2AMLogic/sg13g2-opamp/README.md

# sg13g2-opamp

A two-stage Miller-compensated operational amplifier on IHP SG13G2 on
[IHP SG13G2](https://github.com/IHP-GmbH/IHP-Open-PDK), IHP's open-source 130 nm SiGe BiCMOS PDK — designed by AI agents driving
[klayout-tools](https://github.com/2AMLogic/klayout-tools) and the
open-source xschem + ngspice flow.

**Status: implementation and structural verification in progress.** The
gm/ID sizing basis, schematic, simulation benches, routed layout, DRC, LVS,
and structural power-delivery evidence are committed. The machine-graded
signoff record currently marks 7 of 11 T1 items met; remaining gaps stay
tracked in the signoff manifest and issue backlog.

**Built agent-native.** Every specification, decision record, testbench, and
line of documentation here is produced by AI agents working from a ratified
spec and an append-only evidence trail — not human-authored work that agents
merely assisted with. Verification is the product: every claim traces to a
recorded result under PVT corners. Where the agents hit friction with the
open-source tooling — most often
[klayout-tools](https://github.com/2AMLogic/klayout-tools) — that friction is
filed as a public issue against the tool itself, so the fix benefits everyone
using this PDK, not just this repo.

## Why this block, on this PDK

An operational amplifier is the most conspicuous absence in an analog IP
catalog that already ships bandgaps, LDOs, PLLs, and ADCs — every one of
which embeds amplifiers it never characterizes standalone. This repo, with
its gf180 and sky130 twins opened the same day, closes that gap with the
same block on three foundries: a two-stage Miller OTA specified and
verified the same way everywhere, so the cross-PDK comparison is itself a
result.

On SG13G2 the CMOS devices (not the HBTs) are the design vehicle — this is
deliberately the plain-CMOS twin of the gf180/sky130 repos, so the
three-way comparison stays honest. An HBT-input variant is a stretch row
that only a decision record can open.

## Target specification (RATIFIED — partial, via the two-key mechanism)

See [`spec/target-spec.md`](spec/target-spec.md) for the full ratified
table: DC gain, GBW and phase margin into a stated capacitive load, slew
rate, input-referred noise, offset sigma (basis stated), CMRR, PSRR,
swing, supply/power at 1.2 V. Rows filled only from committed benches,
PVT corners recorded; the measured rows are ratified by
[`spec/decision-records/0002-target-spec-ratification.md`](spec/decision-records/0002-target-spec-ratification.md)
(one bound per row, `[DR-2]` tags), with the residual rows —
`[TBD-12]` area, the offset row's Monte Carlo basis (#17) and the CMRR
row's mismatch term (#26) — explicitly still open. See also [`spec/porting-plan.md`](spec/porting-plan.md) for what
transfers from this PDK's own `sg13g2-bandgap` and `sg13g2-ldo` siblings, and
the [gap-to-T1 tracker](https://github.com/2AMLogic/sg13g2-opamp/issues/3)
for this block's current distance from a sim-validated design.

**Where this block sits on the evidence ladder is graded, not asserted**:
[`signoff/`](signoff/README.md) holds the `klt signoff --manifest` block
manifest and the committed per-item T1 verdict it produces — 7 of 11 items
`met` in the current record, with the remaining 4 `unmet` (item 8's
characterization report is cited but grades four ratified rows FAIL against
their literal bounds — a spec question routed to the keys in
[#101](https://github.com/2AMLogic/sg13g2-opamp/issues/101)). That
record — not this paragraph, and not a hand-maintained checkbox list — is
the verdict of record for the tracker above, and CI re-grades it so a claim
resting on an artifact that has since changed fails instead of rotting.

## Reproducing the results

Every number in the spec table comes from a committed bench under `sim/`;
each bench's README has a "Cold-start invocation" section and each run
appends a record under its `records/` directory. You need an SG13G2 PDK
install (release pinned in [`sim/pdk.json`](sim/pdk.json), fetchable with
klayout-tools' `scripts/fetch-ihp-sg13g2.sh`) and `ngspice` on `PATH`:

```bash
export PDK_ROOT=/path/to/ihp-open-pdk   # parent dir containing ihp-sg13g2/
export PDK=ihp-sg13g2
sim/tools/build-osdi.sh                 # one-time; idempotent
sim/open-loop-ac/run_pvt_sweep.sh       # gain, GBW, phase margin, Iq
```

The other benches are `sim/slew-rate/run_slew_sweep.sh`,
`sim/input-noise/run_noise_sweep.sh`, `sim/input-offset/run_offset_sweep.sh`
and `run_offset_mc.sh`, `sim/cmrr-psrr/run_cmrr_psrr_sweep.sh`,
`sim/cmrr-mismatch/run_cmrr_mismatch_mc.sh`,
`sim/input-cmr/run_cmr_sweep.sh`, `sim/output-swing/run_swing_sweep.sh` and
the sizing study `sim/gm-id-characterization/run_gmid_sweep.sh`; the
bench-to-spec-row map is
[`signoff/evidence/testbenches.txt`](signoff/evidence/testbenches.txt). The
committed netlist is regenerated from the schematic with the command in
[`design/README.md`](design/README.md). The layout, DRC, LVS and ERC steps
are described in [`layout/README.md`](layout/README.md), and the graded
verdict is re-derived with `bash signoff/regenerate.sh`
([`signoff/README.md`](signoff/README.md)).

The per-spec-row characterization report (every row's bound, worst case,
binding point, grid coverage and source record) is regenerated from the
committed records alone — no PDK, no ngspice — with
`python3 signoff/characterization/generate.py` (`--check` verifies the
committed record reproduces); see
[`signoff/characterization/README.md`](signoff/characterization/README.md).
That aggregates existing evidence; it does not re-run the benches above.

## License

Apache-2.0.
