2AMLogic/sg13g2-opamp/signoff/README.md

# T1 signoff — the graded verdict of record

This block's position on the klayout-tools **design-evidence ladder** is not
prose in this file. It is
[`block-manifest.json`](block-manifest.json) — what this block claims, and the
evidence envelope backing each claim — graded mechanically by `klt signoff
--manifest`, with the graded output committed under
[`reports/`](reports/) as append-only evidence.

Read the newest record in `reports/` for the current per-item verdict. Nothing
in this file restates it, on purpose: a hand-maintained checkbox list goes
stale the moment either the evidence or the checklist moves, and both move.
(The checklist itself grew an eleventh item — power delivery (structural) — on
2026-09-17, 2AMLogic/klayout-tools#2025, which invalidated every hand-read T1
claim in the fleet at a stroke. That is exactly the failure mode this
register replaces.)

```bash
bash signoff/regenerate.sh --dry-run      # render the report, write nothing
bash signoff/regenerate.sh                # mint a new record under reports/
python3 signoff/check_signoff.py          # offline: pins + record consistency
python3 signoff/check_inventories.py      # offline: item 1/9/10 inventory entries
python3 signoff/check_signoff.py --run-klt  # + re-grade and diff vs the record
```

`klt signoff --manifest` exits **3** when the block is not yet T1 and **0**
only at full T1 — both mean the report rendered. Exit 1/2 mean no report was
produced. The scripts above encode that distinction; a caller of `klt` that
treats 3 as failure cannot run on a block that is not already finished.

`regenerate.sh` publishes atomically: the JSON pass is written to a hidden
`reports/.staging.*` file (never matching `*.signoff.json`), validated, and
hard-linked into place only if klt exited 0/3 and the document parses. A failed
or malformed run, or a concurrent run with the same record id, never leaves a
partial verdict that `check_signoff.py` would pick as the latest report.
Offline tests: run by CI's signoff test discovery (see "Offline test discovery"); alone: `python3 -m unittest discover -s signoff -p 'test_regenerate.py'`.

- **Checklist** (the item skeleton, parsed at run time):
  `klayout-tools/docs/design-evidence-tiers.md`
- **Grader contract** (manifest shape, reasons, what is and is not graded):
  `klayout-tools/docs/cli/signoff.md`
- **klt revision this repo grades against**: pinned in
  [`klt-pin.txt`](klt-pin.txt) — floating `main` would make the committed
  record disagree with a re-run for reasons unrelated to this block's evidence.

**How `check_signoff.py --run-klt` picks its `klt`.** By default it always runs
the pinned revision via `uvx --from git+https://github.com/2AMLogic/klayout-tools@<pin> klt`,
**even if a global `klt` is on `PATH`** (a different revision would grade a
different checklist). If `uvx` (or the pin) is unavailable it refuses with a
setup message; it never falls back to an unverified global `klt`. The first run
may need network access to populate the uv cache. `KLT_SIGNOFF_CMD` (space
separated command) overrides this for controlled environments; whoever sets it
owns revision correctness. CI sets `KLT_SIGNOFF_CMD=klt` because the preceding
step installs the pinned revision with pip. Selection is covered offline by
`KltCommandTest` in `test_check_signoff.py`.

## Block kind: `analog`

Confirmed against the block, not assumed: this repository is the plain-CMOS
twin of its gf180/sky130 counterparts (per `CLAUDE.md`, CMOS only unless a
decision record opens the HBT stretch — none has), `design/opamp_core.sch`
holds a hand-captured two-stage Miller op-amp schematic, the netlist under
`design/netlist/` is regenerated from that schematic rather than synthesized,
and there is no RTL, no gate-level netlist and no partition boundary to
declare — so this is a single-kind `analog` manifest, graded against the
Analog column of the per-kind items (1, 2, 5, 7 and 11), not a
`mixed-signal` one.

Consequence worth stating: for an analog partition, **item 7 accepts a `klt
pex` report and nothing else**, and item 5 accepts `klt sim` and nothing else.
A clean DRC, or any pre-layout corner sweep — however thorough — renders
`wrong_kind`, not `met`.

## What the manifest cites, and what it deliberately does not

**The manifest cites nine items: 1, 9 and 10 (the inventories below),
5 (the `klt sim` envelopes, with declared gaps; see "Item 5 envelope
coverage" below),
8 (the characterization report, below) and 2 (Layout), 3 (DRC clean),
4 (LVS clean) and 11 (Power delivery, structural).** The layout items are about the same
committed stream, `layout/opamp_core/opamp_core.gds`, and every one of them
pins that stream's own sha256 — because a `drc`, `lvs` or `erc` envelope all
record the sha256 of the layout they ran on in `provenance.input`:

| Item | Envelope cited | Produced by |
|---|---|---|
| 2, 3 | `layout/opamp_core/drc_report.json` | `klt drc --deck sg13g2` |
| 4 | `layout/opamp_core/lvs_report.json` | `layout/opamp_core/run_lvs.sh` |
| 11 | **both** `layout/opamp_core/erc_report.json` *and* the same LVS report | `layout/opamp_core/run_erc.sh` (+ the LVS run above) |

Items 5, 6 and 7 still render `unmet` with reason `no_evidence`, which
remains the honest graded result rather than a placeholder. For item 7 a
45-corner `pex_report.json` now exists but is deliberately **not cited**: its
two legs are not electrically comparable (see "Item 7" below). Item 8 is cited
but renders `unmet` with reason `check_failed`. Its envelope truthfully
carries `status: "fail"`, because the characterization report it wraps grades
three ratified rows FAIL (see below and
[#101](https://github.com/2AMLogic/sg13g2-opamp/issues/101)).

**Why a `drc` envelope is a legitimate citation for item 2, and not
borrowed-green.** Item 2 has no `klt` verb of its own, so the grader scores it
on "some passing envelope was cited at all", never on topical relevance — a
passing envelope for anything would render `met` and the tool would have no
basis to object. That is exactly why the citation has to earn its place by
argument, here:

- The envelope's `provenance.input.content_hash` **is** the committed GDS's
  own sha256. The envelope does not merely pass; it names the artifact item 2
  is about, by content.
- `pinned-inputs.json` maps that pin to `layout/opamp_core/opamp_core.gds`
  and `check_signoff.py` re-hashes the file offline, so the chain "the record
  says `met`" → "because this envelope passed" → "on exactly the stream
  committed in this repo" is closed on both ends and fails CI if either end
  moves.
- The half item 2 asks for that no envelope can carry — "reproducibly
  generated or with documented provenance" — **this block claims the
  documented-provenance alternative, and since #201 the "reproducibly
  generated" half is additionally CI-enforced.** The register's citation
  still rests on the documented-provenance chain — `layout/README.md`'s
  revision table (exact `klt` revision, curated-deck hash and PDK release
  the committed bytes were produced with) and its "Determinism" section —
  but the regeneration itself is no longer only a human-verified property:
  `.github/workflows/signoff.yml`'s `layout-regen` job provisions the
  pinned PDK (shared `setup-sg13g2-pdk` composite action with the
  netlist-regen job) and runs `python3 layout/opamp_core/generate.py
  --check` on every push and PR, installing `klt` at
  `layout/klt-pin.txt`'s tag commit in its own environment — deliberately
  not this register's grading pin, `signoff/klt-pin.txt`, which governs how
  the checklist is parsed, not how the evidence is produced — plus
  `klayout==0.30.10` under the job interpreter, the same two-environment
  split the committed bytes were made with. A byte drift, a DRC-report
  drift, a missing `klt` or a failed PDK fetch all fail the job; nothing is
  downgraded to a pass. The offline re-hash above and the regeneration gate
  are complementary: the first closes "someone hand-edited the stream", the
  second closes "the generator stopped reproducing it".
- The one assumption identified as most likely to break silently — that
  `klt gen mos_array`'s common-centroid unit ordering is what makes the
  block's `B A A B` interdigitation actually common-centroid, via
  `assert_common_centroid()` inside `generate.py` itself — is asserted at
  every regeneration and every `--check` run, so a `klt` behaviour change
  that broke it now fails the CI regeneration gate directly rather than
  only surfacing as an unexplained byte diff.
- The earlier deferral — "standing up a second CI job that installs `klt`
  **and** the pinned PDK was considered and deferred as materially higher
  cost", recorded in
  [#50](https://github.com/2AMLogic/sg13g2-opamp/issues/50) — was reversed
  by [#201](https://github.com/2AMLogic/sg13g2-opamp/issues/201): #190 had
  already added the pinned-PDK provisioning for the netlist-regen job, and
  factoring that fetch into the shared composite action removed the
  duplication cost.

**Item 3's coverage disclosure is in `layout/README.md`**, quoted verbatim
from the cited report's own `coverage` block: `deck_scope` (16 rule
families), `layers_in_stream_without_rules` (`31/0`, `36/0`, `63/0`, `129/0`,
`189/0` — the n-well and the MIM plate among them) and `rules_skipped` (6 of
43, all `no_applicable_geometry`). `klt signoff` reports those three fields
but does not grade them, so a `met` verdict on item 3 is **not** evidence the
gaps were disclosed; read the disclosure, not the verdict. And the deck
itself is klayout-tools' own curated 43-rule starter deck, **not IHP's
foundry signoff deck** — see `layout/README.md` → "Curated deck vs. IHP's
foundry deck".

**Items 1, 9 and 10 are cited through artifact-anchored `generic` envelopes**
(klayout-tools#2718, available from the pinned revision on). These items have
no `klt` verb, so the old advice was to leave them visibly `unmet` rather than
borrow a passing DRC report. The grader now accepts a `generic` envelope that
declares `"t1_item": <id>`, names the audited file in `provenance.input.path`,
records its `content_hash`, and is pinned by the manifest at the same hash;
`klt signoff` re-hashes that file, so an edit after the attestation renders the
row `unmet` / `stale_evidence`. The three audited files are plain-text
inventories under [`evidence/`](evidence/):

| Item | Envelope | Inventory it is bound to | What the inventory attests |
|---|---|---|---|
| 1 Design sources | [`design-sources.json`](evidence/design-sources.json) | [`design-sources.txt`](evidence/design-sources.txt) | the schematic, symbol, committed netlist and the `xschem` command that regenerates the netlist; the netlist was regenerated from the schematic against PDK v0.3.0 and matched the committed one byte for byte except the `** sch_path:` header comment |
| 9 Testbenches shipped | [`testbenches.json`](evidence/testbenches.json) | [`testbenches.txt`](evidence/testbenches.txt) | one line per ratified measurement row of `spec/target-spec.md` section 2: its `sim/` bench, cold-start command, committed record and the pinned PDK revision (`sim/pdk.json`) |
| 10 Repo hygiene | [`hygiene.json`](evidence/hygiene.json) | [`hygiene.txt`](evidence/hygiene.txt) | the README sections (what the block is, the spec table, how to reproduce), `LICENSE` and the CI workflow `.github/workflows/signoff.yml` |

**What that does and does not mean.** `status: "pass"` in each envelope is the
author's assertion, bound to bytes. It is not a re-audit by the tool: `klt
signoff` verifies that the inventory still has the hash the envelope named, not
that its contents are true. The audit behind the assertion is stated in each
inventory's header. In particular the item 9 audit was *static* (scripts,
templates, READMEs, committed records and the PDK/OSDI preflight were checked;
the PVT and Monte Carlo grids were not re-executed for the attestation), and
`Area` (`[TBD-12]`) is not a ratified row, claims no measurement and has no
bench. Refresh an envelope (and its manifest pin) whenever the inventory it
names changes; `check_signoff.py` fails offline if the pin and the file
disagree, and `--run-klt` fails with `stale_evidence` if only the inventory
moved.

**What CI re-checks in those inventories, and what stays a dated audit.**
A hash binds the inventory *text*; it does not notice a cited record being
deleted or a runner losing its executable bit while the text stands still.
[`check_inventories.py`](check_inventories.py) (offline, stdlib-only, run in
the offline half of the `signoff` job) reads the three inventories through a
documented parseable subset of their existing format — `key: value` lines in
`design-sources.txt` / `hygiene.txt`, `row | bench | command | record` lines
in `testbenches.txt`; the grammar is in the script's docstring — and on every
push and PR verifies:

| Continuously checked (CI) | Inventory |
|---|---|
| schematic, symbol, committed netlist, `xschemrc` and sizing basis exist; `netlist-origin` names the listed schematic; the `regenerate` command's `cd`/`--rcfile`/`-o`/schematic arguments resolve to the listed `xschemrc`, netlist directory and schematic, and the netlist file name is the schematic stem + `.spice`; `design/README.md` has the "Running xschem / regenerating the netlist" heading; `sim/pdk.json` exists | `design-sources.txt` |
| per row: bench dir exists; the cold-start runner lives in it, exists, has the executable mode, and parses with `bash -n`; every `${EXPERIMENT_DIR}/testbench/…` template it references exists; the bench README has a "Cold-start invocation" section that names the runner; the cited record exists under `<bench>/records/`, is non-empty and has its `.md` companion. Shared harness files exist (`.sh` ones parse); `sim/tools/build-osdi.sh` is executable; the stated PDK pin agrees with `sim/pdk.json`'s `source`/`release_tag` | `testbenches.txt` |
| `README.md` has the "Why this block, on this PDK", "Target specification", "Reproducing the results" and "License" headings; `spec/target-spec.md` has a section 2 heading; every bench README has "Cold-start invocation"; `design/README.md`, `signoff/README.md`, `LICENSE` (with its Apache License 2.0 header) and the workflow exist; the workflow triggers on push and pull_request and runs `check_signoff.py`, `check_signoff.py --run-klt` and this validator | `hygiene.txt` |
| in a git checkout: every path above is tracked, and every runner's *committed* mode is `100755` | all three |

Negative controls ([`test_check_inventories.py`](test_check_inventories.py),
also in the offline half) build a throwaway fixture tree from what the
inventories name — never touching the real checkout — and assert the exact
diagnostic for a deleted cited record, a runner without its executable bit
(working tree and committed mode), invalid shell syntax, a missing design
source, a missing hygiene artifact, a missing heading, template, shared
harness file or workflow step, and a PDK pin that disagrees.

**Still dated manual audits (2026-10-08), not machine-checked:** that the
committed netlist is what `xschem` generates from the schematic (the
regeneration diff needs xschem and the PDK; a path existing says nothing about
equivalence); byte freshness of any source, record or README (only
existence, headings and the cited command are checked — record *contents*
for item 8 are pinned separately by `characterization/selection.json`); that
any PVT/MC grid ran as recorded or would reproduce today; that the PDK v0.3.0
install and OSDI build resolve (`build-osdi.sh --check` needs the PDK); and
that README prose is accurate beyond carrying the named headings. Limits of
the parse itself: a template whose path is built some other way than
`${EXPERIMENT_DIR}/testbench/<name>` is not seen, and a `${var}` inside a
template name is matched as a glob (at least one file must match). Changing an
inventory's wording outside the documented subset fails this check rather
than being skipped; changing it at all still needs the envelope, the
`pinned-inputs.json`/manifest pin and a new signoff record refreshed together.

Item 2 is still cited through the native `drc` envelope, which the grader
accepts without being able to judge its relevance (`topic: not bound` in the
report); binding it with a `generic` envelope over the GDS is a possible
follow-up and is not done here.

**Item 7 (post-layout verification) is NOT cited. A 45-corner pex report
exists, but its two legs simulate different device geometry, so its deltas
are not a parasitic measurement.** Issue
[#86](https://github.com/2AMLogic/sg13g2-opamp/issues/86); reconciliation is
tracked in [#237](https://github.com/2AMLogic/sg13g2-opamp/issues/237).

*What was run.* `bash layout/opamp_core/run_pex.sh` ran `klt pex --deck sg13g2`
over the committed GDS, with `--measure-command
sim/post-layout/measure_openloop_ac.sh` on both legs (`measurement.mode:
"command"`) and reference `design/netlist/opamp_core.spice`. It wrote
`layout/opamp_core/pex_report.json` and `layout/opamp_core/opamp_core_pex.spice`.
Both are kept as committed evidence, but they are not in `block-manifest.json`
or `pinned-inputs.json`. The 45-point PVT grid (5 MOS corners x -40/27/125 C x
1.08/1.20/1.32 V, CL = 2 pF) was expressed as `klt sim` AC + OP requests that
declare `backend: "batch"`. No local ngspice loop was run. The report itself
does not record where the simulations ran: there is no `environment.remote` and
no batch job id in `pex_report.json`, and the per-corner `klt sim` envelopes
were written to a scratch directory that was not kept. So the only evidence
for the batch fleet is the request declaration. The report has 180 `delta[]`
rows (45 corners x 4 rows), `status: "pass"` on every row, `corner_count: 45`
and `errored: 0`.

*Why the passes are not cited.* The four AC/OP rows pass the ratified bounds
on the extracted leg
(`python3 sim/post-layout/check_bounds.py layout/opamp_core/pex_report.json`,
exit 0). The worst extracted values are gain 42.19 dB (bound 37.8), GBW
5.956 MHz (bound 4.74), PM 75.19 deg (bound 60) and Iq 84.84 uA (bound 119.7).
The deltas against the schematic leg are large and favourable: `delta_pct`
spans -3.6..+18.7 % (gain), +8.6..+27.8 % (GBW), -1.9..-0.8 % (PM) and
-31.7..-19.8 % (Iq). The two legs differ in how the devices are represented,
so these deltas cannot be attributed to parasitics:

- **The active device widths match the schematic exactly.** The extracted
  netlist has 19 NMOS / 18 PMOS against the schematic's 5 / 3
  (`model_mismatch.counts`). This is the intended drawn layout: each matched
  pair is an interdigitated array of half-width units plus two dummy columns,
  and each wide device is folded (`generate.PAIRS` / `generate.FOLDED`). LVS
  matches 38/38 against the per-finger reference that `lvs_reference.py`
  derives. Summing every extracted W gives an apparent 1.5x input pair, a 1.5x
  mirror load and an extra 2.2 um NMOS. All of that excess is **dummy**
  devices (gate, drain, source and body tied to the same rail), which carry no
  current. Per active device: M1/M2 = 2 x 1.6 um (schematic 3.2 um), M3/M4 =
  2 x 0.52 um (1.04 um), M5/Mbias = 2 x 1.1 um (2.2 um), M7 = 7 x 1.7 um
  (11.9 um), M6 = 12 x 2.75 um (33 um).
- **The per-device geometry does not match.** The schematic leg simulates one
  lumped `ng=1` device of full width per transistor (e.g. a single 11.9 um M7).
  The extracted leg simulates the drawn narrow instances, each with its own
  AS/AD/PS/PD. In the PSP model these are different devices: narrow-width
  effects and diffusion geometry differ, and the bias-mirror ratios are now set
  by fingers of *different* unit widths (Mbias 2 x 1.1 um vs M7 7 x 1.7 um).
  This was the leading explanation for the DC deltas, and the #237 probe has
  now quantified it (`sim/fingering-probe/`, five MOS corners at
  27 C / 1.20 V on the batch fleet). Lumped -> drawn fingering carries the
  whole Iq delta (-24.9..-26.7 %) and +7.6..+9.0 % gain. The dummies and the
  extracted diffusion geometry move nothing (under 0.4 %).
- **The remaining AC deltas are a bench artifact, not parasitics.** The
  open-loop AC bench leaves `inn` AC-floating (`Lbreak` with no C to ground),
  so any capacitance on `inn` changes Av0/GBW. With `inn` AC-grounded, the
  parasitics move GBW -0.4 %, PM -0.8 % and Av0 0.00 %. The same diagnostic
  shows the bench roughly halves GBW and overstates PM by 12-14 deg. That
  defect is tracked in [#241](https://github.com/2AMLogic/sg13g2-opamp/issues/241).
  [Decision record 0008](../spec/decision-records/0008-drawn-fingering-device-representation.md)
  chooses to put the drawn fingering into the schematic, and orders the
  remaining work: fix the bench, change the netlist together with the
  pre-layout re-runs, then re-run pex.

So the absolute pass describes a circuit whose devices are represented
differently from the circuit sized and characterized pre-layout (items 5 and
8). Its margin cannot be read as parasitic robustness, and part of it may be
the representation change. For the same reason, the schematic leg's worst
corner (37.78 dB, 0.02 dB under the gain bound) and the extracted leg clearing
the bound are not a before/after comparison. Item 7 stays `unmet /
no_evidence` until #237 makes the legs comparable (DR 0008), #241 fixes the
bench loop break, and the run is repeated.

*Report fields, stated as the envelope carries them (informational; uncited).*
`body_bias.status: "biased"` (0 unbiased devices, no unbiased nets, no unbiased
PMOS bodies). `extraction.model` is a **quasi-static lumped RC** model: one
frequency-independent R and C per net, resistance a single lumped series
resistance per net distributed as a star across the net's device terminals
(not a per-segment RC ladder; `--distributed-rc` / `--critical-net` were not
used), capacitance net-to-ground from each net's own area/perimeter plus
net-to-net for vertical-overlap (crossover) coupling. Lateral same-layer
coupling is modelled only for declared `--critical-net` nets, and none were
declared, so **no lateral coupling is in this result**; fringe shielding,
skin effect and distributed transmission-line behaviour are not modelled.
The extraction deck is `sg13g2` with `deck.released: false` (the curated
starter deck, not the foundry deck). The source/drain implant layers are not
drawn by `klt gen mos_array` (klayout-tools#2580, see `layout/README.md`);
whether that changes the extracted device list or junction capacitance was
not investigated here (LVS matches 38 of 38 devices). Neither the starter-deck
nor the implant caveat has been quantified.

*Rows covered vs not covered post-layout.* Measured by the uncited run: DC gain, GBW, phase margin
and quiescent current (the four AC/OP rows above) at the 45-point grid. **Not
covered post-layout:** slew rate, input-referred noise, offset (including its
statistical basis), CMRR, PSRR and output swing. A future item 7 `met` says nothing
about those rows either. Tracker:
[#3](https://github.com/2AMLogic/sg13g2-opamp/issues/3).

**Item 11 is the one compound citation, and what it does and does not
prove.** T1 item 11 (power delivery, structural — klayout-tools#2025) is the
first item no single artifact proves, so its manifest entry is a *list*: the
`klt erc` supply run plus the LVS report item 4 already cites. The supply
spec that run grades against is
[`layout/opamp_core/erc_supply_spec.json`](../layout/opamp_core/erc_supply_spec.json),
which carries an inline justification for every `stackup` entry, every
`label_layer` and both `ties[]` entries; the run is
[`layout/opamp_core/run_erc.sh`](../layout/opamp_core/run_erc.sh). What the
graded verdict rests on, stated here rather than left in the envelope:

- **Two supplies, `vdd` and `vss`** — this block's entire supply set — each
  declared `"kind": "supply"` with `islands: 1`, each resolving to exactly
  one labelled island, with zero `erc.unconnected_net`, zero
  `erc.supply_short` and zero `erc.missing_tie` (`erc_status: "clean"`,
  `erc_finding_count: 0`).
- **Both supplies are paired to a reference-side net** in the cited LVS
  report's `net_correspondence` (`vdd` → `VDD`, `vss` → `VSS`, both
  `pin: true`), which is the analog branch of the item — the block cites no
  `place-and-route` response, so `power_connectivity: "unchecked"` is the
  right and sufficient state here, exactly as it is for item 4.
- **Ties are declared, not disclosed away.** klayout-tools#2169 — where a
  declared `ties[]` entry collapsed a routed design into one island and
  reported a *false* `erc.supply_short` — is fixed in the `klt` that produced
  the committed report (`provenance.klt_version`), so the honest move is to
  declare the ties and let them be computed, not to file a
  `ties_disclosure` that item 11 would (correctly) render `unmet`. Both ties
  are graded as `checked` work, neither is `skipped`.
- **The n-well tie is derived from drawn geometry; the substrate tie is a
  caller assertion.** SG13G2 draws no p-substrate layer, so `psub_tie_vss`
  uses `well_layer: null` + `well_boxes` (klayout-tools#2255) naming the
  three NMOS guard-ring extents one at a time. The report says so itself in
  `erc_coverage.checked_by_well_assertion`. That is weaker provenance than
  the drawn `NWell` the `vdd` tie uses, and it is stated rather than buried.
- **What a clean `erc.unconnected_net` here is *not* evidence of.** The rule
  counts islands *carrying the declared label* (klayout-tools#2497), and this
  stream draws exactly one label per port — so it cannot, even in principle,
  report a severed-but-unlabelled rail fragment. `nets[].matched_islands: 1`
  in the report is that bound made visible. The independent evidence that no
  fragment is orphaned is the cited LVS compare (9/9 nets, 38/38 devices,
  `status: "match"`) and the generator's own connectivity self-check — not
  this rule.
- **The antenna half of the same envelope checked nothing.** `klt` ships an
  antenna-ratio limit table for sky130 only, so every one of the 49
  gate×level antenna work items is in `coverage.skipped` with reason
  `missing_antenna_pdk` and the envelope's own `status` is `not_checked`.
  Item 11 deliberately does not grade that field (it grades the supply rules
  directly), and antenna is tracked separately as klayout-tools#1994 — but a
  reader should not mistake the `met` row for an antenna verdict.

The layout generator also runs a connectivity **self-check** — it re-extracts
the drawn metal and asserts the nine nets are wired as
`design/netlist/opamp_core.spice` says, with no open, no short and nothing
floating — but that is not LVS (no device recognition, extraction stops at
Metal1) and is deliberately **not** cited as item 4 or item 11.

**Item 5 is cited as a multi-row list of committed `klt sim` envelopes with
declared gaps (issue #266, klayout-tools#2959); item 6 is still uncited.**
Item 5 renders `unmet` / `check_failed`, not `no_evidence`: see "Item 5
envelope coverage, per ratified row" below. Item 6 accepts only a `klt
yield` envelope and this repo's Monte Carlo records are harness-native
artifacts, so until an envelope-producing bench lands or a wrapper is
introduced upstream, it correctly renders `no_evidence`.

Item 6: the Monte Carlo campaigns now exist (offset random half, issue #17,
`sim/input-offset/records/mc-20260921-174056-0a509fb*`; mismatch-inclusive
CMRR, issue #26, `sim/cmrr-mismatch/records/20260921-172304-65f5fb4.csv`),
but no `klt yield` report is cited, for three recorded reasons: the spec
ratifies no per-draw limit or `target_yield` for either row (#108), the CMRR
record holds per-point summaries only, not per-draw samples (#107), and the
offset draws need a reshape into a sample-set document
([`yield-inputs/`](yield-inputs/README.md)). Item 6 stays `unmet`
until those close.

**Item 8 is cited through a `generic` envelope over a generated
characterization report** — [`characterization/`](characterization/README.md).
`characterization/generate.py` reads an explicit, hash-pinned record selection
(`characterization/selection.json`: the same records
[`evidence/testbenches.txt`](evidence/testbenches.txt) maps, checked against
it) and renders, for every claimed spec row, units, load and conditions, the
ratified bound and its decision record, the measured worst case and binding
point, the source record and its sha256, expected-versus-observed grid
coverage and a verdict. Minted records under `characterization/reports/` are
append-only; [`evidence/characterization.json`](evidence/characterization.json)
(`"kind": "generic"`, `"t1_item": 8`) binds the newest JSON record by repo path
and hash, and the manifest and `pinned-inputs.json` pin that same hash.
Regenerating it needs no ngspice, no PDK and no network:

```bash
python3 signoff/characterization/generate.py          # render; writes nothing
python3 signoff/characterization/generate.py --check  # cited record reproduces
```

That re-reads committed evidence; it is **not** a re-run of the simulations
(each bench README's "Cold-start invocation" is). What the item 8 row does and
does not mean:

- The generator writes the envelope's `status`. It writes `"pass"` only when
  the report's overall verdict is `PASS`: every ratified bound met, full valid
  grid coverage on every selected record, no input in error. Otherwise it
  writes `"fail"`, and klt then grades item 8 `unmet` (`check_failed`).
  `check_signoff.py` re-derives the cited record from its selected evidence
  (`generate.py --check`). A record that moved, or an envelope that no longer
  matches the newest report and its verdict, fails offline.
- **Bounds are compared literally, and the current report is FAIL.** Every raw
  grid value must meet the ratified bound as written. No rounding or
  precision convention is applied, because no ratification record defines
  one. Four rows miss the literal bound: DC gain, integrated noise,
  systematic offset and swing span, by 0.0188 dB, 0.049 µVrms, 0.027 mV and
  0.042 mV respectively. Their raw worst cases come from the very records
  DR-0002 cites, and only round onto the bounds it wrote. Whether to restate
  those bounds or ratify a comparison convention is a spec decision for the
  keys ([#101](https://github.com/2AMLogic/sg13g2-opamp/issues/101)), not
  something this tooling settles. Until then item 8 stays `unmet`.
- The first minted record, `characterization/reports/20261009-005750-622fb9c`,
  and the verdict of record graded from it, `reports/20261009-005834-69b7b63`
  (8/11, item 8 `met`), used a rounding rule that has since been withdrawn.
  Both are kept unedited as append-only history, but they are superseded and
  must not be read as the current verdict.
- Unratified measured quantities (offset mismatch 3σ `[P]`, ICMR) are
  reported in their own section with no pass/fail, the superseded systematic
  CMRR floor is context only, and Area stays `PENDING`. The offset Monte
  Carlo campaign's fixed 1.20 V supply is carried with its numbers.
- **It is item 8 evidence only.** It is an offline aggregation of
  harness-native records, not a `klt sim` / `klt yield` envelope, and is not
  cited for item 5 or 6 — `check_signoff.py` fails if the manifest cites it
  under any other item. Every number in it is pre-layout.

### Item 5 envelope coverage, per ratified row

Item 5 asks for "every spec row at its bound corners". The manifest cites
the committed envelopes as a list, each naming the rows it covers, against
`spec_rows."5"`, the ratified rows of `signoff/characterization/selection.json`
(`class: ratified`). Rows no envelope measures are declared `gap`, which keeps
the item `unmet` / `partial_coverage` and is never read as covered. Today the
item renders `unmet` / `check_failed`: two cited envelopes are recorded bound
misses (`failed_rows` = `input_noise`, `offset_systematic`; not relaxed), and
`detail.declared_gaps` lists exactly five rows: `psrr` (#99), `swing_headroom_vdd`,
`swing_headroom_vss`, `swing_span` (#100) and `cmrr_mismatch` (statistical
reduction, item-6 form #105). The `cmrr-psrr` supply-gain envelope measures
`avs0_db` only, covers no row and is not cited. When #99 or #100 land they
only replace a `gap` with a citation. Not declared: `cmrr_systematic`
(superseded by DR-4), `offset_mc_3sigma`, `offset_mc_total`, `icmr_*`
(measured, unratified) and `area` (pending). Per row, today:

| Ratified row | Bench | `klt sim` request | Envelope committed | Tracker |
|---|---|---|---|---|
| Open-loop DC gain ≥ 37.8 dB | `sim/open-loop-ac/` | yes, `sim/open-loop-ac/klt/` (AC request; `inn` AC-grounded, issue #241) | **yes**: real 45-corner envelope committed (`sim/open-loop-ac/klt/records/20261016-161057-8caa272.ac.sim.json`, fleet job `klt-sim-61cc8b42b2da`: 45 unique points, status pass; binding corner `mos_fs`/125 °C/1.08 V, 38.229 dB vs ≥ 37.8) | [#85](https://github.com/2AMLogic/sg13g2-opamp/issues/85) |
| GBW ≥ 4.74 MHz | `sim/open-loop-ac/` | yes (same AC request) | **yes**: same envelope; binding corner `mos_ss`/−40 °C/1.08 V, 8.062 MHz | #85 |
| Phase margin ≥ 60° | `sim/open-loop-ac/` | yes (same AC request; graded as the phase at the 0 dB crossing) | **yes**: same envelope; binding corner `mos_ff`/125 °C/1.32 V, PM 61.99° | #85 |
| Quiescent current ≤ 119.7 µA | `sim/open-loop-ac/` | yes (companion OP request) | **yes**: `sim/open-loop-ac/klt/records/20261016-161057-8caa272.op.sim.json` (fleet job `klt-sim-eb4fefe4b5a5`: 45 unique points, status pass); binding corner `mos_ss`/−40 °C/1.32 V, 119.655 µA | #85 |
| Slew rate ≥ 7.51 V/µs (worse of the two edges) | `sim/slew-rate/` | yes, `sim/slew-rate/klt/` (one measurement per edge, each carrying the bound) | **yes**: real 45-corner envelope committed (`sim/slew-rate/klt/records/20261015-063443-80878d7.sim.json`: 45 unique points, status pass; binding corner `mos_ss`/−40 °C/1.08 V, rising 7.5378, falling 7.5144 V/µs vs ≥ 7.51); agrees with the harness record at all 45 points | [#95](https://github.com/2AMLogic/sg13g2-opamp/issues/95) |
| Input-referred noise ≤ 108.9 µVrms | `sim/input-noise/` | yes, `sim/input-noise/klt/` | **yes**: `sim/input-noise/klt/records/20261015-061719-80878d7.sim.json` (45 corners, fleet job `klt-sim-97d94b85943b`; verdict **fail**: `mos_fs`/125 °C/1.08 V = 108.949 µVrms, same as the harness; compared to the harness record, 0 of 270 comparisons out of tolerance) | [#96](https://github.com/2AMLogic/sg13g2-opamp/issues/96) |
| Offset (systematic) ≤ +21.9 mV | `sim/input-offset/` | yes, `sim/input-offset/klt/` (the harness's primary open-loop null-sweep method; `vos_null_v` carries the bound as a two-sided limit ±0.0219 V) | **yes**: `sim/input-offset/klt/records/20261015-081722-8e276bc.sim.json` (45 unique points, fleet job `klt-sim-38b6e4833c62`; verdict **fail**: one point misses, `mos_fs`/125 °C/1.08 V = +21.927 mV vs ≤ 21.9 mV, margin −0.027 mV, the same point and value as the harness; the other 44 pass); agrees with the harness record at all 45 points (largest offset delta 0.58 nV) | [#97](https://github.com/2AMLogic/sg13g2-opamp/issues/97) |
| CMRR ≥ 26.68 dB (mismatch-inclusive [DR-4]) | `sim/cmrr-mismatch/` | no | no | [#98](https://github.com/2AMLogic/sg13g2-opamp/issues/98) |
| PSRR ≥ 1.87 dB (DC shelf) | `sim/cmrr-psrr/` | yes, `sim/cmrr-psrr/klt/` (supply-gain request, shard bridge, runner and comparator; `inn` AC-grounded, issue #241). PSRR+ = Av0 − Avs0 is a two-envelope join on (process, temperature, VDD): Avs0 from the supply-gain envelope, Av0 from the open-loop `klt sim` AC envelope; the ratified bound is applied offline because one AC solve cannot carry both excitations, so the PSRR verdict is the comparator's, not a `klt sim` verdict | **yes**: grounded-`inn` supply-gain envelope `sim/cmrr-psrr/klt/records/20261015-103521-0f41068.sim.json` (45 unique points, fleet job `klt-sim-ebfce5fa6940`) joined to `sim/open-loop-ac/klt/records/20261016-161057-8caa272.ac.sim.json` (`av0_db`); join record `klt/records/20261016-171154-ff5ee9a.compare.json`. PSRR+ worst 26.90 dB at `mos_fs`/125 °C/1.08 V, 0 of 45 failing the bound. The envelope-joined PSRR differs from the open-loop-CSV-joined PSRR by at most 4.95e-5 dB (tolerance 0.02 dB, 45 of 45 within). It supersedes the floating-`inn` record `20261010-094256-469573d` (worst 1.8709 dB) | [#99](https://github.com/2AMLogic/sg13g2-opamp/issues/99) |
| Output swing (headroom ≥ 251/141 mV, span ≥ 0.571 V) | `sim/output-swing/` | partial, `sim/output-swing/klt/` (one-point `mos_tt`/27 °C/1.20 V prototype request, runner and comparator delivered; all three ratified numbers are native `klt sim` measurements with the literal bounds; the 45-point grid request is not yet written) | **no**: one-point prototype only (`klt/records/*.nominal.sim.json`), not evidence; 45-point run deferred | [#100](https://github.com/2AMLogic/sg13g2-opamp/issues/100) |

Eight of ten rows have a complete `klt sim` request (the seven cited rows plus PSRR, whose join is not yet cited), and one more (output swing) has a partial one (a one-point prototype request, no grid request yet): request coverage is not delivered evidence. **The open-loop AC bench (four rows: DC gain, GBW, phase margin, Iq), slew-rate (job `klt-sim-9649fa050398`), input-noise and input-offset (systematic) rows have complete committed envelopes; PSRR is covered by a two-envelope join (below); CMRR and output swing are not covered. Seven rows are cited in item 5 (two of them with recorded bound misses); PSRR, swing and CMRR are declared gaps.** The open-loop request was first submitted to the batch fleet on 2026-10-09 and rejected before simulating, because the fleet runner's klt (0.5.0) was older than the client (`batch_runner_version_mismatch`, exit 87; 2AMLogic/2am#2193, since closed with the runner pinned to 0.7.0). It was re-run on 2026-10-16 (client 0.7.1.dev, runner 0.7.0, ngspice-46 on the fleet) through `sim/open-loop-ac/klt/run.sh`: all four rows pass at all 45 corners, on the grounded-`inn` bench, and the envelopes are compared with the grounded-`inn` record `sim/open-loop-ac/records/20261015-103057-895d555.csv` (the floating-`inn` record `20260910-221601-22feaba` is superseded: its Av0 worst case of 37.7812 dB, a miss, was a property of that bench's floating `inn`, not of the amplifier; the shift to 38.2293 dB is attributed in `sim/open-loop-ac/README.md`). The slew-rate request was rejected the same way on 2026-10-09 (job `klt-sim-994a710c60f3`), then ran on 2026-10-15 once the runner matched; `sim/slew-rate/README.md` → "The `klt sim` path" has the history, including the fleet thread-oversubscription timeout and its `set num_threads=1` workaround (2AMLogic/klayout-tools#2970). The PSRR request (`sim/cmrr-psrr/klt/`, #99) measures the supply gain only, so the row is a two-envelope join, not a single `klt sim` ratio: the same-point Av0 comes from the committed open-loop `klt sim` AC envelope (`av0_db`), and the ratified bound is applied offline by `compare.py`. The grounded-`inn` supply-gain envelope `20261015-103521-0f41068` (worst 26.90 dB, 0 of 45 failing) supersedes the floating-`inn` `20261010-094256-469573d`; the join check against the open-loop CSV passes (`20261016-171154-ff5ee9a.compare.json`). Unlike the two above, the original (floating-`inn`) run did run on the fleet: the one-request form cannot run on the klt 0.5.0 runner, so the 45-point grid ran as five per-process shard jobs (`sim/cmrr-psrr/klt/shard.py`, client klt 0.6.0) and the merged envelope (45 unique points, 44 pass, one plateau-guard limit miss kept) is committed with its comparison against the harness record (`sim/cmrr-psrr/README.md` → "Measured comparison"). The input-noise request ran on the fleet in one 45-point job (client and runner klt 0.7.0) and its envelope is committed with its harness comparison (`sim/input-noise/README.md` → "Comparison tolerance (measured)"); the verdict is a recorded bound miss at one corner, not a pass, and the earlier one-corner local prototype never counted toward coverage. The input-offset (systematic) request also ran on the fleet in one 45-point job (client and runner klt 0.7.0) and its envelope is committed with its harness comparison (`sim/input-offset/README.md` → "The `klt sim` path"); its verdict is likewise a recorded bound miss at one corner (+21.927 mV against the ratified +21.9 mV), not relaxed. That run was submitted with `klt sim` directly, not through `run.sh`, because this dispatch host's preflight cannot pass (ngspice-42, no OSDI build), so that record has no `.env.json` sidecar. These envelopes are cited by the manifest as item 5 (pin `3a75c3a` → `44cc423`, which carries klayout-tools#2959).

## Disclosures that travel with the current claim

- **Item 3's DRC coverage gaps are disclosed in `layout/README.md`** →
  "What the DRC verdict is worth", quoted verbatim from the cited report's
  own `coverage` block. This was the honesty note this register was opened
  with ("when item 3 first goes `met`, its coverage gaps must be stated in
  the claim — a `met` verdict alone is not evidence that coverage was
  disclosed"), and it is now discharged.
- **Item 2's provenance is disclosed in the same file** → "Determinism":
  which `klt` revision produced the bytes, what would legitimately change
  them, and the fact that changing them fails this register's own offline
  check until the pins are refreshed.
- **The source/drain implants are not drawn.** `klt gen mos_array` emits no
  `nSD`/`pSD` on this family, the curated deck has no implant rule, and
  neither the DRC verdict nor the signoff record can see it. Stated in
  `layout/README.md` and filed upstream as
  [`2AMLogic/klayout-tools#2580`](https://github.com/2AMLogic/klayout-tools/issues/2580).
  Nothing in this register should be read as a claim that the committed
  stream is a manufacturable mask set.
- **Item 11's three caveats are in "What the manifest cites" above** — the
  asserted (rather than drawn) substrate region behind the `vss` tie, the
  single-label bound on `erc.unconnected_net`, and the fact that the same
  envelope's antenna half checked nothing on this PDK. This discharges the
  honesty note the item was opened with: a `met` power-delivery row is a
  statement about the declared supplies' continuity in *metal*, not a
  statement that every rail fragment was found or that antenna was graded.

One honesty note still pending, from the issue that introduced this register:

- When item 7 first goes `met`, its `body_bias` statement must be read and
  restated: an unexamined `body_bias` field is no statement that "every
  device body was biased"; here, today, the question has not been asked with
  the tool that answers it.
  When the report lands, also restate its `extraction.model` (a lumped
  quasi-static R/C per net: no skin effect or distributed lines, lateral
  coupling only for `--critical-net` nets), say whether the undrawn
  source/drain implants (klayout-tools#2580) affect extraction, and list the
  ratified rows covered post-layout (the four AC rows: DC gain, GBW, phase
  margin, quiescent current) against those not (slew rate, noise, offset,
  CMRR, PSRR, output swing). The DRC deck is the curated starter deck, not
  the foundry deck.

## How this is kept from rotting

`klt signoff` compares a manifest pin against the *cited envelope's own*
recorded input hash. It never opens the repo artifact that hash is supposed
to be the hash **of** — so a pin can go stale in a way the grader structurally
cannot see. [`pinned-inputs.json`](pinned-inputs.json) names the artifact
behind every pin and [`check_signoff.py`](check_signoff.py) re-hashes it,
which closes that gap. Every layout pin — including both parts of item 11's
compound citation, whose `pinned-inputs.json` entry is a list with one
artifact per part — resolves to `layout/opamp_core/opamp_core.gds`, so
regenerating the layout without also refreshing the DRC, LVS and ERC reports,
every pin and the graded record fails the offline half of CI — by design.
Item 8's pin resolves to the minted characterization record, and the same
offline half re-derives that record from the `sim/` evidence it selects. The
checker also enforces the converse: it gathers a row for every new pin, and
rejects a `pinned-inputs.json` entry for an item the manifest does not cite.

The ERC *supply spec* is a second document the `klt erc` envelope merely
names (`spec`) and hashes into `provenance.spec.content_hash`. The checker
resolves the item-11 part of kind `erc`, requires a repo-contained readable
spec and a well-formed recorded hash, and re-hashes the spec; a missing or
malformed hash, an escaping path or a changed `erc_supply_spec.json` fails the
offline build with a pointer to re-run `layout/opamp_core/run_erc.sh` and
`signoff/regenerate.sh`.

CI runs both halves
([`.github/workflows/signoff.yml`](../.github/workflows/signoff.yml)), on
every push and every PR:

| Check | Where | Needs |
|---|---|---|
| Manifest shape, pins vs. committed artifacts, record consistency, item 8 report reproduces | offline half of the `signoff` job, via `check_signoff.py` | python3 only |
| Item 1/9/10 inventory entries still hold (paths, runner modes, `bash -n`, records, doc headings) | offline half of the `signoff` job, via `check_inventories.py` | python3 + bash (+ git for the tracked/mode checks) |
| All offline `signoff/` tests (inventory, checker, integrator-contract and regenerate fixtures; characterization; yield-input converter) | offline half of the `signoff` job, automatic per-directory discovery (see below) | python3 + bash + git |
| Re-grade with the pinned `klt` and diff against the committed record | online half of the `signoff` job, via `check_signoff.py --run-klt` | network (installs `klt` at `klt-pin.txt`'s revision) |

So a manifest citing an artifact that has since changed, a record that no
longer matches what `klt` would say today, and a mis-keyed evidence entry
that `klt` would silently ignore all fail a build instead of rotting
quietly.

### Offline test discovery

CI does not hand-list `signoff/` tests. One step, before `klt` is installed,
finds every directory under `signoff/` holding a `test_*.py` and runs
`python3 -m unittest discover -s <dir> -p 'test_*.py' -v` once per directory
(today: `signoff/`, `signoff/characterization/`, `signoff/yield-inputs/`).
Directories are discovered separately because `yield-inputs/` is not an
importable package. A new module in an existing directory, or in a new nested
directory, is picked up with no workflow edit. The step fails on any failing
test, on a failed enumeration, and when no directory is found. The standalone
validators (`check_signoff.py`, `check_inventories.py`,
`sync_integrator.py --check`, `check_integrator_contract.py`,
`offset_draws_to_sampleset.py --check`) remain separate steps.

Local equivalent (stdlib + bash, no klt/PDK/simulator), from the repo root:

```bash
bash sim/tools/run-offline-tests.sh signoff
```

The same runner serves the `sim/` step (`bash sim/tools/run-offline-tests.sh sim`)
and `pnpm test`.

## LVS reference freshness

Items 4 and 11 (LVS part) cite `layout/opamp_core/lvs_report.json`, and the
manifest pin binds that citation to the GDS only. The chain that keeps the
recorded match from outliving its reference is:

1. `design/netlist/opamp_core.spice` (schematic) is cross-checked against the
   layout device tables, and the expanded reference
   `layout/opamp_core/opamp_core.lvs_reference.spice` is derived from them:
   `python3 layout/opamp_core/lvs_reference.py --check` (CI, after the klt
   install supplies `klayout`) fails on any schematic/table inconsistency or
   on a committed reference that differs from the regenerated text.
2. `signoff/check_signoff.py` hashes the reference named by
   `layout/opamp_core/lvs_request.json` and compares it to
   `environment.reference_sha256` in every cited `kind: lvs` envelope (item 4
   and the LVS part of compound item 11, in any list order). A missing or
   malformed hash, a missing reference, a differing reference name or a hash
   disagreement fails.

Refresh after a schematic/table change: run `lvs_reference.py` (regenerates),
re-run `klt lvs` (`layout/opamp_core/run_lvs.sh`), then
`signoff/regenerate.sh`. Historical records under `signoff/reports/` and
`sim/` are never edited to clear a failure; a new record is added.

## Fleet roll-up

`block` is required in this manifest (klt itself calls it optional) because it
is how this block's row is identified in the fleet roll-up,
[2AMLogic/2am#956](https://github.com/2AMLogic/2am/issues/956), which
consumes this exact file via `klt signoff --fleet`.
