2AMLogic/sg13g2-opamp/sim/output-swing/README.md

# output-swing — DC output-swing PVT bench

`sim/output-swing/` measures the DC output swing of
`design/opamp_core.sch` (`design/netlist/opamp_core.spice`) — the
maximum/minimum DC output voltage the amplifier can reach into
`CL = 2 pF` [DR-1] **while still tracking its input** — across the full
cornerMOSlv.lib process x temperature x supply grid
(`mos_tt/ss/ff/sf/fs` x `{-40, 27, 125} °C` x `{1.08, 1.20, 1.32} V` =
45 points), the same grid every other `sim/` bench in this repo runs.
This is the bench behind `spec/target-spec.md`'s output-swing row
(`[TBD-10]` until this experiment existed), and the last of the
"classic rows" that name a single testbench measurement.

## What this bench measures

**Output swing, operationally**: from the open-loop differential DC
transfer curve `Vout(Vid)` — `Vid = V(inp) − V(inn)`, input common mode
pinned at `Vcm = VDD/2` — the linear region's rail-ward **bounds**:
beyond them the amplifier's incremental gain has collapsed and the
output no longer tracks the input. Both bounds are reported **as headroom
from the rail** (VDD − Vout_max, Vout_min − VSS), not as absolute volts,
per the row's own requirement, so the same record compares directly
across the `{1.08, 1.20, 1.32} V` supply grid.

Physically, the two bounds are set by this topology's output stage
(`design/opamp_sizing.md` "Stage 2"): `M6` (PMOS output gain device,
`source = vdd`, `drain = out`) bounds the **high** rail — as `Vout`
rises toward VDD, `M6`'s `Vsd` collapses toward its saturation/triode
edge and its incremental gain falls; `M7` (NMOS output current sink,
`drain = out`, `source = vss`) bounds the **low** rail the same way as
`Vout` approaches VSS. The bench deliberately drives the **input**
into its safe common-mode range throughout (below), so both measured
bounds reflect the output stage, not the input pair.

## Method

### Open-loop transfer curve, not a closed-loop buffer sweep

`testbench/tb_swing.spice.tmpl` uses
`sim/input-offset/tb_offset_null.spice.tmpl`'s differential-drive
convention: one common-mode source plus two B-sources,

```
V(inp) = Vcm + Vid/2      V(inn) = Vcm - Vid/2
```

so the input common mode stays **exactly** at `Vcm = VDD/2` for every
swept `Vid`. The resulting `Vout(Vid)` is a monotonic saturating S-curve:
hard-railed low for `Vid` far below the linear region, hard-railed high
for `Vid` far above, a steep high-gain linear region in between (whose
center — the single `Vout = Vcm` crossing — is exactly
`sim/input-offset/`'s offset number for the same grid point).

The alternative a closed-loop unity-gain buffer sweep (wire `out` to
`inn`, ramp the input rail-to-rail, watch where the output stops
following) was rejected for a structural reason: in a buffer the output
**is** the input common mode, and this design's input pair has its own
common-mode range problems (its tail node needs `Vgs(M1) + Vov(M5)` of
headroom below the lowest usable input level) that bind at *least* as
early as the output stage does on the low rail. A buffer therefore
measures where the **input stage** leaves its range, understating the
output stage's true swing. Pinning the input common mode at `Vcm` —
where the input pair provably amplifies at every grid point
(`sim/input-offset/` and `sim/open-loop-ac/` both recorded sane
operation there) — makes the measured bounds output-stage properties,
which is what the spec row means by "output swing".

No feedback is used (unlike `sim/open-loop-ac/`'s `Lbreak` DC servo):
the DC operating point of the standalone open-loop amplifier is
ill-posed only in the sense that its output rails away from the linear
region — precisely what a transfer-curve swing bench wants to see. Each
`.dc` point solves directly; `CL` is attached for DUT-environment parity
with the rest of the tree but has no effect on a DC analysis.

### The swing criterion (the number's definition)

"Still tracking the input" needs a threshold, and the threshold is part
of the number. This bench reads both bounds at the **−6 dB
incremental-gain boundary**: the outermost sweep points around the
peak-gain point whose two-point incremental gain
`dVout/dVid` is still ≥ **½ of the curve's own peak** incremental gain.
The `Vout` values at those boundary samples are `vout_max_track_v` /
`vout_min_track_v`; everything beyond them has the amplifier perceiving
less than half its nominal gain.

Why −6 dB, concretely: it is the classic half-gain compression point of
a DC transfer curve — far enough inside the rails that the number means
"an amplifier, not an emitter follower" (the −3 dB-in-power analogue of
small-signal specs), while not a knife-edge criterion like
"gain has dropped by 1%" that would sit at the exact saturation edge
where model noise and step size dominate. The criterion fraction is a
knob (`CRITERION_FRAC` in `run_swing_sweep.sh`, documented as 0.5 here)
so a reviewer can re-run at a stricter/looser criterion and mint a new
record under the append-only convention — but **the committed record's
numbers are the 0.5 (−6 dB) criterion's numbers**, and
`spec/target-spec.md`'s row states the criterion where it cites them.
A swing figure quoted without its criterion is as incomplete as the
noise row would be without its band.

### Two passes (coarse locate, then fine read)

Per grid point, `run_swing_sweep.sh` renders the one template twice:

1. **Coarse** — `Vid` swept `± 100 mV` at `500 µV` steps (401 points,
   the same window `sim/input-offset/` uses to prove the crossing
   unique), recording `v(out)` only. Locates the linear region's center
   and reads both **hard-clipped plateau levels** (`vout_clip_high_v` /
   `vout_clip_low_v`) — the raw reach, deliberately kept distinct in the
   record from the tracking bounds.
2. **Fine** — `Vid` swept `± 25 mV` around the coarse crossing at
   `10 µV` steps (5001 points), recording `v(out)` and `i(vdd)`. The
   linear region spans well under 12 mV of `Vid` everywhere on this grid
   (measured `Av0` is 77.6–181 V/V per `sim/open-loop-ac/`), so ±25 mV
   brackets both −6 dB boundaries with >4x margin; the 10 µV step keeps
   each boundary read to ~1–2 mV of output volts at the worst gain.

### One shared estimator (`swing_post.py`)

Both passes' post-processing lives in [`swing_post.py`](swing_post.py) —
pure, stdlib-only, and the single definition of every curve-derived
number. `run_swing_sweep.sh` calls its CLI per point (`swing_post.py
coarse <csv> <vcm>`, then `swing_post.py fine ...`); nothing in the
runner embeds its own copy of the math any more, so the bench and the
offline characterization audit (issue #230, which pins each point's
coarse/fine curves and rendered netlists into
`signoff/characterization/selection.json`) cannot diverge. The module
also *strictly* parses the wrdata files — exact column count, finite
values, strictly increasing sweep scale, and agreement of the duplicate
scale columns a multi-vector `wrdata` writes — and parses each rendered
netlist's actual measurement inputs (supply, `Vcm = VDD/2`, corner
section, sweep window, recorded vectors, wrdata target). The pinned
configuration (coarse window, fine half-span/step, the 0.5 criterion) is
`CONFIG` in that module; the audit refuses any other.

### Bias and load conventions

Identical to `sim/open-loop-ac/`'s and `sim/input-offset/`'s, so all
benches bias the same DUT the same way: external ideal
`ibias = 10 µA` sunk into the DUT's `Mbias` node, per
`design/opamp_sizing.md` "Bias scope". `CL = 2 pF` [DR-1] attached at
`out` (DC analysis: no effect on the result, DUT-environment parity
only). **No resistive load** — see "What this bench does not claim".

## Per-point sanity checks

A grid point's row enters the record with `op_pass = 1` only if every
rule below holds (failures are still recorded, flagged `op_pass = 0`,
and named in the record's `sanity_checks.txt`; the grid must stay
complete either way — a missing point is a hole in the evidence, not a
"bad point"):

1. **Unique crossing** — exactly one `Vout = Vcm` crossing in the coarse
   sweep (the same uniqueness rule as `sim/input-offset/`'s coarse pass).
2. **Real clipping, judged by slope ratio** — the coarse curve's own
   peak segment gain is computed, and both window ends must sit on parts
   of the curve whose incremental slope is ≤ 1% of that peak. An
   *absolute* millivolt-flatness rule was tried first and is **wrong at
   hot corners**: at 125 °C the "railed" output still creeps
   ~0.3 mV per mV of `Vid` (leakage-fed), which is ~10⁻⁶ of the peak
   gain — clearly clipped — but breaches any absolute mV threshold.
3. **Crossing strictly inside the fine window** — an edge crossing would
   mean the coarse locate was wrong by more than the fine half-span and
   the fine read is not trustworthy.
4. **Monotonic fine curve** — `Vout` never decreases (beyond 1e-9 V of
   fp wiggle); a non-monotonic transfer curve would make "the linear
   region" ambiguous.
5. **Plausible peak gain** — the fine curve's peak incremental gain is
   ≥ 10 V/V (same floor as `sim/input-offset/`'s local-gain rule).
6. **−6 dB region strictly inside the fine window** — an edge-touching
   region would mean the window truncated the boundary and the reported
   bound is an artifact of the window, not the amplifier.
7. **Physical bounds** — both headrooms strictly positive and strictly
   inside the supply span; the tracking bounds strictly inside the
   hard-clip plateau levels (the −6 dB point lies before the plateau by
   construction); the plateaus straddle mid-rail.

## Cross-checks (logged, not gated)

Every grid point joins the already-merged sibling records on `point_id`,
and the record carries the comparison columns:

- `vos_crossing_v` vs `sim/input-offset/`'s `vos_null_v` — the same
  DUT, grid, drive configuration and crossing definition, measured by an
  independent bench: they agree to **≤ 0.65 nV** across all 45 points
  (both are interpolations of the same deterministic DC solution, so
  this is a strong convergence check, not an independent-physics one).
- `peak_inc_gain_v_v` vs `sim/open-loop-ac/`'s `av0_db` (`av0_ratio`):
  **1.017–1.255** across the grid — the incremental DC gain sits within
  ~2–26% of the AC bench's 1 Hz gain at the same point, the expected
  small bias-point/analysis difference.
- `ivdd_center_a` vs `sim/open-loop-ac/`'s `ivdd_total_a` (`ivdd_ratio`):
  **1.0041–1.0098** — the mid-swing supply current matches the AC
  bench's operating-point current to under 1%.

A large disagreement in these columns would not be filtered out
automatically (they are diagnostics, not gates) — it would show up when
the record is read, with the per-point data to trace it.

## Cold-start invocation

```bash
export PDK_ROOT=/path/to/ihp-open-pdk   # parent dir containing ihp-sg13g2/
export PDK=ihp-sg13g2
sim/tools/build-osdi.sh                 # one-time: build the OSDI models
sim/output-swing/run_swing_sweep.sh
```

`PDK_ROOT`/`PDK` may also be left unset if the PDK is installed under one
of the usual prefixes `sim/env.sh` checks. Requires ngspice on PATH plus
the OSDI models `sim/tools/build-osdi.sh` builds; does not require xschem
or `klt` at run time (`design/netlist/opamp_core.spice` is committed,
pre-netlisted — see `design/README.md`). The pinned PDK revision every
record targets is `sim/pdk.json`.

Writes append-only evidence under `corners/<record-id>/` (per-point
ngspice logs + coarse/fine transfer-curve CSVs + `sanity_checks.txt`),
`netlist-snapshots/<record-id>/` (the exact DUT netlist copy and both
rendered testbenches) and `records/<record-id>.{csv,md}`. A re-run mints
a new timestamped record; nothing under `records/`, `corners/` or
`netlist-snapshots/` is ever edited or deleted after it lands.

## What was actually measured (this repo's committed record)

Committed record: `records/20260921-151759-707b34c.{csv,md}` — 45 of 45
points simulated, 45/45 passing the per-point sanity checks, ngspice-46
against PDK tag `v0.3.0` (`sim/pdk.json`). All numbers below are from
that record, at the −6 dB incremental-gain criterion.

**By supply rail** (worst/best over the 15 process x temperature points
at each supply):

| Supply | headroom from VDD | headroom from VSS | tracking span |
|---|---|---|---|
| 1.08 V | 251.5 – 307.8 mV | 141.2 – 206.8 mV | 571.0 – 687.3 mV |
| 1.20 V | 260.0 – 310.6 mV | 145.8 – 215.0 mV | 674.4 – 793.9 mV |
| 1.32 V | 268.6 – 319.1 mV | 151.1 – 223.1 mV | 777.9 – 900.1 mV |

**Extremes across the grid**:

- Worst span: **571.0 mV** (`Vout` 0.206–0.777 V) at `mos_ss / 125 °C /
  1.08 V`. The four next-worst spans are all also `125 °C / 1.08 V`
  points (`fs`, `tt`, `sf`, `ff` in order — 572.1–578.3 mV), so at the
  binding supply the hot end dominates the process axis for span.
- Worst high-rail headroom: **251.5 mV** at `mos_fs / −40 °C / 1.08 V`.
- Worst low-rail headroom: **141.2 mV** at `mos_ff / −40 °C / 1.08 V`.
- Best span: **900.1 mV** at `mos_ff / −40 °C / 1.32 V`.

The hard-clipped reach is much wider than the tracking bounds (e.g. at
the nominal `mos_tt / 27 °C / 1.20 V`: reach 4.3 µV – 1.116 V vs.
tracking 0.173 – 0.919 V) — the amplifier's output can be *pushed*
rail-ward, but it stops *amplifying* hundreds of millivolts before the
plateaus; both are recorded, and the spec row quotes the tracking
bounds, not the reach.

### Measured vs. predicted binding corner (honest comparison)

`spec/target-spec.md`'s prediction for this row was "low VDD / worst
output-stage headroom corner". Measured: **confirmed on the supply axis
and corrected on the process/temperature axis**. Every worst figure —
worst span, worst per-rail headroom — lands at 1.08 V, the low end of
the supply grid, exactly as predicted. But no single process x
temperature point binds both rails **and** the span: the worst span
sits at `mos_ss / 125 °C` (hot), while the worst *high-rail* headroom
(`fs / −40 °C`) and worst *low-rail* headroom (`ff / −40 °C`) sit at
cold split corners — the per-rail worsts and the span worst are three
different points. The pre-schematic prediction named only the supply
axis, so it was right as far as it went; a finer prediction would also
have had to commit to an axis (span vs. per-rail headroom) that this
measurement now shows to be mixed.

## What this bench does not claim

- **Unloaded swing.** No resistive load is attached at `out` (only
  `CL = 2 pF` [DR-1], which a DC analysis ignores). A loaded swing
  bench (voltage swing into a stated `RL`) would need the output stage
  to *source/sink* current at the rails, and its numbers would be
  strictly smaller. Loaded swing is a separate bench with its own row
  decision, not covered by this record.
- **DC only.** This is the DC transfer curve's tracking bounds. Whether
  the amplifier can *settle at* those bounds through large-signal
  motion that first slews (the `sim/slew-rate/` bench's regime) is a
  different question this record does not address.
- **Ideal bias.** The 10 µA `ibias` reference is an external ideal
  source per `design/opamp_sizing.md` "Bias scope", like every other
  bench in this tree — a real bias generator adds its own variation
  outside this record's evidence.
- **Deterministic corners only.** Every device is nominal (no mismatch
  deck, no Monte Carlo; same caveat as `sim/input-offset/`). Random
  device mismatch shifts the output stage's current balance and can
  move these bounds; no statistical basis is claimed here.
- **No per-device operating-point claims.** This OSDI/PSP103 build
  exposes no queryable per-device op-point parameters
  (`sim/gm-id-characterization/README.md` "Why finite-difference DC/AC,
  not model op-point queries") — the M6/M7 saturation narrative above is
  design context from `design/opamp_sizing.md`, corroborated by the
  measured per-rail asymmetry, not a per-device measurement.
- **The criterion is a choice.** The −6 dB boundary is stated, defended
  and re-runnable, but it *is* the number's definition — see "The
  swing criterion"; quoting these figures without it is not a testable
  claim.

## The `klt sim` path (issue #100): prototype and 45-point envelope

T1 item 5 ("full corner verification vs a ratified spec") accepts only a `klt
sim` envelope (`signoff/README.md`, "Item 5 envelope coverage, per ratified
row"). [`klt/`](klt/) is the **startable first slice** of expressing this bench
that way: a one-point capability probe plus the offline comparator and its
negative controls. It is **not** the 45-point envelope, it is not accepted
evidence, and `signoff/block-manifest.json` is unchanged.

| File | Role |
|---|---|
| [`klt/tb_swing.body.spice`](klt/tb_swing.body.spice) | The test circuit of `testbench/tb_swing.spice.tmpl` as a `klt sim` circuit body (flat DUT include, `Vid` about `Vcm`, 10 µA `ibias`, `CL = 2 pF`, no resistive load, no feedback; exactly one `.include`). |
| [`klt/swing.nominal.request.json`](klt/swing.nominal.request.json) | The request: `mos_tt` + `cornerCAP.lib cap_typ` / 27 °C / 1.20 V only (`vcm` swept with `vdd`), `dc Vid -0.01 0.04 10u`, local backend, OSDI preload, default solver tolerance (DR-0005). |
| [`klt/run.sh`](klt/run.sh) | Runs the request (always `--backend local`), gates the envelope, writes it unmodified to `klt/records/<UTC>-<sha>.nominal.sim.json`, then the comparison `...nominal.compare.json`. |
| [`klt/compare.py`](klt/compare.py), [`klt/test_compare.py`](klt/test_compare.py) | The validation gate and harness comparison (stdlib, offline) and its 44 focused tests. |

### Prototype result: the criterion is expressible natively

The three ratified numbers are three independent measurements in the tool's
own `expr` path (`headroom_hi_v`, `headroom_lo_v`, `swing_span_v`), each
carrying the literal bound as `limits` (0.251 V, 0.141 V, 0.571 V) and graded by
`klt sim`. The sampled definition of "The swing criterion" is reproduced
exactly: segment gain between adjacent samples, peak = first maximum, the
contiguous run of segments around the peak with gain ≥ 0.5 × peak, bounds =
extreme `Vout` over that run's endpoint samples. ngspice vector algebra does it
with no loop (`request._comment` spells out the index arithmetic): slices for
the segment gains, `lt`/`gt` masks for the qualifying and non-qualifying
segments, `vecmax`/`vecmin` over index vectors for the run's ends, and each
stage reduced to a scalar that the next `expr` names. Four more tool-graded
checks reproduce the harness's sanity rules (run clear of both window edges,
monotonic curve, peak gain ≥ 10 V/V). No external calculation touches the
verdicts.

Recorded run, `klt/records/20261010-115354-aa54447.nominal.{sim,compare}.json`:

- Tools: `klt 0.7.0+gf03eb675fa81` (`~/.local/bin/klt`), `ngspice-46` (OSDI preflight `sim/tools/build-osdi.sh --check`: all four models loadable).
- Command: `sim/output-swing/klt/run.sh`, i.e. `klt sim swing.nominal.request.json --backend local --format json` (exit 0, status `pass`, `coverage.nothing_checked` false, nothing skipped).
- Inputs: request sha256 and PDK version are in the compare record's `provenance`; the envelope's `environment` carries the netlist closure and model hashes.

| Quantity | Harness record | `klt sim` | Delta | Allowed |
|---|---|---|---|---|
| headroom from VDD | 0.281186 V | 0.281471 V | +0.285 mV | 1.69 mV |
| headroom from VSS | 0.173082 V | 0.172792 V | −0.290 mV | 1.58 mV |
| tracking span | 0.745732 V | 0.745737 V | +0.005 mV | 3.56 mV |

All three rows PASS their literal bounds in both paths at this point (it is
not the binding corner; the harness's literal span miss is at `mos_ss / 125 °C
/ 1.08 V`, and nothing here changes it).

### Comparison tolerance (not a limit)

`compare.py` keeps the literal ratified bounds (`RATIFIED_LIMITS`) apart from the
comparison tolerance. The tolerance only says whether the two measurement paths
agree; it never moves a pass/fail. Its basis, per point and per boundary:

- **Estimator offset.** Both paths use the same sampled definition at the same 10 µV step, but the harness centres its ±25 mV fine window on the coarse crossing and the request sweeps a fixed window, so the sample grids are offset by a fraction of a step. A boundary sample can land one step away, and `Vout` moves by at most (peak incremental gain × step) over one step: `10 µV × peak_inc_gain_v_v` (harness column) per boundary, twice that for the span.
- **Cross-host numerics.** DR-0005 measured 9.9e-4 relative drain-current difference between the host that produced the harness record and Linux/x86_64 default-tolerance runs; 1e-3 relative plus 1 µV is allowed on every value.

The allowance is analytic, not fitted; the prototype's single observation is
about a sixth of it. The 45-point run must confirm it per point and explain any
exceedance rather than widen it.

### What the comparator rejects

`validate` (the gate before anything enters `records/`) and `compare` refuse:
missing, duplicate and unexpected points (the requested set is `--points grid`,
the 45 ratified points, or `--points nominal`); missing, null or non-finite
measurements; a wrong or absent unit; per-measurement or per-corner status
`error`/`inconclusive`/`not_checked`; a non-zero errored/inconclusive count;
`coverage.nothing_checked` not false; anything in `coverage.skipped`; `limits`
that differ from the literal bounds (a relaxed or absent bound is not evidence);
a verdict that contradicts its value against the literal bound; a failed
integrity check (the tracking bounds would be a window artifact); `Vcm ≠ VDD/2`;
and a malformed, duplicated or non-finite harness CSV. A complete envelope
whose ratified row **fails** its literal bound (e.g. span 0.570999 V) is valid
evidence and stays a FAIL even when the comparison tolerance passes; both are
tested.

Run the tests (offline, no simulator):
`python3 -m unittest discover -s sim/output-swing/klt -p 'test_*.py'`.

### The 45-point envelope (grid result)

`klt/run.sh grid` submits `klt/swing.request.json` (the nominal request with the
ratified grid: `mos_tt/ss/ff/sf/fs` + `cornerCAP.lib cap_typ` x -40/27/125 C x
VDD 1.08/1.20/1.32 V, `vcm` swept with `vdd`; same body, fixed `Vid` window,
measurements and limits) on the batch backend only. Committed, unmodified:

- `klt/records/20261101-010941-b7a1a86.sim.json`: fleet job `klt-sim-567c2d463d1a` (us-east-1, spot c7i.4xlarge, ngspice-46), client and runner klt 0.8.0 (`runner_compatibility: match`), repo sha `b7a1a86`. 45 unique points, 44 pass, **1 fail**, 0 errored/inconclusive, `coverage.nothing_checked` false, nothing skipped. The run took 1429 s; the slowest corner took 263 s of the 300 s per-corner `timeout_s`, which is thin headroom (see below).
- `klt/records/20261101-010941-b7a1a86.compare.json`: the per-point join against `records/20260921-151759-707b34c.csv`; status **agree**, 45 of 45 points, every metric within tolerance.
- `klt/records/20261101-010941-b7a1a86.env.json`: the run-time PDK/model identity sidecar. It describes the **client** PDK install (a private copy in which the OSDI models were built, because the dispatch host's shared PDK has no OSDI build manifest and its preflight refuses); the fleet's own PDK/ngspice identity is in the envelope's `environment`.

Result against the ratified bounds (literal, nothing relaxed):

| Row | Bound | Worst case (binding corner) | Failing points |
|---|---|---|---|
| headroom from VDD | >= 251 mV | 251.187 mV at `mos_fs` / -40 C / 1.08 V | 0 |
| headroom from VSS | >= 141 mV | 141.395 mV at `mos_ff` / -40 C / 1.08 V | 0 |
| tracking span | >= 0.571 V | 0.570960 V at `mos_ss` / 125 C / 1.08 V | **1** |

The span miss is a recorded FAIL, the same point and value as the harness
(0.570957773 V); it is not rounded or tolerance-waived (precision decision: #101).

Comparison tolerances, confirmed on the 45 points: the largest |delta| /
tolerance is 0.41 (`vmin_track_v` and `headroom_lo_v`, `mos_fs` / -40 C / 1.32 V,
delta -0.82 mV against 2.00 mV), 0.29 for `headroom_hi_v`, 0.22 for
`vmax_track_v`, 0.20 for `swing_span_v` (`mos_ff` / -40 C / 1.32 V, +0.98 mV
against 4.76 mV). No point is out of tolerance and no verdict disagrees with
the harness, so there is nothing to explain individually; the analytic
allowance stands unwidened. The estimator edge guards hold at every point:
`lo_idx` is 1859..2714 (guard >= 1) and `hi_idx` is 2342..3544 (guard <= 4998),
so the fixed window never truncated a tracking region; `gpk_vv` is 79.7..223.3
V/V and `mono_min_dv_v` is positive everywhere.

Run history: the first client was killed by the dispatch host's tool timeout while waiting
(`batch_client_interrupted`); the fleet has no cancel and the job completed, so the envelope was
collected with `SWING_KLT_ATTACH=klt-sim-567c2d463d1a ... run.sh grid` (`--attach`) rather than by
submitting a second grid.

Client warning worth keeping: klt's conservative serial bound (13620 s) exceeds the
fleet's 3600 s whole-job ceiling and suggests `request.remote.hosts >= 5`; the job
finished in 1429 s on one host. A slower host could push the 263 s corner past
`timeout_s` 300 s; if so, shard with `remote.hosts` or raise the timeout, do not drop points.

### Not done here

- The manifest does not cite item 5 for these rows (`signoff/block-manifest.json` is unchanged): that waits until all ten ratified rows have envelopes (CMRR, statistical, remains a gap).
- **Fixed sweep window.** The request cannot centre its fine window on a measured crossing (`analysis.args` is literal); the committed envelope shows the -10..+40 mV window never touched an edge guard. Tracked upstream: 2AMLogic/klayout-tools#3055 (since closed; the expression style was not changed). `<`/`>` are I/O redirection in `expr`, hence `lt`/`gt` (2AMLogic/klayout-tools#2940).
- **Estimator checks on synthetic curves** (absent crossing, weak peak, disconnected qualifying regions, window-edge truncation) through ngspice remain optional hardening; the comparator tests cover the validity side.
