2AMLogic/sg13g2-opamp/sim/input-noise/README.md

# input-noise

Input-referred voltage-noise characterization of `design/opamp_core.sch`'s
two-stage Miller-compensated op-amp (issue #13), across the full PVT grid,
into `CL = 2 pF` [DR-1]. This bench exists to close
`spec/target-spec.md`'s input-referred-noise row, which was `[TBD-6]`
("band not yet chosen") — so **choosing the band/metric convention is part
of this experiment**, not a prerequisite it inherited. See "Choosing the
band" below for that choice and its basis.

## What this bench measures

For every point on the `cornerMOSlv.lib` `mos_tt/ss/ff/sf/fs` [DR-1] x
temperature `{-40, 27, 125} °C` x supply `{1.08, 1.20, 1.32} V` grid
(45 points):

- **`vni_int_vrms`** — input-referred noise **integrated over
  100 Hz – 1 MHz**, in RMS volts. This is the headline figure the spec row
  cites.
- **Spot densities** (`vni_100hz_v_rthz` … `vni_1mhz_v_rthz`) — input-referred
  noise density in V/√Hz at **100 Hz, 1 kHz, 10 kHz, 100 kHz and 1 MHz**
  (the band edges plus the three decades between them).
- **Flicker/thermal split** — a weighted least-squares fit of the in-band
  power spectrum to `S(f) = A/f + B`, reported as the flicker coefficient
  (`flicker_coeff_v2`, V²), the thermal floor (`thermal_floor_v_rthz`,
  `√B` in V/√Hz), the **flicker corner** (`flicker_corner_hz`, `A/B`) and
  the flicker term's share of the in-band mean-square noise
  (`flicker_frac_of_msq`).
- **Closed-loop gain guard** (`clgain_100hz`, `clgain_1mhz`) — the
  configuration's own measured gain at both band edges, so a point whose
  bandwidth had collapsed could not silently report an inflated
  input-referred density (see "Per-point sanity checks").
- **DC operating point** (`vout_dc_v`, `vd1_dc_v`, `vd2_dc_v`,
  `vtail_dc_v`, `vibias_dc_v`) and `ivdd_total_a`, on the same convention
  `sim/open-loop-ac/` records them.
- **`vni_int_crosscheck_ratio`** — an independent trapezoidal integral of
  the written spectrum divided by ngspice's own `inoise_total`, so the
  headline number is never taken on trust from a single simulator vector.

## Choosing the band

`spec/target-spec.md` carried no noise band at all before this experiment,
so the band is chosen here, explicitly:

> **Input-referred noise is specified as an integrated figure over
> 100 Hz – 1 MHz (µVrms), plus spot densities in nV/√Hz at 100 Hz, 1 kHz,
> 10 kHz, 100 kHz and 1 MHz.**

Basis, in order of precedence:

1. **The three-foundry twin's own proposed band.**
   [`sky130-opamp/spec/target-spec.md`](https://github.com/2AMLogic/sky130-opamp/blob/main/spec/target-spec.md)'s
   input-referred-noise row proposes exactly `100 Hz – 1 MHz` (with a
   `≈ 30 nV/√Hz` thermal-floor estimate) for the *same* two-stage
   Miller-compensated topology under the same `CLAUDE.md` classic-row
   framing. Per this repo's "three-foundry twin" rule (keep the benches
   structurally identical, derive the numbers from THIS PDK), matching
   that band is what makes the sg13g2 and sky130 rows comparable. That
   row is `[P]` (proposed), not ratified — it is a sibling *precedent*,
   not an inherited ratification, and is cited as such.
2. **The fleet's ratified metric *shape*.** `gf180-bandgap`'s ratified
   amendment A6 specifies its noise row as *"band: 0.1–10 Hz integrated
   µVrms … add a spot-noise point if a later wave feeds an ADC"* —
   i.e. **an integrated figure over an explicitly stated band, plus spot
   densities**. That two-part shape (not that bandgap-specific
   drift-band, which is wrong for a general-purpose amplifier) is what is
   carried here; `gf180-bandgap/sim/output-noise/` is also the fleet's
   nearest ngspice `.noise` implementation precedent.
3. **This PDK's own measured numbers make the bounds defensible:**
   - **Upper bound 1 MHz** is set by the measured worst-case unity-gain
     bandwidth of this very design — `4.74 MHz` at `mos_fs_125C_1.08V`
     (`sim/open-loop-ac/records/20260910-221601-22feaba.csv`). Input
     referral divides by the configuration's gain, so it stops being
     meaningful once the gain rolls off; `1 MHz` sits ~4.7x below the
     worst-case GBW, and the per-point guard below confirms the closed-loop
     gain is still `0.96–0.99` at 1 MHz at **every** one of the 45 points.
     The reference-only wide sweep shows exactly what a careless upper
     bound would have bought: input-referred density bottoms out near
     `30–40 nV/√Hz` at `10 MHz` and then **rises** to
     `118–143 nV/√Hz` at `100 MHz` — the gain-rolloff artifact, not
     amplifier noise.
   - **Lower bound 100 Hz** is stated because the measured spectrum is
     `1/f`-dominated (see below), and a `1/f` integral diverges
     logarithmically: the lower bound *is* part of the number, so leaving
     it implicit would make the row unfalsifiable. `100 Hz` keeps three
     full decades of the flicker region inside the band (the integral is
     `93–94%` flicker-dominated at every corner) without letting an
     arbitrarily low bound dominate the figure.

**Anyone re-deriving this row must state the band with the number.** A
`µVrms` figure without both bounds is not a claim about this amplifier.

## Method

### Why closed loop (and not `sim/open-loop-ac/`'s `Lbreak` trick)

`testbench/tb_noise.spice.tmpl` wires the DUT as a **unity-gain voltage
follower**: `Vfb` (a 0 V, noiseless, ideal source used as a wire and
current probe) ties `inn` to `out`, and the AC test source drives `inp`.
Real feedback then sets the DC operating point — no ideal-inductor trick
is needed — and the noise gain from the amplifier's own input to the
output is `1` across the whole band, so ngspice's `inoise_spectrum`
(output noise divided by the measured `Vinp → out` transfer function) *is*
the input-referred noise density directly.

The issue's scope allowed either this or `sim/open-loop-ac/`'s
`Lbreak = 1e18 H` open-loop DC-bias configuration. **The open-loop
configuration was prototyped first and rejected on evidence**: with
`Lbreak` in place, the same `.noise` analysis on the same DUT at
`mos_tt / 27 °C / 1.20 V` returns an input-referred spectrum falling
`~10x per decade in amplitude` between 10 Hz and 100 kHz
(`0.58 mV/√Hz @ 10 Hz`, `98 µV/√Hz @ 100 Hz`, `10 µV/√Hz @ 1 kHz`),
i.e. `S_v ∝ 1/f²` with a low-frequency plateau below ~10 Hz — a shape
neither `1/f` flicker nor thermal noise produces. Two independent checks
say that shape is an artifact of the huge inductor in the noise solve, not
device physics:

- A **single-device probe** of this same PDK's `sg13_lv_nmos`
  (`W = 3.2 µm`, `L = 0.13 µm`, resistively loaded, no inductor) returns a
  textbook `1/f` power slope — `3.16x per decade in amplitude`
  (`4.79e-5 → 1.52e-5 → 4.79e-6 …` V/√Hz per decade from 0.1 Hz) — over
  a thermal floor that matches `√(4kTγg_m)` with the same probe's measured
  `g_m = 406 µS` to within ~3%.
- The **closed-loop configuration below** reproduces that same textbook
  shape on the full amplifier (`27.9 µV/√Hz @ 1 Hz → 2.79 µV/√Hz @ 100 Hz
  → 881 nV/√Hz @ 1 kHz`, exactly `3.16x` per decade) and its thermal
  asymptote agrees with an independent hand estimate of the same order
  (`≈ 30 nV/√Hz`, cf. the twin's estimate for the same topology).

Both prototyping observations are about *testbench construction*, not
about the DUT, so — following the precedent
`sim/open-loop-ac/README.md` set with its "Choosing `Lbreak`" section —
they are documented here rather than minted as their own committed
record.

### Units check (`testbench/tb_noise_units_check.spice`)

Every number in this experiment's records depends on two ngspice
conventions that are easy to get backwards, and that a sibling repo's
testbench comment documents *differently* than what ngspice-46 actually
does here:

1. `inoise_spectrum`/`onoise_spectrum` are densities in **V/√Hz**, not
   V²/Hz.
2. `inoise_total`/`onoise_total` are already-square-rooted **RMS volts**
   over the swept band, not mean-square V².

Rather than assume either, `run_noise_sweep.sh` runs a PDK-free reference
deck — a `1 kΩ` resistor's Johnson noise through an ideal, noiseless `x100`
VCVS — **before** simulating any DUT point, and asserts (0.5% tolerance)
that it reads `e_n = √(4kTR) = 4.0704 nV/√Hz`, that the output density is
exactly `100x` that, and that the 1 kHz–10 kHz integral is
`e_n·√(9000 Hz) = 386.1 nVrms`. All three passed for this record
(`corners/<record-id>/units_check.txt`). A future ngspice whose `noise`
output used the other convention fails the run loudly instead of silently
rescaling every recorded figure by a square root.

### Per-point sanity checks

`run_noise_sweep.sh` checks, for every point:

- The same DC rule `sim/open-loop-ac/` applies —
  `|Vout(dc) − Vcm| ≤ 0.15·VDD`, and `Vd1`, `Vd2`, `Vtail`, `Vout` each
  strictly between `0.02·VDD` and `0.98·VDD` — so a non-regulating point
  cannot read as a plausible noise figure.
- **A noise-gain guard specific to this bench**: the measured closed-loop
  gain must be within `0.9 … 1.1` at **both** band edges (100 Hz and
  1 MHz). This is what makes the band choice checkable per point rather
  than assumed from one nominal corner.

All 45 points passed both (measured closed-loop gain `0.961 – 0.992`
across the grid). The same honest-scope caveat as `sim/open-loop-ac/`
applies: this OSDI/PSP103 build exposes no queryable per-device
operating-point parameters, so these are *necessary, not sufficient*,
proxies for "every device is really in saturation".

**Not available in this build**: ngspice's per-device noise-contribution
summary (the optional `pts_per_summary` argument to `noise`) prints
nothing for these OSDI/Verilog-A devices, so this bench cannot attribute
the measured noise to individual transistors the way
`gf180-bandgap/sim/output-noise/nominal_noise_breakdown.py` does for a
built-in-model PDK. The flicker/thermal fit above is the decomposition
that *is* available here, and it is a spectral decomposition, not a
per-device one.

### Run-time PDK/model identity (`records/<record-id>.env.json`)

A record minted by `run_noise_sweep.sh` carries a run-time PDK/model
identity sidecar, `records/<record-id>.env.json` (issue #191's schema,
contract in [`../env-identity.sh`](../env-identity.sh); see
[`../README.md`](../README.md) "Run-time PDK/model identity" for the full
guarantee). Since issue #214 this bench runs the same begin/finalize
lifecycle `sim/open-loop-ac/run_pvt_sweep.sh` and the `klt sim` wrappers
run (issue #209):

- The identity — the hashed model/`.include` closure the install actually
  loads, the OSDI `.build-manifest`, the observed release marker, the
  ngspice build and the configured `sim/pdk.json` pin — is captured into
  private scratch **before the first solver launch** (here the units-check
  deck), so a begin-capture failure exits 3 before anything is simulated.
- After the last DUT solve and **before any record file is finalized**, a
  fresh capture is compared against the begin capture. On any persistent
  change the run exits 4 and publishes nothing that looks finalized — no
  `records/<id>.csv`, `.md` or `.env.json`. What stays for inspection:
  `corners/<record-id>/` (units-check and per-point logs and spectra),
  the provisional `records/<id>.csv.raw`, and the begin capture in the
  scratch directory named on stderr. Only on a match is the **begin**
  capture published (no-clobber) as the sidecar, and only then are
  `records/<id>.csv` / `.md` written; the record's Markdown names it.
  Exit statuses: 0 record finalized; 1 units check failed / no point
  passed; 3 preflight or begin-capture failure (nothing simulated);
  4 identity drift or sidecar publication failure (record not finalized).
  A refused run's artifacts are never rewritten — re-run under a fresh
  record id once the environment is stable, and that run finalizes under
  the identity it actually started with.

**Limitation.** This is a before/after comparison, not an immutable
snapshot of the PDK: a file changed and restored before the final recheck
is not detected, and the sidecar cannot prove which bytes each individual
solver invocation read (PDK snapshotting is deliberate future work —
`sim/README.md`).

**New records vs. the committed historical record.** This bench's
committed record
[`20260918-203850-90844d2`](records/20260918-203850-90844d2.md) predates
this lifecycle and has **no sidecar**: in the characterization report's
grading (`signoff/characterization/README.md`) it is `legacy-unverified` —
its numbers and electrical verdicts stand unchanged, but PDK provenance is
*not claimed* for it. That is never fixed retroactively: no sidecar is
manufactured for a historical record, because provenance requires a capture
taken before the run's first solver. A **rerun** of this bench mints a new
record id that does carry the sidecar and grades `verified` (if selected).

**Selecting a new record for characterization.** Nothing is discovered by
globbing: `signoff/characterization/selection.json` names every record the
report reads by path, pinned by SHA-256. A new noise record is selected by
adding its `csv`/`md` pins *plus* `env_sidecar` + `env_sidecar_sha256`
(both or neither) to a `records` entry — the sidecar pin is what upgrades
the rows from `legacy-unverified` to `verified`. The historical record's
existing selection stays as-is until a new run's evidence is deliberately
substituted for it.

## Cold-start invocation

```bash
export PDK_ROOT=/path/to/ihp-open-pdk   # parent dir containing ihp-sg13g2/
export PDK=ihp-sg13g2
sim/tools/build-osdi.sh                 # one-time; idempotent (--check to verify only)
sim/input-noise/run_noise_sweep.sh
```

Requires `ngspice` on `PATH` (developed and run against `ngspice-46`) plus
the OSDI models `sim/tools/build-osdi.sh` builds; does **not** require
`xschem` or `klt` at run time — `design/netlist/opamp_core.spice` is a
committed, pre-netlisted artifact. Runs the full 45-point grid in about
2 minutes on a modern laptop (110 s wall on the machine that produced the
committed record). Writes a new, timestamped, append-only record
under `netlist-snapshots/<record-id>/`, `corners/<record-id>/` and
`records/<record-id>.{csv,md,env.json}` — never overwriting a prior run
(the `.env.json` sidecar is the run-time PDK/model identity described
above; a refused run publishes none of the three).

## What was actually measured (this repo's committed record)

Record [`20260918-203850-90844d2`](records/20260918-203850-90844d2.md) —
all 45 points converged, all 45 passed the per-point sanity checks:

| Metric (band: 100 Hz – 1 MHz) | Range across all 45 points | Worst point |
|---|---|---|
| **Integrated input-referred noise** | **73.4 – 108.9 µVrms** | **108.9 µVrms at `mos_fs_125C_1.08V`** |
| Spot density @ 100 Hz | 2.34 – 3.48 µV/√Hz | 3.48 µV/√Hz at `mos_fs_125C_1.08V` |
| Spot density @ 1 kHz | 741 – 1100 nV/√Hz | 1100 nV/√Hz at `mos_fs_125C_1.08V` |
| Spot density @ 1 MHz | 29.5 – 44.3 nV/√Hz | 44.3 nV/√Hz at `mos_fs_125C_1.08V` |
| Fitted thermal floor (`√B`) | 17.9 – 28.1 nV/√Hz | 28.1 nV/√Hz at `mos_ss_125C_1.08V` |
| Fitted flicker corner (`A/B`) | 1.15 – 1.82 MHz | — (see below) |
| Flicker share of in-band mean-square | 91.4 – 94.0 % | — |

Nominal point (`mos_tt_27C_1.20V`): **87.3 µVrms** integrated,
`2.79 µV/√Hz @ 100 Hz`, `881 nV/√Hz @ 1 kHz`, `35.4 nV/√Hz @ 1 MHz`,
flicker corner `1.65 MHz`.

Full per-point data: [`records/20260918-203850-90844d2.csv`](records/20260918-203850-90844d2.csv).
Raw per-point ngspice logs, in-band spectra and reference-only wide
(1 Hz – 100 MHz) spectra:
[`corners/20260918-203850-90844d2/`](corners/20260918-203850-90844d2/).
Frozen DUT netlist this record ran against:
[`netlist-snapshots/20260918-203850-90844d2/opamp_core.spice`](netlist-snapshots/20260918-203850-90844d2/opamp_core.spice).

**Reproducibility**: the sweep was re-run end-to-end from the same commit
before this experiment was committed, and the second run's per-point CSV was
**byte-identical** to the committed one (only the record id, which embeds the
run timestamp, differs). `.noise` here is a deterministic small-signal
analysis — no Monte Carlo, no random seed — so a re-run on the same PDK pin
and the same ngspice build is expected to reproduce exactly; the duplicate
run was discarded rather than committed, since a second identical record is
not additional evidence.

### Which corner binds, and why it is not the same question at both band edges

**`FS / 125 °C / 1.08 V` binds the integrated figure** (108.9 µVrms) —
the same corner that already binds DC gain and GBW in
`sim/open-loop-ac/`. It also binds all three spot densities. The
runner-up ordering is informative: `mos_ss_125C_1.08V` (106.9 µVrms) and
`mos_tt_125C_1.08V` (106.6 µVrms) are within 2% of it, i.e. **temperature
and supply dominate the process axis** for this row — every one of the
three worst points is `125 °C / 1.08 V` (`FS`, `SS`, `TT` in that order),
and every one of the three best points is at `−40 °C` (`FF`/`SF` at
1.32 V, then `FF` at 1.20 V), regardless of process corner.

**The flicker-vs-thermal regime does not shift the binding corner here,
but it does split which sub-metric a corner is worst for.** The
integrated figure is `91–94%` flicker at every corner, so its binding
corner is the flicker-worst one (`FS / 125 °C / 1.08 V`). The *fitted
thermal floor* binds elsewhere — `28.1 nV/√Hz` at `mos_ss_125C_1.08V`,
the lowest-`g_m` hot corner, exactly where `√(4kTγ/g_m)` should be worst.
Because the band's upper decade is still flicker-dominated
(`flicker_corner_hz` is `1.15–1.82 MHz`, i.e. *above* the band top), the
thermal-worst corner never gets to set the integrated number. A
narrower, higher band (e.g. `100 kHz – 10 MHz`) would bind at
`SS / 125 °C / 1.08 V` instead — which is precisely why the band is
stated as part of the spec row rather than left implicit.

### What the flicker dominance says about the design (not a claim, an observation)

`design/opamp_sizing.md` sized the input pair at `L = 0.13 µm`
(minimum length, `W/L = 3.2 µm / 0.13 µm`) for `f_T`, and that sizing pass
explicitly did not consider noise. The measured flicker corner
(`1.15 – 1.82 MHz`) is the direct consequence: flicker noise scales as
`1/(W·L)`, so the `0.416 µm²` input devices put the `1/f` corner above the
whole measurement band. This is recorded here as measured behavior of the
committed sizing; **whether to re-size for noise is a design decision, not
this bench's to make** — it is filed separately
([issue #19](https://github.com/2AMLogic/sg13g2-opamp/issues/19)) rather
than acted on here.

**Update (2026-09-21): that decision is now made.** Issue #19 is closed by
[`spec/decision-records/0003-input-pair-flicker-noise.md`](../../spec/decision-records/0003-input-pair-flicker-noise.md):
re-size **declined** — the committed minimum-length input pair stands, and
the flicker dominance recorded here is an examined, accepted property of
the design (the record cites exactly this section and the record CSV below
for its numbers). The measured rows in this record therefore keep
describing the committed DUT; nothing in `records/` needs re-running.

## What this bench does not claim

- **Not ratified by this bench.** The `spec/target-spec.md` noise row
  updated from this record was tagged `[P]` (proposal) until the
  DR-0002 two-key ratification (issue #16, PR #27, `65f5fb4`); it now
  carries the ratified `[DR-2]` bound ≤ 108.9 µVrms worst-case
  (100 Hz – 1 MHz) under the spec header `Status: RATIFIED (partial)`.
  The ratification instrument is DR-0002, not this record; the
  flicker property the bound rests on is examined in
  `spec/decision-records/0003-input-pair-flicker-noise.md`.
- **Not a per-device noise attribution** — see "Per-point sanity checks"
  above for why the per-device breakdown is unavailable in this
  OSDI/PSP103 build.
- **Not output-referred noise, and not noise in any other closed-loop
  gain configuration.** The number is input-referred in a unity-gain
  follower; a `1 + R2/R1` configuration multiplies it by its own noise
  gain.
- **Not a statistical (mismatch/Monte-Carlo) figure.** This is a
  deterministic PVT-corner sweep; no MC deck is run, and the noise row's
  "Statistical basis" column is left as not-applicable rather than
  claimed.
- **Not bias-generator noise.** `ibias` is an ideal (noiseless) 10 µA
  source, per `design/opamp_sizing.md`'s "Bias scope" — a real bias
  generator's own noise is not in this number.
- **Not post-layout.** No extracted parasitics; the DUT is the committed
  schematic netlist.

## The `klt sim` path (issue #96, first increment)

[`klt/`](klt/) expresses this same bench as a `klt sim` request, because T1
item 5 ("full corner verification vs a ratified spec") accepts only a `klt
sim` envelope (see `signoff/README.md`, "Item 5 envelope coverage, per
ratified row"). It is a second measurement path for the same circuit, not a
new bench, and follows the pattern of `../slew-rate/klt/` (issue #95).

**Delivered: request, circuit body, runner, comparator, tests. Pending: the
real 45-corner envelope and the measured comparison.** Issue #96 stays open;
this increment is `Part of #96`. Nothing under `klt/` is signoff evidence yet.

| File | What it is |
|---|---|
| [`klt/tb_noise.body.spice`](klt/tb_noise.body.spice) | The test circuit as a `klt sim` circuit body: flat DUT include, `Vfb` (0 V, `inn` to `out`) unity-gain follower, `Vinp` with `ac 1`, `CL = 2 pF`, 10 µA `ibias`; exactly one `.include` of `design/netlist/opamp_core.spice`, no `.control` block. No re-expression was needed (`Vinp` is a plain DC source `klt` can `alter`). |
| [`klt/noise.request.json`](klt/noise.request.json) | The request: `noise v(out) Vinp dec 20 100 1meg` over the 45-point grid; the ratified bound on the integrated figure, plus tool-graded band integrity checks and unlimited spot densities for the join. |
| [`klt/run.sh`](klt/run.sh) | Sources `sim/preflight.sh`, runs the request, gates the envelope, writes it unmodified to `klt/records/<UTC>-<sha>.sim.json`, then the comparison `.compare.json`. |
| [`klt/compare.py`](klt/compare.py) | The validation gate and the comparison against this bench's harness record; tests in [`klt/test_compare.py`](klt/test_compare.py). |

### How the two paths relate, and which one is the record of evidence

The harness record
[`records/20260918-203850-90844d2.csv`](records/20260918-203850-90844d2.csv)
stays the **record of evidence** for the noise row; nothing in `klt/` edits or
replaces it. A `klt sim` envelope under `klt/records/` (none yet) will be the
**gradable form** of the same measurement: the tool assigns the verdict and
binding corner against the ratified bound, and `compare.json` ties the two
together point by point. The harness `run_noise_sweep.sh` path is unchanged.

### The band is part of the number

The request keeps the ratified band: `100 Hz – 1 MHz`, `dec 20`, 81 points,
bound `≤ 108.9 µVrms` (`inoise_int_vrms`, `limits.max = 108.9e-6`), into
`CL = 2 pF`. The integrated figure is `noise2.inoise_total`, ngspice's
already-square-rooted RMS volts over the swept band, which is the vector the
harness reads. Five spot densities come from `noise1.inoise_spectrum[0, 20,
40, 60, 80]`. As the harness asserts its spot frequencies instead of trusting
index arithmetic, the request carries `band_points` (= 81), `band_f_first_hz`
(100), `band_f_last_hz` (10⁶) and `spot_f_{1k,10k,100k}hz` with tight limits,
and `compare.py validate` refuses an envelope whose band differs.

**A bound miss stays a miss.** The harness's own worst point,
`mos_fs_125C_1.08V` at 108.949 µVrms, is already 0.049 µVrms above the literal
108.9 µVrms bound (see `signoff/README.md`, "Bounds are compared literally").
The tool will grade that corner `fail` against the unrounded bound, and
`compare.py` expects the harness-side verdict to agree. Neither the bound nor
the band is relaxed here.

### Is the integrated value reachable through `klt`? (partial evidence)

Yes, for the plot and vector selection; checked on a **toy resistor
divider, not the DUT**, with `klt 0.7.0+gb82427b30c96` and ngspice-42, one
local corner, request kept outside the repo. After `noise v(out) Vin dec 20
100 1meg` the `expr` entries `noise2.inoise_total`,
`noise1.inoise_spectrum[k]`, `noise1.frequency[k]` and
`length(noise1.inoise_spectrum)` each reduce to a scalar (`inoise_total`
5.7575e-6 V for 1 k / 1 k at 27 °C, i.e. 2·√(4kT·500 Ω·(10⁶−100)) as the
divider's gain 1/2 implies; 81 points; 100/1000 Hz). Unqualified
`inoise_spectrum[20]` / `frequency[20]` do not resolve, so the request uses
plot-qualified names (`noise1.`, `noise2.`). No klayout-tools friction issue
was needed for this. The toy run alone did not validate the DUT corner; the
one-corner DUT prototype below does.

### One-corner DUT prototype (2026-10-10)

One local corner of the real request, on a host that passes
`sim/preflight.sh` (ngspice-46, the four OSDI libraries load, PDK at
`$PDK_ROOT/ihp-sg13g2`, `.fetched-version` 0.3.0). This is a probe of the
encoding, **not signoff evidence and not a grid**: one point of 45.

- Request: `klt/noise.prototype-tt27-1v20.request.json`, `noise.request.json`
  reduced to `mos_tt` (with its `cap_typ` bundle), 27 °C, VDD 1.20 V / Vinp
  0.60 V, `"backend": "local"`; analysis, band, measurements, limits, OSDI
  preload and options unchanged. Committed byte-identical to what ran
  (sha256 `f63435b9…10581`).
- Command (from the repo root, after `source sim/env.sh`):
  `klt sim sim/input-noise/klt/noise.prototype-tt27-1v20.request.json --backend local --format json`.
  Client `klt 0.7.0+g5e5b55992a7f`, ngspice-46. Exit 0, empty stderr,
  0.17 s for the corner.
- Envelope, unmodified: `klt/prototype/20261010-053635-c0c112a.tt27-1v20.sim.json`
  (`status: pass`, 1 corner, no diagnostics, 12 measurements, 7 limits
  checked). It is outside `klt/records/` on purpose: `records/` holds only
  envelopes that pass `compare.py validate` (45 unique points), and
  `compare.py compare` refuses this one (44 points missing, exit 2), as it
  should.
- Plot and vector: after `noise`, `noise2.inoise_total` is the integrated
  input-referred RMS in volts over 100 Hz – 1 MHz, and
  `noise1.inoise_spectrum[k]` the density in V/√Hz. The band checks read back
  81 points, 100 Hz, 1 kHz, 10 kHz, 100 kHz and 1 MHz.

Against the harness row `mos_tt_27C_1.20V` of
`records/20260918-203850-90844d2.csv` (macOS/aarch64 ngspice-46):

| Measurement | `klt sim` (this host) | Harness CSV | \|rel. diff\| |
|---|---|---|---|
| `inoise_int_vrms` (V) | 8.729302e-05 | 8.7293E-05 | 1.9e-07 |
| `inoise_100hz_v_rthz` (V/√Hz) | 2.786727e-06 | 2.78673e-06 | 1.2e-06 |
| `inoise_1khz_v_rthz` | 8.814771e-07 | 8.81477e-07 | 6.8e-08 |
| `inoise_10khz_v_rthz` | 2.794952e-07 | 2.79495e-07 | 6.7e-07 |
| `inoise_100khz_v_rthz` | 9.071780e-08 | 9.07178e-08 | 1.6e-08 |
| `inoise_1mhz_v_rthz` | 3.535270e-08 | 3.53527e-08 | 1.2e-07 |

Every difference is below the harness CSV's printing resolution (5 to 6
significant digits), so the units and the integrated band agree with the
harness at this corner. The integrated value is reachable through `klt`;
no klayout-tools friction issue was filed. **One typical corner does not
justify the comparison tolerance.** The provisional 2×10⁻³ below stays until
the full-grid comparison measures it, especially at the slow/hot corners and
at `mos_fs_125C_1.08V`, which sits 4.5×10⁻⁴ above the bound.

### Not reproduced from the harness

`klt sim` runs one analysis per corner. The harness's DC operating-point
sanity check (`op_pass`) and its closed-loop-gain guard at both band edges
(`clgain_100hz`, `clgain_1mhz`) need an `op` / `ac` analysis in the same
corner; the wide reference-only sweep and the flicker/thermal fit are also not
in the request. `compare.py` does not compare them and lists them under
`not_compared`. The harness record keeps carrying them. The noise units check
(`tb_noise_units_check.spice`) is likewise a harness-side step; the first
real envelope must be checked against the harness' units (V/√Hz, RMS V)
through the join itself.

### Comparison tolerance (provisional)

| Metric | Tolerance | Why |
|---|---|---|
| `inoise_int_vrms`, `inoise_*_v_rthz` | 2×10⁻³ relative | Same circuit, same analysis, ngspice default tolerance (DR-0005), no waveform post-processing on either side. The harness ran on macOS/aarch64 ngspice-46; DR-0005 measured 9.9×10⁻⁴ relative drain-current difference to a Linux/x86_64 record of this PDK, and noise tracks bias current and gm. 2×10⁻³ is that figure doubled, as in `../slew-rate/klt/`. |

**These tolerances are provisional.** No measured envelope exists, so none is
justified from measurement. They must be replaced by a measured
justification, and every out-of-tolerance point explained, in the evidence
increment. A comparison tolerance never loosens the bound: the bound is graded
by `klt sim`, and a verdict that flips within tolerance of it is listed in
`bound_verdict_disagreements` as *explained*, never hidden. Proximity, stated
in advance: the harness-worst integrated figure is 4.5×10⁻⁴ relative above
the bound, so a tool value within the tolerance can flip the verdict there.

### Tests

`python3 -m pytest sim/input-noise/klt/test_compare.py` (36 tests, offline).
The synthetic envelopes are **built from the harness CSV** and are comparator
tests with negative controls (perturbed value, missing/duplicate/extra
point, null/NaN, mis-biased Vcm, wrong band/point count/spot frequency,
errored/inconclusive/skipped coverage, bound flips). They are not evidence
about the circuit.

### Status (2026-10-10): what is and is not done

- Delivered (2026-10-09): request, body, runner, comparator, tests, this
  section.
- Delivered (2026-10-10): the one-corner DUT prototype above (`mos_tt`,
  27 °C, 1.20 V). On 2026-10-09 the dispatch host then in use had ngspice-42
  and failed `sim/preflight.sh`'s OSDI check (`Unknown model type
  pspnqs103va`, exit 3). The 2026-10-10 host passes it. The prototype is an
  encoding check at one point, not envelope evidence.
- **Not done: the real 45-corner envelope and the measured comparison.** The
  fleet submission depends on 2AMLogic/2am#2193 (runner image klt version) or
  a verified compatible sharded bridge; deployed runner/client compatibility
  must be re-checked first. The grid is never run locally on a shared dispatch
  host. No fleet submission was attempted in this increment.
- The signoff manifest is unchanged; item 5 stays uncited until all ten
  ratified rows have envelopes.
