2AMLogic/sg13g2-opamp/signoff/characterization/reports/20261012-003507-e721143.md

# Characterization report — sg13g2-opamp

T1 item 8 ("Characterization report"): every claimed spec row, its
evidence record and its verdict, aggregated from committed `sim/`
records. Generated by `signoff/characterization/generate.py` from the
explicit record selection `signoff/characterization/selection.json`; nothing
here was re-simulated.

## Record metadata (excluded from reproduction)

| Field | Value |
|---|---|
| `record_id` | `20261012-003507-e721143` |
| `generated_utc` | `2026-10-12T00:35:07Z` |
| `git_head` | `e721143` |
| `generator_sha256` | `sha256:0c19853a6bc914107676b60b51c0514f5589dc8f118339388bb39068bc629688` |

Everything below this section is a pure function of the selected
records, the selection file, the spec text and the inventory:
`content_sha256` = `sha256:f41072dcbbc9d8f166d51b1928934a94b8245b2887eb9193b9c4965edc321e30`.

## Reproduce (no ngspice, no PDK)

```bash
python3 signoff/characterization/generate.py           # re-render, write nothing
python3 signoff/characterization/generate.py --check   # newest record reproduces
```

That re-reads committed evidence only. Re-running the *simulations*
behind it is a different operation (PDK + ngspice, hours of grids):
see `signoff/evidence/testbenches.txt` and each bench's README.

## Overall: **FAIL**

8 of 12 ratified (binding) bounds PASS. Verdict counts: FAIL 4, MEASURED 5, PASS 9, PENDING 1.

**Bound precision:** `dc_gain`, `input_noise`, `offset_systematic`, `swing_span` FAIL their ratified bound as written, although the raw worst case rounds onto the bound at the decimals the bound is written to (see each row's raw margin). No ratification record defines a rounding convention, so this report compares literally and does not pass them; whether those bounds or the comparison convention should be restated is a spec decision for the keys (see the caveats below).

Rule: ERROR if any input is in error; else FAIL if any ratified (binding) row fails its bound; else INCOMPLETE if any non-pending row lacks full valid grid coverage; else PASS. Superseded rows are context and never FAIL the report; measured rows carry no bound; Area is PENDING.

Comparison rule: Each ratified bound is compared literally: every valid grid point's raw measured value, scaled to the bound's unit, must satisfy the bound exactly as written in spec/target-spec.md (e.g. >= 37.8 means 37.7999 fails). No rounding, tolerance or precision convention is applied: no ratification record defines one, and choosing one is a spec decision, not the report's. The worst value rounded to the bound's written decimals is shown for information only and never gates a verdict. A point that fails its record's validity flags never contributes an extremum: it is counted as missing coverage, so a failed simulation point can only make a row INCOMPLETE, never PASS.

## Ratified rows (binding)

| Row | Bound | Decision record | Load / conditions | Worst measured (binding point) | Raw margin to bound (worst rounded to bound decimals, informational) | Best measured | Grid coverage | Source record (sha256) | Verdict |
|---|---|---|---|---|---|---|---|---|---|
| Open-loop DC gain | ≥ 37.8 dB | `spec/decision-records/0002-target-spec-ratification.md` [DR-2] | CL = 2 pF [DR-1] (verified: ratified spec section 1 and the selected record both state it; record says 2e-12 F); no resistive load; conditions (descriptive, unverified): open-loop AC, Vcm = VDD/2; Av0 read at the low-frequency shelf | 37.7812 dB at `mos_fs_125C_1.08V` | -0.0188 dB (rounded: 37.8 dB) | 45.1965 dB at `mos_ss_-40C_1.32V` | 45/45 valid | `sim/open-loop-ac/records/20260910-221601-22feaba.csv` col `av0_db` (`dd71064b760d`) | **FAIL** |
| GBW (into stated CL = 2 pF) | ≥ 4.74 MHz | `spec/decision-records/0002-target-spec-ratification.md` [DR-2] | CL = 2 pF [DR-1] (verified: ratified spec section 1 and the selected record both state it; record says 2e-12 F); no resistive load; conditions (descriptive, unverified): open-loop AC, Vcm = VDD/2; unity-gain crossing of the open-loop response | 4.74216 MHz at `mos_fs_125C_1.08V` | 0.00216 MHz (rounded: 4.74 MHz) | 6.62333 MHz at `mos_sf_-40C_1.08V` | 45/45 valid | `sim/open-loop-ac/records/20260910-221601-22feaba.csv` col `gbw_hz` (`dd71064b760d`) | **PASS** |
| Phase margin (at GBW, same CL) | ≥ 60 deg | `spec/decision-records/0002-target-spec-ratification.md` [DR-2] | CL = 2 pF [DR-1] (verified: ratified spec section 1 and the selected record both state it; record says 2e-12 F); no resistive load; conditions (descriptive, unverified): open-loop AC, Vcm = VDD/2; phase margin at the GBW crossing | 76.3643 deg at `mos_ff_125C_1.32V` | 16.3643 deg (rounded: 76 deg) | 78.6369 deg at `mos_ss_-40C_1.32V` | 45/45 valid | `sim/open-loop-ac/records/20260910-221601-22feaba.csv` col `pm_deg` (`dd71064b760d`) | **PASS** |
| Slew rate (into stated CL = 2 pF) | ≥ 7.51 V/µs | `spec/decision-records/0002-target-spec-ratification.md` [DR-2] | CL = 2 pF [DR-1] (verified: ratified spec section 1 and the selected record both state it; record says 2e-12 F); no resistive load; conditions (descriptive, unverified): large-signal step, input common mode Vcm = VDD/2, ±0.3 V-per-input antiphase drive, measured in the VDD/2 ± 0.15 V window; worse of the rising and falling edge per point | 7.51441 V/µs at `mos_ss_-40C_1.08V` | 0.00441 V/µs (rounded: 7.51 V/µs) | 9.90983 V/µs at `mos_ff_125C_1.32V` | 45/45 valid | `sim/slew-rate/records/20260918-210216-90844d2.csv` col `sr_worst_v_per_us` (`025cbee18bf3`) | **PASS** |
| Input-referred noise (100 Hz – 1 MHz integrated) | ≤ 108.9 µVrms | `spec/decision-records/0002-target-spec-ratification.md` [DR-2] | CL = 2 pF [DR-1] (verified: ratified spec section 1 and the selected record both state it; record says 2e-12 F); no resistive load; conditions (descriptive, unverified): unity-gain closed-loop .noise analysis, integrated over 100 Hz – 1 MHz (the band is part of the number); nominal devices, ideal ibias contributes no noise | 108.949 µVrms at `mos_fs_125C_1.08V` | -0.049 µVrms (rounded: 108.9 µVrms) | 73.3562 µVrms at `mos_ff_-40C_1.32V` | 45/45 valid | `sim/input-noise/records/20260918-203850-90844d2.csv` col `vni_int_vrms` (`1841f63b5197`) | **FAIL** |
| Input-referred offset — systematic (deterministic, corner-only) | ≤ 21.9 mV | `spec/decision-records/0002-target-spec-ratification.md` [DR-2] | CL = 2 pF [DR-1] attached; a DC analysis is independent of it (applicability: DC, not a load claim); no resistive load; conditions (descriptive, unverified): DC, Vcm = VDD/2, perfectly matched (nominal) devices; magnitude of the null-method offset, cross-checked per point by a closed-loop method (xcheck_pass) | 21.9273527 mV at `mos_fs_125C_1.08V` | -0.0273527 mV (rounded: 21.9 mV) | 11.4304056 mV at `mos_sf_-40C_1.32V` | 45/45 valid | `sim/input-offset/records/20260918-203858-90844d2.csv` col `vos_null_v` (`f0263167c6b5`) | **FAIL** |
| CMRR — mismatch-inclusive (+3σ of Acm, linear domain) | ≥ 26.68 dB | `spec/decision-records/0004-cmrr-mismatch-inclusive-ratification.md` [DR-4] | CL = 2 pF [DR-1] (verified: ratified spec section 1 and the selected record both state it; record says 2e-12 F); no resistive load; conditions (descriptive, unverified): per point: joined open-loop Av0 minus the +3σ point of the 300-draw common-mode-gain distribution, mean + 3σ taken in the LINEAR domain (DR-0004); SG13G2 per-corner mismatch decks + process corners; DC shelf | 26.6826 dB at `mos_ss_-40C_1.08V` | 0.0026 dB (rounded: 26.68 dB) | 37.57 dB at `mos_ss_125C_1.08V` | 45/45 valid | `sim/cmrr-mismatch/records/20260921-172304-65f5fb4.csv` col `cmrr_3sigma_db` (`d64d9b3a39b9`) | **PASS** |
| PSRR+ (DC shelf) | ≥ 1.87 dB | `spec/decision-records/0002-target-spec-ratification.md` [DR-2] | CL = 2 pF [DR-1] (verified: ratified spec section 1 and the selected record both state it; record says 2e-12 F); no resistive load; conditions (descriptive, unverified): joined open-loop Av0 divided by the VDD-to-output gain (PSRR+; vss is ground), DC shelf (10 mHz read); ideal external 10 µA ibias contributes no supply ripple. Strongly frequency-dependent: the in-band figure below is part of the ratified number's context | 1.8709 dB at `mos_ff_125C_1.32V` | 0.0009 dB (rounded: 1.87 dB) | 29.5448 dB at `mos_ss_-40C_1.08V` | 45/45 valid | `sim/cmrr-psrr/records/20260921-151815-707b34c.csv` col `psrr_db` (`ede23361c795`) | **PASS** |
| Output swing — headroom from VDD | ≥ 251 mV | `spec/decision-records/0002-target-spec-ratification.md` [DR-2] | CL = 2 pF [DR-1] (verified: ratified spec section 1 and the selected record both state it; record says 2 pF); NO resistive load (an upper bound; a loaded-row decision is separate); conditions (descriptive, unverified): open-loop differential DC transfer curve, −6 dB incremental-gain criterion | 251.491128 mV at `mos_fs_-40C_1.08V` | 0.491128 mV (rounded: 251 mV) | 319.0598 mV at `mos_ss_125C_1.32V` | 45/45 valid | `sim/output-swing/records/20260921-151759-707b34c.csv` col `headroom_hi_v` (`d84349f59b65`) | **PASS** |
| Output swing — headroom from VSS | ≥ 141 mV | `spec/decision-records/0002-target-spec-ratification.md` [DR-2] | CL = 2 pF [DR-1] (verified: ratified spec section 1 and the selected record both state it; record says 2 pF); NO resistive load (an upper bound; a loaded-row decision is separate); conditions (descriptive, unverified): open-loop differential DC transfer curve, −6 dB incremental-gain criterion | 141.167273 mV at `mos_ff_-40C_1.08V` | 0.167273 mV (rounded: 141 mV) | 223.073866 mV at `mos_ss_125C_1.32V` | 45/45 valid | `sim/output-swing/records/20260921-151759-707b34c.csv` col `headroom_lo_v` (`d84349f59b65`) | **PASS** |
| Output swing — tracking span | ≥ 0.571 V | `spec/decision-records/0002-target-spec-ratification.md` [DR-2] | CL = 2 pF [DR-1] (verified: ratified spec section 1 and the selected record both state it; record says 2 pF); NO resistive load (an upper bound; a loaded-row decision is separate); conditions (descriptive, unverified): open-loop differential DC transfer curve, −6 dB incremental-gain criterion | 0.570957773 V at `mos_ss_125C_1.08V` | -0.000042227 V (rounded: 0.571 V) | 0.900091812 V at `mos_ff_-40C_1.32V` | 45/45 valid | `sim/output-swing/records/20260921-151759-707b34c.csv` col `swing_span_v` (`d84349f59b65`) | **FAIL** |
| Quiescent power (total VDD current Iq) | ≤ 119.7 µA | `spec/decision-records/0002-target-spec-ratification.md` [DR-2] | CL = 2 pF [DR-1] attached; a DC analysis is independent of it (applicability: DC, not a load claim); no resistive load; conditions (descriptive, unverified): total VDD current at the open-loop bench's DC operating point, INCLUDING the external 10 µA ibias reference | 119.655 µA at `mos_ss_-40C_1.32V` | 0.045 µA (rounded: 119.7 µA) | 99.8521 µA at `mos_ss_125C_1.08V` | 45/45 valid | `sim/open-loop-ac/records/20260910-221601-22feaba.csv` col `ivdd_total_a` (`dd71064b760d`) | **PASS** |

- **Open-loop DC gain**
  - points violating the bound: `mos_fs_125C_1.08V`
- **Slew rate (into stated CL = 2 pF)**
  - rising edge alone, worst: 7.53778 V/µs at `mos_ss_-40C_1.08V`
  - falling edge alone, worst: 7.51441 V/µs at `mos_ss_-40C_1.08V`
- **Input-referred noise (100 Hz – 1 MHz integrated)**
  - spot density @ 100 Hz, worst: 3.47626 µV/√Hz at `mos_fs_125C_1.08V`
  - spot density @ 1 kHz, worst: 1099.59 nV/√Hz at `mos_fs_125C_1.08V`
  - spot density @ 1 MHz, worst: 44.2529 nV/√Hz at `mos_fs_125C_1.08V`
  - points violating the bound: `mos_fs_125C_1.08V`
- **Input-referred offset — systematic (deterministic, corner-only)**
  - largest disagreement between the two methods: 0.3037413 mV at `mos_fs_125C_1.08V`
  - points violating the bound: `mos_fs_125C_1.08V`
- **CMRR — mismatch-inclusive (+3σ of Acm, linear domain)**
  - worst single drawn sample (dB-domain minimum, not the ratified statistic): 25.942 dB at `mos_ss_-40C_1.08V`
  - worst +3σ figure at 1 kHz: 26.6844 dB at `mos_ss_-40C_1.08V`
- **PSRR+ (DC shelf)**
  - in-band PSRR+ at 1 kHz, worst: 1.2998 dB at `mos_sf_-40C_1.32V`
- **Output swing — tracking span**
  - points violating the bound: `mos_ss_125C_1.08V`
- **Quiescent power (total VDD current Iq)**
  - signal-path-only current (excl. ibias), worst: 109.655 µA at `mos_ss_-40C_1.32V`

## Superseded ratified bound (context, not binding)

| Row | Bound | Decision record | Load / conditions | Worst measured (binding point) | Raw margin to bound (worst rounded to bound decimals, informational) | Best measured | Grid coverage | Source record (sha256) | Verdict |
|---|---|---|---|---|---|---|---|---|---|
| CMRR — systematic nominal-device floor (superseded by DR-4, context) | ≥ 30.75 dB | `spec/decision-records/0002-target-spec-ratification.md` [DR-2, superseded by DR-4] | CL = 2 pF [DR-1] (verified: ratified spec section 1 and the selected record both state it; record says 2e-12 F); no resistive load; conditions (descriptive, unverified): perfectly matched devices; joined open-loop Av0 divided by the in-phase common-mode gain; DC shelf (10 mHz read) | 30.7505 dB at `mos_fs_125C_1.08V` | 0.0005 dB (rounded: 30.75 dB) | 62.8322 dB at `mos_fs_-40C_1.08V` | 45/45 valid | `sim/cmrr-psrr/records/20260921-151815-707b34c.csv` col `cmrr_db` (`ede23361c795`) | **PASS** |

## Measured, NOT ratified (no pass/fail verdict)

| Row | Status / tag | Load / conditions | Worst measured (point) | Best measured | Grid coverage | Source record (sha256) | Verdict |
|---|---|---|---|---|---|---|---|
| Input-referred offset — mismatch-driven random 3σ (measured [P], not ratified) | [P (DR-0002 residual (b), re-ratification pending)] | CL = 2 pF [DR-1] attached; a DC analysis is independent of it (applicability: DC, not a load claim); no resistive load; conditions (descriptive, unverified): device-mismatch Monte Carlo, N = 300 draws per point, campaign seed 20260921; SG13G2 <corner>_mismatch sections layered on the process corners; FIXED 1.20 V supply | 27.3996487 mV at `mos_ss_mismatch_125C_1.20V` | 26.4320349 mV at `mos_ff_mismatch_-40C_1.20V` | 16/16 valid | `sim/input-offset/records/mc-20260921-174056-0a509fb.csv` col `three_sigma_v` (`aaf45e4d1e6f`) | **MEASURED** |
| Input-referred offset — worst single-PVT \|systematic\| + 3σ (measured [P], not ratified) | [P (DR-0002 residual (b), re-ratification pending)] | CL = 2 pF [DR-1] attached; a DC analysis is independent of it (applicability: DC, not a load claim); no resistive load; conditions (descriptive, unverified): per point: \|systematic offset at the same corner/temperature, 1.20 V\| + 3σ of the drawn distribution; FIXED 1.20 V supply | 46.6868332 mV at `mos_fs_mismatch_125C_1.20V` | 38.892429 mV at `mos_sf_mismatch_-40C_1.20V` | 16/16 valid | `sim/input-offset/records/mc-20260921-174056-0a509fb.csv` col `vos_total_wc_det_plus_3sigma_v` (`aaf45e4d1e6f`) | **MEASURED** |
| Input common-mode range — span (measured, not ratified) | [P (pre-dates ratification, not part of DR-2)] | CL = 2 pF [DR-1] (verified: ratified spec section 1 and the selected record both state it; record says 2 pF); no resistive load; conditions (descriptive, unverified): open-loop common-mode sweep, differential input pinned at zero; lower bound at the measured Vdsat(M5) knee (m5_headroom), upper bound at pair saturation (pair_saturation); nominal matched devices | 0.253205764 V at `mos_ss_125C_1.08V` | 0.676870423 V at `mos_ff_-40C_1.32V` | 45/45 valid | `sim/input-cmr/records/20260921-174405-65f5fb4.csv` col `icmr_span_v` (`d625dc59a5c5`) | **MEASURED** |
| Input common-mode range — lower bound (measured, not ratified) | [P (pre-dates ratification, not part of DR-2)] | CL = 2 pF [DR-1] (verified: ratified spec section 1 and the selected record both state it; record says 2 pF); no resistive load; conditions (descriptive, unverified): worst (highest) lower common-mode bound, m5_headroom criterion | 0.640129553 V at `mos_ss_-40C_1.08V` | 0.470431235 V at `mos_ff_125C_1.32V` | 45/45 valid | `sim/input-cmr/records/20260921-174405-65f5fb4.csv` col `icmr_lo_v` (`d625dc59a5c5`) | **MEASURED** |
| Input common-mode range — upper bound (measured, not ratified) | [P (pre-dates ratification, not part of DR-2)] | CL = 2 pF [DR-1] (verified: ratified spec section 1 and the selected record both state it; record says 2 pF); no resistive load; conditions (descriptive, unverified): worst (lowest) upper common-mode bound, pair_saturation criterion | 0.795393113 V at `mos_fs_125C_1.08V` | 1.25120811 V at `mos_sf_-40C_1.32V` | 45/45 valid | `sim/input-cmr/records/20260921-174405-65f5fb4.csv` col `icmr_hi_v` (`d625dc59a5c5`) | **MEASURED** |

- **Input-referred offset — mismatch-driven random 3σ (measured [P], not ratified)**
  - σ(Vos), smallest: 8.81067829 mV at `mos_ff_mismatch_-40C_1.20V`
  - σ(Vos), largest: 9.13321623 mV at `mos_ss_mismatch_125C_1.20V`
  - negative control (plain section, zero mismatch) σ(Vos): 1.73762193E-14 mV at `mos_tt_negctrl_27C_1.20V`
- **Input common-mode range — span (measured, not ratified)**
  - points where the measured range excludes the nominal Vcm = VDD/2: 15 of 45

## Pending (no evidence by construction)

- **Area** [TBD-12 (DR-0002 residual (a))] — PENDING: a post-layout property with no ratified bound and no bench; stays pending until its own decision record (DR-0002 residual (a))

## Caveats that travel with these numbers

- Offset Monte Carlo (input-offset-mc) was run at a FIXED 1.20 V supply only: five <corner>_mismatch sections x {-40, 27, 125} degC. The supply axis (1.08 V / 1.32 V) is covered only by the deterministic systematic-offset record; no statistical figure here is a statement about 1.08 V or 1.32 V.
- Systematic and statistical offset are distinct evidence: the ratified bound is the systematic (nominal-device) half [DR-2]; the mismatch-driven 3σ half is measured [P] and is not ratified (DR-0002 residual (b), pending its own two-key pass). This report does not combine them into a ratified total.
- The CMRR row is ratified on its mismatch-inclusive figure [DR-4], whose definition (Av0 minus the +3σ point of the drawn-Acm distribution, mean + 3σ in the LINEAR domain, N = 300 + process corners) is part of the number. This report reads that per-point figure from the record and re-derives it from the record's own linear mean and σ (definition check cmrr_linear_3sigma); it never aggregates in the dB domain. The superseded systematic floor is shown as context only.
- Output swing is unloaded (CL = 2 pF, no resistive load): an upper bound. PSRR+ is ratified at the DC shelf and is strongly frequency-dependent.
- Every measured row comes from nominal-device deterministic benches except the two Monte Carlo records (offset, CMRR); no other row carries a statistical basis.
- Bound precision is an open spec question, not settled by this report: four DR-0002 bounds (DC gain >= 37.8 dB, integrated noise <= 108.9 µVrms, systematic offset <= 21.9 mV, swing span >= 0.571 V) are stricter than the raw worst case of the very records DR-0002 cites, which only round onto them (37.7812 dB, 108.949 µVrms, 21.927 mV, 0.570958 V). This report compares literally, so those rows FAIL. Whether to restate the bounds or ratify a comparison convention is for the keys in a decision record: 2AMLogic/sg13g2-opamp#101.

## What this report is not

- Not item 5 or item 6 evidence: it is a generic, offline aggregation of harness-native records, not a `klt sim` or `klt yield` envelope, and the signoff manifest cites it for item 8 only.
- Not a re-run: regenerating this report re-reads committed records; it does not re-simulate anything. Re-running the benches is the separate cold-start procedure in each sim/ bench README.
- Not a claim that every T1 item is satisfied; post-layout (PEX) re-simulation does not exist yet, so every number here is pre-layout.

## Sources and environment

Simulator pin: `ngspice-46`; configured PDK release (not run-time evidence): IHP-GmbH/IHP-Open-PDK v0.3.0 (`sim/pdk.json`); design netlist `design/netlist/opamp_core.spice` (normalized `c71347288feb`). every selected record must name this ngspice and must have simulated this netlist (comment/blank lines ignored); a mismatch is an error, never a silent mix.

PDK provenance (separate from the electrical verdicts): verified 0 (none); **legacy/unverified 9** (cmrr-mismatch, cmrr-psrr, input-cmr, input-noise, input-offset, input-offset-mc, open-loop-ac, output-swing, slew-rate); error 0. PDK reproducibility is **NOT claimed** (not every selected record has checked run-time PDK identity). The configured release shown above (sim/pdk.json) is the CONFIGURED release, not run-time evidence. A record is `verified` only when its selection pins an environment sidecar (sim/tools/env_identity.py) whose model-closure and OSDI identity checks pass and whose configured release matches the current pin; `legacy-unverified` records keep their numerical results and electrical verdicts but carry NO run-time PDK provenance (it is not invented retroactively -- new runs and new records are needed).

| Record | CSV (sha256) | MD (sha256) | ngspice | PDK provenance | Grid | Expected | Observed | Valid | Draws population (sha256, audit) |
|---|---|---|---|---|---|---|---|---|---|
| cmrr-mismatch | `sim/cmrr-mismatch/records/20260921-172304-65f5fb4.csv` (`d64d9b3a39b9`) | `sim/cmrr-mismatch/records/20260921-172304-65f5fb4.md` (`aa0a4104a5eb`) | ngspice-46 | legacy-unverified | pvt45 | 45 | 45 | 45 | 45 pinned sample files (`590ea76d7a81`, verified: 13500 draws; Av0 joined from `open-loop-ac`) |
| cmrr-psrr | `sim/cmrr-psrr/records/20260921-151815-707b34c.csv` (`ede23361c795`) | `sim/cmrr-psrr/records/20260921-151815-707b34c.md` (`c3a2755afbb6`) | ngspice-46 | legacy-unverified | pvt45 | 45 | 45 | 45 | — |
| input-cmr | `sim/input-cmr/records/20260921-174405-65f5fb4.csv` (`d625dc59a5c5`) | `sim/input-cmr/records/20260921-174405-65f5fb4.md` (`f1643ab3ff4c`) | ngspice-46 | legacy-unverified | pvt45 | 45 | 45 | 45 | — |
| input-noise | `sim/input-noise/records/20260918-203850-90844d2.csv` (`1841f63b5197`) | `sim/input-noise/records/20260918-203850-90844d2.md` (`6c64198791c1`) | ngspice-46 | legacy-unverified | pvt45 | 45 | 45 | 45 | 45 pinned log+spectrum pairs (`740ee818c2af`, verified: band 100 Hz - 1e+06 Hz, 81 points) |
| input-offset | `sim/input-offset/records/20260918-203858-90844d2.csv` (`f0263167c6b5`) | `sim/input-offset/records/20260918-203858-90844d2.md` (`9c4a9e4e325b`) | ngspice-46 | legacy-unverified | pvt45 | 45 | 45 | 45 | — |
| input-offset-mc | `sim/input-offset/records/mc-20260921-174056-0a509fb.csv` (`aaf45e4d1e6f`) | `sim/input-offset/records/mc-20260921-174056-0a509fb.md` (`b007656df04e`) | ngspice-46 | legacy-unverified | offset_mc15 | 16 | 16 | 16 | `sim/input-offset/records/mc-20260921-174056-0a509fb-draws.csv` (`70b7e0aa3101`, verified: 16 points, 4800 draws, 4800 passing) |
| open-loop-ac | `sim/open-loop-ac/records/20260910-221601-22feaba.csv` (`dd71064b760d`) | `sim/open-loop-ac/records/20260910-221601-22feaba.md` (`01988711eec6`) | ngspice-46 | legacy-unverified | pvt45 | 45 | 45 | 45 | — |
| output-swing | `sim/output-swing/records/20260921-151759-707b34c.csv` (`d84349f59b65`) | `sim/output-swing/records/20260921-151759-707b34c.md` (`5fe5cfc2c58b`) | ngspice-46 | legacy-unverified | pvt45 | 45 | 45 | 45 | 45 pinned coarse/fine curve+netlist sets (`bf84d7d579d3`, verified: criterion 0.5 x peak, coarse 500e-6 V step, fine +/-25e-3 V) |
| slew-rate | `sim/slew-rate/records/20260918-210216-90844d2.csv` (`025cbee18bf3`) | `sim/slew-rate/records/20260918-210216-90844d2.md` (`d3e278ad4438`) | ngspice-46 | legacy-unverified | pvt45 | 45 | 45 | 45 | 45 pinned waveform+netlist pairs (`38e6064f05b5`, verified: edges 300/550/800 ns, windows +/-0.15 V and +/-0.075 V) |

Offset Monte Carlo statistics audit (issue #199): a record that selects a raw draws population (`draws_csv`, pinned by sha256 beside its summary) has every published per-point statistic recomputed from that population exactly as sim/input-offset/run_offset_mc.sh computes it -- accumulation in draw order, mean = sum/n_pass, sample sigma with the N-1 denominator, three-sigma = 3 sigma, min/max over the passing draws, and worst-case total = |vos_systematic_det_v| + three-sigma. A committed summary cell passes only when it is that recomputed value as the bench serializes it (printf %.9g, nine significant digits), i.e. within half a unit in the 9th significant digit (5e-9 relative); a cell that differs beyond its own serialization is an error naming the point and the offending field. The draws population itself must be complete and singular: missing, duplicated, mismatched or non-finite PASS draws fail the record rather than quietly shrinking it. The negative-control (negctrl) draws are a separate population: audited on their own draws like every other point's, never pooled into the mismatch statistics.

CMRR mismatch statistics audit (issue #208): a record that selects raw sample files (`mc_samples`, one sha256-pinned `<point>_mc_samples.txt` per grid point) has every published per-point statistic recomputed offline from those samples by the SAME function the bench uses (sim/cmrr-mismatch/mc_samples.py point_stats): the strict parser (exactly one finite OP and one AC record per draw), the op_fail / plateau_fail acceptance rules with the pinned thresholds, the accepted/excluded counts, the LINEAR-domain Acm mean and N-1 sample sigma, and the DR-0004 bound Av0 - 20log10(mean + 3 sigma). Each committed cell must equal the recomputed value as the bench serializes it (printf %.6g, six significant digits). Av0 is joined from the explicitly selected, hash-pinned deterministic record (`av0_join`), never taken from the summary. A summary edited coherently (mean, sigma and CMRR together) while the pinned samples stay unchanged is an error naming the point and field, as is any unparseable, truncated, duplicated or stale-pinned population.

Input-noise raw-evidence audit (issue #213): a record that selects raw noise artifacts (`noise_raw`, one sha256-pinned ngspice log and one sha256-pinned in-band spectrum per grid point) is audited offline against them, with the post-processing in sim/input-noise/noise_post.py -- the module run_noise_sweep.sh itself runs. Two independent checks per point: (1) integrated-log: `vni_int_vrms` must be the single NOISE_INOISE_TOTAL token of the pinned log, which the bench copies verbatim (so equality is exact, not toleranced); (2) spectrum-derived: the five spot densities, the flicker (A/f) and thermal (B) weighted-least-squares split, the flicker corner and flicker fraction, and the trapezoidal cross-check ratio against the logged total are recomputed from the pinned spectrum and each cell must equal the recomputed value as the bench serializes it (printf %.6g, six significant digits; `nan` where undefined). The trapezoidal spectrum integral is the bench's cross-check of the logged figure, never a substitute for it: neither check can mask the other. The spectrum must be the documented band (100 Hz - 1 MHz, 81 points, dec 20, strictly increasing) with finite positive samples; a missing, duplicated, malformed, non-finite or stale-pinned artifact is an error naming the point and file. A summary edited with its own hash refreshed still fails while the pinned raw artifacts disagree.

Slew-rate raw-evidence audit (issue #227): a record that selects raw transient evidence (`slew_raw`, one sha256-pinned `wrdata` v(out) waveform and one sha256-pinned rendered bench netlist per grid point, plus the measurement configuration) is audited offline against it, with the measurement in sim/slew-rate/slew_post.py -- the module run_slew_sweep.sh itself runs. The configuration (edge intervals, outer and inner windows) must be exactly the bench's, and the supply, common-mode voltage, step schedule and stop time of each pinned rendered netlist must agree with it. Per point the four edge rates (first interpolated crossing of the window edges inside the edge interval), the worse edge, the waveform extrema, the window limits and the waveform-derived linearity and traverse flags are recomputed, and each committed cell must equal the recomputed value as the bench serializes it (printf %.6g, six significant digits; flags 0/1), with no tolerance beyond that serialization. A waveform that is missing, changed, assigned to another point, non-finite, out of time order or without the needed crossings cannot yield a passing measurement. A summary edited coherently (rise, fall and worst together, hash refreshed) still fails while the pinned waveforms disagree.

Output-swing raw-evidence audit (issue #230): a record that selects raw DC evidence (`swing_raw`, one sha256-pinned coarse and one fine transfer-curve wrdata file and one sha256-pinned rendered bench netlist per pass and grid point, plus the measurement configuration) is audited offline against it, with the measurement in sim/output-swing/swing_post.py -- the module run_swing_sweep.sh itself runs. The configuration (coarse window, fine half-span and step, the 0.5 x peak criterion) must be exactly the bench's, and each pinned rendered netlist must agree with it: supply, common mode (VDD/2), corner section, temperature, sweep window, recorded vectors, wrdata target and pass label -- the fine window centred on the coarse crossing recomputed from the pinned coarse curve, and each curve exactly as many samples as its netlist's sweep declares. Per point the unique-crossing and plateau checks, the tracking bounds at the sampled 0.5-times-peak region, both headrooms, the span, the fine interpolated crossing, the peak incremental gain and the mid-swing supply current are recomputed, and each committed cell must equal the recomputed value as the bench serializes it (printf %.9g, nine significant digits; op_pass 0/1), with no tolerance beyond that serialization. Curves are strictly parsed: missing, truncated, malformed or non-finite samples, repeated or reversed sweep scales and mismatched wrdata scale columns are errors naming the point and file, as are multiple or missing coarse crossings and a fine window that truncates the accepted region. A summary edited coherently (bounds, headrooms and span together, hash refreshed) still fails while the pinned curves disagree. The record's cross-bench diagnostic columns (vos_offset_record_v, vos_delta_v, av0_ac_record_db, av0_ratio, ivdd_ac_record_a, ivdd_ratio) are logged, not gated (the bench README's "Cross-checks") and stay outside this audit.

Spec section 2 rows covered: Open-loop DC gain, GBW (into stated CL = 2 pF [DR-1], above), Phase margin (at GBW, same CL), Slew rate (into stated CL = 2 pF [DR-1], above), Input-referred noise (band: **100 Hz – 1 MHz integrated**, plus spot densities; same stated CL = 2 pF [DR-1]), Input-referred offset, CMRR, PSRR, Input common-mode range (ICMR), Output swing, Quiescent power, Area.
Item 9 inventory rows covered: CMRR (mismatch-inclusive), CMRR (systematic floor), GBW (CL = 2 pF), Input common-mode range, Input offset (3 sigma, MC), Input offset (systematic), Input-referred noise, Open-loop DC gain, Output swing, PSRR (DC shelf), Phase margin, Quiescent power, Slew rate (CL = 2 pF).
