2AMLogic/sg13g2-opamp/signoff/characterization/reports/20261009-005750-622fb9c.md

# Characterization report — sg13g2-opamp

T1 item 8 ("Characterization report"): every claimed spec row, its
evidence record and its verdict, aggregated from committed `sim/`
records. Generated by `signoff/characterization/generate.py` from the
explicit record selection `signoff/characterization/selection.json`; nothing
here was re-simulated.

## Record metadata (excluded from reproduction)

| Field | Value |
|---|---|
| `record_id` | `20261009-005750-622fb9c` |
| `generated_utc` | `2026-10-09T00:57:50Z` |
| `git_head` | `622fb9c` |
| `generator_sha256` | `sha256:3cf31fbaee234674ae87cacfe57973742fce896d3357f521f083edd0b5be0a27` |

Everything below this section is a pure function of the selected
records, the selection file, the spec text and the inventory:
`content_sha256` = `sha256:05290398ea6771d894f0e069c49a8337887af2f6ed353de5caf0d983971302f3`.

## Reproduce (no ngspice, no PDK)

```bash
python3 signoff/characterization/generate.py           # re-render, write nothing
python3 signoff/characterization/generate.py --check   # newest record reproduces
```

That re-reads committed evidence only. Re-running the *simulations*
behind it is a different operation (PDK + ngspice, hours of grids):
see `signoff/evidence/testbenches.txt` and each bench's README.

## Overall: **PASS**

12 of 12 ratified (binding) bounds PASS. Verdict counts: MEASURED 5, PASS 13, PENDING 1.

**Read with the comparison rule below:** `dc_gain`, `input_noise`, `offset_systematic`, `swing_span` clear their bound only at the precision the bound was ratified at; the raw worst-case value sits beyond the literal decimal (see each row's raw margin). That is how DR-0002 wrote those bounds (AT the cited worst case, rounded), not a relaxation by this report.

Rule: ERROR if any input is in error; else FAIL if any ratified (binding) row fails its bound; else INCOMPLETE if any non-pending row lacks full valid grid coverage; else PASS. Superseded rows are context and never FAIL the report; measured rows carry no bound; Area is PENDING.

Comparison rule: Each ratified bound is compared at the precision it was ratified at: the measured value, scaled to the bound's unit, is rounded half-to-even to the number of decimals written in the ratified bound (e.g. '37.8' -> 1 decimal) and then compared. DR-0002 set every bound AT the measured worst case it cites, written to that precision, so this is the reading under which the ratifying record agrees with itself; it relaxes no bound. The raw (unrounded) value is reported beside every verdict, and `strict_literal_pass` states whether the raw value also clears the literal decimal. A point that fails its record's validity flags never contributes an extremum: it is counted as missing coverage, so a failed simulation point can only make a row INCOMPLETE, never PASS.

## Ratified rows (binding)

| Row | Bound | Decision record | Load / conditions | Worst measured (binding point) | Compared at bound precision | Best measured | Grid coverage | Source record (sha256) | Verdict |
|---|---|---|---|---|---|---|---|---|---|
| Open-loop DC gain | ≥ 37.8 dB | `spec/decision-records/0002-target-spec-ratification.md` [DR-2] | CL = 2 pF [DR-1], no resistive load; open-loop AC, Vcm = VDD/2; Av0 read at the low-frequency shelf | 37.7812 dB at `mos_fs_125C_1.08V` | 37.8 dB (raw margin -0.0188; strict literal FAIL) | 45.1965 dB at `mos_ss_-40C_1.32V` | 45/45 valid | `sim/open-loop-ac/records/20260910-221601-22feaba.csv` col `av0_db` (`dd71064b760d`) | **PASS** |
| GBW (into stated CL = 2 pF) | ≥ 4.74 MHz | `spec/decision-records/0002-target-spec-ratification.md` [DR-2] | CL = 2 pF [DR-1], no resistive load; open-loop AC, Vcm = VDD/2; unity-gain crossing of the open-loop response | 4.74216 MHz at `mos_fs_125C_1.08V` | 4.74 MHz (raw margin 0.00216; strict literal pass) | 6.62333 MHz at `mos_sf_-40C_1.08V` | 45/45 valid | `sim/open-loop-ac/records/20260910-221601-22feaba.csv` col `gbw_hz` (`dd71064b760d`) | **PASS** |
| Phase margin (at GBW, same CL) | ≥ 60 deg | `spec/decision-records/0002-target-spec-ratification.md` [DR-2] | CL = 2 pF [DR-1], no resistive load; open-loop AC, Vcm = VDD/2; phase margin at the GBW crossing | 76.3643 deg at `mos_ff_125C_1.32V` | 76 deg (raw margin 16.3643; strict literal pass) | 78.6369 deg at `mos_ss_-40C_1.32V` | 45/45 valid | `sim/open-loop-ac/records/20260910-221601-22feaba.csv` col `pm_deg` (`dd71064b760d`) | **PASS** |
| Slew rate (into stated CL = 2 pF) | ≥ 7.51 V/µs | `spec/decision-records/0002-target-spec-ratification.md` [DR-2] | CL = 2 pF [DR-1], no resistive load; large-signal step, input common mode Vcm = VDD/2, ±0.3 V-per-input antiphase drive, measured in the VDD/2 ± 0.15 V window; worse of the rising and falling edge per point | 7.51441 V/µs at `mos_ss_-40C_1.08V` | 7.51 V/µs (raw margin 0.00441; strict literal pass) | 9.90983 V/µs at `mos_ff_125C_1.32V` | 45/45 valid | `sim/slew-rate/records/20260918-210216-90844d2.csv` col `sr_worst_v_per_us` (`025cbee18bf3`) | **PASS** |
| Input-referred noise (100 Hz – 1 MHz integrated) | ≤ 108.9 µVrms | `spec/decision-records/0002-target-spec-ratification.md` [DR-2] | CL = 2 pF [DR-1], no resistive load; unity-gain closed-loop .noise analysis, integrated over 100 Hz – 1 MHz (the band is part of the number); nominal devices, ideal ibias contributes no noise | 108.949 µVrms at `mos_fs_125C_1.08V` | 108.9 µVrms (raw margin -0.049; strict literal FAIL) | 73.3562 µVrms at `mos_ff_-40C_1.32V` | 45/45 valid | `sim/input-noise/records/20260918-203850-90844d2.csv` col `vni_int_vrms` (`1841f63b5197`) | **PASS** |
| Input-referred offset — systematic (deterministic, corner-only) | ≤ 21.9 mV | `spec/decision-records/0002-target-spec-ratification.md` [DR-2] | CL = 2 pF [DR-1] attached (a DC analysis ignores it), no resistive load; DC, Vcm = VDD/2, perfectly matched (nominal) devices; magnitude of the null-method offset, cross-checked per point by a closed-loop method (xcheck_pass) | 21.9273527 mV at `mos_fs_125C_1.08V` | 21.9 mV (raw margin -0.0273527; strict literal FAIL) | 11.4304056 mV at `mos_sf_-40C_1.32V` | 45/45 valid | `sim/input-offset/records/20260918-203858-90844d2.csv` col `vos_null_v` (`f0263167c6b5`) | **PASS** |
| CMRR — mismatch-inclusive (+3σ of Acm, linear domain) | ≥ 26.68 dB | `spec/decision-records/0004-cmrr-mismatch-inclusive-ratification.md` [DR-4] | CL = 2 pF [DR-1], no resistive load; per point: joined open-loop Av0 minus the +3σ point of the 300-draw common-mode-gain distribution, mean + 3σ taken in the LINEAR domain (DR-0004); SG13G2 per-corner mismatch decks + process corners; DC shelf | 26.6826 dB at `mos_ss_-40C_1.08V` | 26.68 dB (raw margin 0.0026; strict literal pass) | 37.57 dB at `mos_ss_125C_1.08V` | 45/45 valid | `sim/cmrr-mismatch/records/20260921-172304-65f5fb4.csv` col `cmrr_3sigma_db` (`d64d9b3a39b9`) | **PASS** |
| PSRR+ (DC shelf) | ≥ 1.87 dB | `spec/decision-records/0002-target-spec-ratification.md` [DR-2] | CL = 2 pF [DR-1], no resistive load; joined open-loop Av0 divided by the VDD-to-output gain (PSRR+; vss is ground), DC shelf (10 mHz read); ideal external 10 µA ibias contributes no supply ripple. Strongly frequency-dependent: the in-band figure below is part of the ratified number's context | 1.8709 dB at `mos_ff_125C_1.32V` | 1.87 dB (raw margin 0.0009; strict literal pass) | 29.5448 dB at `mos_ss_-40C_1.08V` | 45/45 valid | `sim/cmrr-psrr/records/20260921-151815-707b34c.csv` col `psrr_db` (`ede23361c795`) | **PASS** |
| Output swing — headroom from VDD | ≥ 251 mV | `spec/decision-records/0002-target-spec-ratification.md` [DR-2] | CL = 2 pF [DR-1], NO resistive load (an upper bound; a loaded-row decision is separate); open-loop differential DC transfer curve, −6 dB incremental-gain criterion | 251.491128 mV at `mos_fs_-40C_1.08V` | 251 mV (raw margin 0.491128; strict literal pass) | 319.0598 mV at `mos_ss_125C_1.32V` | 45/45 valid | `sim/output-swing/records/20260921-151759-707b34c.csv` col `headroom_hi_v` (`d84349f59b65`) | **PASS** |
| Output swing — headroom from VSS | ≥ 141 mV | `spec/decision-records/0002-target-spec-ratification.md` [DR-2] | CL = 2 pF [DR-1], NO resistive load (an upper bound; a loaded-row decision is separate); open-loop differential DC transfer curve, −6 dB incremental-gain criterion | 141.167273 mV at `mos_ff_-40C_1.08V` | 141 mV (raw margin 0.167273; strict literal pass) | 223.073866 mV at `mos_ss_125C_1.32V` | 45/45 valid | `sim/output-swing/records/20260921-151759-707b34c.csv` col `headroom_lo_v` (`d84349f59b65`) | **PASS** |
| Output swing — tracking span | ≥ 0.571 V | `spec/decision-records/0002-target-spec-ratification.md` [DR-2] | CL = 2 pF [DR-1], NO resistive load (an upper bound; a loaded-row decision is separate); open-loop differential DC transfer curve, −6 dB incremental-gain criterion | 0.570957773 V at `mos_ss_125C_1.08V` | 0.571 V (raw margin -0.000042227; strict literal FAIL) | 0.900091812 V at `mos_ff_-40C_1.32V` | 45/45 valid | `sim/output-swing/records/20260921-151759-707b34c.csv` col `swing_span_v` (`d84349f59b65`) | **PASS** |
| Quiescent power (total VDD current Iq) | ≤ 119.7 µA | `spec/decision-records/0002-target-spec-ratification.md` [DR-2] | CL = 2 pF [DR-1] attached (DC operating point), no resistive load; total VDD current at the open-loop bench's DC operating point, INCLUDING the external 10 µA ibias reference | 119.655 µA at `mos_ss_-40C_1.32V` | 119.7 µA (raw margin 0.045; strict literal pass) | 99.8521 µA at `mos_ss_125C_1.08V` | 45/45 valid | `sim/open-loop-ac/records/20260910-221601-22feaba.csv` col `ivdd_total_a` (`dd71064b760d`) | **PASS** |

- **Slew rate (into stated CL = 2 pF)**
  - rising edge alone, worst: 7.53778 V/µs at `mos_ss_-40C_1.08V`
  - falling edge alone, worst: 7.51441 V/µs at `mos_ss_-40C_1.08V`
- **Input-referred noise (100 Hz – 1 MHz integrated)**
  - spot density @ 100 Hz, worst: 3.47626 µV/√Hz at `mos_fs_125C_1.08V`
  - spot density @ 1 kHz, worst: 1099.59 nV/√Hz at `mos_fs_125C_1.08V`
  - spot density @ 1 MHz, worst: 44.2529 nV/√Hz at `mos_fs_125C_1.08V`
- **Input-referred offset — systematic (deterministic, corner-only)**
  - largest disagreement between the two methods: 0.3037413 mV at `mos_fs_125C_1.08V`
- **CMRR — mismatch-inclusive (+3σ of Acm, linear domain)**
  - worst single drawn sample (dB-domain minimum, not the ratified statistic): 25.942 dB at `mos_ss_-40C_1.08V`
  - worst +3σ figure at 1 kHz: 26.6844 dB at `mos_ss_-40C_1.08V`
- **PSRR+ (DC shelf)**
  - in-band PSRR+ at 1 kHz, worst: 1.2998 dB at `mos_sf_-40C_1.32V`
- **Quiescent power (total VDD current Iq)**
  - signal-path-only current (excl. ibias), worst: 109.655 µA at `mos_ss_-40C_1.32V`

## Superseded ratified bound (context, not binding)

| Row | Bound | Decision record | Load / conditions | Worst measured (binding point) | Compared at bound precision | Best measured | Grid coverage | Source record (sha256) | Verdict |
|---|---|---|---|---|---|---|---|---|---|
| CMRR — systematic nominal-device floor (superseded by DR-4, context) | ≥ 30.75 dB | `spec/decision-records/0002-target-spec-ratification.md` [DR-2, superseded by DR-4] | CL = 2 pF [DR-1], no resistive load; perfectly matched devices; joined open-loop Av0 divided by the in-phase common-mode gain; DC shelf (10 mHz read) | 30.7505 dB at `mos_fs_125C_1.08V` | 30.75 dB (raw margin 0.0005; strict literal pass) | 62.8322 dB at `mos_fs_-40C_1.08V` | 45/45 valid | `sim/cmrr-psrr/records/20260921-151815-707b34c.csv` col `cmrr_db` (`ede23361c795`) | **PASS** |

## Measured, NOT ratified (no pass/fail verdict)

| Row | Status / tag | Load / conditions | Worst measured (point) | Best measured | Grid coverage | Source record (sha256) | Verdict |
|---|---|---|---|---|---|---|---|
| Input-referred offset — mismatch-driven random 3σ (measured [P], not ratified) | [P (DR-0002 residual (b), re-ratification pending)] | CL = 2 pF [DR-1] attached (a DC analysis ignores it), no resistive load; device-mismatch Monte Carlo, N = 300 draws per point, campaign seed 20260921; SG13G2 <corner>_mismatch sections layered on the process corners; FIXED 1.20 V supply | 27.3996487 mV at `mos_ss_mismatch_125C_1.20V` | 26.4320349 mV at `mos_ff_mismatch_-40C_1.20V` | 16/16 valid | `sim/input-offset/records/mc-20260921-174056-0a509fb.csv` col `three_sigma_v` (`aaf45e4d1e6f`) | **MEASURED** |
| Input-referred offset — worst single-PVT \|systematic\| + 3σ (measured [P], not ratified) | [P (DR-0002 residual (b), re-ratification pending)] | CL = 2 pF [DR-1] attached (a DC analysis ignores it), no resistive load; per point: \|systematic offset at the same corner/temperature, 1.20 V\| + 3σ of the drawn distribution; FIXED 1.20 V supply | 46.6868332 mV at `mos_fs_mismatch_125C_1.20V` | 38.892429 mV at `mos_sf_mismatch_-40C_1.20V` | 16/16 valid | `sim/input-offset/records/mc-20260921-174056-0a509fb.csv` col `vos_total_wc_det_plus_3sigma_v` (`aaf45e4d1e6f`) | **MEASURED** |
| Input common-mode range — span (measured, not ratified) | [P (pre-dates ratification, not part of DR-2)] | CL = 2 pF [DR-1], no resistive load; open-loop common-mode sweep, differential input pinned at zero; lower bound at the measured Vdsat(M5) knee (m5_headroom), upper bound at pair saturation (pair_saturation); nominal matched devices | 0.253205764 V at `mos_ss_125C_1.08V` | 0.676870423 V at `mos_ff_-40C_1.32V` | 45/45 valid | `sim/input-cmr/records/20260921-174405-65f5fb4.csv` col `icmr_span_v` (`d625dc59a5c5`) | **MEASURED** |
| Input common-mode range — lower bound (measured, not ratified) | [P (pre-dates ratification, not part of DR-2)] | CL = 2 pF [DR-1], no resistive load; worst (highest) lower common-mode bound, m5_headroom criterion | 0.640129553 V at `mos_ss_-40C_1.08V` | 0.470431235 V at `mos_ff_125C_1.32V` | 45/45 valid | `sim/input-cmr/records/20260921-174405-65f5fb4.csv` col `icmr_lo_v` (`d625dc59a5c5`) | **MEASURED** |
| Input common-mode range — upper bound (measured, not ratified) | [P (pre-dates ratification, not part of DR-2)] | CL = 2 pF [DR-1], no resistive load; worst (lowest) upper common-mode bound, pair_saturation criterion | 0.795393113 V at `mos_fs_125C_1.08V` | 1.25120811 V at `mos_sf_-40C_1.32V` | 45/45 valid | `sim/input-cmr/records/20260921-174405-65f5fb4.csv` col `icmr_hi_v` (`d625dc59a5c5`) | **MEASURED** |

- **Input-referred offset — mismatch-driven random 3σ (measured [P], not ratified)**
  - σ(Vos), smallest: 8.81067829 mV at `mos_ff_mismatch_-40C_1.20V`
  - σ(Vos), largest: 9.13321623 mV at `mos_ss_mismatch_125C_1.20V`
  - negative control (plain section, zero mismatch) σ(Vos): 1.73762193E-14 mV at `mos_tt_negctrl_27C_1.20V`
- **Input common-mode range — span (measured, not ratified)**
  - points where the measured range excludes the nominal Vcm = VDD/2: 15 of 45

## Pending (no evidence by construction)

- **Area** [TBD-12 (DR-0002 residual (a))] — PENDING: a post-layout property with no ratified bound and no bench; stays pending until its own decision record (DR-0002 residual (a))

## Caveats that travel with these numbers

- Offset Monte Carlo (input-offset-mc) was run at a FIXED 1.20 V supply only: five <corner>_mismatch sections x {-40, 27, 125} degC. The supply axis (1.08 V / 1.32 V) is covered only by the deterministic systematic-offset record; no statistical figure here is a statement about 1.08 V or 1.32 V.
- Systematic and statistical offset are distinct evidence: the ratified bound is the systematic (nominal-device) half [DR-2]; the mismatch-driven 3σ half is measured [P] and is not ratified (DR-0002 residual (b), pending its own two-key pass). This report does not combine them into a ratified total.
- The CMRR row is ratified on its mismatch-inclusive figure [DR-4], whose definition (Av0 minus the +3σ point of the drawn-Acm distribution, mean + 3σ in the LINEAR domain, N = 300 + process corners) is part of the number. This report reads that per-point figure from the record and re-derives it from the record's own linear mean and σ (definition check cmrr_linear_3sigma); it never aggregates in the dB domain. The superseded systematic floor is shown as context only.
- Output swing is unloaded (CL = 2 pF, no resistive load): an upper bound. PSRR+ is ratified at the DC shelf and is strongly frequency-dependent.
- Every measured row comes from nominal-device deterministic benches except the two Monte Carlo records (offset, CMRR); no other row carries a statistical basis.

## What this report is not

- Not item 5 or item 6 evidence: it is a generic, offline aggregation of harness-native records, not a `klt sim` or `klt yield` envelope, and the signoff manifest cites it for item 8 only.
- Not a re-run: regenerating this report re-reads committed records; it does not re-simulate anything. Re-running the benches is the separate cold-start procedure in each sim/ bench README.
- Not a claim that every T1 item is satisfied; post-layout (PEX) re-simulation does not exist yet, so every number here is pre-layout.

## Sources and environment

Simulator pin: `ngspice-46`; PDK pin: IHP-GmbH/IHP-Open-PDK v0.3.0 (`sim/pdk.json`); design netlist `design/netlist/opamp_core.spice` (normalized `c71347288feb`). every selected record must name this ngspice and must have simulated this netlist (comment/blank lines ignored); a mismatch is an error, never a silent mix.

| Record | CSV (sha256) | MD (sha256) | ngspice | Grid | Expected | Observed | Valid |
|---|---|---|---|---|---|---|---|
| cmrr-mismatch | `sim/cmrr-mismatch/records/20260921-172304-65f5fb4.csv` (`d64d9b3a39b9`) | `sim/cmrr-mismatch/records/20260921-172304-65f5fb4.md` (`aa0a4104a5eb`) | ngspice-46 | pvt45 | 45 | 45 | 45 |
| cmrr-psrr | `sim/cmrr-psrr/records/20260921-151815-707b34c.csv` (`ede23361c795`) | `sim/cmrr-psrr/records/20260921-151815-707b34c.md` (`c3a2755afbb6`) | ngspice-46 | pvt45 | 45 | 45 | 45 |
| input-cmr | `sim/input-cmr/records/20260921-174405-65f5fb4.csv` (`d625dc59a5c5`) | `sim/input-cmr/records/20260921-174405-65f5fb4.md` (`f1643ab3ff4c`) | ngspice-46 | pvt45 | 45 | 45 | 45 |
| input-noise | `sim/input-noise/records/20260918-203850-90844d2.csv` (`1841f63b5197`) | `sim/input-noise/records/20260918-203850-90844d2.md` (`6c64198791c1`) | ngspice-46 | pvt45 | 45 | 45 | 45 |
| input-offset | `sim/input-offset/records/20260918-203858-90844d2.csv` (`f0263167c6b5`) | `sim/input-offset/records/20260918-203858-90844d2.md` (`9c4a9e4e325b`) | ngspice-46 | pvt45 | 45 | 45 | 45 |
| input-offset-mc | `sim/input-offset/records/mc-20260921-174056-0a509fb.csv` (`aaf45e4d1e6f`) | `sim/input-offset/records/mc-20260921-174056-0a509fb.md` (`b007656df04e`) | ngspice-46 | offset_mc15 | 16 | 16 | 16 |
| open-loop-ac | `sim/open-loop-ac/records/20260910-221601-22feaba.csv` (`dd71064b760d`) | `sim/open-loop-ac/records/20260910-221601-22feaba.md` (`01988711eec6`) | ngspice-46 | pvt45 | 45 | 45 | 45 |
| output-swing | `sim/output-swing/records/20260921-151759-707b34c.csv` (`d84349f59b65`) | `sim/output-swing/records/20260921-151759-707b34c.md` (`5fe5cfc2c58b`) | ngspice-46 | pvt45 | 45 | 45 | 45 |
| slew-rate | `sim/slew-rate/records/20260918-210216-90844d2.csv` (`025cbee18bf3`) | `sim/slew-rate/records/20260918-210216-90844d2.md` (`d3e278ad4438`) | ngspice-46 | pvt45 | 45 | 45 | 45 |

Spec section 2 rows covered: Open-loop DC gain, GBW (into stated CL = 2 pF [DR-1], above), Phase margin (at GBW, same CL), Slew rate (into stated CL = 2 pF [DR-1], above), Input-referred noise (band: **100 Hz – 1 MHz integrated**, plus spot densities; same stated CL = 2 pF [DR-1]), Input-referred offset, CMRR, PSRR, Input common-mode range (ICMR), Output swing, Quiescent power, Area.
Item 9 inventory rows covered: CMRR (mismatch-inclusive), CMRR (systematic floor), GBW (CL = 2 pF), Input common-mode range, Input offset (3 sigma, MC), Input offset (systematic), Input-referred noise, Open-loop DC gain, Output swing, PSRR (DC shelf), Phase margin, Quiescent power, Slew rate (CL = 2 pF).
