2AMLogic/sg13g2-opamp/sim/open-loop-ac/records/20261015-103057-895d555.md

# open-loop-ac record 20261015-103057-895d555 (inn AC-grounded)

Generated by `sim/open-loop-ac/run_klt_record.sh` (issue #241) against `design/netlist/opamp_core.spice` (snapshot: `netlist-snapshots/20261015-103057-895d555/opamp_core.spice`) through `klt sim` on the batch fleet, with the bench's `Cinn_acgnd inn vss 1` (1 F AC ground on `inn`) next to `Lbreak = 1e18 H`. Grid: cornerMOSlv.lib `mos_tt/ss/ff/sf/fs` [DR-1] x `{-40, 27, 125} C` x `{1.08, 1.20, 1.32} V` = 45 points, into `CL = 2e-12 F` [DR-1].

Batch jobs: ac `klt-sim-2e841aaa76e0` (done), op `klt-sim-15dd509f5239` (done).

**Supersedes** (does not edit) `records/20260910-221601-22feaba.*`, which measured with `inn` AC-floating (`Lbreak` only). Do not cite that record's GBW or PM.

## Rows against the ratified bounds (45 corners)

| row | bound | worst | at corner | corners failing | verdict |
|---|---|---|---|---|---|
| av0_db | >= 37.8 dB | 38.2293 | mos_fs_125C_1.08V | 0 of 45 | PASS |
| gbw_hz | >= 4.74e+06 Hz | 8.06239e+06 | mos_ss_-40C_1.08V | 0 of 45 | PASS |
| pm_deg | >= 60 deg | 61.9872 | mos_ff_125C_1.32V | 0 of 45 | PASS |
| iq_a | <= 0.0001197 A | 0.000119655 | mos_ss_-40C_1.32V | 0 of 45 | PASS |

## Shift against the superseded floating-inn record

| row | min change | max change | unit |
|---|---|---|---|
| av0_db | +0.2199 | +1.785 | dB |
| gbw_hz | +2.043 | +7.149 | MHz |
| pm_deg | -14.38 | -4.154 | deg |
| iq_a | -0.0004926 | +0.0004956 | uA |

Per-point data: `records/20261015-103057-895d555.csv`. Raw envelopes and requests: `corners/20261015-103057-895d555/`.
