2AMLogic/sg13g2-opamp/sim/fingering-probe/records/20261015-081352-9a66a66.md

# Device-representation probe 20261015-081352-9a66a66 (issue #237)

Bench: the committed post-layout open-loop AC bench (`sim/post-layout/measure_openloop_ac.sh`), CL = 2 pF [DR-1], 10 uA external ibias, Iq = total Vdd current including ibias.
Grid: `mos_tt:27:1.20 mos_ss:27:1.20 mos_ff:27:1.20 mos_sf:27:1.20 mos_fs:27:1.20` (5 corners), run through `klt sim` on the batch fleet (job ids below).
Variants: see `../README.md`. Netlists: `../netlist-snapshots/20261015-081352-9a66a66/`; envelopes: `../corners/20261015-081352-9a66a66/`.

## Values

| corner | variant | Av0 (dB) | GBW (MHz) | PM (deg) | Iq (uA) |
|---|---|---:|---:|---:|---:|
| mos_ff/1.20V/27C | lumped | 41.998 | 5.6409 | 77.418 | 109.456 |
| mos_ff/1.20V/27C | drawn | 45.259 | 5.8928 | 76.099 | 82.247 |
| mos_ff/1.20V/27C | expanded | 45.259 | 5.8774 | 76.002 | 82.247 |
| mos_ff/1.20V/27C | extracted_nopar | 45.259 | 5.8777 | 76.035 | 82.247 |
| mos_ff/1.20V/27C | extracted | 46.709 | 7.1576 | 76.164 | 82.237 |
| mos_fs/1.20V/27C | lumped | 41.454 | 5.4924 | 77.868 | 109.512 |
| mos_fs/1.20V/27C | drawn | 44.713 | 5.7240 | 76.403 | 81.860 |
| mos_fs/1.20V/27C | expanded | 44.713 | 5.7084 | 76.306 | 81.860 |
| mos_fs/1.20V/27C | extracted_nopar | 44.713 | 5.7087 | 76.342 | 81.860 |
| mos_fs/1.20V/27C | extracted | 47.620 | 6.9317 | 76.566 | 81.850 |
| mos_sf/1.20V/27C | lumped | 42.908 | 5.6081 | 77.549 | 109.837 |
| mos_sf/1.20V/27C | drawn | 46.172 | 5.8330 | 76.146 | 81.022 |
| mos_sf/1.20V/27C | expanded | 46.172 | 5.8169 | 76.051 | 81.022 |
| mos_sf/1.20V/27C | extracted_nopar | 46.172 | 5.8172 | 76.086 | 81.022 |
| mos_sf/1.20V/27C | extracted | 48.845 | 7.0136 | 76.319 | 81.011 |
| mos_ss/1.20V/27C | lumped | 43.047 | 5.7863 | 77.285 | 109.687 |
| mos_ss/1.20V/27C | drawn | 46.421 | 5.9877 | 75.686 | 80.385 |
| mos_ss/1.20V/27C | expanded | 46.421 | 5.9707 | 75.588 | 80.385 |
| mos_ss/1.20V/27C | extracted_nopar | 46.421 | 5.9711 | 75.624 | 80.385 |
| mos_ss/1.20V/27C | extracted | 45.089 | 7.0311 | 75.938 | 80.375 |
| mos_tt/1.20V/27C | lumped | 41.950 | 5.4891 | 77.835 | 109.700 |
| mos_tt/1.20V/27C | drawn | 45.249 | 5.7143 | 76.421 | 81.492 |
| mos_tt/1.20V/27C | expanded | 45.249 | 5.6985 | 76.326 | 81.492 |
| mos_tt/1.20V/27C | extracted_nopar | 45.249 | 5.6988 | 76.361 | 81.492 |
| mos_tt/1.20V/27C | extracted | 49.681 | 6.9104 | 76.611 | 81.482 |

## Step deltas (percent, min..max over the corners)

| step | from -> to | Av0 | GBW | PM | Iq |
|---|---|---:|---:|---:|---:|
| representation | lumped -> drawn | +7.61..+7.87 | +3.48..+4.47 | -2.07..-1.70 | -26.71..-24.86 |
| expansion | drawn -> expanded | -0.00..-0.00 | -0.28..-0.26 | -0.13..-0.12 | +0.00..+0.00 |
| diffusion | expanded -> extracted_nopar | +0.00..+0.00 | +0.01..+0.01 | +0.04..+0.05 | -0.00..-0.00 |
| parasitics | extracted_nopar -> extracted | -2.87..+9.79 | +17.75..+21.77 | +0.17..+0.42 | -0.01..-0.01 |
| pex_236 | lumped -> extracted | +4.75..+18.43 | +21.51..+26.89 | -1.74..-1.57 | -26.72..-24.87 |
| pex_drawn | drawn -> extracted | -2.87..+9.79 | +17.43..+21.46 | +0.09..+0.33 | -0.01..-0.01 |

## Batch jobs

| variant | AC job | OP job |
|---|---|---|
| lumped | klt-sim-35b63643125b | klt-sim-5511e8898865 |
| drawn | klt-sim-5f32b3d77bda | klt-sim-ad13f1344cb1 |
| expanded | klt-sim-81103558e009 | klt-sim-9b6a17597950 |
| extracted_nopar | klt-sim-3dc5cf13e1d9 | klt-sim-83ad7e3289f5 |
| extracted | klt-sim-4742c77a79c4 | klt-sim-10379a87fefc |
