2AMLogic/sg13g2-opamp/sim/fingering-probe/records/20261015-083637-cefcca1.md

# Device-representation probe 20261015-083637-cefcca1 (issue #237)

Probe set: `innac` -- every DUT has inn AC-grounded by 1 F (bench loop-break diagnostic).

Bench: the committed post-layout open-loop AC bench (`sim/post-layout/measure_openloop_ac.sh`), CL = 2 pF [DR-1], 10 uA external ibias, Iq = total Vdd current including ibias.
Grid: `mos_tt:27:1.20 mos_ss:27:1.20 mos_ff:27:1.20 mos_sf:27:1.20 mos_fs:27:1.20` (5 corners), run through `klt sim` on the batch fleet (job ids below).
Variants: see `../README.md`. Netlists: `../netlist-snapshots/20261015-083637-cefcca1/`; envelopes: `../corners/20261015-083637-cefcca1/`.

## Values

| corner | variant | Av0 (dB) | GBW (MHz) | PM (deg) | Iq (uA) |
|---|---|---:|---:|---:|---:|
| mos_ff/1.20V/27C | lumped_innac | 42.892 | 11.7285 | 63.798 | 109.456 |
| mos_ff/1.20V/27C | drawn_innac | 46.702 | 12.0296 | 61.783 | 82.247 |
| mos_ff/1.20V/27C | extracted_nopar_innac | 46.702 | 11.9841 | 61.678 | 82.247 |
| mos_ff/1.20V/27C | extracted_innac | 46.703 | 11.9354 | 61.160 | 82.237 |
| mos_fs/1.20V/27C | lumped_innac | 42.332 | 11.3009 | 64.905 | 109.512 |
| mos_fs/1.20V/27C | drawn_innac | 46.090 | 11.5822 | 62.591 | 81.860 |
| mos_fs/1.20V/27C | extracted_nopar_innac | 46.090 | 11.5371 | 62.488 | 81.860 |
| mos_fs/1.20V/27C | extracted_innac | 46.091 | 11.4893 | 61.978 | 81.850 |
| mos_sf/1.20V/27C | lumped_innac | 43.874 | 11.2702 | 64.809 | 109.837 |
| mos_sf/1.20V/27C | drawn_innac | 47.716 | 11.5402 | 62.621 | 81.022 |
| mos_sf/1.20V/27C | extracted_nopar_innac | 47.716 | 11.4950 | 62.517 | 81.022 |
| mos_sf/1.20V/27C | extracted_innac | 47.718 | 11.4475 | 61.990 | 81.011 |
| mos_ss/1.20V/27C | lumped_innac | 43.752 | 10.9236 | 65.785 | 109.687 |
| mos_ss/1.20V/27C | drawn_innac | 47.516 | 11.1365 | 63.359 | 80.385 |
| mos_ss/1.20V/27C | extracted_nopar_innac | 47.516 | 11.0959 | 63.248 | 80.385 |
| mos_ss/1.20V/27C | extracted_innac | 47.517 | 11.0535 | 62.725 | 80.375 |
| mos_tt/1.20V/27C | lumped_innac | 42.873 | 11.1788 | 65.061 | 109.700 |
| mos_tt/1.20V/27C | drawn_innac | 46.720 | 11.4663 | 62.807 | 81.492 |
| mos_tt/1.20V/27C | extracted_nopar_innac | 46.720 | 11.4214 | 62.705 | 81.492 |
| mos_tt/1.20V/27C | extracted_innac | 46.722 | 11.3740 | 62.190 | 81.482 |

## Step deltas (percent, min..max over the corners)

| step | from -> to | Av0 | GBW | PM | Iq |
|---|---|---:|---:|---:|---:|
| representation | lumped_innac -> drawn_innac | +8.60..+8.97 | +1.95..+2.57 | -3.69..-3.16 | -26.71..-24.86 |
| expansion+diffusion | drawn_innac -> extracted_nopar_innac | -0.00..-0.00 | -0.39..-0.36 | -0.17..-0.16 | +0.00..+0.00 |
| parasitics | extracted_nopar_innac -> extracted_innac | +0.00..+0.00 | -0.41..-0.38 | -0.84..-0.81 | -0.01..-0.01 |
| pex_236 | lumped_innac -> extracted_innac | +8.61..+8.98 | +1.19..+1.76 | -4.65..-4.13 | -26.72..-24.87 |
| pex_drawn | drawn_innac -> extracted_innac | +0.00..+0.00 | -0.81..-0.74 | -1.01..-0.98 | -0.01..-0.01 |

## Batch jobs

| variant | AC job | OP job |
|---|---|---|
| lumped_innac | klt-sim-b59469097c59 | klt-sim-b764d02b0b11 |
| drawn_innac | klt-sim-06bc9346185d | klt-sim-ab40cf965f1f |
| extracted_nopar_innac | klt-sim-e464451b968b | klt-sim-1362f8f427fc |
| extracted_innac | klt-sim-df48dac48712 | klt-sim-fc3e409cbd9b |
