2AMLogic/sg13g2-opamp/sim/input-offset/records/mc-20260921-174056-0a509fb.md

# input-offset Monte Carlo record mc-20260921-174056-0a509fb

Generated by `sim/input-offset/run_offset_mc.sh` (issue #17, the statistical
basis `spec/target-spec.md`'s offset row and gap-to-T1 tracker #3 item 6
track) against `design/netlist/opamp_core.spice` (snapshot:
`netlist-snapshots/mc-20260921-174056-0a509fb/opamp_core.spice`), `ngspice-46`, PDK
`ihp-sg13g2` rooted at `/Users/rwalters/share/pdk` (pin: `sim/pdk.json`), OSDI models from
`/Users/rwalters/share/pdk/ihp-sg13g2/libs.tech/ngspice/osdi` (built by `sim/tools/build-osdi.sh`).

Device-mismatch Monte Carlo **combined with (not instead of) process
corners**: every draw runs cornerMOSlv.lib's `<corner>_mismatch` section --
the same deterministic process-corner parameters as the plain section, plus
per-instance zero-mean `agauss()` mismatch draws (delvto / factuo / w / l,
area-scaled by 1/sqrt(m*l*w*1e12)). **Campaign seed `20260921`, N = 300 draws
per point**, per-draw seed = base + draw index, every draw's own seed
recorded in `records/mc-20260921-174056-0a509fb-draws.csv`, seeded via `setseed` +
`reset` in .control -- see `testbench/tb_offset_mc.spice.tmpl`'s header for
why that mechanism (and not a netlist-level option line) is the one that
reaches this deck's instance-parameter draws (directly verified below).

Grid: **the five corner families `mos_tt/ss/ff/sf/fs` [DR-1] x {-40, 27,
125} °C at the fixed nominal 1.20 V supply** = 15 mismatch points, **plus a
deterministic negative control** at the nominal point (`mos_tt` plain
section, identical seed sequence). Supply is the PVT axis held fixed: issue
#11's deterministic record already covers every (corner, temperature) at
all three supplies, and random-vs-supply interaction is not an evidence
class issue #17 names -- the same scope argument `sg13g2-bandgap`'s
`sim/closed-loop-vref-mc` landed on this PDK. Each corner family is drawn
N = 300 >= 300 times at EACH of its three temperatures, so the row's
"N>=300 per corner" basis holds everywhere it is claimed.

## Campaign self-verification (hard gates -- all passed)

- **Seed determinism**: a duplicated draw (same seed, separate ngspice
  invocation) came out **bit-identical**; re-running the campaign with
  `--seed 20260921 --n 300` on this commit reproduces it.
- **Negative-control zero spread**: all 300 plain-section draws produced
  exactly `0.015714074799999998 V` -- no draw expressions exist in the plain deck,
  so any spread would be a harness bug.
- **Negative-control anchor**: that figure reproduces issue #11's committed
  fine-pass Vos at `mos_tt_27C_1.20V` (`0.0157152476 V`) to within
  1.1728e-06 V (gate 5e-5 V) -- the MC harness reproduces the
  deterministic record's figure with mismatch disabled.

Machine-readable gate output: `corners/mc-20260921-174056-0a509fb/sanity_checks.txt`.

## Summary (mismatch points; Vos in V, sign per issue #11's convention)

| Point @ 1.20 V | n_pass/total | mean Vos | sigma | 3-sigma | w.c. total (|sys|+3σ) |
|---|---|---|---|---|---|
| `mos_tt_mismatch_-40C_1.20V` | 300/300 | 0.013558155 | 0.00883139207 | 0.0264941762 | 0.0400048024 |
| `mos_tt_mismatch_27C_1.20V` | 300/300 | 0.0157415738 | 0.00892011897 | 0.0267603569 | 0.0424756045 |
| `mos_tt_mismatch_125C_1.20V` | 300/300 | 0.0185309698 | 0.00905177811 | 0.0271553343 | 0.0456846715 |
| `mos_ss_mismatch_-40C_1.20V` | 300/300 | 0.013051434 | 0.00883402068 | 0.026502062 | 0.0395055651 |
| `mos_ss_mismatch_27C_1.20V` | 300/300 | 0.0153739835 | 0.00895674632 | 0.026870239 | 0.0422233126 |
| `mos_ss_mismatch_125C_1.20V` | 300/300 | 0.0184185997 | 0.00913321623 | 0.0273996487 | 0.0458280274 |
| `mos_ff_mismatch_-40C_1.20V` | 300/300 | 0.0130586327 | 0.00881067829 | 0.0264320349 | 0.039439601 |
| `mos_ff_mismatch_27C_1.20V` | 300/300 | 0.0150215921 | 0.00888736287 | 0.0266620886 | 0.0416513375 |
| `mos_ff_mismatch_125C_1.20V` | 300/300 | 0.0175269086 | 0.00900254927 | 0.0270076478 | 0.0445246607 |
| `mos_sf_mismatch_-40C_1.20V` | 300/300 | 0.012453722 | 0.00882860821 | 0.0264858246 | 0.038892429 |
| `mos_sf_mismatch_27C_1.20V` | 300/300 | 0.0144565798 | 0.00893316361 | 0.0267994908 | 0.0412320648 |
| `mos_sf_mismatch_125C_1.20V` | 300/300 | 0.0170152792 | 0.00908698247 | 0.0272609474 | 0.044278481 |
| `mos_fs_mismatch_-40C_1.20V` | 300/300 | 0.0141157068 | 0.00883175191 | 0.0264952557 | 0.0405618517 |
| `mos_fs_mismatch_27C_1.20V` | 300/300 | 0.0164729471 | 0.0089146486 | 0.0267439458 | 0.0431885835 |
| `mos_fs_mismatch_125C_1.20V` | 300/300 | 0.0195777412 | 0.00903743117 | 0.0271122935 | 0.0466868332 |

- **Worst-case mismatch 3σ: `0.0273996487 V` at `mos_ss_mismatch_125C_1.20V`.**
- **Worst-case total offset (deterministic systematic + 3σ, the figure a
  real part's offset budget carries at a single PVT point):
  `0.0466868332 V` at `mos_fs_mismatch_125C_1.20V`.**
- Largest deviation of any point's MC sample mean from the deterministic
  systematic at the same (corner, temp): `5.10666e-05 V` (`mos_ff_mismatch_-40C_1.20V`) --
  consistent with the sampling error of a 300-draw zero-mean population
  (sigma/sqrt(N)), not a harness bias.

Per-point systematic values (`vos_systematic_det_v`) join
`records/20260918-203858-90844d2.csv` (issue #11) at the same corner/temp/1.20 V
point ids.

## Method (per draw), and what this record does not claim

One draw = one single-pass **coarse** null sweep of the same open-loop
method as issue #11's primary measurement (Vid over ±100 mV at 500 µV,
exactly one Vout = Vcm crossing required, comfortably inside the window).
The deterministic record's committed `vos_coarse_fine_delta_v` column
bounds the coarse-vs-fine null delta at ≤ 2.4 µV across all 45 of its
points -- three orders of magnitude below the mismatch term measured here
-- so the per-draw fine re-sweep is deliberately omitted (stated,
justified deviation, anchored by that committed evidence column).

**Pre-layout, schematic-level**: the DUT is the committed
`design/netlist/opamp_core.spice`; no layout parasitics are drawn. This is
**[P]-tagged measured evidence** for the offset row's statistical-basis
column: DR-0002 ratified the row's systematic term, and this record plus
the row's mismatch cells stay `[P]` until the 0002 residual-(c)
re-ratification pass binds them (the same disposition
`sim/cmrr-mismatch/`'s issue-#26 campaign carries for the CMRR row). The
3σ figure is a property of THIS topology's
device sizes against THIS PDK's mismatch deck
(`sg13g2_moslv_mod_mismatch.lib`, one-sigma delvto 3.9 mV nmos / 2.2 mV
pmos before area scaling) at the sampled PVT points only -- it transfers
to neither another topology nor another PDK.

Full per-draw table (point, mode, draw index, per-draw seed, status,
per-draw Vos): `records/mc-20260921-174056-0a509fb-draws.csv`. Per-point digest:
`records/mc-20260921-174056-0a509fb.csv`. Representative draw-0 netlist + log per point plus
the frozen DUT snapshot: `netlist-snapshots/mc-20260921-174056-0a509fb/` and
`corners/mc-20260921-174056-0a509fb/` (the per-draw population is deliberately not
committed -- see README.md "Evidence volume").
