2AMLogic/sg13g2-opamp/sim/input-cmr/records/20260921-174405-65f5fb4.md

# input-cmr record 20260921-174405-65f5fb4

Generated by `sim/input-cmr/run_cmr_sweep.sh` against
`design/netlist/opamp_core.spice` (snapshot:
`netlist-snapshots/20260921-174405-65f5fb4/opamp_core.spice`), ngspice-46,
PDK `ihp-sg13g2` rooted at `/Users/rwalters/share/pdk` (pin: see `sim/pdk.json`), OSDI
models from `/Users/rwalters/share/pdk/ihp-sg13g2/libs.tech/ngspice/osdi` (built by `sim/tools/build-osdi.sh`).

Grid: cornerMOSlv.lib `mos_tt/ss/ff/sf/fs` [DR-1] x temperature
`{-40, 27, 125} C` x supply `{1.08, 1.20, 1.32} V` = 45 points,
into `CL = 2 pF` [DR-1]. Method: open-loop input common-mode sweep with
the differential input pinned at zero; the lower bound is the
`v(tail) = Vdsat(M5)` crossing with Vdsat5 measured by the same-device
replica probe at its 10%-of-max-slope saturation knee, the upper bound is
the pair saturation condition `Vds >= Vgs - Vth` with Vth measured by the
replica probe at the bound's own body bias per the gm/ID constant-current
convention (a three-round seeded fixed point: centre-bias seed, bound-bias
setting, bound verification), both located coarse (5 mV) then resolved
fine (250 uV) -- README.md "What this bench measures" and "The
saturation-edge probes". 45 of 45 points simulated
successfully; 0 simulation failure(s)
(none); 0 point(s) failed the
per-point sanity check (none) -- see README.md
"Per-point sanity checks" for what each check does and does not verify.

## Worst-corner summary

```
worst_icmr_span_v: 0.2532 at mos_ss_125C_1.08V
best_icmr_span_v: 0.6769 at mos_ff_-40C_1.32V
worst_icmr_lo_v: 0.6401 at mos_ss_-40C_1.08V
worst_icmr_hi_v: 0.7954 at mos_fs_125C_1.08V
worst_buffer_use_span_v: 0.1612 at mos_ss_125C_1.08V
binding_point_overlap, lo=mos_ss_-40C_1.08V hi=mos_fs_125C_1.08V span=mos_ss_125C_1.08V
centre_below_lo_points,15 (mos_tt_-40C_1.08V mos_tt_27C_1.08V mos_tt_125C_1.08V mos_ss_-40C_1.08V mos_ss_-40C_1.20V mos_ss_27C_1.08V mos_ss_27C_1.20V mos_ss_125C_1.08V mos_ss_125C_1.20V mos_sf_-40C_1.08V mos_sf_-40C_1.20V mos_sf_27C_1.08V mos_sf_125C_1.08V mos_fs_-40C_1.08V mos_fs_27C_1.08V)
mech_combo m5_headroom/pair_saturation: 45
```

Full per-point data (ICMR bounds and span, closed-loop-buffer usable
interval, whether the nominal VDD/2 operating point lies inside the
measured interval (contains_vcm / centre_gap_lo_v -- at the 1.08 V rail
several corners sit below the measured lower bound: the low-rail
tail-starvation finding, README.md "The low-rail finding"), mechanism
attribution with margin evidence, the measured
saturation requirements both bounds are judged against (Vdsat5 knee,
Vth(CC) and Vgs-Vth of the pair), per-bound internal operating point and
Vdd current, the centre operating point, and the per-point cross-checks
against `sim/open-loop-ac` and `sim/output-swing` at the same point_id)
is in `records/20260921-174405-65f5fb4.csv`. Raw per-point ngspice logs, the coarse
and fine scan curves each bound was read from, and the replica-probe
saturation curves each requirement was read from are in
`corners/20260921-174405-65f5fb4/`.
