2AMLogic/sg13g2-opamp/sim/cmrr-mismatch/records/20260921-172304-65f5fb4.md

# cmrr-mismatch record 20260921-172304-65f5fb4

Generated by `sim/cmrr-mismatch/run_cmrr_mismatch_mc.sh` against
`design/netlist/opamp_core.spice` (snapshot:
`netlist-snapshots/20260921-172304-65f5fb4/opamp_core.spice`), ngspice-46,
PDK `ihp-sg13g2` rooted at `/Users/rwalters/share/pdk` (pin: see `sim/pdk.json`), OSDI
models from `/Users/rwalters/share/pdk/ihp-sg13g2/libs.tech/ngspice/osdi`. Every sample's CMRR divides the SAME grid
point's `av0_db` of the open-loop record
`sim/open-loop-ac/records/20260910-221601-22feaba.csv` (joined, not
re-measured), per issue #26's harness-reuse wording. The negative control
asserts the zero-mismatch deck (plain `mos_tt mos_ss mos_ff mos_sf mos_fs` sections, the exact
configuration `sim/cmrr-psrr/` ran) reproduces #25's committed
`sim/cmrr-psrr/records/20260921-151815-707b34c.csv` per point (acm0/vout/vibias
and the derived cmrr, tolerances 5e-3 dB / 5e-4 V).

Grid: cornerMOSlv.lib `mos_tt mos_ss mos_ff mos_sf mos_fs` mismatch sections
(`<corner>_mismatch` -> sg13g2_moslv_mod_mismatch.lib) x temperature
`{-40, 27, 125} C` x supply `{1.08, 1.20, 1.32} V` = 45 points,
**MC_N = 300** samples per point (each sample one fresh
independent per-instance agauss draw of all eight MOSFETs), into
`CL = 2e-12 F` [DR-1]. N derived from the pilots at
mos_tt_27C_1.20V and mos_fs_125C_1.08V: worst pilot
linear-Acm sigma 0.280544 V/V, N chosen so the sigma's sampling
error stays below MC_TARGET_SIGMA_RE = 0.05
(SE(sigma_hat)/sigma ~ 1/sqrt(2N)), floor N 300 per the spec
row's "mismatch MC N>=300" wording. Seeds: setseed = 260000 +
grid index (corner-major, 0-based); reproducibility machine-checked
(`corners/20260921-172304-65f5fb4/repro_check.txt`: same seed byte-identical, alt
seed 990000 a different draw).

The quoted per-point bound (cmrr_3sigma_db) is computed in the LINEAR
Acm domain -- the +3 sigma point of the drawn Acm distribution
(20*log10(mean+3*sigma)) mapped below the joined Av0 -- because the dB
image of the draw distribution is heavy-tailed on the rejection-good
side at the low-rail near-cancellation corners; empirical dB-domain
context columns (mean, 1st percentile, worst sample) are recorded
alongside. Per-sample AC points: 10 mHz shelf (Acm0 read, same
convention as #14), 0.1 Hz (plateau guard partner; tolerance
0.05 dB, samples failing it are excluded and counted), and
1 kHz (in-band figure, the same frequency #14 reports alongside). Per-
sample DC sanity per #14's rule (output within 0.15*VDD of
mid-rail, no internal node within 0.02*VDD of a rail); failing
samples are excluded from the statistics and counted in the record's
excluded/op_fail columns.

## Worst/best-corner summary (mismatch-inclusive)

```
points: 45, mc_n per point: 300
cmrr_3sigma_db: worst(min) 26.68 at mos_ss_-40C_1.08V, best(max) 37.57 at mos_ss_125C_1.08V
cmrr_1khz_3sigma_db: worst(min) 26.68 at mos_ss_-40C_1.08V, best(max) 37.57 at mos_ss_125C_1.08V
cmrr_db_p01: worst(min) 27.37 at mos_ss_-40C_1.08V, best(max) 38.04 at mos_tt_27C_1.08V
cmrr_db_min: worst(min) 25.94 at mos_ss_-40C_1.08V, best(max) 36.85 at mos_tt_27C_1.08V
cmrr_db_mean: worst(min) 30.89 at mos_fs_125C_1.08V, best(max) 52.36 at mos_ss_125C_1.08V
excluded samples total: 0 (op_fail 0, plateau_fail 0) of 13500
nominal mos_tt_27C_1.20V: sys_cmrr 35.32, mc mean 35.4425, 3sigma bound 32.596 (acm mu 2.133, sigma 0.267568)
```

Full per-point data (joined Av0 and #25 systematic values, linear-domain
Acm mean/sigma, the +3 sigma Acm point and its CMRR, empirical dB
mean/p1/min, the 1 kHz variant, per-point excluded/op/plateau counts,
plateau max deviation) is in `records/20260921-172304-65f5fb4.csv`. Per-sample
artifacts (the OP/AC echo lines, one file per point) are in
`corners/20260921-172304-65f5fb4/`, alongside each point's negative-control sample
file and the repro pair. Rendered per-point netlists (with their seeds in
the header) are in `netlist-snapshots/20260921-172304-65f5fb4/`.

Method, definition caveats (the fixed systematic numerator; the 3 sigma
domain choice; the shelf-only frequency claim) and what this bench does
not claim: `sim/cmrr-mismatch/README.md`.
