2AMLogic/sg13g2-opamp/sim/cmrr-psrr/records/20260921-151815-707b34c.md

# cmrr-psrr record 20260921-151815-707b34c

Generated by `sim/cmrr-psrr/run_cmrr_psrr_sweep.sh` against
`design/netlist/opamp_core.spice` (snapshot:
`netlist-snapshots/20260921-151815-707b34c/opamp_core.spice`), ngspice-46,
PDK `ihp-sg13g2` rooted at `/Users/rwalters/share/pdk` (pin: see `sim/pdk.json`), OSDI
models from `/Users/rwalters/share/pdk/ihp-sg13g2/libs.tech/ngspice/osdi` (built by `sim/tools/build-osdi.sh`). Both
ratios divide the per-point `av0_db` of the open-loop record
`sim/open-loop-ac/records/20260910-221601-22feaba.csv` (joined by grid point, not
re-measured; the transfer's shared-operating-point assumption is
cross-checked per point -- see `op_xcheck_psrr_delta_v` and
`ol_vout_delta_v` columns).
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
