2AMLogic/sg13g2-opamp/sim/output-swing/records/20260921-151759-707b34c.md

# output-swing record 20260921-151759-707b34c

Generated by `sim/output-swing/run_swing_sweep.sh` against
`design/netlist/opamp_core.spice` (snapshot:
`netlist-snapshots/20260921-151759-707b34c/opamp_core.spice`), ngspice-46,
PDK `ihp-sg13g2` rooted at `/Users/rwalters/share/pdk` (pin: see `sim/pdk.json`), OSDI
models from `/Users/rwalters/share/pdk/ihp-sg13g2/libs.tech/ngspice/osdi` (built by `sim/tools/build-osdi.sh`).
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
