2AMLogic/sg13g2-opamp/sim/gm-id-characterization/records/20260909-063633-b402592.md

# Record 20260909-063633-b402592

- **Experiment**: gm-id-characterization
- **Claim**: gm/ID, gm/gds, Cgg and fT vs Vgs (and vs Vth-referenced
  overdrive) for SG13G2's LV core MOS devices (sg13_lv_nmos,
  sg13_lv_pmos), at Vds=0.6V (VDD/2, VDD=1.2V), swept over four
  channel lengths (0.13/0.26/0.52/1.04 um) and all five
  cornerMOSlv.lib process corners, at 27C nominal temperature.
  This is a device-characterization study, not a circuit claim --
  no schematic exists yet in this repo (see README.md 'What this
  study is not').
- **Devices**: sg13_lv_nmos / sg13_lv_pmos (PSP103.6 via
  psp103.osdi), W=10um, ng=1, m=1 fixed (gm/ID methodology
  normalizes out W).
- **PDK**: `ihp-sg13g2` at `/Users/rwalters/share/pdk` -- pinned release: see
  `sim/pdk.json` (IHP-Open-PDK v0.3.0).
- **OSDI models**: `/Users/rwalters/share/pdk/ihp-sg13g2/libs.tech/ngspice/osdi` -- built by
  `sim/tools/build-osdi.sh`.
- **ngspice**: `** ngspice-46 : Circuit level simulation program`
- **Sweep grid**: device {nmos, pmos} x length {0.13u, 0.26u, 0.52u,
  1.04u} x corner {mos_tt, mos_ss, mos_ff, mos_sf, mos_fs} =
  40 (device,length,corner) points, 56 Vgs points each.
- **Result**: 40/40 points PASS (ngspice exit 0, DC
  wrdata present, all 56 Vgs rows merged with a matching AC point).
- **Completeness matrix**: OK -- every (device,length,corner) cell has >=50/56 rows
- **Sanity checks** (see `corners/20260909-063633-b402592/sanity_checks.txt`):
  - PASS gm/ID monotonically decreasing vs overdrive from its observed peak (index 8/55, peak=29.536): device=nmos length=0.13u corner=mos_tt (violations=0/47)
  - PASS gm/ID monotonically decreasing vs overdrive from its observed peak (index 3/55, peak=32.163): device=nmos length=0.26u corner=mos_tt (violations=0/52)
  - PASS gm/ID monotonically decreasing vs overdrive from its observed peak (index 1/55, peak=33.306): device=nmos length=0.52u corner=mos_tt (violations=0/54)
  - PASS gm/ID monotonically decreasing vs overdrive from its observed peak (index 1/55, peak=33.743): device=nmos length=1.04u corner=mos_tt (violations=0/54)
  - PASS gm/ID monotonically decreasing vs overdrive from its observed peak (index 10/55, peak=28.209): device=pmos length=0.13u corner=mos_tt (violations=0/45)
  - PASS gm/ID monotonically decreasing vs overdrive from its observed peak (index 8/55, peak=31.419): device=pmos length=0.26u corner=mos_tt (violations=0/47)
  - PASS gm/ID monotonically decreasing vs overdrive from its observed peak (index 7/55, peak=33.017): device=pmos length=0.52u corner=mos_tt (violations=0/48)
  - PASS gm/ID monotonically decreasing vs overdrive from its observed peak (index 7/55, peak=33.729): device=pmos length=1.04u corner=mos_tt (violations=0/48)
  - PASS fT falls off with increasing length near overdrive~0.3V: device=nmos lengths=['0.13u', '0.26u', '0.52u', '1.04u'] fT=['4.138e+10', '1.759e+10', '5.723e+09', '1.682e+09']
  - PASS fT falls off with increasing length near overdrive~0.3V: device=pmos lengths=['0.13u', '0.26u', '0.52u', '1.04u'] fT=['2.269e+10', '5.645e+09', '1.601e+09', '4.233e+08']
- **Links**:
  - Templates: `testbench/tb_gmid_nmos.spice.tmpl`,
    `testbench/tb_gmid_pmos.spice.tmpl`
  - Per-point generated netlists: `netlist-snapshots/20260909-063633-b402592/`
  - Per-point raw ngspice logs + per-point DC CSVs:
    `corners/20260909-063633-b402592/`
  - Parsed, merged CSV (all points, all derived quantities):
    `records/20260909-063633-b402592.csv`
  - Plots: `records/20260909-063633-b402592_gm_id_vs_overdrive.png`,
    `records/20260909-063633-b402592_ft_vs_length.png`
- **Timestamp / author**: 2026-09-09T06:37:02Z, Loom Builder
  (agent), issue #5.
