2AMLogic/sg13g2-opamp/sim/gm-id-characterization/records/20260909-063633-b402592.csv

device | length_um | corner | vgs_v | vds_v | ids_a | gm_s | gds_s | cgg_f | gm_id_per_v | gm_gds | ft_hz | vth_v | overdrive_v
nmos | 0.13u | mos_ff | 0.0500 | 0.6000 | 8.579939e-09 | 1.968853e-07 | 9.868615e-09 | 1.286660e-14 | 22.947168 | 19.950652 | 2.435396e+06 | 0.3039 | -0.2539
nmos | 0.13u | mos_ff | 0.0700 | 0.6000 | 1.474757e-08 | 4.198776e-07 | 1.711707e-08 | 1.288440e-14 | 28.470968 | 24.529759 | 5.186551e+06 | 0.3039 | -0.2339
nmos | 0.13u | mos_ff | 0.0900 | 0.6000 | 2.537504e-08 | 7.238099e-07 | 2.971738e-08 | 1.290260e-14 | 28.524483 | 24.356451 | 8.928272e+06 | 0.3039 | -0.2139
nmos | 0.13u | mos_ff | 0.1100 | 0.6000 | 4.369996e-08 | 1.248449e-06 | 5.162737e-08 | 1.292140e-14 | 28.568653 | 24.181921 | 1.537735e+07 | 0.3039 | -0.1939
nmos | 0.13u | mos_ff | 0.1300 | 0.6000 | 7.531302e-08 | 2.153974e-06 | 8.972679e-08 | 1.294110e-14 | 28.600287 | 24.005918 | 2.649045e+07 | 0.3039 | -0.1739
nmos | 0.13u | mos_ff | 0.1500 | 0.6000 | 1.298589e-07 | 3.715650e-06 | 1.559515e-07 | 1.296200e-14 | 28.612979 | 23.825677 | 4.562290e+07 | 0.3039 | -0.1539
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
