2AMLogic/sg13g2-opamp/sim/gm-id-characterization/corners/20260909-063633-b402592/nmos_0.13u_mos_ff_dc.csv

 5.00000000e-02  5.00000000e-02  5.00000000e-02  8.57993926e-09  5.00000000e-02  1.96885284e-07  5.00000000e-02  9.86861490e-09
 7.00000000e-02  7.00000000e-02  7.00000000e-02  1.47475679e-08  7.00000000e-02  4.19877583e-07  7.00000000e-02  1.71170729e-08
 9.00000000e-02  9.00000000e-02  9.00000000e-02  2.53750426e-08  9.00000000e-02  7.23809868e-07  9.00000000e-02  2.97173810e-08
 1.10000000e-01  1.10000000e-01  1.10000000e-01  4.36999627e-08  1.10000000e-01  1.24844938e-06  1.10000000e-01  5.16273677e-08
 1.30000000e-01  1.30000000e-01  1.30000000e-01  7.53130179e-08  1.30000000e-01  2.15397421e-06  1.30000000e-01  8.97267889e-08
 1.50000000e-01  1.50000000e-01  1.50000000e-01  1.29858931e-07  1.50000000e-01  3.71564987e-06  1.50000000e-01  1.55951542e-07
 1.70000000e-01  1.70000000e-01  1.70000000e-01  2.23939012e-07  1.70000000e-01  6.40361117e-06  1.70000000e-01  2.70932562e-07
 1.90000000e-01  1.90000000e-01  1.90000000e-01  3.86003378e-07  1.90000000e-01  1.10119375e-05  1.90000000e-01  4.70087779e-07
 2.10000000e-01  2.10000000e-01  2.10000000e-01  6.64416513e-07  2.10000000e-01  1.88558970e-05  2.10000000e-01  8.13489759e-07
 2.30000000e-01  2.30000000e-01  2.30000000e-01  1.14023926e-06  2.30000000e-01  3.20416178e-05  2.30000000e-01  1.40090321e-06
 2.50000000e-01  2.50000000e-01  2.50000000e-01  1.94608122e-06  2.50000000e-01  5.37527626e-05  2.50000000e-01  2.39211077e-06
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
 9.90000000e-01  1.18972024e-03  9.90000000e-01  3.16025021e-03  9.90000000e-01  0.00000000e+00  9.90000000e-01  0.00000000e+00
 1.01000000e+00  1.28930336e-03  1.01000000e+00  3.33523370e-03  1.01000000e+00  0.00000000e+00  1.01000000e+00  0.00000000e+00
 1.03000000e+00  1.39465588e-03  1.03000000e+00  3.51125132e-03  1.03000000e+00  0.00000000e+00  1.03000000e+00  0.00000000e+00
 1.05000000e+00  1.50574429e-03  1.05000000e+00  3.68799496e-03  1.05000000e+00  0.00000000e+00  1.05000000e+00  0.00000000e+00
 1.07000000e+00  1.62250771e-03  1.07000000e+00  3.86517586e-03  1.07000000e+00  0.00000000e+00  1.07000000e+00  0.00000000e+00
 1.09000000e+00  1.74486030e-03  1.09000000e+00  4.04252444e-03  1.09000000e+00  0.00000000e+00  1.09000000e+00  0.00000000e+00
 1.11000000e+00  1.87269367e-03  1.11000000e+00  4.21979001e-03  1.11000000e+00  0.00000000e+00  1.11000000e+00  0.00000000e+00
 1.13000000e+00  2.00587917e-03  1.13000000e+00  4.39674023e-03  1.13000000e+00  0.00000000e+00  1.13000000e+00  0.00000000e+00
 1.15000000e+00  2.14427027e-03  1.15000000e+00  4.57316056e-03  1.15000000e+00  0.00000000e+00  1.15000000e+00  0.00000000e+00
