2AMLogic/sg13g2-opamp/sim/gm-id-characterization/corners/20260909-063633-b402592/nmos_0.13u_mos_fs_dc.csv

 5.00000000e-02  5.00000000e-02  5.00000000e-02  3.62205299e-09  5.00000000e-02  8.36652699e-08  5.00000000e-02  4.19160304e-09
 7.00000000e-02  7.00000000e-02  7.00000000e-02  6.26739907e-09  7.00000000e-02  1.80869338e-07  7.00000000e-02  7.31825962e-09
 9.00000000e-02  9.00000000e-02  9.00000000e-02  1.08568265e-08  9.00000000e-02  3.13957214e-07  9.00000000e-02  1.27910701e-08
 1.10000000e-01  1.10000000e-01  1.10000000e-01  1.88256876e-08  1.10000000e-01  5.45390185e-07  1.10000000e-01  2.23751612e-08
 1.30000000e-01  1.30000000e-01  1.30000000e-01  3.26724339e-08  1.30000000e-01  9.48006604e-07  1.30000000e-01  3.91651516e-08
 1.50000000e-01  1.50000000e-01  1.50000000e-01  5.67459518e-08  1.50000000e-01  1.64847212e-06  1.50000000e-01  6.85834711e-08
 1.70000000e-01  1.70000000e-01  1.70000000e-01  9.86113186e-08  1.70000000e-01  2.86651066e-06  1.70000000e-01  1.20117920e-07
 1.90000000e-01  1.90000000e-01  1.90000000e-01  1.71406378e-07  1.90000000e-01  4.98142453e-06  1.90000000e-01  2.10321807e-07
 2.10000000e-01  2.10000000e-01  2.10000000e-01  2.97868300e-07  2.10000000e-01  8.64215837e-06  2.10000000e-01  3.67919743e-07
 2.30000000e-01  2.30000000e-01  2.30000000e-01  5.17092713e-07  2.30000000e-01  1.49413875e-05  2.30000000e-01  6.42272454e-07
 2.50000000e-01  2.50000000e-01  2.50000000e-01  8.95523799e-07  2.50000000e-01  2.56681418e-05  2.50000000e-01  1.11675096e-06
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
 9.90000000e-01  9.59631249e-04  9.90000000e-01  2.85626091e-03  9.90000000e-01  0.00000000e+00  9.90000000e-01  0.00000000e+00
 1.01000000e+00  1.03704724e-03  1.01000000e+00  3.02354772e-03  1.01000000e+00  0.00000000e+00  1.01000000e+00  0.00000000e+00
 1.03000000e+00  1.11908390e-03  1.03000000e+00  3.19226600e-03  1.03000000e+00  0.00000000e+00  1.03000000e+00  0.00000000e+00
 1.05000000e+00  1.20576315e-03  1.05000000e+00  3.36211881e-03  1.05000000e+00  0.00000000e+00  1.05000000e+00  0.00000000e+00
 1.07000000e+00  1.29708665e-03  1.07000000e+00  3.53282741e-03  1.07000000e+00  0.00000000e+00  1.07000000e+00  0.00000000e+00
 1.09000000e+00  1.39303719e-03  1.09000000e+00  3.70413114e-03  1.09000000e+00  0.00000000e+00  1.09000000e+00  0.00000000e+00
 1.11000000e+00  1.49358028e-03  1.11000000e+00  3.87578694e-03  1.11000000e+00  0.00000000e+00  1.11000000e+00  0.00000000e+00
 1.13000000e+00  1.59866553e-03  1.13000000e+00  4.04756889e-03  1.13000000e+00  0.00000000e+00  1.13000000e+00  0.00000000e+00
 1.15000000e+00  1.70822812e-03  1.15000000e+00  4.21926751e-03  1.15000000e+00  0.00000000e+00  1.15000000e+00  0.00000000e+00
