2AMLogic/sg13g2-opamp/sim/gm-id-characterization/corners/20260909-063633-b402592/nmos_0.13u_mos_sf_dc.csv

 5.00000000e-02  5.00000000e-02  5.00000000e-02  4.10742301e-10  5.00000000e-02  9.75686574e-09  5.00000000e-02  4.78506779e-10
 7.00000000e-02  7.00000000e-02  7.00000000e-02  7.33702609e-10  7.00000000e-02  2.25391651e-08  7.00000000e-02  8.61734639e-10
 9.00000000e-02  9.00000000e-02  9.00000000e-02  1.31230890e-09  9.00000000e-02  4.04053317e-08  9.00000000e-02  1.55451198e-09
 1.10000000e-01  1.10000000e-01  1.10000000e-01  2.34991588e-09  1.10000000e-01  7.25010500e-08  1.10000000e-01  2.80764000e-09
 1.30000000e-01  1.30000000e-01  1.30000000e-01  4.21235090e-09  1.30000000e-01  1.30206769e-07  1.30000000e-01  5.07574615e-09
 1.50000000e-01  1.50000000e-01  1.50000000e-01  7.55818663e-09  1.50000000e-01  2.34033324e-07  1.50000000e-01  9.18329499e-09
 1.70000000e-01  1.70000000e-01  1.70000000e-01  1.35736839e-08  1.70000000e-01  4.20954948e-07  1.70000000e-01  1.66258594e-08
 1.90000000e-01  1.90000000e-01  1.90000000e-01  2.43963846e-08  1.90000000e-01  7.57607821e-07  1.90000000e-01  3.01163892e-08
 2.10000000e-01  2.10000000e-01  2.10000000e-01  4.38779967e-08  2.10000000e-01  1.36396158e-06  2.10000000e-01  5.45737465e-08
 2.30000000e-01  2.30000000e-01  2.30000000e-01  7.89548476e-08  2.30000000e-01  2.45547858e-06  2.30000000e-01  9.89044002e-08
 2.50000000e-01  2.50000000e-01  2.50000000e-01  1.42097140e-07  2.50000000e-01  4.41721185e-06  2.50000000e-01  1.79189067e-07
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
 9.90000000e-01  6.28566349e-04  9.90000000e-01  2.27987112e-03  9.90000000e-01  0.00000000e+00  9.90000000e-01  0.00000000e+00
 1.01000000e+00  6.73175188e-04  1.01000000e+00  2.42617175e-03  1.01000000e+00  0.00000000e+00  1.01000000e+00  0.00000000e+00
 1.03000000e+00  7.20324852e-04  1.03000000e+00  2.57421631e-03  1.03000000e+00  0.00000000e+00  1.03000000e+00  0.00000000e+00
 1.05000000e+00  7.70070063e-04  1.05000000e+00  2.72374245e-03  1.05000000e+00  0.00000000e+00  1.05000000e+00  0.00000000e+00
 1.07000000e+00  8.22456436e-04  1.07000000e+00  2.87450523e-03  1.07000000e+00  0.00000000e+00  1.07000000e+00  0.00000000e+00
 1.09000000e+00  8.77521133e-04  1.09000000e+00  3.02627662e-03  1.09000000e+00  0.00000000e+00  1.09000000e+00  0.00000000e+00
 1.11000000e+00  9.35293419e-04  1.11000000e+00  3.17884481e-03  1.11000000e+00  0.00000000e+00  1.11000000e+00  0.00000000e+00
 1.13000000e+00  9.95795166e-04  1.13000000e+00  3.33201349e-03  1.13000000e+00  0.00000000e+00  1.13000000e+00  0.00000000e+00
 1.15000000e+00  1.05904129e-03  1.15000000e+00  3.48560097e-03  1.15000000e+00  0.00000000e+00  1.15000000e+00  0.00000000e+00
