2AMLogic/sg13g2-opamp/sim/gm-id-characterization/corners/20260909-063633-b402592/nmos_0.13u_mos_ss_dc.csv

 5.00000000e-02  5.00000000e-02  5.00000000e-02  1.00877688e-10  5.00000000e-02  2.44037808e-09  5.00000000e-02  1.17754740e-10
 7.00000000e-02  7.00000000e-02  7.00000000e-02  1.85154128e-10  7.00000000e-02  5.98726596e-09  7.00000000e-02  2.17557170e-10
 9.00000000e-02  9.00000000e-02  9.00000000e-02  3.40368326e-10  9.00000000e-02  1.10338941e-08  9.00000000e-02  4.03053264e-10
 1.10000000e-01  1.10000000e-01  1.10000000e-01  6.26509891e-10  1.10000000e-01  2.03539182e-08  1.10000000e-01  7.48015479e-10
 1.30000000e-01  1.30000000e-01  1.30000000e-01  1.15452506e-09  1.30000000e-01  3.75814888e-08  1.30000000e-01  1.38993430e-09
 1.50000000e-01  1.50000000e-01  1.50000000e-01  2.12976944e-09  1.50000000e-01  6.94527224e-08  1.50000000e-01  2.58520421e-09
 1.70000000e-01  1.70000000e-01  1.70000000e-01  3.93263395e-09  1.70000000e-01  1.28460912e-07  1.70000000e-01  4.81220416e-09
 1.90000000e-01  1.90000000e-01  1.90000000e-01  7.26820594e-09  1.90000000e-01  2.37786788e-07  1.90000000e-01  8.96385864e-09
 2.10000000e-01  2.10000000e-01  2.10000000e-01  1.34441055e-08  2.10000000e-01  4.40445945e-07  2.10000000e-01  1.67072416e-08
 2.30000000e-01  2.30000000e-01  2.30000000e-01  2.48860437e-08  2.30000000e-01  8.16225853e-07  2.30000000e-01  3.11544186e-08
 2.50000000e-01  2.50000000e-01  2.50000000e-01  4.60931396e-08  2.50000000e-01  1.51290798e-06  2.50000000e-01  5.81108547e-08
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
 9.90000000e-01  5.14717151e-04  9.90000000e-01  2.02252267e-03  9.90000000e-01  0.00000000e+00  9.90000000e-01  0.00000000e+00
 1.01000000e+00  5.48461123e-04  1.01000000e+00  2.15745422e-03  1.01000000e+00  0.00000000e+00  1.01000000e+00  0.00000000e+00
 1.03000000e+00  5.83994894e-04  1.03000000e+00  2.29411636e-03  1.03000000e+00  0.00000000e+00  1.03000000e+00  0.00000000e+00
 1.05000000e+00  6.21372421e-04  1.05000000e+00  2.43226427e-03  1.05000000e+00  0.00000000e+00  1.05000000e+00  0.00000000e+00
 1.07000000e+00  6.60641789e-04  1.07000000e+00  2.57167059e-03  1.07000000e+00  0.00000000e+00  1.07000000e+00  0.00000000e+00
 1.09000000e+00  7.01845642e-04  1.09000000e+00  2.71212469e-03  1.09000000e+00  0.00000000e+00  1.09000000e+00  0.00000000e+00
 1.11000000e+00  7.45021527e-04  1.11000000e+00  2.85343187e-03  1.11000000e+00  0.00000000e+00  1.11000000e+00  0.00000000e+00
 1.13000000e+00  7.90202170e-04  1.13000000e+00  2.99541247e-03  1.13000000e+00  0.00000000e+00  1.13000000e+00  0.00000000e+00
 1.15000000e+00  8.37415706e-04  1.15000000e+00  3.13790087e-03  1.15000000e+00  0.00000000e+00  1.15000000e+00  0.00000000e+00
