2AMLogic/sg13g2-opamp/sim/gm-id-characterization/corners/20260909-063633-b402592/nmos_0.13u_mos_tt_dc.csv

 5.00000000e-02  5.00000000e-02  5.00000000e-02  1.49818833e-09  5.00000000e-02  3.48320477e-08  5.00000000e-02  1.74418177e-09
 7.00000000e-02  7.00000000e-02  7.00000000e-02  2.61009255e-09  7.00000000e-02  7.63583737e-08  7.00000000e-02  3.06558190e-09
 9.00000000e-02  9.00000000e-02  9.00000000e-02  4.55252328e-09  9.00000000e-02  1.33470414e-07  9.00000000e-02  5.39463267e-09
 1.10000000e-01  1.10000000e-01  1.10000000e-01  7.94890911e-09  1.10000000e-01  2.33500741e-07  1.10000000e-01  9.50210053e-09
 1.30000000e-01  1.30000000e-01  1.30000000e-01  1.38925529e-08  1.30000000e-01  4.08817728e-07  1.30000000e-01  1.67497571e-08
 1.50000000e-01  1.50000000e-01  1.50000000e-01  2.43016182e-08  1.50000000e-01  7.16234764e-07  1.50000000e-01  2.95437365e-08
 1.70000000e-01  1.70000000e-01  1.70000000e-01  4.25419435e-08  1.70000000e-01  1.25539817e-06  1.70000000e-01  5.21341025e-08
 1.90000000e-01  1.90000000e-01  1.90000000e-01  7.45175449e-08  1.90000000e-01  2.20075690e-06  1.90000000e-01  9.20203692e-08
 2.10000000e-01  2.10000000e-01  2.10000000e-01  1.30572219e-07  2.10000000e-01  3.85656272e-06  2.10000000e-01  1.62406910e-07
 2.30000000e-01  2.30000000e-01  2.30000000e-01  2.28780054e-07  2.30000000e-01  6.74967850e-06  2.30000000e-01  2.86443959e-07
 2.50000000e-01  2.50000000e-01  2.50000000e-01  4.00559359e-07  2.50000000e-01  1.17807029e-05  2.50000000e-01  5.04402494e-07
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
 9.90000000e-01  7.78556927e-04  9.90000000e-01  2.56473344e-03  9.90000000e-01  0.00000000e+00  9.90000000e-01  0.00000000e+00
 1.01000000e+00  8.38115270e-04  1.01000000e+00  2.72335028e-03  1.01000000e+00  0.00000000e+00  1.01000000e+00  0.00000000e+00
 1.03000000e+00  9.01227051e-04  1.03000000e+00  2.88371333e-03  1.03000000e+00  0.00000000e+00  1.03000000e+00  0.00000000e+00
 1.05000000e+00  9.67940492e-04  1.05000000e+00  3.04553712e-03  1.05000000e+00  0.00000000e+00  1.05000000e+00  0.00000000e+00
 1.07000000e+00  1.03828949e-03  1.07000000e+00  3.20855364e-03  1.07000000e+00  0.00000000e+00  1.07000000e+00  0.00000000e+00
 1.09000000e+00  1.11229464e-03  1.09000000e+00  3.37251211e-03  1.09000000e+00  0.00000000e+00  1.09000000e+00  0.00000000e+00
 1.11000000e+00  1.18996421e-03  1.11000000e+00  3.53717853e-03  1.11000000e+00  0.00000000e+00  1.11000000e+00  0.00000000e+00
 1.13000000e+00  1.27129503e-03  1.13000000e+00  3.70233512e-03  1.13000000e+00  0.00000000e+00  1.13000000e+00  0.00000000e+00
 1.15000000e+00  1.35627338e-03  1.15000000e+00  3.86777961e-03  1.15000000e+00  0.00000000e+00  1.15000000e+00  0.00000000e+00
