2AMLogic/sg13g2-opamp/sim/gm-id-characterization/corners/20260909-063633-b402592/nmos_0.26u_mos_ff_dc.csv

 5.00000000e-02  5.00000000e-02  5.00000000e-02  4.90457544e-08  5.00000000e-02  1.18558546e-06  5.00000000e-02  4.76519114e-08
 7.00000000e-02  7.00000000e-02  7.00000000e-02  8.91644457e-08  7.00000000e-02  2.82628367e-06  7.00000000e-02  8.74082457e-08
 9.00000000e-02  9.00000000e-02  9.00000000e-02  1.62097101e-07  9.00000000e-02  5.13159621e-06  9.00000000e-02  1.60229931e-07
 1.10000000e-01  1.10000000e-01  1.10000000e-01  2.94428294e-07  1.10000000e-01  9.28587649e-06  1.10000000e-01  2.93173825e-07
 1.30000000e-01  1.30000000e-01  1.30000000e-01  5.33532161e-07  1.30000000e-01  1.66916296e-05  1.30000000e-01  5.34305632e-07
 1.50000000e-01  1.50000000e-01  1.50000000e-01  9.62093478e-07  1.50000000e-01  2.96427053e-05  1.50000000e-01  9.66468023e-07
 1.70000000e-01  1.70000000e-01  1.70000000e-01  1.71924037e-06  1.70000000e-01  5.15758153e-05  1.70000000e-01  1.72491461e-06
 1.90000000e-01  1.90000000e-01  1.90000000e-01  3.02512609e-06  1.90000000e-01  8.69240831e-05  1.90000000e-01  3.01044124e-06
 2.10000000e-01  2.10000000e-01  2.10000000e-01  5.19620370e-06  2.10000000e-01  1.40122682e-04  2.10000000e-01  5.07599202e-06
 2.30000000e-01  2.30000000e-01  2.30000000e-01  8.63003339e-06  2.30000000e-01  2.13919544e-04  2.30000000e-01  8.15994107e-06
 2.50000000e-01  2.50000000e-01  2.50000000e-01  1.37529854e-05  2.50000000e-01  3.08370278e-04  2.50000000e-01  1.23795766e-05
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
 9.90000000e-01  1.19717993e-03  9.90000000e-01  2.66269796e-03  9.90000000e-01  0.00000000e+00  9.90000000e-01  0.00000000e+00
 1.01000000e+00  1.29235181e-03  1.01000000e+00  2.77805427e-03  1.01000000e+00  0.00000000e+00  1.01000000e+00  0.00000000e+00
 1.03000000e+00  1.39192812e-03  1.03000000e+00  2.89329895e-03  1.03000000e+00  0.00000000e+00  1.03000000e+00  0.00000000e+00
 1.05000000e+00  1.49578325e-03  1.05000000e+00  3.00828232e-03  1.05000000e+00  0.00000000e+00  1.05000000e+00  0.00000000e+00
 1.07000000e+00  1.60377375e-03  1.07000000e+00  3.12286432e-03  1.07000000e+00  0.00000000e+00  1.07000000e+00  0.00000000e+00
 1.09000000e+00  1.71574063e-03  1.09000000e+00  3.23691435e-03  1.09000000e+00  0.00000000e+00  1.09000000e+00  0.00000000e+00
 1.11000000e+00  1.83151149e-03  1.11000000e+00  3.35031113e-03  1.11000000e+00  0.00000000e+00  1.11000000e+00  0.00000000e+00
 1.13000000e+00  1.95090272e-03  1.13000000e+00  3.46294240e-03  1.13000000e+00  0.00000000e+00  1.13000000e+00  0.00000000e+00
 1.15000000e+00  2.07372150e-03  1.15000000e+00  3.57470473e-03  1.15000000e+00  0.00000000e+00  1.15000000e+00  0.00000000e+00
