2AMLogic/sg13g2-opamp/sim/gm-id-characterization/records/20260909-063633-b402592_ft_vs_length.png

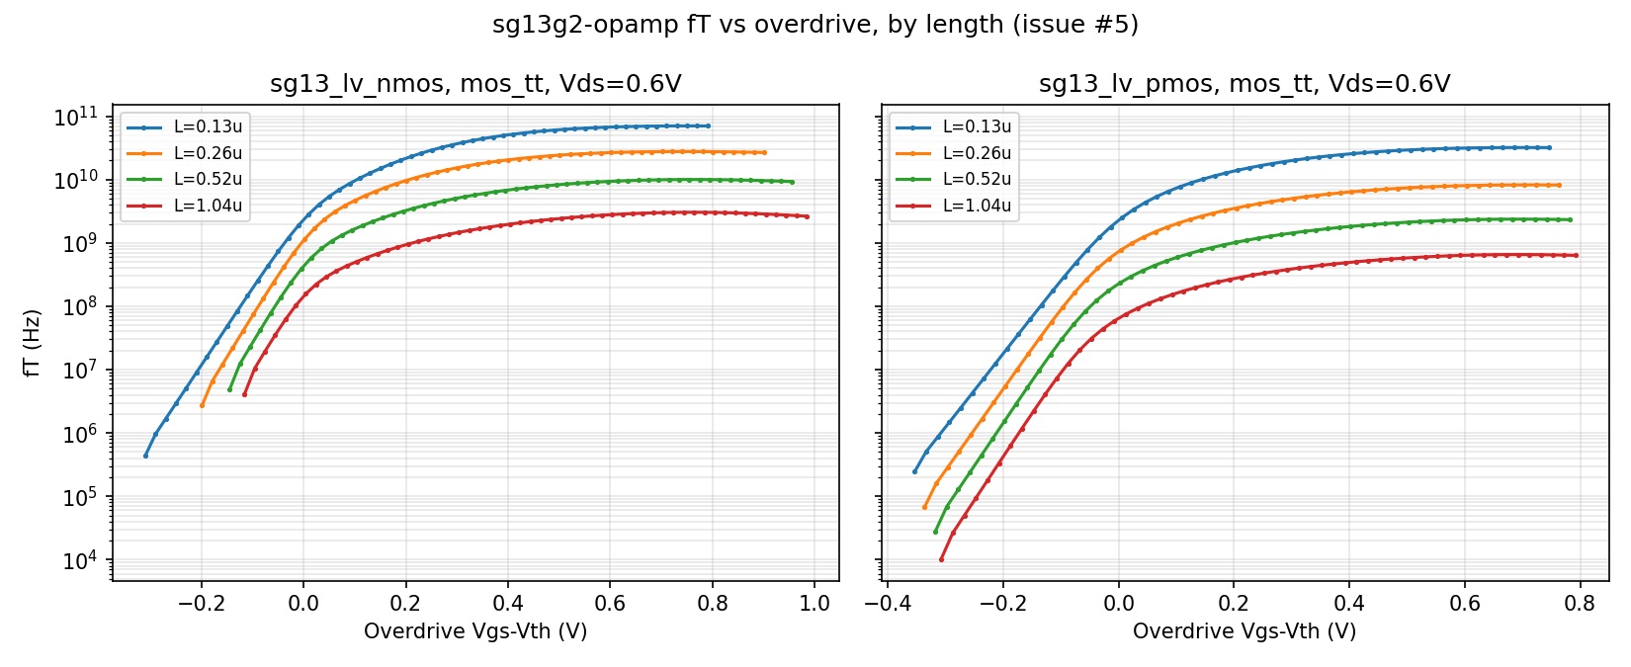
sim/gm-id-characterization/records/20260909-063633-b402592_ft_vs_length.png
