2AMLogic/sg13g2-opamp/sim/gm-id-characterization/records/20260909-063633-b402592_gm_id_vs_overdrive.png

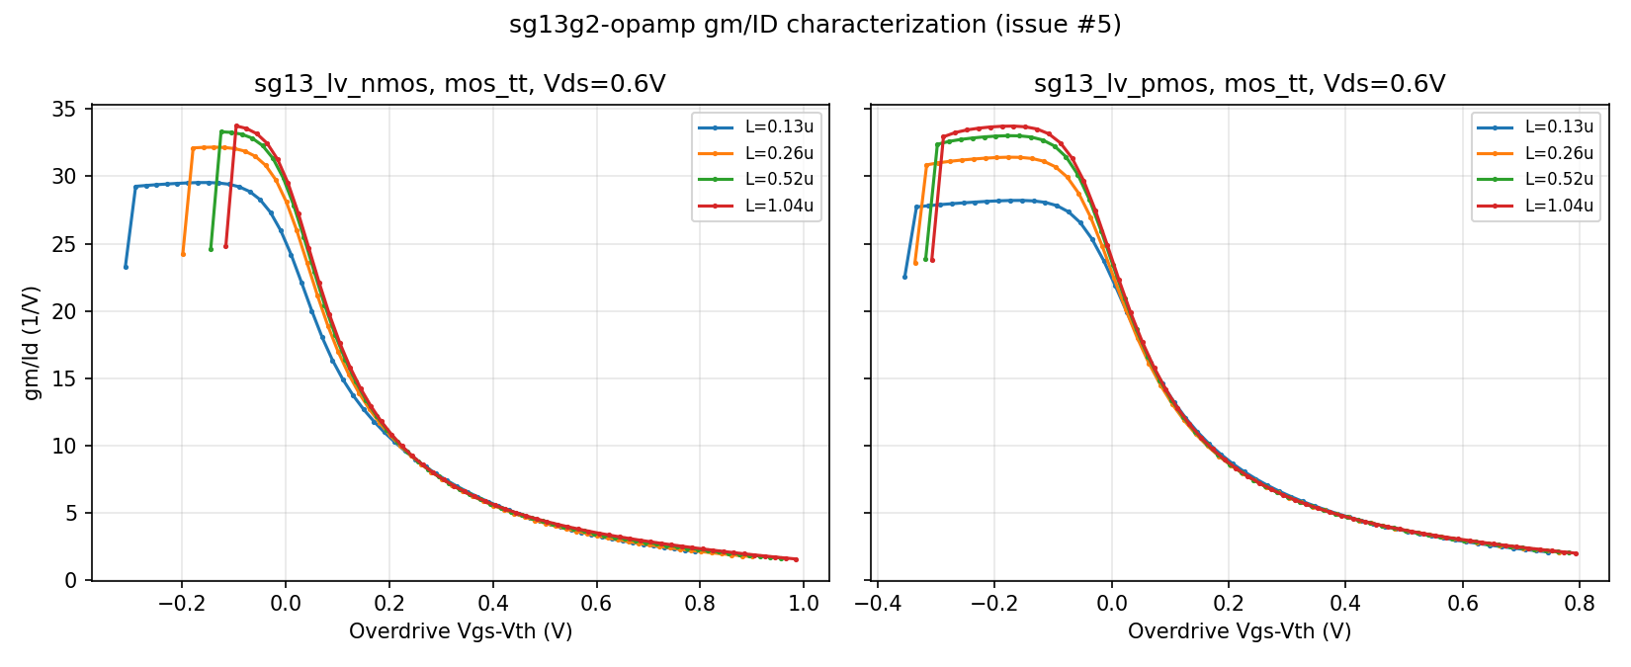
sim/gm-id-characterization/records/20260909-063633-b402592_gm_id_vs_overdrive.png
