2AMLogic/sg13g2-opamp/WORK_LOG.md

# Work Log

<!-- Maintained by the Loom Guide role. Newest entries first. -->

### 2026-11-01

- **PR #323**: sim: 45-point output-swing klt envelope on the batch fleet with harness comparison
- **Issue #100** (closed): sim: express the output-swing bench as a klt sim request (T1 item 5 coverage, follow-up to #85)

### 2026-10-28

- **PR #318**: docs: make cmrr-psrr shard-bridge klt 0.5.0 pin statement historical
- **Issue #317** (closed): docs: sim/cmrr-psrr/README.md:343 still says the fleet runner pins klt 0.5.0
- **PR #316**: docs: point cmrr-psrr shard-mode client at klayout-tools 0.8.0

### 2026-10-27

- **PR #315**: docs: point cmrr-psrr forward-looking klt client instructions at 0.8.0
- **PR #313**: chore: pin signoff grading to klt 0.8.0 and assert the version in CI
- **PR #308**: sim: PSRR as one klt sim measurement via two DUT copies, cited in item 5
- **Issue #307** (closed): T1 item 5 (corner verification): make the ratified PSRR row a citable klt sim envelope instead of a declared gap

### 2026-10-25

- **PR #301**: docs: request EE and market key review of DR-0011

### 2026-10-23

- **PR #299**: chore: untrack pnpm workspace state and ignore node_modules
- **Issue #298** (closed): chore: untrack node_modules/.pnpm-workspace-state-v1.json and ignore node_modules/
- **PR #297**: feat: store new run output as artifact-store manifests instead of bytes in git
- **Issue #296** (closed): Adopt the common artifact store for sim evidence (manifests in git, bytes via klt artifact)
- **PR #295**: ci: share one fail-closed offline test runner and wire it into pnpm test
- **Issue #294** (closed): Replace exit-0 package.json test stubs and duplicated CI test enumeration with one offline test runner

### 2026-10-20

- **PR #293**: docs: request fresh two-key ratification of the unchanged DR-0002 requirements
- **PR #292**: characterization: grade the four open-loop rows from the corrected AC record behind a raw-envelope audit

### 2026-10-19

- **PR #289**: docs: propose yield requirements for offset-random and mismatch-CMRR rows (DR-0010)
- **PR #285**: refactor: pass PVT axes to cmrr-mismatch Python blocks via argv
- **Issue #284** (closed): Dedupe PVT axes: cmrr-mismatch embedded Python re-hardcodes grid after #281
- **PR #287**: refactor: load open-loop-ac harness CSV via shared loader
- **Issue #286** (closed): Move open-loop-ac compare.py harness CSV loader onto shared load_harness_csv_rows (last hand-rolled copy; crashes on short rows)

### 2026-10-18

- **PR #282**: refactor: define PVT temperature/supply axes and CL once in sim/preflight.sh
- **Issue #281** (closed): Hold the temperature/supply grid axes and CL once in sim/preflight.sh (9 runners copy them; corners already centralized by #54)
- **PR #280**: refactor: share the open-loop klt bench between pre- and post-layout legs
- **Issue #279** (closed): Remove duplicated open-loop AC klt bench copies under sim/post-layout/klt/
- **PR #276**: refactor: move open-loop klt run.sh onto the shared klt_run_common helper
- **Issue #274** (closed): Move sim/open-loop-ac/klt/run.sh onto klt_run_common.sh: last hand-copied klt wrapper, missing reservation/no-clobber/identity
- **PR #272**: refactor: consolidate serialized-cell checkers into one _cell_problem helper
- **Issue #271** (closed): Consolidate the four serialized-cell checkers in characterization generate.py into one helper
- **PR #270**: docs(signoff): count PSRR's complete klt sim request in item-5 summary
- **Issue #99** (closed): sim: express the PSRR bench as a klt sim request (T1 item 5 coverage, follow-up to #85)

### 2026-10-17

- **PR #267**: feat(signoff): cite klt sim envelopes for T1 item 5 with declared gaps
- **Issue #266** (closed): T1 item 5: cite the committed klt sim envelopes as a multi-row citation with declared gaps (klayout-tools#2959)
- **PR #263**: docs: record completed PR #27 authority search in DR-0009
- **PR #258**: refactor: share raw-artifact pin validation and read loop across characterization families
- **Issue #256** (closed): Collapse triplicated raw-artifact pin validation and pin-check/read loops in characterization generate.py
- **PR #261**: docs: add offset analysis to the design-margin plan
- **Issue #239** (closed): Prepare the offset-margin contribution to #101 while retaining the literal 21.9 mV limit
- **PR #259**: docs: plan four-row design margin and record literal-limit direction
- **PR #257**: refactor: delegate open-loop-ac index_envelope to shared klt_envelope gate
- **Issue #255** (closed): Remove duplicated index_envelope body in open-loop-ac compare.py (delegate to klt_envelope)
- **PR #253**: refactor: move open-loop-ac compare.py onto shared klt_envelope helpers
- **Issue #252** (closed): Consolidate open-loop-ac compare.py onto shared klt_envelope (drop ~65 LOC of duplicated helpers)

### 2026-10-16

- **PR #250**: sim: join PSRR Av0 from the open-loop klt sim envelope
- **PR #248**: sim: commit 45-corner klt sim envelopes for the open-loop AC bench
- **Issue #85** (closed): sim: express the open-loop AC bench as a `klt sim` request, the first gradable envelope toward T1 item 5

### 2026-10-15

- **PR #102**: sim: open-loop AC bench as klt sim AC + OP requests with a harness comparison (no envelope yet: fleet runner klt 0.5.0)
- **PR #243**: sim: AC-ground inn in the open-loop AC and PSRR benches; re-run 45 corners on the batch fleet
- **Issue #241** (closed): sim: open-loop AC bench leaves inn AC-floating (Lbreak with no C to ground) -- GBW about halved, PM overstated, parasitic-sensitive
- **PR #242**: sim: #237 fingering probe (inn-grounded diagnostic) + DR 0008 option 1; bench defect filed as #241
- **PR #240**: sim: input-offset (systematic) klt sim request and real 45-corner envelope (T1 item 5, #97)
- **Issue #97** (closed): sim: express the input-offset bench (systematic half) as a klt sim request (T1 item 5 coverage, follow-up to #85)
- **PR #238**: sim: real 45-corner slew-rate klt sim envelope + harness comparison (T1 item 5, #95)
- **Issue #95** (closed): sim: express the slew-rate bench as a klt sim request (T1 item 5 coverage, follow-up to #85)
- **PR #236**: feat(signoff): 45-corner post-layout pex run as uncited evidence; item 7 not met (#86)
- **PR #235**: sim: real 45-corner input-noise klt envelope + measured comparison (#96)
- **Issue #96** (closed): sim: express the input-noise bench as a klt sim request (T1 item 5 coverage, follow-up to #85)

### 2026-10-14

- **Issue #43** (closed): README: embed the fleet burndown chart (one line)

### 2026-10-13

- **PR #164**: ci: protect nested klt record trees with the append-only evidence gate
- **Issue #161** (closed): ci: protect nested klt record trees with the append-only evidence gate

### 2026-10-12

- **PR #231**: Audit output-swing summary against pinned DC curves (#230)
- **Issue #230** (closed): characterization: audit output-swing summaries against pinned DC curves

### 2026-10-11

- **PR #229**: Audit slew-rate summary against pinned transient waveforms (#227)
- **Issue #223** (closed): Auditor guard review: keep gh-api-rawfield-body-literal-at flagged
- **Issue #227** (closed): characterization: rederive slew measurements from pinned transient waveforms
- **PR #228**: sim: freeze admitted AC source bytes for all consumer lookups
- **Issue #226** (closed): sim: freeze admitted AC source bytes for all consumer lookups
- **PR #225**: sim: admission check for cross-record AC joins (#224)
- **Issue #224** (closed): sim: validate circuit and model compatibility before joining AC evidence
- **PR #220**: sim: refresh observed ngspice version before finalizing records
- **Issue #212** (closed): sim: refresh observed ngspice version before finalizing records
- **PR #219**: sim: detect live OSDI binary replacement at record finalization
- **Issue #218** (closed): sim: detect live OSDI binary replacement at record finalization
- **PR #217**: sim: bind native input-noise records to observed model identity
- **Issue #214** (closed): sim: bind native input-noise records to observed model identity
- **PR #216**: characterization: audit input-noise summaries against pinned logs and spectra
- **Issue #213** (closed): characterization: audit input-noise summaries against pinned logs and spectra
- **PR #211**: sim: refuse record finalization when model identity drifts during a run
- **Issue #209** (closed): sim: refuse record finalization when model identity drifts during a sweep
- **PR #210**: characterization: audit CMRR statistics against pinned raw sample populations
- **Issue #208** (closed): characterization: audit CMRR statistics against pinned raw sample populations
- **PR #207**: characterization: serialize mint publication behind a no-clobber store lock
- **Issue #205** (closed): characterization: reserve report publication to prevent concurrent mint overwrite
- **PR #206**: record-paths: exclude concurrent writers of one record (flock)
- **Issue #204** (closed): cmrr-mismatch: exclude concurrent writers when resuming a campaign
- **PR #202**: ci: gate byte-for-byte layout regeneration on the pinned PDK and klt
- **Issue #201** (closed): ci: run layout/opamp_core generate.py --check now that the PDK is provisioned in CI
- **PR #203**: characterization: audit offset MC statistics against the pinned draws
- **Issue #199** (closed): characterization: verify offset MC statistics against the recorded draws
- **PR #197**: ci: fail simulation test discovery on partial enumeration errors
- **Issue #195** (closed): ci: fail simulation test discovery on partial enumeration errors
- **PR #200**: characterization: validate reported load against selected source evidence
- **Issue #194** (closed): characterization: validate reported load against selected source evidence
- **Issue #193** (closed): Auditor guard telemetry: gh-api-rawfield-body-literal-at
- **PR #192**: characterization: bind PDK identity to finalized simulation records
- **Issue #191** (closed): characterization: bind PDK identity to finalized simulation records
- **PR #196**: ci: verify schematic-to-netlist regeneration (#190)
- **Issue #190** (closed): ci: verify schematic-to-netlist regeneration before trusting downstream evidence
- **PR #189**: ci(signoff): discover signoff tests per directory (incl. test_regenerate.py)
- **Issue #180** (closed): CI: signoff/test_regenerate.py is never run; discover all tests instead of hand-listing
- **Issue #170** (closed): Auditor guard telemetry: gh-api-rawfield-body-literal-at
- **PR #198**: sim: pin output-swing integrity bounds in the envelope gate
- **Issue #154** (closed): sim: pin output-swing integrity bounds in the envelope gate

### 2026-10-10

- **PR #186**: input-cmr: consolidate raw-curve reader and fine hi-bound crossing into cmr_analysis.py
- **Issue #183** (closed): input-cmr: consolidate repeated raw-curve readers and fine upper-bound crossing
- **PR #185**: sim: bind OSDI build reuse to source and compiler provenance
- **Issue #182** (closed): sim: bind OSDI build reuse to source and compiler provenance
- **PR #184**: Consolidate harness CSV loader across four klt compare.py benches
- **Issue #181** (closed): Consolidate harness CSV loader duplicated across four klt compare.py scripts
- **PR #178**: output-swing: move compare.py onto shared klt_envelope gate and run_cli
- **Issue #176** (closed): Finish #142: move output-swing compare.py onto shared klt_envelope gate and run_cli
- **PR #179**: cmrr-mismatch: validate raw sample finiteness and unique OP/AC pairs
- **Issue #174** (closed): cmrr-mismatch: validate raw sample finiteness and unique OP/AC pairs
- **PR #177**: sim: reserve klt wrapper record destinations before submitting runs
- **Issue #171** (closed): sim: reserve klt wrapper record destinations before submitting runs

### 2026-10-10

- **Issue #141** (closed): yield-inputs: validate offset draw identities and gate sample-set reproducibility in CI
- **Issue #107** (closed): cmrr-mismatch: persist per-draw samples so T1 item 6 can be evidenced with klt yield
- **Issue #146** (closed): Dedup the compare.py CLI scaffold left after #142 (main/_tol/load_envelope x3)
- **Issue #151** (closed): Consolidate duplicated klt run.sh and compare.py across sim benches
- **Issue #157** (closed): signoff: honor the committed klt pin in local re-grading
- **Issue #158** (closed): signoff: publish verdict records atomically only after successful grading
- **Issue #162** (closed): integration: validate published port order and ratified bounds against their sources
- **Issue #135** (closed): Auditor guard telemetry: retain literal body path protection
- **Issue #155** (closed): characterization: validate the complete ratified bound instead of numeric substrings
- **Issue #166** (closed): input-offset: reject non-finite and malformed Monte Carlo sweep data
- **Issue #163** (closed): cmrr-mismatch: bind resumed campaigns to their original inputs
- **Issue #167** (closed): Auditor guard telemetry: scoped staging cleanup flagged inside source edit
- **PR #148**: yield-inputs: validate offset draw identities and gate sample-set reproduction in CI
- **PR #149**: sim: per-draw CMRR draws CSV from committed samples (Closes #107)
- **PR #150**: sim: share the compare.py CLI scaffold in klt_envelope (Closes #146)
- **PR #152**: sim: PSRR supply-gain 45-corner fleet envelope, shard bridge, measured comparison (Part of #99)
- **PR #153**: sim: output-swing one-point klt sim prototype, offline comparator and negative controls
- **PR #156**: sim: share the klt run.sh wrapper steps (Closes #151)
- **PR #159**: signoff: honor the committed klt pin in local re-grading
- **PR #160**: signoff: publish verdict records atomically only after successful grading
- **PR #165**: signoff: validate integrator ports and ratified bounds against their sources
- **PR #168**: characterization: validate complete ratified bound against cited clause
- **PR #172**: input-offset: reject non-finite and malformed MC sweep data
- **PR #173**: cmrr-mismatch: bind resumed campaigns to their original inputs

### 2026-10-10

- **Issue #142** (closed): Dedup the copy-pasted envelope validation core across sim/*/klt/compare.py
- **PR #145**: sim: share the klt envelope gate across sim/*/klt/compare.py
- **Issue #140** (closed): sim: reserve record IDs atomically and refuse overwriting finalized evidence
- **PR #144**: sim: reserve record IDs atomically and refuse overwriting finalized evidence
- **Issue #106** (closed): Install ratification/ee-key and ratification/market-key reviewer trees (product#151)
- **PR #143**: ratification: install ee-key and market-key reviewer trees (#106)
- **Issue #136** (closed): signoff: enforce LVS reference freshness from schematic netlist to recorded match
- **PR #138**: signoff: enforce LVS reference freshness from schematic netlist to recorded match
- **PR #139**: sim: PSRR supply-gain klt sim request, runner and comparator (first increment)
- **Issue #134** (closed): signoff: bind ERC supply-spec bytes to the structural power-delivery evidence
- **PR #137**: signoff: bind ERC supply-spec bytes to item-11 evidence
- **PR #133**: sim: one-corner DUT prototype of the input-noise klt sim request (Part of #96)
- **Issue #98** (closed): sim: express the ratified mismatch-inclusive CMRR row as klt sim evidence (T1 item 5 coverage, follow-up to #85)
- **Issue #123** (closed): Auditor guard review: temporary scratch variables blocked by worktree confinement

### 2026-10-09

- **Issue #122** (closed): Auditor Capability Request: Python unavailable for offline signoff validation
- **PR #130**: sim: input-noise bench as a klt sim request (Part of #96, first increment)
- **PR #128**: spec: draft reproducible GDS bounding-box area definition for TBD-12
- **PR #127**: post-layout: klt-sim-based measure command for item 7 (partial; run blocked by batch runner mismatch) (#86)
- **PR #126**: signoff: post-layout pex harness for T1 item 7 (partial, #86)
- **PR #125**: ci: enforce append-only evidence against the previous Git tree
- **PR #120**: ci: run sim/ offline tests and evidence checkers in signoff.yml
- **PR #118**: sim: express the slew-rate bench as a klt sim request (T1 item 5, #95)
- **PR #117**: spec: draft DR-0006 resolving the ICMR row (not ratified)
- **PR #116**: post-layout: klt pex harness for T1 item 7 (#86) - grid NOT run
- **PR #113**: test(signoff): negative controls for check_signoff.py and sync_integrator.py
- **PR #112**: sim: guard MC runners against local grid execution under batch backend
- **PR #109**: signoff: record why T1 item 6 stays unmet; stage offset-MC sample-set (#105)
- **PR #104**: feat(signoff): continuously validate the item 1/9/10 inventory entries
- **PR #103**: integration: synchronize published GDS availability and graded maturity
- **PR #94**: signoff: per-spec-row characterization report from committed evidence (T1 item 8)
- **Issue #115** (closed): spec: select an area definition (resolve TBD-12) now that a DRC-clean routed GDS exists
- **Issue #121** (closed): ci: enforce append-only evidence against the previous Git tree
- **Issue #119** (closed): ci: run the sim/ offline tests and evidence checkers in signoff.yml
- **Issue #114** (closed): spec: resolve the unratified ICMR row -- measured lower bound excludes mid-rail Vcm at 15 of 45 PVT points
- **Issue #111** (closed): signoff: negative-control tests for check_signoff.py and sync_integrator.py
- **Issue #110** (closed): sim: guard MC runners against local grid execution when KLT_SIM_BACKEND=batch
- **Issue #92** (closed): signoff: continuously validate the static audit inventory entries
- **Issue #91** (closed): integration: synchronize published GDS availability and graded maturity
- **Issue #90** (closed): characterization: generate a reproducible per-row report from committed evidence
- **Issue #89** (closed): Auditor guard review: keep literal body=@path rejection

### 2026-10-08

- **PR #88**: signoff: bind T1 items 1, 9 and 10 to audited artifacts (klt 3a75c3ae)
- **Issue #84** (closed): signoff: bind T1 items 1, 9 and 10 to audited artifacts (klayout-tools#2718 landed)

### 2026-10-03

- **Issue #71** (closed): Retire the scaffold_smoke fixture: its DRC coverage is a strict subset of opamp_core's, and nothing cites it
- **PR #81**: Retire scaffold_smoke fixture; relocate DRC-deck negative control

### 2026-09-29

- **Issue #78** (closed): Wire the remaining sim/*/run_*.sh sed-render callers onto sg13g2_render_netlist (PR #77's helper missed 6 sites)
- **Issue #29** (closed): T1 item 11 (power delivery, structural): no klt erc supply spec or report in this repo
- **PR #80**: feat(signoff): klt erc supply spec + report for T1 item 11 (power delivery)
- **PR #79**: sim: wire remaining sed-render callers onto sg13g2_render_netlist

### 2026-09-28

- **Issue #74** (closed): Bench convergence fragility at tightened ngspice reltol — standing gate from DR-0005
- **Issue #73** (closed): Extract duplicated render() sed-template helper from run_*.sh into sim/preflight.sh
- **Issue #68** (closed): Decide whether sim/ benches should pin a tighter ngspice reltol (gm/ID's ~20% cross-host gds spread is tolerance-limited, and removable for free)
- **Issue #65** (closed): The committed gm/ID record does not reproduce numerically on a second host (up to ~20% on gm_gds)
- **Issue #64** (closed): sim/input-cmr/run_cmr_sweep.sh is committed non-executable, so its own documented invocation fails
- **Issue #62** (closed): Remove four unused layout/ accessors and the vestigial MIM-patch alias in scaffold_smoke
- **Issue #61** (closed): Extract duplicated sim_broken/latest_csv_in/csv_lookup helpers from run_*.sh into sim/preflight.sh
- **Issue #60** (closed): Dedup the ngspice broken-sim regex across 11 sites in sim/*/run_*.sh — gm-id's copy has drifted narrower
- **Issue #59** (closed): Remove duplicated run_drc(): consolidate into devices.py
- **Issue #57** (closed): layout: LVS the routed opamp_core GDS against the schematic netlist (T1 item 4)
- **Issue #56** (closed): Extract duplicated RECORD_ID/output-path boilerplate from sim/*/run_*.sh into sim/preflight.sh
- **Issue #54** (closed): Dedup MOS corner list: 10 identical CORNERS arrays across sim/*/run_*.sh
- **Issue #52** (closed): Remove duplicated run_drc(): identical klt-drc + report-write logic in layout/opamp_core and layout/scaffold_smoke
- **Issue #50** (closed): signoff: the layout's byte-for-byte regeneration claim is not enforced by CI, only the committed hash is
- **Issue #47** (closed): sim: extract the duplicated run_*.sh preflight preamble (env.sh source, OSDI/ngspice/netlist checks) into one shared sourced helper
- **Issue #45** (closed): layout: first-cut drawn-and-routed opamp_core GDS with a committed generator and klt drc report (T1 items 2-3)
- **Issue #44** (closed): layout: sg13g2 drawing/routing scaffold in layout/ (LV core MOS + MIM cap primitives, DRC-clean smoke fixture)
- **PR #77**: sim: extract duplicated render() sed-template helper into sim/preflight.sh
- **PR #76**: feat: warn when the live ngspice diverges from sim/pdk.json's pin
- **PR #75**: docs: keep default ngspice reltol, record tolerance study as DR-0005
- **PR #72**: sim: consolidate the record-join helpers into sim/preflight.sh
- **PR #70**: refactor: drop unused layout accessors and the scaffold_smoke MIM-patch alias
- **PR #69**: docs(gm-id): document the cross-host reproducibility envelope and identify its cause
- **PR #67**: fix: mark sim/input-cmr/run_cmr_sweep.sh executable (100644 -> 100755)
- **PR #66**: feat: add committed klt lvs compare for opamp_core (T1 item 4)
- **PR #63**: refactor: move the ngspice broken-sim gate into sim/preflight.sh
- **PR #58**: sim: hold the record-id and output-path preamble once in sim/preflight.sh
- **PR #55**: refactor: hold the MOS corner set once in sim/preflight.sh
- **PR #53**: refactor: consolidate the duplicated run_drc into layout/devices.py
- **PR #51**: signoff: state the layout regeneration claim as documented-provenance, not CI-enforced
- **PR #49**: layout: drawn-and-routed opamp_core GDS with a committed generator and klt drc report (T1 items 2-3)
- **PR #48**: sim: extract duplicated run_*.sh preflight preamble into sim/preflight.sh
- **PR #46**: feat: SG13G2 drawing/routing scaffold in layout/ (LV core MOS + MIM cap primitives, DRC-clean smoke fixture)

### 2026-09-22

- **Issue #41** (closed): Remove empty measurements/ scaffold: its role was absorbed by sim per-bench records
- **Issue #37** (closed): 2am: reuse rule 9 — name this block's consumers in the spec, carry their requirement rows, publish the integrator view as data
- **Issue #30** (closed): docs: input-noise README non-claim bullet predates the DR-0002 ratification (noise row is [DR-2], not [P])
- **PR #42**: chore: remove empty measurements/ scaffold (#41)
- **PR #40**: docs(spec): record consumers with per-row verdicts, publish integrator view as data
- **PR #39**: docs: past-tense the input-noise non-claim bullet after DR-0002

### 2026-09-21

- **Issue #32** (closed): spec: re-ratify the CMRR row on the mismatch-inclusive 3σ record (DR-0002 residual (c), two-key)
- **Issue #26** (closed): sim: mismatch Monte Carlo CMRR evidence for the DR-1 op-amp (companion to #17)
- **Issue #23** (closed): Commit a klt signoff block manifest so this block's T1 state is graded, not hand-read
- **Issue #21** (closed): sim: input common-mode range (ICMR) characterization bench
- **Issue #19** (closed): design: decide whether to re-size the input pair for flicker noise (1/f corner measured above the whole noise band)
- **Issue #17** (closed): sim: Monte Carlo statistical evidence for input-referred offset (seed/N/negative control)
- **Issue #16** (closed): spec: ratify target-spec.md via the two-key (EE + market) mechanism
- **Issue #15** (closed): sim: output-swing bench for the DR-1 op-amp
- **Issue #14** (closed): sim: CMRR/PSRR bench for the DR-1 op-amp
- **PR #36**: docs: re-ratify the CMRR row on the mismatch-inclusive 3σ record (DR-4)
- **PR #35**: sim: add mismatch Monte Carlo offset evidence for the DR-1 op-amp
- **PR #34**: sim: add input common-mode range (ICMR) PVT bench for the DR-1 op-amp
- **PR #33**: sim: add mismatch Monte Carlo CMRR evidence for the DR-1 op-amp
- **PR #31**: feat(signoff): add a klt-graded T1 signoff verdict of record
- **PR #28**: docs: decide input-pair flicker-noise re-size (declined) in DR-0003
- **PR #27**: spec: ratify measured target-spec rows via two-key DR-0002
- **PR #25**: sim: add CMRR/PSRR+ PVT bench for the DR-1 op-amp
- **PR #24**: sim: add output-swing PVT bench for the DR-1 op-amp

### 2026-09-18

- **Issue #13** (closed): sim: input-referred noise bench for the DR-1 op-amp (choose band, then measure)
- **Issue #12** (closed): sim: slew-rate (large-signal step) bench for the DR-1 op-amp
- **Issue #11** (closed): sim: input-referred offset bench (deterministic, corner-only) for the DR-1 op-amp
- **PR #22**: sim: add slew-rate (large-signal step) PVT bench for the DR-1 op-amp
- **PR #20**: sim: add input-referred noise PVT bench, choose the noise band
- **PR #18**: feat(sim): add deterministic PVT input-referred offset bench

### 2026-09-10

- **Issue #9** (closed): design: first-cut gm/ID sizing + xschem schematic of the DR-0001 two-stage Miller op-amp, with an open-loop gain/GBW/PM bench into CL = 2 pF across the five-corner grid
- **PR #10**: feat: first-cut gm/ID sizing, xschem schematic, and open-loop AC bench for DR-0001 op-amp

### 2026-09-09

- **Issue #6** (closed): spec: topology + CL decision record, informed by gm/ID study (issue #5)
- **Issue #5** (closed): sim: gm/ID characterization sweep of SG13G2 LV core MOS — the first engineering task (porting-plan §4, gm/ID-first)
- **PR #8**: spec: ratify two-stage topology and CL target (DR-1)
- **PR #7**: sim: gm/ID characterization sweep of SG13G2 LV core MOS (issue #5)
