2AMLogic/sg13g2-opamp/(commit log)

2026-09-05 Initial commit: a two-stage miller-compensated operational amplifier on ihp sg13g2
    Scaffolds the block: spec, schematics, ngspice sim, and klayout-tools-driven
    layout signoff. Wave-5 canary (2am#689, operator-approved 2026-09-05).
    IHP SG13G2 two-stage OTA. Fundamental-analog gap fill on the thinnest foundry.
    Apache-2.0. Nothing designed yet.
    Claude-Session: https://claude.ai/code/session_01JhTeitSU4grgVCvMJ13XAg
2026-09-05 feat(champion): standing authorization for design-evidence auto-merge (#6850)
    Operator ruling 2026-09-05: Judge-approved, green-CI PRs whose entire
    changed-file set lives in design/, sim/, layout/, measurements/,
    verification/, or docs/ auto-merge without the four-axis human hold.
    Rationale: canary design evidence is fully revertible with no fleet-infra
    blast radius, and the held-PR pattern (sky130-sar-adc#123 sat mergeable for
    days as the sole blocker of a layout chain) costs more than it protects
    here. spec/ and every tool surface fall outside the patterns, so the
    exact-subset rule keeps them on the four-axis judgment automatically.
    C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
2026-09-09 sim: gm/ID characterization sweep of SG13G2 LV core MOS (issue #5) (#7)
    Adds sim/gm-id-characterization/, the first gm/ID device-characterization
    study in the fleet: gm/Id, gm/gds, Cgg and fT vs Vgs/overdrive for
    sg13_lv_nmos/sg13_lv_pmos, across four channel lengths (Lmin=0.13um and
    2x/4x/8x multiples) and all five cornerMOSlv.lib process corners. Follows
    CLAUDE.md's "gm/ID first" ordering and spec/porting-plan.md §4's next-step
    naming; feeds the gm/ID-dependent rows in spec/target-spec.md once a
    topology exists to size (tracked as a follow-up, issue #6).
    Also adds sim/env.sh, sim/pdk.json and sim/tools/build-osdi.sh (structurally
    reused from sg13g2-bandgap's own PDK-environment/OSDI-buil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
    [20260909-063633-b402592.csv, nmos_0.13u_mos_ff_dc.csv, nmos_0.13u_mos_fs_dc.csv, nmos_0.13u_mos_sf_dc.csv, nmos_0.13u_mos_ss_dc.csv, nmos_0.13u_mos_tt_dc.csv, nmos_0.26u_mos_ff_dc.csv, nmos_0.26u_mos_fs_dc.csv]
2026-09-09 spec: ratify two-stage topology and CL target (DR-1) (#8)
    Adds this repo's first decision record (spec/decision-records/0001-topology-and-cl.md,
    following sg13g2-bandgap's NNNN-<slug>.md convention) choosing an NMOS input
    pair, a non-cascoded PMOS-gain-device Class-A common-source output stage,
    and a 2 pF CL target -- each grounded in specific gm/Id, gm/gds and fT rows
    from sim/gm-id-characterization/records/*.csv (issue #5). Ratifies
    target-spec.md's [TBD-1] (corner grid) and [TBD-2] (CL) rows to [DR-1], and
    updates porting-plan.md Sec 4 to mark both open items resolved.
    Closes #6
2026-09-10 feat: first-cut gm/ID sizing, xschem schematic, and open-loop AC PVT bench for the DR-0001 op-amp (#10)
    Sizes every device of the DR-0001 two-stage Miller op-amp topology from
    sim/gm-id-characterization's gm/ID data (design/opamp_sizing.md), builds
    the xschem schematic/netlist (design/opamp_core.sch, .sym, xschemrc,
    netlist/opamp_core.spice), and measures Av0/GBW/phase margin/gain margin/Iq
    across the full 45-point PVT grid with a real ngspice+OSDI simulation
    (sim/open-loop-ac/), landing spec/target-spec.md's first [P]-tagged
    measured values for DC gain, GBW, phase margin and quiescent power.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
    [20260910-221601-22feaba.csv, mos_ff_-40C_1.08V_ac.csv, mos_ff_-40C_1.20V_ac.csv, mos_ff_-40C_1.32V_ac.csv, mos_ff_125C_1.08V_ac.csv, mos_ff_125C_1.20V_ac.csv, mos_ff_125C_1.32V_ac.csv, mos_ff_27C_1.08V_ac.csv]
2026-09-18 feat(sim): add deterministic PVT input-referred offset bench (#18)
    Add sim/input-offset/, a corner-only (no Monte Carlo, no mismatch deck) DC
    input-referred offset characterization of design/opamp_core.sch on the same
    45-point cornerMOSlv.lib mos_tt/ss/ff/sf/fs x {-40,27,125} C x
    {1.08,1.20,1.32} V grid sim/open-loop-ac/ uses, following the established
    per-experiment shape (README.md / testbench/ / corners/ /
    netlist-snapshots/ / records/).
    Offset is measured two independent ways at every grid point:
    1. Primary -- open-loop differential-input null sweep: Vid = V(inp)-V(inn)
    swept with the input common mode pinned at VDD/2, reporting the Vid at
    which Vout crosses mid-rail. Coarse loca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
    [20260918-203858-90844d2.csv, mos_ff_-40C_1.08V_null_coarse.csv, mos_ff_-40C_1.08V_null_fine.csv, mos_ff_-40C_1.20V_null_coarse.csv, mos_ff_-40C_1.20V_null_fine.csv, mos_ff_-40C_1.32V_null_coarse.csv, mos_ff_-40C_1.32V_null_fine.csv, mos_ff_125C_1.08V_null_coarse.csv]
2026-09-18 sim: add input-referred noise PVT bench, choose the noise band (issue #13) (#20)
    Adds sim/input-noise/ (README, testbench/tb_noise.spice.tmpl,
    run_noise_sweep.sh, and a committed 45-point PVT record) that runs an
    ngspice `.noise` analysis on design/opamp_core.sch in a unity-gain
    closed-loop configuration across the full mos_tt/ss/ff/sf/fs x
    {-40,27,125} C x {1.08,1.20,1.32} V grid. Chooses the previously-unset
    noise band/metric (100 Hz - 1 MHz integrated, plus five spot densities),
    citing the sky130-opamp twin's proposed band and gf180-bandgap's ratified
    metric shape as precedent, with bounds defended against this design's own
    measured GBW and 1/f-dominated spectrum. Updates spec/target-spec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
    [20260918-203850-90844d2.csv, mos_ff_-40C_1.08V_noise.csv, mos_ff_-40C_1.08V_noise_wide.csv, mos_ff_-40C_1.20V_noise.csv, mos_ff_-40C_1.20V_noise_wide.csv, mos_ff_-40C_1.32V_noise.csv, mos_ff_-40C_1.32V_noise_wide.csv, mos_ff_125C_1.08V_noise.csv]
2026-09-18 sim: add slew-rate (large-signal step) PVT bench for the DR-1 op-amp (#22)
    Adds sim/slew-rate/ (README, testbench/tb_slew.spice.tmpl,
    run_slew_sweep.sh, and a committed 45-point PVT record) measuring
    rising/falling large-signal slew rate into CL = 2 pF [DR-1] across the
    full mos_tt/ss/ff/sf/fs x {-40,27,125} C x {1.08,1.20,1.32} V grid.
    Drives design/opamp_core.sch's DUT open-loop via the same ideal-inductor
    DC-bias trick sim/open-loop-ac/ uses, plus an antiphase large-signal step
    at both inputs so the input common mode stays fixed at VDD/2 while the
    output slews rail-to-rail. Confirms the spec's predicted binding corner
    (SS / -40C / low VDD) against measurement. Updates spec/target-spec.md'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
    [20260918-210216-90844d2.csv, mos_ff_-40C_1.08V_tran.csv, mos_ff_-40C_1.20V_tran.csv, mos_ff_-40C_1.32V_tran.csv, mos_ff_125C_1.08V_tran.csv, mos_ff_125C_1.20V_tran.csv, mos_ff_125C_1.32V_tran.csv, mos_ff_27C_1.08V_tran.csv]
2026-09-21 sim: add output-swing PVT bench for the DR-1 op-amp (#24)
    * sim: add output-swing PVT bench for the DR-1 op-amp
    Measure the DC output swing of design/opamp_core.spice into CL = 2 pF
    [DR-1] across the full 45-point cornerMOSlv.lib PVT grid, from the
    open-loop differential DC transfer curve (input common mode pinned at
    VDD/2) with the linear region's rail-ward bounds read at the -6 dB
    incremental-gain criterion -- reported as headroom from VDD and VSS so
    the figures compare across the supply grid. The record carries the
    tracking bounds, span and hard-clipped reach per point, plus per-point
    cross-checks against the open-loop-ac and input-offset records
    (Vos crossing agreement <= 0.65 nV, peak-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
    [20260921-151759-707b34c.csv, mos_ff_-40C_1.08V_coarse.csv, mos_ff_-40C_1.08V_fine.csv, mos_ff_-40C_1.20V_coarse.csv, mos_ff_-40C_1.20V_fine.csv, mos_ff_-40C_1.32V_coarse.csv, mos_ff_-40C_1.32V_fine.csv, mos_ff_125C_1.08V_coarse.csv]
2026-09-21 sim: add CMRR/PSRR+ PVT bench for the DR-1 op-amp (#25)
    Adds sim/cmrr-psrr/ (README, testbench/tb_cmrr.spice.tmpl,
    testbench/tb_psrr.spice.tmpl, run_cmrr_psrr_sweep.sh, and a committed
    45-point PVT record) measuring common-mode and positive-supply
    rejection of design/opamp_core.sch into CL = 2 pF [DR-1] across the
    full mos_tt/ss/ff/sf/fs x {-40,27,125} C x {1.08,1.20,1.32} V grid,
    two ngspice AC harnesses per point. Both harnesses reuse
    sim/open-loop-ac/'s self-biased DC topology (Lbreak = 1e18 H) and
    divide the SAME grid point's Av0 out of sim/open-loop-ac/'s committed
    record (joined per point, cross-checked against both harnesses' and
    the record's own DC operating points -- agreement is ex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
    [20260921-151815-707b34c.csv, mos_ff_-40C_1.08V_cmrr_ac.csv, mos_ff_-40C_1.08V_psrr_ac.csv, mos_ff_-40C_1.20V_cmrr_ac.csv, mos_ff_-40C_1.20V_psrr_ac.csv, mos_ff_-40C_1.32V_cmrr_ac.csv, mos_ff_-40C_1.32V_psrr_ac.csv, mos_ff_125C_1.08V_cmrr_ac.csv]
2026-09-21 feat(signoff): add a klt-graded T1 signoff verdict of record (#31)
    * feat(signoff): grade this block's T1 state via klt signoff, committed
    Add signoff/ holding a klt signoff --manifest block manifest (block
    sg13g2-opamp, kind analog, no citations yet), the offline checker that
    keeps manifest pins and the graded record honest (check_signoff.py), the
    pinned klayout-tools revision the checklist is graded at (klt-pin.txt),
    the append-only record-minting command (regenerate.sh), and the
    per-item gap disclosures in signoff/README.md.
    With no klt-gradable envelope in this repo yet, every T1 row renders
    no_evidence -- the honest machine-readable statement of the gap-to-T1
    state that issue #3's han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
2026-09-21 sim: add mismatch Monte Carlo CMRR evidence for the DR-1 op-amp (#33)
    Mismatch-inclusive CMRR for design/opamp_core.sch on the 45-point PVT
    grid: the sim/cmrr-psrr/ CMRR harness re-run with SG13G2's own
    per-corner mismatch decks, 300 seed-deterministic draws per point, a
    per-point zero-mismatch negative control asserted against the committed
    systematic record, and the +3-sigma-of-Acm bound per point (record
    20260921-172304-65f5fb4: envelope 26.68-37.57 dB, binding at
    SS / -40 C / 1.08 V). Updates spec/target-spec.md's CMRR row with the
    mismatch-inclusive [P] evidence and files the two-key re-ratification
    follow-up (#32, DR-0002 residual (c)).
    Closes #26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
    [20260921-172304-65f5fb4.csv]
2026-09-21 sim: add input common-mode range (ICMR) PVT bench for the DR-1 op-amp (#34)
    * sim: add input common-mode range (ICMR) PVT bench for the DR-1 op-amp
    Add sim/input-cmr/, the input common-mode range characterization bench for
    design/opamp_core.sch, following the per-experiment shape and 45-point
    PVT-grid harness conventions the sibling benches established. The bench
    sweeps the input common mode with the differential input pinned at zero
    and reports, per corner, the saturation-limited lower bound (v(tail) =
    Vdsat(M5), tail knee measured by a same-bias replica probe) and upper
    bound (pair Vds >= Vgs - Vth, Vth measured per the gm/ID constant-current
    convention at the bound's true body bias via a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
    [20260921-174405-65f5fb4.csv, mos_ff_-40C_1.08V_coarse.csv, mos_ff_-40C_1.08V_finehi.csv, mos_ff_-40C_1.08V_finelo.csv, mos_ff_-40C_1.08V_mech_m5.csv, mos_ff_-40C_1.08V_mech_p_centre.csv, mos_ff_-40C_1.08V_mech_p_r2.csv, mos_ff_-40C_1.08V_mech_p_r3.csv]
2026-09-21 sim: add Monte Carlo mismatch campaign for input-referred offset (#35)
    Add run_offset_mc.sh + tb_offset_mc.spice.tmpl to sim/input-offset/: a
    seeded device-mismatch Monte Carlo campaign (N = 300 draws per point,
    16 points = all five cornerMOSlv.lib corner families x {-40, 27, 125} °C
    at the fixed 1.20 V supply on the <corner>_mismatch sections -- mismatch
    combined with, not instead of, the process corners -- plus a plain-section
    negative control) measuring the random 3-sigma term of the input-referred
    offset that issue #11's deterministic bench cannot see. The campaign joins
    the deterministic record's per-point systematic values and hard-gates every
    run on three self-checks: a zero-spread n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
    [mc-20260921-174056-0a509fb-draws.csv, mc-20260921-174056-0a509fb.csv]
2026-09-21 docs: re-ratify the CMRR row on the mismatch-inclusive 3-sigma record (DR-0004) (#36)
    Add spec/decision-records/0004-cmrr-mismatch-inclusive-ratification.md:
    the two-key (RATIFY-KEY: ee / market) re-ratification that discharges
    DR-0002 residual (c) by citing #26's landed record
    sim/cmrr-mismatch/records/20260921-172304-65f5fb4.{csv,md} -- the
    +3-sigma-of-Acm envelope 26.68 dB worst / 37.57 dB best, binding at
    SS / -40 C / 1.08 V -- and binding it as the CMRR row's new ratified
    bound (>= 26.68 dB worst-case), superseding the >= 30.75 dB systematic
    floor, which stays in-row as context per the value-tag convention.
    The record states the definition that is part of the ratified number
    (Av0 minus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
2026-09-22 docs: past-tense the input-noise non-claim bullet after DR-0002 (#39)
    The first "What this bench does not claim" bullet still described the
    spec noise row as `[P]` under a `Status: DRAFT` header. That went stale
    when DR-0002 (issue #16, PR #27, 65f5fb4) ratified the row: it now
    carries the [DR-2] bound <= 108.9 uVrms worst-case (100 Hz - 1 MHz)
    under `Status: RATIFIED (partial)`. The bullet stays a non-claim --
    the ratification instrument is DR-0002, not this bench record.
    Closes #30
2026-09-22 docs(spec): record consumers with per-row verdicts, publish integrator view as data (#40)
    Names both repos declaring consumes: sg13g2-opamp in 2am/repos.yml @ 79b7cc6
    (sg13g2-bandgap @ 463c1af, sg13g2-ldo @ 4fbfa18), with requirement-row
    tables and meets / does-not-meet / unknown verdicts against the ratified
    spec; records sg13g2-bandgap's in-tree HV single-stage folded OTA as not
    the same block; publishes spec/integrator.json (top cell, ports, artifact
    paths, area TBD, T1 maturity 0/11 per signoff record 20260921-171207);
    files the sg13g2-ldo porting-plan 2.2 discrepancy on the consumer
    (sg13g2-ldo#50). No ratified row changes.
    Closes #37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
2026-09-22 chore: remove empty measurements/ scaffold (#41) (#42)
    The bootstrap-era measurements/ directory held only a 3-line placeholder
    README; its stated purpose (measured/derived results with evidence
    chains) is filled by the per-experiment sim/*/records/ directories that
    the ratified documents actually cite. spec/target-spec.md:41 already
    describes it in the past tense and remains true after removal.
    Closes #41
2026-09-28 feat: place and route opamp_core into a DRC-clean, connectivity-checked GDS
    Draws all nine instances of design/netlist/opamp_core.spice into one
    committed stream, layout/opamp_core/opamp_core.gds, with its klt drc
    --deck sg13g2 report committed beside it, and cites both from the T1
    signoff register.
    Layout
    - layout/opamp_core/floorplan.py holds every coordinate: three columns
    (stage 1 + bias, stage 2, the Miller cap), the Metal3 track ordinates
    and the Metal2 lanes. Two invariants are asserted at import time --
    M2 vertical / M3 horizontal, and one unique non-crowding ordinate per
    horizontal track -- so an M3-vs-M3 short is impossible by construction.
    - layout/opamp_core/generate.py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
2026-09-28 chore: mint the graded signoff record showing T1 items 2 and 3 met
    Appends signoff/reports/20260928-035820-fa7426a.signoff.json, rendered by
    `bash signoff/regenerate.sh` at the klt revision signoff/klt-pin.txt pins
    (0.5.0+gb15edf5e3a2e). t1_met_count moves 0 -> 2; exactly two rows flip,
    item 2 (Layout) and item 3 (DRC clean), and nothing else changes.
    t1_item_count stays 11 and the pin itself is untouched.
    `python3 signoff/check_signoff.py --run-klt` re-grades to this record
    verbatim both under the pinned klt 0.5.0 (via uvx, the revision CI
    installs) and under the host's 0.6.0+gd574697ed72c.
    Part of #45
    Loom-Story: 2AMLogic/sg13g2-op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
2026-09-28 layout: correct the routing-asymmetry disclosure and assert the B A A B order
    Judge review on #49 measured the block's actual track spans and found
    layout/README.md's "Routing asymmetry was corrected where it was largest"
    paragraph wrong in two ways. Both are claim defects, not geometry defects:
    the committed GDS, its DRC report and the signoff record are untouched and
    `generate.py --check` still reproduces the stream byte-for-byte.
    1. It claimed `inn`/`inp` were balanced. The balancing loop runs before the
    pin loop, and `PIN_SITES` then staggers `inp`'s pad to x = -10.00 against
    `inn`'s -8.00, re-introducing 2.000 um (12.6 %) on exactly the two
    differential input gate nets the par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
2026-09-28 refactor: consolidate the duplicated run_drc into layout/devices.py
    layout/opamp_core/generate.py and layout/scaffold_smoke/generate.py each
    carried a line-for-line identical run_drc(): the same `klt drc --deck sg13g2
    --format json` invocation, the same JSON parse, the same rewrite of the
    report's `file` field, the same write. That report shaping is what makes the
    byte-for-byte regeneration criterion hold on both committed streams, so it
    follows the precedent devices.patch_mim_bottom_plate already set -- exactly
    one implementation, or the two copies drift and only one committed report
    stays reproducible.
    The shared helper takes the paths it used to close over as parameters. Note
    that `gds`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
2026-09-28 feat: add committed klt lvs compare for opamp_core (T1 item 4)
    Turn the block's five mos_array guard rings into extraction-recognisable
    ties (pSD substrate implants over the three NMOS rings, nSD well implants
    over the two PMOS rings, with their NWell containment asserted), add the
    Metal3.text port labels the curated deck's metal_labels actually reads, and
    commit the LVS artifacts: an expanded plain-element reference netlist
    generated from generate.py's own tables (38 drawn units vs the schematic's
    9 lumped instances; options.combine_devices cannot fold them, klt #1185),
    the request, the regenerating script, and the klt lvs --format json report.
    Verdict: status match, 0 mismatches, body_veri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
2026-09-28 fix: mark sim/input-cmr/run_cmr_sweep.sh executable (100644 -> 100755)
    The ICMR harness was the only sim/**/run_*.sh committed non-executable,
    so the bare invocation its own README documents
    (sim/input-cmr/README.md:234, 'sim/input-cmr/run_cmr_sweep.sh') failed with
    Permission denied on a fresh checkout. Mode-only change; the blob is
    byte-identical (106843a).
    Closes #64
    Loom-Story: 2AMLogic/sg13g2-opamp#64
    Loom-Trace-Id: c5817e0aa48cbe9d5e928b54fe55d0af
    Loom-Build: 0.19.465 86e487686e2affc2e87f3f52c47445eb862266de clean
2026-09-28 docs(gm-id): document the cross-host reproducibility envelope and its cause
    Re-running the gm/ID grid unchanged on a Linux/x86_64 host reproduces the
    committed macOS/aarch64 record on 1758 of 2240 rows and diverges by up to
    20.4% on gm_gds. This adds the measurement, the root cause and the tolerance
    a citing decision is entitled to assume.
    - sim/gm-id-characterization/README.md: new "Cross-host reproducibility
    envelope" section. Per-column envelope (cgg/vth/overdrive bit-identical;
    ids 9.87e-04; gm/gm_id/fT 7.14e-03; gds 1.98e-01; gm_gds 2.04e-01), the
    spread's location (nothing moves below +0.30 V overdrive -- every >1%
    gm_gds row sits at overdrive >= +0.47 V, i.e. strong inversion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
    [20260928-161200-a6fa678.csv, nmos_0.13u_mos_ff_dc.csv, nmos_0.13u_mos_fs_dc.csv, nmos_0.13u_mos_sf_dc.csv, nmos_0.13u_mos_ss_dc.csv, nmos_0.13u_mos_tt_dc.csv, nmos_0.26u_mos_ff_dc.csv, nmos_0.26u_mos_fs_dc.csv]
2026-09-28 docs(gm-id): link the tolerance-policy follow-up (#68) from the envelope section
    Loom-Story: 2AMLogic/sg13g2-opamp#65
    Loom-Trace-Id: ef75508515a9ad13215d524bc4a907ee
    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
2026-09-28 refactor: drop unused layout accessors and the scaffold_smoke MIM-patch alias
    Remove Placed.width_um/height_um/center and GeneratedDevice.klt_version
    (zero readers since 50e58ed) and call devices.patch_mim_bottom_plate
    directly at the former alias's single call site.
    Closes #62
    Loom-Story: 2AMLogic/sg13g2-opamp#62
    Loom-Trace-Id: d432fa86b39c7ed41fdd26f90cba99b0
    Loom-Build: 0.19.464 eeb7def821cc58fe6300f03e556fa9490a316bfc clean
2026-09-28 feat: warn when the live ngspice diverges from sim/pdk.json's pin
    sim/preflight.sh now compares the normalized `ngspice -v` version every
    harness already derives against sim/pdk.json's
    osdi_toolchain.ngspice_actually_used pin, and prints a stderr banner naming
    both versions plus DR-0005's re-run-the-screen obligation when they differ.
    Warn, never fail: every harness in sim/ sources this file, so an exit here
    would strand the whole tree on the next ngspice upgrade -- DR-0005's
    obligation is to re-run the screen, not to stop the fleet. The three
    existing exit-3 guards are untouched and still run first, and a matching
    version produces byte-identical output to before.
    The pin is read with sed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
2026-09-29 sim: wire remaining sed-render callers onto sg13g2_render_netlist
    PR #77 extracted sg13g2_render_netlist() into sim/preflight.sh but only
    rewired the 3 callers that wrapped the sed chain in a local render()
    function. Six more callers inlined the identical sed chain directly (or,
    in run_offset_mc.sh's case, inside a differently-named render_netlist()
    wrapper) and still duplicated the shared substitution logic. Wire them
    onto the shared helper too.
    Closes #78
    Loom-Story: 2AMLogic/sg13g2-opamp#78
    Loom-Trace-Id: 5f8abc80563f3bfddc2f454eecdc32ff
    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
2026-09-29 feat(signoff): add the klt erc supply spec + report for T1 item 11
    Power delivery (structural) -- T1 item 11, klayout-tools#2025 -- is the
    first checklist item no single artifact proves. This lands the half this
    repo did not have: a committed `klt erc` supply spec for the routed
    `opamp_core` layout, its report, and the compound manifest entry that
    pins both to the same committed stream.
    - layout/opamp_core/erc_supply_spec.json: the item-11 supply spec. Every
    stackup entry, the one label_layer, both ties[] entries and the
    ties[]-vs-ties_disclosure decision carry an inline justification, with
    every layer/datatype pair sourced from sg13g2_layers.py (IHP's own
    sg13g2.lyp, cross-checked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
2026-09-29 signoff: mint the graded record showing item 11 met, with its negative controls
    Re-runs signoff/regenerate.sh at the commit that added the ERC evidence:
    t1_met_count moves 3 -> 4, item 11 renders `met` citing both parts of the
    compound set (erc_report.json leading, lvs_report.json also), with
    `power delivery: supplies=vdd, vss, pdn=no (no P&R cited),
    power_connectivity=unchecked`.
    Also records three perturbations run against the committed GDS, none of
    them committed:
    - deleting the via2 role severs every rail -> 5x erc.missing_tie;
    - pointing the nwell tie's tap_requires at an undrawn layer -> 2x
    erc.missing_tie, "no tap contact drawn inside it";
    - dropping tap_requires from both ties ->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
2026-10-01 chore: resync installed Loom surfaces
    resynced_by: fleet-resync
    invocation: fleet-resync.sh --fleet-only --push
    <!-- loom:provenance v1 build=unknown 19f4e67fd0a0afbd3d8b6606ca91ceac911377a3 clean prompts=none sweep=none story=none trace=78a5dfbdfd8c530aecd1bb436fd096df host=loom-worker-2 base=e0ea8b95cc9f22eeeda3c4d70413ef4e27189c5f run=loom-run/v1:timer:loom-worker-2/fleet-resync:67c759f7ef3c43e38d3fa8d5f19a2dd1 installs=0.19.593 658650a4f0eff932ac66a8f690eaedf8123fc83b -->
    Loom-Story: none
    Loom-Trace-Id: 78a5dfbdfd8c530aecd1bb436fd096df
    Loom-Build: unknown 19f4e67fd0a0afbd3d8b6606ca91ceac911377a3 clean
2026-10-01 chore: resync installed Loom surfaces
    <!-- loom:provenance v1 build=unknown 56435bf476452911283e43940ecfd9a30f804af9 clean prompts=none sweep=none story=none trace=2b293b15a926fd8e83ad4f2296c20cc1 host=loom-worker-1 base=d3e3384b5f7146a772ae686d93546d670438d966 run=loom-run/v1:timer:loom-worker-1/fleet-resync:981eee90a8c04bb5980e1eedc93b2064 installs=0.19.603 8c39bf7cde8a8c03d1aaee441f397c017b6a3a9e -->
    Loom-Trace-Id: 2b293b15a926fd8e83ad4f2296c20cc1
    Loom-Build: unknown 56435bf476452911283e43940ecfd9a30f804af9 clean
    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
2026-10-01 chore: resync installed Loom surfaces
    <!-- loom:provenance v1 build=unknown f2868e6b4d60d11a8ab47d25cad9e248229d2f66 clean prompts=none sweep=none story=none trace=4e2766ed5160781df891476246a9be2e host=robb-studio base=ca7686f13545f8fda8660dbccbc52f0dc8526f6d run=loom-run/v1:timer:robb-studio/fleet-resync:2d3851d5-1673-43ae-bcc6-e5c971b37f33 installs=0.19.603 74778a6aeea5d9e06b489400942b35f33c8bb766 -->
    Loom-Trace-Id: 4e2766ed5160781df891476246a9be2e
    Loom-Build: unknown f2868e6b4d60d11a8ab47d25cad9e248229d2f66 clean
    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
2026-10-01 chore: resync installed Loom surfaces
    <!-- loom:provenance v1 build=unknown d6714830391f7596338b8de40ee2d0f45dcd12f5 clean prompts=none sweep=none story=none trace=af273f717e759e690d07f372734e9278 host=robb-pro base=f218e597e27d5d57bc0fbe210f6f73bae512b8f2 run=loom-run/v1:timer:robb-pro/fleet-resync:92e2f9ba-d083-411b-833b-ae52d169ef04 installs=0.19.605 6eb2b65a4496b7becb84ef1f944493a541fd01cd -->
    Loom-Trace-Id: af273f717e759e690d07f372734e9278
    Loom-Build: unknown d6714830391f7596338b8de40ee2d0f45dcd12f5 clean
    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
2026-10-01 chore: resync installed Loom surfaces
    <!-- loom:provenance v1 build=unknown e956e9fee69e53f08b887ca20e14d9058d6f9aee clean prompts=none sweep=none story=none trace=1077dafeb758858c149dd37f4ece3c77 host=loom-worker-2 base=592ede76a6286abebcfcd902079e543ab48309f7 run=loom-run/v1:timer:loom-worker-2/fleet-resync:e3773167b12d4b3aafa1f76848245174 installs=0.19.609 ff30576dacc8c2734b1c7434bedd29c47122caeb -->
    Loom-Trace-Id: 1077dafeb758858c149dd37f4ece3c77
    Loom-Build: unknown e956e9fee69e53f08b887ca20e14d9058d6f9aee clean
    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
2026-10-01 chore: resync installed Loom surfaces
    <!-- loom:provenance v1 build=unknown 617257919edc1b9b9ee27532c5ec1b8a64523388 clean prompts=none sweep=none story=none trace=dbafe4f8526617aa07c890721298a080 host=robb-studio base=d1e6263f99a6eac5cc3c4573e4844910afa06830 run=loom-run/v1:timer:robb-studio/fleet-resync:1817df66-02cc-4b27-927d-a38485da550a installs=0.19.610 c94891dd526cf6db5ee02045424c6913be522048 -->
    Loom-Trace-Id: dbafe4f8526617aa07c890721298a080
    Loom-Build: unknown 617257919edc1b9b9ee27532c5ec1b8a64523388 clean
    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
2026-10-01 chore: resync installed Loom surfaces
    <!-- loom:provenance v1 build=unknown a2a39ac2736eb2686e2c65412d939e67c0438a7d clean prompts=none sweep=none story=none trace=fc1a121767151aae5bd7427c683b7db6 host=robb-pro base=91689bc075f1666ac9e3befe42b6902ef28e3a3d run=loom-run/v1:timer:robb-pro/fleet-resync:708eb7c8-469d-4783-80b7-bafe142df3c4 installs=0.19.612 d25614656adcf70162da95c5e1035e99a0639a1a -->
    Loom-Trace-Id: fc1a121767151aae5bd7427c683b7db6
    Loom-Build: unknown a2a39ac2736eb2686e2c65412d939e67c0438a7d clean
    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
2026-10-01 chore: resync installed Loom surfaces
    <!-- loom:provenance v1 build=unknown 126c80914e42f913c4fc778d3ddce96daa2c7a77 clean prompts=none sweep=none story=none trace=15a20fbea7a00d0922b943088c80e19d host=loom-worker-1 base=4b5476a7c596187d1dd6f402e295b1a9d5fab147 run=loom-run/v1:script:loom-worker-1/fleet-resync:ecc423da-4625-49de-b25a-692fd669a029 installs=0.19.612 53aeb18c5541af6b068247d82f62daed412cc2c6 -->
    Loom-Trace-Id: 15a20fbea7a00d0922b943088c80e19d
    Loom-Build: unknown 126c80914e42f913c4fc778d3ddce96daa2c7a77 clean
    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
2026-10-01 chore: resync installed Loom surfaces
    <!-- loom:provenance v1 build=unknown 126c80914e42f913c4fc778d3ddce96daa2c7a77 clean prompts=none sweep=none story=none trace=a0a42bd10fcfa6d7cbcc9c021c406848 host=loom-worker-2 base=37c18cb8150ef0e06469c3aa6ee8d78babe7498f run=loom-run/v1:timer:loom-worker-2/fleet-resync:9e174e6bb0fa41d786e4a86e45632b6f installs=0.19.612 6f0871dc66e62b36d8382ced980d2805bfd97e50 -->
    Loom-Trace-Id: a0a42bd10fcfa6d7cbcc9c021c406848
    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
2026-10-01 chore: resync installed Loom surfaces
    <!-- loom:provenance v1 build=unknown 8891f74a5d568fe3d13937ef37fd64371dd2738f clean prompts=none sweep=none story=none trace=1e216ea76cbd2b72542049c4c18c2817 host=loom-worker-1 base=4ae7f16cb8a32a33385aad3f2f0b17c0a8ab9d59 run=loom-run/v1:timer:loom-worker-1/fleet-resync:679feba6c0f347d39eb5943ed77dc87b installs=0.19.612 62fa67f8756bdf59fdf744be053e5ef1709f1335 -->
    Loom-Trace-Id: 1e216ea76cbd2b72542049c4c18c2817
    Loom-Build: unknown 8891f74a5d568fe3d13937ef37fd64371dd2738f clean
    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
2026-10-01 chore: resync installed Loom surfaces
    <!-- loom:provenance v1 build=unknown 6f3411c8a63e68097dde01bce8a8422230f54218 clean prompts=none sweep=none story=none trace=9aa0a46bb352b9665fdaa5f5b3b85dd7 host=robb-pro base=0cd4cf857b2abed6eb02dea8799c6459e812f697 run=loom-run/v1:timer:robb-pro/fleet-resync:ca419e1d-6646-4678-ac7a-b263e4b5119e installs=0.19.613 d6f32c257ca7cce3da20ff97d432b09c5b74a4c8 -->
    Loom-Trace-Id: 9aa0a46bb352b9665fdaa5f5b3b85dd7
    Loom-Build: unknown 6f3411c8a63e68097dde01bce8a8422230f54218 clean
    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
2026-10-02 chore: resync installed Loom surfaces
    <!-- loom:provenance v1 build=unknown 13c0a3ef467a888520a6529ab34486ab8be826be clean prompts=none sweep=none story=none trace=41356080f367e491d5ff03f17bb98c27 host=loom-worker-2 base=adf28572039b6138b9d79f834ee13551bf2d1e45 run=loom-run/v1:timer:loom-worker-2/fleet-resync:44455fbcbab745abb92cea192fafbb1d installs=0.19.614 3c79f7b1d0cc14723e049cff4250ff7330804326 -->
    Loom-Trace-Id: 41356080f367e491d5ff03f17bb98c27
    Loom-Build: unknown 13c0a3ef467a888520a6529ab34486ab8be826be clean
    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
2026-10-02 chore: resync installed Loom surfaces
    <!-- loom:provenance v1 build=unknown ea2dd21f2ba310ec007d047ddfecc6cd27d220ac clean prompts=none sweep=none story=none trace=f04a67f3922788d2ccdd66578c8d18f9 host=loom-worker-1 base=50d9064afc074b99ec210eac8b653a9f0591b48a run=loom-run/v1:timer:loom-worker-1/fleet-resync:1c3b601dd998488595adc09040c007d4 installs=0.19.614 79f4897c5d3c78dbfc1b022f77d244838dbf4ccb -->
    Loom-Trace-Id: f04a67f3922788d2ccdd66578c8d18f9
    Loom-Build: unknown ea2dd21f2ba310ec007d047ddfecc6cd27d220ac clean
    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
2026-10-02 chore: resync installed Loom surfaces
    <!-- loom:provenance v1 build=unknown 6f3411c8a63e68097dde01bce8a8422230f54218 clean prompts=none sweep=none story=none trace=acb28d0049e0cc75536f96d503f6e814 host=robb-studio base=f6824cc410a349ab9f41c92a1e092a99c27cee83 run=loom-run/v1:timer:robb-studio/fleet-resync:85d2b1b5-e81d-40c3-ab6a-9a00efbc4ee2 installs=0.19.616 d86523eeadb32b95777f3cd3a76dd2f72f0bf792 -->
    Loom-Trace-Id: acb28d0049e0cc75536f96d503f6e814
    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
2026-10-02 chore: resync installed Loom surfaces
    <!-- loom:provenance v1 build=unknown 2b50bd69eddd038dd738465aa58a9ebca11410ac clean prompts=none sweep=none story=none trace=324e4f607054d0396cfdf8fdc01e93ae host=robb-pro base=bc1b7627713196aed0723b28020837ec9403cad6 run=loom-run/v1:timer:robb-pro/fleet-resync:a63799f1-2ad7-4946-b81d-2ec231bc2d2f installs=0.19.617 81cb2ad7e091b19d6a2b95d1add6938c2100d46b -->
    Loom-Trace-Id: 324e4f607054d0396cfdf8fdc01e93ae
    Loom-Build: unknown 2b50bd69eddd038dd738465aa58a9ebca11410ac clean
    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
2026-10-02 chore: resync installed Loom surfaces
    <!-- loom:provenance v1 build=unknown 00d92b326aed50280cd90dc116b7caec27668251 clean prompts=none sweep=none story=none trace=9a5d23cc82b6d3a1c83bfee47bd04970 host=loom-worker-2 base=031a36b6d2629d80a00db6b80a13480fdb06a11f run=loom-run/v1:timer:loom-worker-2/fleet-resync:12136a7a025d49f3a60b5edb04a3ff81 installs=0.19.619 4c0f505e4f0b76f8ccec07bda6d8b839030c077b -->
    Loom-Trace-Id: 9a5d23cc82b6d3a1c83bfee47bd04970
    Loom-Build: unknown 00d92b326aed50280cd90dc116b7caec27668251 clean
    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
2026-10-02 chore: resync installed Loom surfaces
    <!-- loom:provenance v1 build=unknown 456dad6d90259846313dc3bb80bf4e5471ef2d76 clean prompts=none sweep=none story=none trace=bb9688c03fb5211d06f48c8838a5505c host=robb-studio base=58abcd91dddcb3bad8128c8eb72ce8117bb506c0 run=loom-run/v1:timer:robb-studio/fleet-resync:e965c017-8ec7-485d-b46e-aeb399b81fb4 installs=0.19.620 0d28ba49f5a88fdb37271de9cb0144eb3442c6e3 -->
    Loom-Trace-Id: bb9688c03fb5211d06f48c8838a5505c
    Loom-Build: unknown 456dad6d90259846313dc3bb80bf4e5471ef2d76 clean
    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
2026-10-02 chore: resync installed Loom surfaces
    <!-- loom:provenance v1 build=unknown 6c6d2b6565dc13eff4c6811b9c670f452106516b clean prompts=none sweep=none story=none trace=539be979ae694d66ede516a7b5d17e41 host=robb-pro base=ffa20eecc59862eaf04515d4f75d7426860d79b0 run=loom-run/v1:timer:robb-pro/fleet-resync:9444d216-de08-442f-8352-ba59f6e81bb3 installs=0.19.621 a90dc1d794eb9ff70aaf939ebf495abe716f3bdd -->
    Loom-Trace-Id: 539be979ae694d66ede516a7b5d17e41
    Loom-Build: unknown 6c6d2b6565dc13eff4c6811b9c670f452106516b clean
    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
2026-10-02 chore: resync installed Loom surfaces
    <!-- loom:provenance v1 build=unknown f6d28134bfe476967e005d97424073085f55e8a3 clean prompts=none sweep=none story=none trace=27eb90670d441065f593e941066ee005 host=loom-worker-2 base=4dea5c765c46579784fe0db17115eb6f58e42e9b run=loom-run/v1:timer:loom-worker-2/fleet-resync:04001bba930241cf9e325bf304a9270a installs=0.19.623 ccc19c2bbe2aa65328427730fa53f70eb56128c6 -->
    Loom-Trace-Id: 27eb90670d441065f593e941066ee005
    Loom-Build: unknown f6d28134bfe476967e005d97424073085f55e8a3 clean
    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
2026-10-02 chore: resync installed Loom surfaces
    <!-- loom:provenance v1 build=unknown bc461736314499b6c2c4c0ad51fb2294f60336f5 clean prompts=none sweep=none story=none trace=c3ea68717dd3a908dbbd60a35bc8b5d6 host=robb-studio base=98fe462166870bdb3035b748f0acaa521f339ee4 run=loom-run/v1:timer:robb-studio/fleet-resync:8d4c49e2-3258-4080-b0c8-082499053654 installs=0.19.623 a50aaf70069f8897c41a64b7d90783c5ab8294e0 -->
    Loom-Trace-Id: c3ea68717dd3a908dbbd60a35bc8b5d6
    Loom-Build: unknown bc461736314499b6c2c4c0ad51fb2294f60336f5 clean
    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
2026-10-02 chore: resync installed Loom surfaces
    <!-- loom:provenance v1 build=unknown bc461736314499b6c2c4c0ad51fb2294f60336f5 clean prompts=none sweep=none story=none trace=8bee8a664bfc89e0bbfbb3c2de7342ba host=loom-worker-2 base=b566a36c37c0cd5f1869e6f9c61b4b45b13198e1 run=loom-run/v1:timer:loom-worker-2/fleet-resync:de2ceceb48ea4927a1334d08dc0082fe installs=0.19.624 5f49564fa78ae06f8c48d5224dae9ded04200bb7 -->
    Loom-Trace-Id: 8bee8a664bfc89e0bbfbb3c2de7342ba
    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
2026-10-03 chore: resync installed Loom surfaces
    <!-- loom:provenance v1 build=unknown 752d316233ed1a3da9e4f69ad760eb99bb477747 clean prompts=none sweep=none story=none trace=7851839b67c00a023e97cbdea1f580e1 host=robb-pro base=d4dd990a018ce81dc20fe02698434042fa5e5017 run=loom-run/v1:timer:robb-pro/fleet-resync:ae492b66-dca0-4da4-acab-8d26778f2d5c installs=0.19.624 121fac45f5006879bf58a18c951b9243d9099a18 -->
    Loom-Trace-Id: 7851839b67c00a023e97cbdea1f580e1
    Loom-Build: unknown 752d316233ed1a3da9e4f69ad760eb99bb477747 clean
    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
2026-10-03 chore: resync installed Loom surfaces
    <!-- loom:provenance v1 build=unknown b34a08286a42f47f917ec46647d4d167c1f5207c clean prompts=none sweep=none story=none trace=a8e453124b899b440f42c9d83837c7b6 host=loom-worker-2 base=66aa8f27d49f59555c7234c06303569bec4bd3a8 run=loom-run/v1:timer:loom-worker-2/fleet-resync:f02dd5df715347fe90fe14b9353a1b66 installs=0.19.624 0162badc662fb30c070e70611aa8ff74a8486d54 -->
    Loom-Trace-Id: a8e453124b899b440f42c9d83837c7b6
    Loom-Build: unknown b34a08286a42f47f917ec46647d4d167c1f5207c clean
    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
2026-10-03 Retire scaffold_smoke fixture; relocate DRC-deck negative control into opamp_core
    Remove the fixture GDS, DRC report and generator, and the dead Builder.tap().
    The DRC-deck negative control moves to opamp_core/generate.py as
    --drc-negative-control (re-run before deletion and after: status=violations
    violations=3 rule_counts={'activ.width.1': 1, 'metal1.space.1': 1,
    'metal1.width.1': 1}). Update layout/README.md and the devices._mos comment.
    Closes #71
    Loom-Story: 2AMLogic/sg13g2-opamp#71
    Loom-Trace-Id: abafd7b68845489f98fdf50fe50e80c6
    Loom-Build: 0.19.627 f400b3eecc2f60cd5bdc8b359335929385afc793 clean
2026-10-03 chore: resync installed Loom surfaces
    <!-- loom:provenance v1 build=unknown 3437cece5ab759f772122f8d18a6d2f05d246cde clean prompts=none sweep=none story=none trace=bba21427f750636f851279cfae92b4e5 host=loom-worker-1 base=fbd6ddf18535c7780221c2ca5fc7bf2b4d65f11f run=loom-run/v1:timer:loom-worker-1/fleet-resync:9440cda9476f404caa282e360a81ee03 installs=0.19.636 e41edfbb52c13982f7d8b0577f42957427a6514c -->
    Loom-Trace-Id: bba21427f750636f851279cfae92b4e5
    Loom-Build: unknown 3437cece5ab759f772122f8d18a6d2f05d246cde clean
    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
2026-10-03 chore: resync installed Loom surfaces
    <!-- loom:provenance v1 build=unknown 28040ed11a4369e20f3b7b0154a3fb2a2c35d38c clean prompts=none sweep=none story=none trace=0cd87d01c45d97a2ee57a99363fc0db2 host=robb-studio base=f997001ac7693e6d3f67318f3ba438486bd5aa10 run=loom-run/v1:timer:robb-studio/fleet-resync:74b93657-6b04-4ac5-bc77-e0a1682b0595 installs=0.19.636 e41edfbb52c13982f7d8b0577f42957427a6514c -->
    Loom-Trace-Id: 0cd87d01c45d97a2ee57a99363fc0db2
    Loom-Build: unknown 28040ed11a4369e20f3b7b0154a3fb2a2c35d38c clean
    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
2026-10-03 chore: resync installed Loom surfaces
    <!-- loom:provenance v1 build=unknown 388c7fe0cad997f7a887f70c9f2cfe8781a2d512 clean prompts=none sweep=none story=none trace=2046ffd42f138a06b914f34851de3440 host=loom-worker-2 base=10cfcfeba9d058d129ccd3ed56447851cc1bc148 run=loom-run/v1:timer:loom-worker-2/fleet-resync:17c9456bb1934c70a545b12081496cce installs=0.19.647 d1fe5dead4202be12a964ab891fd5980e7836170 -->
    Loom-Trace-Id: 2046ffd42f138a06b914f34851de3440
    Loom-Build: unknown 388c7fe0cad997f7a887f70c9f2cfe8781a2d512 clean
    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
2026-10-03 chore: resync installed Loom surfaces
    <!-- loom:provenance v1 build=unknown 8078c29e691123d91cd761a786f99cfd25f1809d clean prompts=none sweep=none story=none trace=45869a6374635c036a11a6f379fe31a4 host=robb-pro base=35d19d5b75fafe716ed79a12ec668ec15a7831a4 run=loom-run/v1:timer:robb-pro/fleet-resync:b0a94991-052d-4e7d-ba2b-78b971096849 installs=0.19.647 709ca4396e074e5a4d1c5e19721f6ddac7154ca2 -->
    Loom-Trace-Id: 45869a6374635c036a11a6f379fe31a4
    Loom-Build: unknown 8078c29e691123d91cd761a786f99cfd25f1809d clean
    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
2026-10-03 chore: resync installed Loom surfaces
    <!-- loom:provenance v1 build=unknown f9cba29b0602624a23daa17ae04d31d82e10fa91 clean prompts=none sweep=none story=none trace=754b3688f97b6c34894d8cfbf272b81a host=loom-worker-1 base=a14125f160ebcc39b65fc42479dd34c1f8fdeea4 run=loom-run/v1:script:loom-worker-1/fleet-resync:11eb117a-9ff3-4411-88d4-fdd7d6748639 installs=0.19.649 6f2f13b1c31ce420e2250ae040d8e1050c0e761b -->
    Loom-Trace-Id: 754b3688f97b6c34894d8cfbf272b81a
    Loom-Build: unknown f9cba29b0602624a23daa17ae04d31d82e10fa91 clean
    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
2026-10-03 chore: resync installed Loom surfaces
    <!-- loom:provenance v1 build=unknown f9cba29b0602624a23daa17ae04d31d82e10fa91 clean prompts=none sweep=none story=none trace=544a028e3829d4020b8aaa144e5fa628 host=robb-studio base=aee6d5617306ba2c055215d152ad9ec861ce8906 run=loom-run/v1:script:robb-studio/fleet-resync:5b5b8b83-7139-447d-88bd-417dcf375aa6 installs=0.19.649 6f2f13b1c31ce420e2250ae040d8e1050c0e761b -->
    Loom-Trace-Id: 544a028e3829d4020b8aaa144e5fa628
    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
2026-10-03 chore: resync installed Loom surfaces
    <!-- loom:provenance v1 build=unknown f9cba29b0602624a23daa17ae04d31d82e10fa91 clean prompts=none sweep=none story=none trace=1057aaaf811f6dd2d64a3bb6d4b3ac49 host=robb-pro base=5544816d6b4981c42c5183a1a0bda838b47f8c5f run=loom-run/v1:timer:robb-pro/fleet-resync:785c1ea0-d7f2-4810-99e9-cd9368aebe0c installs=0.19.649 2118aabb5a925f1ec4669b4d3d31176a46d8f2a6 -->
    Loom-Trace-Id: 1057aaaf811f6dd2d64a3bb6d4b3ac49
    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
2026-10-03 chore: resync installed Loom surfaces
    <!-- loom:provenance v1 build=unknown 72f61d9aa0fe08f1ef59f1a97a314e474455801e clean prompts=none sweep=none story=none trace=90666a75095c62a013be2ea121ab93f1 host=loom-worker-2 base=69e5be99ba2a10db3a8f39ecbe7368755cf729bc run=loom-run/v1:script:loom-worker-2/fleet-resync:13865fad-1cac-4838-857f-34878fcba5d1 installs=0.19.652 235a64727b907d65529151af0a962b14f16462a0 -->
    Loom-Trace-Id: 90666a75095c62a013be2ea121ab93f1
    Loom-Build: unknown 72f61d9aa0fe08f1ef59f1a97a314e474455801e clean
    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
2026-10-03 chore: resync installed Loom surfaces
    <!-- loom:provenance v1 build=unknown 72f61d9aa0fe08f1ef59f1a97a314e474455801e clean prompts=none sweep=none story=none trace=845aaa0eb340f80f12095e2e8b421ed1 host=robb-pro base=d1cc64c98fd29d4f207954542e53014154a19cb2 run=loom-run/v1:script:robb-pro/fleet-resync:344add4b-df8a-49e8-8563-2765673acc76 installs=0.19.652 235a64727b907d65529151af0a962b14f16462a0 -->
    Loom-Trace-Id: 845aaa0eb340f80f12095e2e8b421ed1
    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
2026-10-03 chore: resync installed Loom surfaces
    <!-- loom:provenance v1 build=unknown 21130104346fe9c464ce8a3fdf82c1d3e9667639 clean prompts=none sweep=none story=none trace=36308fff5a3c323c3d1bf6fffb6cd122 host=robb-studio base=ef83c3737e1213a66843ed5f7135b8274392ad7e run=loom-run/v1:timer:robb-studio/fleet-resync:89972fbd-0774-4402-bbb7-26c33a851735 installs=0.19.652 fb69233bd8f1dfc2bdee37d8b934f99274dc0193 -->
    Loom-Trace-Id: 36308fff5a3c323c3d1bf6fffb6cd122
    Loom-Build: unknown 21130104346fe9c464ce8a3fdf82c1d3e9667639 clean
    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
2026-10-04 chore: resync installed Loom surfaces
    <!-- loom:provenance v1 build=unknown 61870b40779d205c1555e801c6e1d95df083cdea clean prompts=none sweep=none story=none trace=fb9213e215442932d2af05f3b14977de host=robb-pro base=face56b2fb53da0570a78d17afe9dfb0de87e8c3 run=loom-run/v1:timer:robb-pro/fleet-resync:4c70cd1d-08cd-4add-8e2a-9a75160d163f installs=0.19.655 36c39e3c6f56e1979647ec235b4bd19c77db22f3 -->
    Loom-Trace-Id: fb9213e215442932d2af05f3b14977de
    Loom-Build: unknown 61870b40779d205c1555e801c6e1d95df083cdea clean
    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
2026-10-04 chore: resync installed Loom surfaces
    <!-- loom:provenance v1 build=unknown 61870b40779d205c1555e801c6e1d95df083cdea clean prompts=none sweep=none story=none trace=baa6c2cfcae1a320917c00ff2eb8b630 host=loom-worker-2 base=e58b9287a1d21ce5c5696ca5e5b0fb9e27c5e7f8 run=loom-run/v1:timer:loom-worker-2/fleet-resync:741a7f0f16df4fb1be4e657aeacd1244 installs=0.19.655 fc667a4faae1227f8a6837431f8a0c2d0aeaa7dd -->
    Loom-Trace-Id: baa6c2cfcae1a320917c00ff2eb8b630
    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
2026-10-04 chore: resync installed Loom surfaces
    <!-- loom:provenance v1 build=unknown b922acb2ac655cbccd71daa9e3f05a325a094ca5 clean prompts=none sweep=none story=none trace=833eeb34d4ca65c3f8c6f7824ddca3a3 host=robb-studio base=9d55aa519f83df745a90e5a33d42ad7ebaedee16 run=loom-run/v1:timer:robb-studio/fleet-resync:0d44f6dc-6a62-4d43-b49d-7cfdd7dbd823 installs=0.19.663 0a51e373e7fe1be156c5774b2c827d4b745368a3 -->
    Loom-Trace-Id: 833eeb34d4ca65c3f8c6f7824ddca3a3
    Loom-Build: unknown b922acb2ac655cbccd71daa9e3f05a325a094ca5 clean
    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
2026-10-04 chore: resync installed Loom surfaces
    <!-- loom:provenance v1 build=unknown 746ecb5f9d7e64ba1d2526f1e997530ad4f3dd43 clean prompts=none sweep=none story=none trace=f09501431241df2ec5688e334ba43dfe host=loom-worker-2 base=241043b67b734e0277877052e95604dea397d45b run=loom-run/v1:timer:loom-worker-2/fleet-resync:70797dad61fb4e21806716d54f1ce910 installs=0.19.669 59a1f84e3742827a8033bb153ebbedc1759bee72 -->
    Loom-Trace-Id: f09501431241df2ec5688e334ba43dfe
    Loom-Build: unknown 746ecb5f9d7e64ba1d2526f1e997530ad4f3dd43 clean
    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
2026-10-04 chore: resync installed Loom surfaces
    <!-- loom:provenance v1 build=unknown 8080d0485cc1312129ee642b084944c56d1be074 clean prompts=none sweep=none story=none trace=ed180bcab6828041123ad54d8ddb4037 host=robb-pro base=832ea2da7f117d23c1b8a7669016b36da68cb528 run=loom-run/v1:timer:robb-pro/fleet-resync:e97b2f08-4ad9-4b66-a166-5b19820e2d1f installs=0.19.669 59a1f84e3742827a8033bb153ebbedc1759bee72 -->
    Loom-Trace-Id: ed180bcab6828041123ad54d8ddb4037
    Loom-Build: unknown 8080d0485cc1312129ee642b084944c56d1be074 clean
    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
2026-10-04 chore: resync installed Loom surfaces
    <!-- loom:provenance v1 build=unknown 83cb6647167ffc000d2c2f479b4e816b68f863f4 clean prompts=none sweep=none story=none trace=ccabffa1e1ba495895b262086030816c host=robb-studio base=615799887d29f6306b35f8346cad2e6caa312a24 run=loom-run/v1:timer:robb-studio/fleet-resync:88a78f1f-d978-47b5-99c3-2aabde811d17 installs=0.19.676 cd4f30bd892ea2595d8218b08150633504b0dd14 -->
    Loom-Trace-Id: ccabffa1e1ba495895b262086030816c
    Loom-Build: unknown 83cb6647167ffc000d2c2f479b4e816b68f863f4 clean
    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
2026-10-04 chore: resync installed Loom surfaces
    <!-- loom:provenance v1 build=unknown 32174d0f7e80508fa66c1a11a2c0fb28c515607e clean prompts=none sweep=none story=none trace=436d7c19b10cd5807625a7ce7190a82f host=loom-worker-2 base=16623feb45ddd3d45b2dfcd47ed2bd09eced8370 run=loom-run/v1:timer:loom-worker-2/fleet-resync:19ae50771cc04d8db7b1403c1e66bbea installs=0.19.682 9eccfa110fa294fa32a62ffe8eff669cfcf1a3a6 -->
    Loom-Trace-Id: 436d7c19b10cd5807625a7ce7190a82f
    Loom-Build: unknown 32174d0f7e80508fa66c1a11a2c0fb28c515607e clean
    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
2026-10-04 chore: resync installed Loom surfaces
    <!-- loom:provenance v1 build=unknown 72290fa960e0773b2c50d74042e24914c7327637 clean prompts=none sweep=none story=none trace=f7b6952a649a174398a48b90b6ab4793 host=robb-pro base=6688e742a044342a3189b4a8a7fa97f05bf4beea run=loom-run/v1:timer:robb-pro/fleet-resync:72f32482-5cc4-4b38-ab9e-4d2ef0b64e94 installs=0.19.684 bdb8fb331eb51c7def4cdd2c38b611af06f25f6d -->
    Loom-Trace-Id: f7b6952a649a174398a48b90b6ab4793
    Loom-Build: unknown 72290fa960e0773b2c50d74042e24914c7327637 clean
    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
2026-10-04 chore: resync installed Loom surfaces
    <!-- loom:provenance v1 build=unknown 76cda58637be0e74c4cb5b4c8dbc2000e2a9c3d4 clean prompts=none sweep=none story=none trace=614cbada5ce873c2b34a511816309cfc host=robb-studio base=4bed6d2da36665edade7d44f719efb2b2db95feb run=loom-run/v1:timer:robb-studio/fleet-resync:7e559a3b-ffdd-409b-8dd2-ae906a273b0a installs=0.19.692 d4974b9f5ff7843a3cfc06378ea2a69bc120e0f4 -->
    Loom-Trace-Id: 614cbada5ce873c2b34a511816309cfc
    Loom-Build: unknown 76cda58637be0e74c4cb5b4c8dbc2000e2a9c3d4 clean
    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
2026-10-04 chore: resync installed Loom surfaces
    <!-- loom:provenance v1 build=unknown f84bac5c232c093f83c1adc2533d8c75b021cda2 clean prompts=none sweep=none story=none trace=e687830614e4bd1c551ab6cf6186f8f3 host=loom-worker-2 base=ad841d01f9347171c597d2c7d19be94bf49be0e9 run=loom-run/v1:timer:loom-worker-2/fleet-resync:2db2c4373ac24de1b7a364e69eaea1ca installs=0.19.695 b0d5b09f207fda439390ea1dd249ad10e7009dfc -->
    Loom-Trace-Id: e687830614e4bd1c551ab6cf6186f8f3
    Loom-Build: unknown f84bac5c232c093f83c1adc2533d8c75b021cda2 clean
    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
2026-10-04 chore: resync installed Loom surfaces
    <!-- loom:provenance v1 build=unknown ac5c275d1c616a9723e747f5a66de93dc80d3512 clean prompts=none sweep=none story=none trace=c777c3912bd31972e9aa3ccab712ae01 host=loom-worker-1 base=3bef214dd190347fc29206280f172fab4f0889d2 run=loom-run/v1:script:loom-worker-1/fleet-resync:b51a1b33-4958-4408-be36-166e12e8360b installs=0.19.697 ada83a5c7ff66b56b0060ef0be368c9fe56eb3c6 -->
    Loom-Trace-Id: c777c3912bd31972e9aa3ccab712ae01
    Loom-Build: unknown ac5c275d1c616a9723e747f5a66de93dc80d3512 clean
    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
2026-10-04 chore: resync installed Loom surfaces
    <!-- loom:provenance v1 build=unknown a19f642f5c09599c4c64827d81d228eb031be73e clean prompts=none sweep=none story=none trace=34a80e22764eb5055e37faec0eaf65fb host=robb-pro base=e0a79320d498727bf7f82a4cc9389ad76dec7ae2 run=loom-run/v1:script:robb-pro/fleet-resync:689be620-3ff2-4ff5-a2ce-f6825f6379e2 installs=0.19.698 aa619a1d07e36e8d90ac01fea63dc39285c93567 -->
    Loom-Trace-Id: 34a80e22764eb5055e37faec0eaf65fb
    Loom-Build: unknown a19f642f5c09599c4c64827d81d228eb031be73e clean
    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
2026-10-04 chore: resync installed Loom surfaces
    <!-- loom:provenance v1 build=unknown 693bdd794cb34afdefd7f0c4596824cd53078a61 clean prompts=none sweep=none story=none trace=7e7be58c80b40f1ac882b00139fb0ca0 host=robb-pro base=edf92492444e258f12adf14368393d606e85ebd0 run=loom-run/v1:timer:robb-pro/fleet-resync:d64fbd6b-5d9b-491d-9e17-742b375bfba7 installs=0.19.698 b814428b8333c69174c977498d1d2db6bce3145c -->
    Loom-Trace-Id: 7e7be58c80b40f1ac882b00139fb0ca0
    Loom-Build: unknown 693bdd794cb34afdefd7f0c4596824cd53078a61 clean
    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
2026-10-04 chore: resync installed Loom surfaces
    <!-- loom:provenance v1 build=unknown 693bdd794cb34afdefd7f0c4596824cd53078a61 clean prompts=none sweep=none story=none trace=aa18f1ec102a98d77ffc51c9be6ffbb3 host=robb-studio base=471d67200d88cb0cb118da4cc951ee9206829ca6 run=loom-run/v1:script:robb-studio/fleet-resync:3cb89ca8-62c2-4a69-8434-c4aaa3b64eaf installs=0.19.698 a58f00e0681c50d6bfc5089d0af4b3715198319f -->
    Loom-Trace-Id: aa18f1ec102a98d77ffc51c9be6ffbb3
    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
2026-10-04 chore: resync installed Loom surfaces
    <!-- loom:provenance v1 build=unknown 7a41c2e69ef89d60ed3bd190b94838021bf18d0f clean prompts=none sweep=none story=none trace=d0f04f38b507d85402723643fcf47197 host=loom-worker-1 base=a088eaf4ff1c14876d3c73aa8545538a9f372e1d run=loom-run/v1:script:loom-worker-1/fleet-resync:8fdc8c1c-f844-4c33-bc80-b424e5b4cf3d installs=0.19.703 89d5a428c652f957d7fad8a546589042d39911bc -->
    Loom-Trace-Id: d0f04f38b507d85402723643fcf47197
    Loom-Build: unknown 7a41c2e69ef89d60ed3bd190b94838021bf18d0f clean
    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
2026-10-05 chore: resync installed Loom surfaces
    <!-- loom:provenance v1 build=unknown ebb37db560de172930e261675a35bd52e429f650 clean prompts=none sweep=none story=none trace=a40e86a64366c7a1e36aea026901334f host=loom-worker-2 base=38778beaf28a459b3b562ccef555123c8138e441 run=loom-run/v1:script:loom-worker-2/fleet-resync:90b6cd74-6cc0-4f58-98ee-6ede0ac6f50c installs=0.19.703 f63c3c82e6bf202f2ca7b205b532f681c5ebb2c8 -->
    Loom-Trace-Id: a40e86a64366c7a1e36aea026901334f
    Loom-Build: unknown ebb37db560de172930e261675a35bd52e429f650 clean
    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
2026-10-05 chore: resync installed Loom surfaces
    <!-- loom:provenance v1 build=unknown 7a41c2e69ef89d60ed3bd190b94838021bf18d0f clean prompts=none sweep=none story=none trace=fc04851db12f586b5d58155325131b6e host=robb-studio base=3723fc806313805826b33d54eaafdce26724c32a run=loom-run/v1:timer:robb-studio/fleet-resync:a7d5da6f-a896-4d6f-8d00-aebf47f9b266 installs=0.19.703 2ad9a08fb93de4d7dfac9d2b501d12c684c9c2cc -->
    Loom-Trace-Id: fc04851db12f586b5d58155325131b6e
    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
2026-10-05 chore: resync installed Loom surfaces
    <!-- loom:provenance v1 build=unknown cb8e36660fc5806e4a2dd00da566f9f9c3983db8 clean prompts=none sweep=none story=none trace=7204a60bd5a3f591ded7600c65c70f8b host=loom-worker-1 base=98540d515b021614ba854562c8312be2bf6cafa4 run=loom-run/v1:timer:loom-worker-1/fleet-resync:56bb48518cc6419f93ee5a1c8f149528 installs=0.19.703 972fe7321be6a9efe2653579379ea3bc40b899b2 -->
    Loom-Trace-Id: 7204a60bd5a3f591ded7600c65c70f8b
    Loom-Build: unknown cb8e36660fc5806e4a2dd00da566f9f9c3983db8 clean
    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
2026-10-05 chore: resync installed Loom surfaces
    <!-- loom:provenance v1 build=unknown b44cb904ebb599db793066ccc631c846862abfbd clean prompts=none sweep=none story=none trace=9590fed7c1b1c9f549ccf3cba24292d7 host=robb-pro base=a08bc30c4cf331df1ae6370d7db2211b60978fa7 run=loom-run/v1:timer:robb-pro/fleet-resync:dbc6174e-403d-422d-98b6-73a4b6dbf44f installs=0.19.708 dc8faf1eae3143feda6301887c303b1ee45db7f4 -->
    Loom-Trace-Id: 9590fed7c1b1c9f549ccf3cba24292d7
    Loom-Build: unknown b44cb904ebb599db793066ccc631c846862abfbd clean
    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
2026-10-05 chore: resync installed Loom surfaces
    <!-- loom:provenance v1 build=unknown 4548905848fcb7cb875c1c0518f2fd88eb65818e clean prompts=none sweep=none story=none trace=aff5e139797705f6fa0811f102ecd103 host=loom-worker-1 base=86a6eda7f6b73878f98651c0c7f12e862d99e590 run=loom-run/v1:timer:loom-worker-1/fleet-resync:ba6a9e5686a64abaa842d71acaeae2ca installs=0.19.718 00d99344506bcf00e1aec7e910abe3d13df2d240 -->
    Loom-Trace-Id: aff5e139797705f6fa0811f102ecd103
    Loom-Build: unknown 4548905848fcb7cb875c1c0518f2fd88eb65818e clean
    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
2026-10-05 chore: resync installed Loom surfaces
    <!-- loom:provenance v1 build=unknown e7efbaa6e7b97a7d72da6032044c67525291f4d1 clean prompts=none sweep=none story=none trace=d74a33a6f35e329b3e795991e790ebfd host=robb-studio base=904f2ce6b6d2d002b863d05d3f4accd46c4e1114 run=loom-run/v1:timer:robb-studio/fleet-resync:304f49c8-5b3e-46a9-a557-945b9ae177f0 installs=0.19.718 00d99344506bcf00e1aec7e910abe3d13df2d240 -->
    Loom-Trace-Id: d74a33a6f35e329b3e795991e790ebfd
    Loom-Build: unknown e7efbaa6e7b97a7d72da6032044c67525291f4d1 clean
    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
2026-10-05 chore: resync installed Loom surfaces
    <!-- loom:provenance v1 build=unknown 347b71e65e709d9fd49aba75d3fb67877fc08818 clean prompts=none sweep=none story=none trace=f9653dd318724c98136e7cef63e551ed host=robb-pro base=592c6e757748dc79bfa581e6b5ec2e9e27509a14 run=loom-run/v1:timer:robb-pro/fleet-resync:cdc95970-9fb1-49fa-a0e6-037a3fab2099 installs=0.19.728 991dcebf6f6b2de6571f1d3400bec083498c6438 -->
    Loom-Trace-Id: f9653dd318724c98136e7cef63e551ed
    Loom-Build: unknown 347b71e65e709d9fd49aba75d3fb67877fc08818 clean
    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
2026-10-05 chore: resync installed Loom surfaces
    <!-- loom:provenance v1 build=unknown 5c0d18101f48fecb656f10fa37afa9b09bf41631 clean prompts=none sweep=none story=none trace=ddcf49552af364cbf6e884bd59584c1f host=loom-worker-1 base=673f0c8b8aa024068b9399a8bcdd958862b808eb run=loom-run/v1:timer:loom-worker-1/fleet-resync:5eb526a05f244f1985770579e7620ff1 installs=0.19.731 7484b71fce5179a025950e71a82855afaf6fd730 -->
    Loom-Trace-Id: ddcf49552af364cbf6e884bd59584c1f
    Loom-Build: unknown 5c0d18101f48fecb656f10fa37afa9b09bf41631 clean
    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
2026-10-05 chore: resync installed Loom surfaces
    <!-- loom:provenance v1 build=unknown 0b160514b6658e3ab26a71c6525791da25b46fcf clean prompts=none sweep=none story=none trace=311c3eb2c0ab9550d3de38df5523f3d7 host=robb-studio base=7aca881401d4f2c32cabe79eb789af08200f9cf4 run=loom-run/v1:timer:robb-studio/fleet-resync:e6dec631-b42b-4cf2-b854-cc363cfde6e0 installs=0.19.731 d6146becf339a3d4e55e26e8807ac4571213a00b -->
    Loom-Trace-Id: 311c3eb2c0ab9550d3de38df5523f3d7
    Loom-Build: unknown 0b160514b6658e3ab26a71c6525791da25b46fcf clean
    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
2026-10-05 chore: resync installed Loom surfaces
    <!-- loom:provenance v1 build=unknown 5c0d18101f48fecb656f10fa37afa9b09bf41631 clean prompts=none sweep=none story=none trace=f1e8d4c6e73b8eec3e87a8da52e10f2d host=robb-pro base=a9534df717edfacac68826a246fcd991980602f1 run=loom-run/v1:timer:robb-pro/fleet-resync:5518fd33-81cb-479f-93f0-287ea4b08876 installs=0.19.733 4e67131ce3a1317d8cb8904ec342541cc2f45665 -->
    Loom-Trace-Id: f1e8d4c6e73b8eec3e87a8da52e10f2d
    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
2026-10-05 chore: resync installed Loom surfaces
    <!-- loom:provenance v1 build=unknown ca170d11544ef499cc9500a45bbad152edacfbd1 clean prompts=none sweep=none story=none trace=6dcfc713b6a851b40932158c2eeb70af host=loom-worker-3 base=2e7d35ee4145aac64d10713ee038d5d3254bc5b7 run=loom-run/v1:timer:loom-worker-3/fleet-resync:20ce0908ea5a468a9e055470104047ed installs=0.19.734 7ba6ea50c36dfdd2b5e2922dd22c65560980a5a2 -->
    Loom-Trace-Id: 6dcfc713b6a851b40932158c2eeb70af
    Loom-Build: unknown ca170d11544ef499cc9500a45bbad152edacfbd1 clean
    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
2026-10-05 chore: resync installed Loom surfaces
    <!-- loom:provenance v1 build=unknown 03f1c42302d15f8a83425a84a4e36ca484f3f625 clean prompts=none sweep=none story=none trace=f1bc879f8aa652d550764ffcd36e27d1 host=loom-worker-1 base=45d73cf0ff21e4cc747e398c8083762fc6548f6d run=loom-run/v1:timer:loom-worker-1/fleet-resync:f302a3cc8558413492093df510b02418 installs=0.19.734 967abe71d019ce6606018b4e57dee0223b84d96f -->
    Loom-Trace-Id: f1bc879f8aa652d550764ffcd36e27d1
    Loom-Build: unknown 03f1c42302d15f8a83425a84a4e36ca484f3f625 clean
    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
2026-10-05 chore: resync installed Loom surfaces
    <!-- loom:provenance v1 build=unknown ce7557ba58624d48fedbca2bc037dfa8ce3943e7 clean prompts=none sweep=none story=none trace=e1f2558834c47835cd9a53ec8c9a2ffa host=loom-worker-3 base=56a5028b0a99e1eac4675d4f63c1a2f402054da1 run=loom-run/v1:timer:loom-worker-3/fleet-resync:50f5f0046e2c4890961b3221bd360247 installs=0.19.734 ba9edb650872e5265eaca0c47f75e3cb828ecad2 -->
    Loom-Trace-Id: e1f2558834c47835cd9a53ec8c9a2ffa
    Loom-Build: unknown ce7557ba58624d48fedbca2bc037dfa8ce3943e7 clean
    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
2026-10-05 chore: resync installed Loom surfaces
    <!-- loom:provenance v1 build=unknown f92eaec38470a7b0732e065f4864faec9a1905d6 clean prompts=none sweep=none story=none trace=07aa020a8179d52651250562e9808b98 host=robb-studio base=648f0bb40b8fbb04094624c8c50afb862be91e0e run=loom-run/v1:timer:robb-studio/fleet-resync:3b3ebdf2-b5f7-48ed-b7bb-5fb945094061 installs=0.19.734 78f3e99c44d0af6d4598adf7577bb6676baf3e8f -->
    Loom-Trace-Id: 07aa020a8179d52651250562e9808b98
    Loom-Build: unknown f92eaec38470a7b0732e065f4864faec9a1905d6 clean
    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
2026-10-06 chore: resync installed Loom surfaces
    <!-- loom:provenance v1 build=unknown ca170d11544ef499cc9500a45bbad152edacfbd1 clean prompts=none sweep=none story=none trace=fca9c14d74d6d634726f5823c51bc62a host=loom-worker-2 base=3bcbf2ad79d2f5392cfb3eacdb723b0a5ff28472 run=loom-run/v1:timer:loom-worker-2/fleet-resync:23a23f0878c1494cb720941baddfea81 installs=0.19.741 3cede3920c6b567d5400789187a904970d46b0fb -->
    Loom-Trace-Id: fca9c14d74d6d634726f5823c51bc62a
    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
2026-10-06 chore: resync installed Loom surfaces
    <!-- loom:provenance v1 build=unknown e38a22941348fd8e83d1f4b06130d2a214adfb50 clean prompts=none sweep=none story=none trace=a7fe3a9a1fedfce89846c20f2e98ac31 host=robb-pro base=b790eadf652fb69fb586943db01ce7cecf764ac9 run=loom-run/v1:timer:robb-pro/fleet-resync:2d770a42-f0e7-4695-abfa-b912e75382e6 installs=0.19.744 8bc5bcce93c4d9721817387afe8b4b6d79f26054 -->
    Loom-Trace-Id: a7fe3a9a1fedfce89846c20f2e98ac31
    Loom-Build: unknown e38a22941348fd8e83d1f4b06130d2a214adfb50 clean
    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
2026-10-06 chore: resync installed Loom surfaces
    <!-- loom:provenance v1 build=unknown f66ea90ff1bdec51aa4c8dc3f4b2e8d26e3dfd2d clean prompts=none sweep=none story=none trace=66d96c3bb00b04fae967865ee02fc4de host=loom-worker-3 base=0c9da2764effc92b9467f40ace8be6d6d51d103b run=loom-run/v1:timer:loom-worker-3/fleet-resync:eb2dceb410e848a19d58f96f678c995e installs=0.19.749 6135634b053dc30ef5aa8e6d733bfe79bb2ac734 -->
    Loom-Trace-Id: 66d96c3bb00b04fae967865ee02fc4de
    Loom-Build: unknown f66ea90ff1bdec51aa4c8dc3f4b2e8d26e3dfd2d clean
    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
2026-10-06 chore: resync installed Loom surfaces
    <!-- loom:provenance v1 build=unknown ade8a2c60cc8370d04d72f331141acb6fb32e121 clean prompts=none sweep=none story=none trace=6245fb88b5bdf9f7ccecb6b2168dc335 host=robb-studio base=400ee2f889f42c9867010e6a1db74d70b0f2a939 run=loom-run/v1:timer:robb-studio/fleet-resync:b305aed2-1a25-4576-aca7-9b017ac4377e installs=0.19.755 8d97d322e1cb3723988504337089beca73d0511c -->
    Loom-Trace-Id: 6245fb88b5bdf9f7ccecb6b2168dc335
    Loom-Build: unknown ade8a2c60cc8370d04d72f331141acb6fb32e121 clean
    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
2026-10-06 chore: resync installed Loom surfaces
    <!-- loom:provenance v1 build=unknown 2489bb7d5203844b3fbe8efbe007f44aa074685d clean prompts=none sweep=none story=none trace=0b5c9263a55c09e6fbd870b2d9ff5d9b host=loom-worker-2 base=723f87adfc74b60143c634a501e6ae08d253faee run=loom-run/v1:timer:loom-worker-2/fleet-resync:d3f5a5beb1144f72ac8be575767b3e03 installs=0.19.760 3a509582b179d91c2d5b5a65a7ba4650c3c08985 -->
    Loom-Trace-Id: 0b5c9263a55c09e6fbd870b2d9ff5d9b
    Loom-Build: unknown 2489bb7d5203844b3fbe8efbe007f44aa074685d clean
    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
2026-10-06 chore: resync installed Loom surfaces
    <!-- loom:provenance v1 build=unknown 986d16b700174622774ff68af4ef323e8d0e23ba clean prompts=none sweep=none story=none trace=cb518f1f5785c258556383940a46c461 host=loom-worker-1 base=241d38268539b74f7bce7f9c6d4a80fb036a795d run=loom-run/v1:timer:loom-worker-1/fleet-resync:97df92c5eca846de85e979810663a94b installs=0.19.765 c6cec65c4f320f11153c72e840e49a5d6a6f1afc -->
    Loom-Trace-Id: cb518f1f5785c258556383940a46c461
    Loom-Build: unknown 986d16b700174622774ff68af4ef323e8d0e23ba clean
    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
2026-10-06 chore: resync installed Loom surfaces
    <!-- loom:provenance v1 build=unknown 31b34ebfd7d4539094523eaa7b56a104bebe5fc0 clean prompts=none sweep=none story=none trace=16fac36f144dc183c71465eb36c89afc host=loom-worker-3 base=25d0ae3e5014c7c34c323ccd379ca7e2588a79c7 run=loom-run/v1:timer:loom-worker-3/fleet-resync:c763e24590314b918c8ee8df5d2de1db installs=0.19.769 af995a5725fdadf708127f006aa8f248b482d7d7 -->
    Loom-Trace-Id: 16fac36f144dc183c71465eb36c89afc
    Loom-Build: unknown 31b34ebfd7d4539094523eaa7b56a104bebe5fc0 clean
    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
2026-10-06 chore: resync installed Loom surfaces
    <!-- loom:provenance v1 build=unknown 7bed309263b3785eae46a9cbc53b3b24a52b10d2 clean prompts=none sweep=none story=none trace=843adbd5eac450c43d3a2c43da1bf729 host=robb-studio base=aded3185198b1e662f60625d620539ac8d16efaf run=loom-run/v1:timer:robb-studio/fleet-resync:f83d5ba4-81f7-479a-9768-6af33d4cc825 installs=0.19.783 a9b459e0c2b1916ceb116db33053e7eb0df57e7b -->
    Loom-Trace-Id: 843adbd5eac450c43d3a2c43da1bf729
    Loom-Build: unknown 7bed309263b3785eae46a9cbc53b3b24a52b10d2 clean
    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
2026-10-06 chore: resync installed Loom surfaces
    <!-- loom:provenance v1 build=unknown 07bc40ba9ab0f7dfe7cd0990377b7ac07a52d220 clean prompts=none sweep=none story=none trace=563f186108419cf03cef002a62c3b201 host=loom-worker-2 base=83d19c25669777adffd7658b53e729b435b59fbc run=loom-run/v1:timer:loom-worker-2/fleet-resync:944beccd157a4197b81feafdd19f443e installs=0.19.785 2f0a9dbb4f06053f747b8a5615a3519f8e30b527 -->
    Loom-Trace-Id: 563f186108419cf03cef002a62c3b201
    Loom-Build: unknown 07bc40ba9ab0f7dfe7cd0990377b7ac07a52d220 clean
    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
2026-10-06 chore: resync installed Loom surfaces
    <!-- loom:provenance v1 build=unknown 31b34ebfd7d4539094523eaa7b56a104bebe5fc0 clean prompts=none sweep=none story=none trace=ea6600df41a4b420b6d8e967f839ccfd host=loom-worker-3 base=fa9f1428973fb93250f10795d45ee294b3fce5cc run=loom-run/v1:timer:loom-worker-3/fleet-resync:c80415b48fd5404bbd599c4f6cc8a448 installs=0.19.793 7ceff96944c39d33e3c2f1141ca650c2c4c05679 -->
    Loom-Trace-Id: ea6600df41a4b420b6d8e967f839ccfd
    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
2026-10-06 chore: resync installed Loom surfaces
    <!-- loom:provenance v1 build=unknown 596a53e525683919daae1b43e6babe9bf847a02f clean prompts=none sweep=none story=none trace=b9c0cb42a5a72ecc21726229c957ef1f host=loom-worker-2 base=42de154edaee0dac2271a7831dcfff7eb7c339b3 run=loom-run/v1:timer:loom-worker-2/fleet-resync:21d578f5cc0b4b7ba5f10759f5f30ae8 installs=0.19.801 524bdb33cb26c8355454d7550413c89e72c06fae -->
    Loom-Trace-Id: b9c0cb42a5a72ecc21726229c957ef1f
    Loom-Build: unknown 596a53e525683919daae1b43e6babe9bf847a02f clean
    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
2026-10-06 chore: resync installed Loom surfaces
    <!-- loom:provenance v1 build=unknown 40b591a33adb895d4f46977105f9b264d8a2599b clean prompts=none sweep=none story=none trace=e41c725fe0c176312eb412bc69fe5b01 host=robb-studio base=72a748c593e6d56b1d78d37d5d551787bd1784ff run=loom-run/v1:timer:robb-studio/fleet-resync:37d704dd-4dfd-4341-adb4-6551637ad147 installs=0.19.803 5af82e9a4b23b68166889a3435b7f3ca8161d0e6 -->
    Loom-Trace-Id: e41c725fe0c176312eb412bc69fe5b01
    Loom-Build: unknown 40b591a33adb895d4f46977105f9b264d8a2599b clean
    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
2026-10-06 chore: resync installed Loom surfaces
    <!-- loom:provenance v1 build=unknown 31b34ebfd7d4539094523eaa7b56a104bebe5fc0 clean prompts=none sweep=none story=none trace=5ad0480c4b21b80f9c852c448319e7a1 host=loom-worker-3 base=7552eb9307b002ac679ca7d3245c4e634f246e6a run=loom-run/v1:timer:loom-worker-3/fleet-resync:48e836f11f9547ddb96de5aa0d072a05 installs=0.19.810 933f828e779602e492e4e157812988a4b8128111 -->
    Loom-Trace-Id: 5ad0480c4b21b80f9c852c448319e7a1
    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
2026-10-07 chore: resync installed Loom surfaces
    <!-- loom:provenance v1 build=unknown f71cf25de9e75bae6060da4a599df8fbabe75890 clean prompts=none sweep=none story=none trace=64943e35511da4833bbd385cf288be8a host=loom-worker-2 base=eb2b1f3cdec379f0088d26ffc70559424f48e6e2 run=loom-run/v1:timer:loom-worker-2/fleet-resync:d69eb1b87d4849ae810a145b1b667d2f installs=0.19.822 1c6969ea8726c800a353c236d9f23456a5706f1a -->
    Loom-Trace-Id: 64943e35511da4833bbd385cf288be8a
    Loom-Build: unknown f71cf25de9e75bae6060da4a599df8fbabe75890 clean
    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
2026-10-07 chore: resync installed Loom surfaces
    <!-- loom:provenance v1 build=unknown 31b34ebfd7d4539094523eaa7b56a104bebe5fc0 clean prompts=none sweep=none story=none trace=cb192cb8f72cf6f2711f73f7ee12bebc host=loom-worker-3 base=2c734da18fc73fbff08dfcf261c00c2475d4ef86 run=loom-run/v1:timer:loom-worker-3/fleet-resync:c1e385c3607e43ad8bed9c7d29811c66 installs=0.19.830 a966f7b89b714704fa1225b96e2dbee50480a4c6 -->
    Loom-Trace-Id: cb192cb8f72cf6f2711f73f7ee12bebc
    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
2026-10-07 chore: resync installed Loom surfaces
    <!-- loom:provenance v1 build=unknown 8abdd34fddc879aff407380278baa713eca6b758 clean prompts=none sweep=none story=none trace=ea945665dad5ccb3880de51c4448e8b9 host=robb-pro base=1d414bd8732755a7ae0fd31a94d1625398e282d4 run=loom-run/v1:timer:robb-pro/fleet-resync:1466e397-b80c-46ea-a42c-26a7fbd4e00e installs=0.19.831 61814c9c1912925cdff7418842ff3ea17cd56fe4 -->
    Loom-Trace-Id: ea945665dad5ccb3880de51c4448e8b9
    Loom-Build: unknown 8abdd34fddc879aff407380278baa713eca6b758 clean
    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
2026-10-07 chore: resync installed Loom surfaces
    <!-- loom:provenance v1 build=unknown 628be5bb140bcff803d159201bd61e1b868901b0 clean prompts=none sweep=none story=none trace=093df1dc315c5e78dcccfca9d699d5f5 host=loom-worker-2 base=3aaf292cff2119c6753ecea35f70de80378cc85f run=loom-run/v1:timer:loom-worker-2/fleet-resync:0b0ea5e184c0429a9c431fcca6c791ad installs=0.19.832 1a0fc15974bf0575a9155fb8276f7529fc813542 -->
    Loom-Trace-Id: 093df1dc315c5e78dcccfca9d699d5f5
    Loom-Build: unknown 628be5bb140bcff803d159201bd61e1b868901b0 clean
    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
2026-10-07 chore: resync installed Loom surfaces
    <!-- loom:provenance v1 build=unknown 069e3b45d86c08f0d60c8fc2b0096de441e99bdc clean prompts=none sweep=none story=none trace=b1ba9d6b2b581e47827d9c099f717b04 host=loom-worker-1 base=346989e98965138d7d028ed4b1feb5be05544cfe run=loom-run/v1:timer:loom-worker-1/fleet-resync:aada8278bd4843bcaecce69fdf91251e installs=0.19.838 e70aa17f8dead31bda49cf044c3fc28119df6e90 -->
    Loom-Trace-Id: b1ba9d6b2b581e47827d9c099f717b04
    Loom-Build: unknown 069e3b45d86c08f0d60c8fc2b0096de441e99bdc clean
    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
2026-10-07 chore: resync installed Loom surfaces
    <!-- loom:provenance v1 build=unknown 31b34ebfd7d4539094523eaa7b56a104bebe5fc0 clean prompts=none sweep=none story=none trace=ef030e94bce76f728497f5927960865f host=loom-worker-3 base=c67adff4122add3690dd6b4df40690a93a2599d1 run=loom-run/v1:timer:loom-worker-3/fleet-resync:28ba4284bfa446c888b501714eda0509 installs=0.19.840 59b533a2a1ed5e186fbf8446b5acbe42d7231854 -->
    Loom-Trace-Id: ef030e94bce76f728497f5927960865f
    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
2026-10-07 chore: resync installed Loom surfaces
    <!-- loom:provenance v1 build=unknown bc59c70c3412a87b31a0dbe65cd6abf968744328 clean prompts=none sweep=none story=none trace=766033e4e881801f24971d664c490ea3 host=robb-studio base=c4854ca550c354a175d573752af8c17bb768ef5b run=loom-run/v1:timer:robb-studio/fleet-resync:6b3b079a-890e-4a79-9c3a-0b4bb33ff7c4 installs=0.19.840 59b533a2a1ed5e186fbf8446b5acbe42d7231854 -->
    Loom-Trace-Id: 766033e4e881801f24971d664c490ea3
    Loom-Build: unknown bc59c70c3412a87b31a0dbe65cd6abf968744328 clean
    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
2026-10-07 chore: resync installed Loom surfaces
    <!-- loom:provenance v1 build=unknown a068938e7a6c13759bcb3943e408273a3d352257 clean prompts=none sweep=none story=none trace=76bec863c8f6aff2d49b3aa2be128619 host=robb-pro base=42efba7b07ac9140ef98c9077d7bb45b366a302b run=loom-run/v1:timer:robb-pro/fleet-resync:d9927fc6-ee80-4b6a-ba2b-f13576bd5f9b installs=0.19.847 fcb4e400253cae9c722e568bfd5ec8f0625c5518 -->
    Loom-Trace-Id: 76bec863c8f6aff2d49b3aa2be128619
    Loom-Build: unknown a068938e7a6c13759bcb3943e408273a3d352257 clean
    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
2026-10-07 chore: resync installed Loom surfaces
    <!-- loom:provenance v1 build=unknown 628be5bb140bcff803d159201bd61e1b868901b0 clean prompts=none sweep=none story=none trace=5a6f676b4652a1a750bbce1386c68d06 host=loom-worker-2 base=00c7765f24722a00892cc7281cfdc4855346b11d run=loom-run/v1:timer:loom-worker-2/fleet-resync:bd416e653be04ef4b13353430625e379 installs=0.19.850 3bb4bfc90603b6ad65cabca9b3eb42a59f1a9d3a -->
    Loom-Trace-Id: 5a6f676b4652a1a750bbce1386c68d06
    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
2026-10-07 chore: resync installed Loom surfaces
    <!-- loom:provenance v1 build=unknown 40215645df8a13508180b248b44244dc488bb078 clean prompts=none sweep=none story=none trace=29fde30615e6e47f39b41aa314c2c883 host=loom-worker-1 base=a3e56c8e89019c766adb532a4dbd7ff01149330a run=loom-run/v1:timer:loom-worker-1/fleet-resync:d1fbedfcc7824ae59233c0ea94dc4650 installs=0.19.853 2889d5ed585b4da0935543cb916381cc03b19746 -->
    Loom-Trace-Id: 29fde30615e6e47f39b41aa314c2c883
    Loom-Build: unknown 40215645df8a13508180b248b44244dc488bb078 clean
    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
2026-10-07 chore: resync installed Loom surfaces
    <!-- loom:provenance v1 build=unknown 31b34ebfd7d4539094523eaa7b56a104bebe5fc0 clean prompts=none sweep=none story=none trace=cdf49c615da3f5ce46e9fcda1a24f787 host=loom-worker-3 base=6b3040eef3d1becd73c69bd7055ad44f6d09b06a run=loom-run/v1:timer:loom-worker-3/fleet-resync:cab31e05b8a24df09bc88f53ee3fb501 installs=0.19.857 7a0b529e6f57a79713f6924bf58d8392ff404259 -->
    Loom-Trace-Id: cdf49c615da3f5ce46e9fcda1a24f787
    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
2026-10-07 chore: resync installed Loom surfaces
    <!-- loom:provenance v1 build=unknown 4b44e7c5db0de1d2b5927de7de229120d546aad3 clean prompts=none sweep=none story=none trace=dfa656ee3483a044378501f49d36f812 host=robb-studio base=7f5b7aa2f0b2148dd664c2479fa7759be5e15fed run=loom-run/v1:timer:robb-studio/fleet-resync:d80d6bc0-eb68-4a07-8226-2d947d328b3a installs=0.19.859 0aefebd79aba8ab33470f1af4b96847fc794bd0d -->
    Loom-Trace-Id: dfa656ee3483a044378501f49d36f812
    Loom-Build: unknown 4b44e7c5db0de1d2b5927de7de229120d546aad3 clean
    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
2026-10-07 chore: resync installed Loom surfaces
    <!-- loom:provenance v1 build=unknown b591c8cf436f0d4aa5870a9bc7cd5f7194e0e778 dirty prompts=none sweep=none story=none trace=6eca4b0c47205457aae7a3d721c17f17 host=robb-pro base=8f3fc4535b414c5fd0f051a72518540b368d6e4c run=loom-run/v1:timer:robb-pro/fleet-resync:64af20b3-58cb-47f2-b770-117197cb41e9 installs=0.19.864 128a7eba2bb5f7bcf8891ba284b14cb7ebf8dd3d -->
    Loom-Trace-Id: 6eca4b0c47205457aae7a3d721c17f17
    Loom-Build: unknown b591c8cf436f0d4aa5870a9bc7cd5f7194e0e778 dirty
    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
2026-10-07 chore: resync installed Loom surfaces
    <!-- loom:provenance v1 build=unknown b551219fd5b8347113c0cbc79ea416e81c39fa9d clean prompts=none sweep=none story=none trace=5ac7c8c62dad54841e21dd94f0920de3 host=loom-worker-2 base=bc87048271ad129b953fa289f98d55f9b7ea7c52 run=loom-run/v1:timer:loom-worker-2/fleet-resync:d10fb10789e94930ab1af368c15a8f8b installs=0.19.864 128a7eba2bb5f7bcf8891ba284b14cb7ebf8dd3d -->
    Loom-Trace-Id: 5ac7c8c62dad54841e21dd94f0920de3
    Loom-Build: unknown b551219fd5b8347113c0cbc79ea416e81c39fa9d clean
    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
2026-10-07 chore: resync installed Loom surfaces
    <!-- loom:provenance v1 build=unknown 90fbd167e4e376894396e651676cf58fc9aa223a clean prompts=none sweep=none story=none trace=196876656e912171b28029ceca9f772d host=loom-worker-1 base=e9367e506f46a72a9b8fac357859a7094a8678fd run=loom-run/v1:timer:loom-worker-1/fleet-resync:7b46720ff3a84a8184f2f2b3bc039260 installs=0.19.868 ee904e1c151bc9cf15b0eb55dfe9d57ad6136cff -->
    Loom-Trace-Id: 196876656e912171b28029ceca9f772d
    Loom-Build: unknown 90fbd167e4e376894396e651676cf58fc9aa223a clean
    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
2026-10-08 chore: resync installed Loom surfaces
    <!-- loom:provenance v1 build=unknown 5a3df331a0612dee585ef905015af01d08e3467f clean prompts=none sweep=none story=none trace=5690fa95febe608e500a46dde8a6ee92 host=loom-worker-2 base=b001b5ee7082190c6f122b8ea79c3bc726e8a1ae run=loom-run/v1:timer:loom-worker-2/fleet-resync:5c9c35d59b704bff9d8bf096ee7ba7be installs=0.19.876 b16d54e63fbbec4d7f15f13c1f43a5e5b38145ce -->
    Loom-Trace-Id: 5690fa95febe608e500a46dde8a6ee92
    Loom-Build: unknown 5a3df331a0612dee585ef905015af01d08e3467f clean
    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
2026-10-08 chore: resync installed Loom surfaces
    <!-- loom:provenance v1 build=unknown 134eb3ff06c1a86f49a911c6c17464f55e719736 clean prompts=none sweep=none story=none trace=c7df110d490314040dcd1347b2481843 host=loom-worker-1 base=98efcb7464f51281e263e953b828e65e17123201 run=loom-run/v1:timer:loom-worker-1/fleet-resync:53d0cec2cd61484eb9a0f8fb1f24ac5e installs=0.19.879 c15619905bdd8a24506c3853f45490d26e8f1cad -->
    Loom-Trace-Id: c7df110d490314040dcd1347b2481843
    Loom-Build: unknown 134eb3ff06c1a86f49a911c6c17464f55e719736 clean
    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
2026-10-08 chore: resync installed Loom surfaces
    <!-- loom:provenance v1 build=unknown 8f86de23319d8f6cf049557dcc9cf2e321211d9d clean prompts=none sweep=none story=none trace=17de45f778fbfd714af8afad02c96375 host=loom-worker-3 base=ae1ab2d78100bc1ce235a24ee0373685f61e8032 run=loom-run/v1:timer:loom-worker-3/fleet-resync:9e3e5d4a08824de3b7bc02940be2a0da installs=0.19.882 c9f85af3d967986cdd7a3f27e088a16f88712b05 -->
    Loom-Trace-Id: 17de45f778fbfd714af8afad02c96375
    Loom-Build: unknown 8f86de23319d8f6cf049557dcc9cf2e321211d9d clean
    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
2026-10-08 chore: resync installed Loom surfaces
    <!-- loom:provenance v1 build=unknown 4a5fb2b6276e17ff26ee1382acfe2ea7360ebea5 clean prompts=none sweep=none story=none trace=67857e1b7189785825a2dfc70921cf85 host=loom-worker-2 base=8716bbd73f2c0583c66ac0c5cce319e9fa712685 run=loom-run/v1:timer:loom-worker-2/fleet-resync:dd6a5f3dceff4d8d8602a07a1dc89c95 installs=0.19.892 ce93e8a919d79a6f027bab268846a52084f9d94e -->
    Loom-Trace-Id: 67857e1b7189785825a2dfc70921cf85
    Loom-Build: unknown 4a5fb2b6276e17ff26ee1382acfe2ea7360ebea5 clean
    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
2026-10-08 chore: resync installed Loom surfaces
    <!-- loom:provenance v1 build=unknown 4642b719c1ebd1e25ab9a120318382d5dee39e24 clean prompts=none sweep=none story=none trace=ccd1e9a8f8444cbe1e3a7875756f6920 host=loom-worker-1 base=75dfc8b9ff4e68a87bf6aadd4c4e8de91cf4ec1e run=loom-run/v1:timer:loom-worker-1/fleet-resync:90a498201f3142e8a28e1df54380a041 installs=0.19.897 d90a0888f37b28cb14f7fe72413a425eb87a6f60 -->
    Loom-Trace-Id: ccd1e9a8f8444cbe1e3a7875756f6920
    Loom-Build: unknown 4642b719c1ebd1e25ab9a120318382d5dee39e24 clean
    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
2026-10-08 chore: resync installed Loom surfaces
    <!-- loom:provenance v1 build=unknown 5684fc8c8ac418d95ad66a002d001eaea1283c9a clean prompts=none sweep=none story=none trace=c864acd3b9a5dbb419fddd8bd2a6283b host=loom-worker-3 base=4448a8794185a3ccf4ea1b2b1433ce6e8cc3f9db run=loom-run/v1:timer:loom-worker-3/fleet-resync:4771e7c630c34445b7f28539669d76e3 installs=0.19.898 3d55b9a1669c132d130d98f10a292c1325322c30 -->
    Loom-Trace-Id: c864acd3b9a5dbb419fddd8bd2a6283b
    Loom-Build: unknown 5684fc8c8ac418d95ad66a002d001eaea1283c9a clean
    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
2026-10-08 chore: resync installed Loom surfaces
    <!-- loom:provenance v1 build=unknown 04a1189116c7320def7d9ce357d2d9268405ae92 clean prompts=none sweep=none story=none trace=8e55b27fc60ffb045554bd413ad8f3c8 host=robb-pro base=b7ce4fe46e66ab757de624432f114838cebbf03a run=loom-run/v1:timer:robb-pro/fleet-resync:83b69005-7c5b-44b3-96f8-33f07bf82f4b installs=0.19.917 d3c1ea3a4c81e01ce5487dc3e4bbdd86534e677e -->
    Loom-Trace-Id: 8e55b27fc60ffb045554bd413ad8f3c8
    Loom-Build: unknown 04a1189116c7320def7d9ce357d2d9268405ae92 clean
    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
2026-10-08 chore: resync installed Loom surfaces
    <!-- loom:provenance v1 build=unknown d2a55ce217b3ad1793611a2c54946676bb55b512 clean prompts=none sweep=none story=none trace=459637e4e8503593bdf58360865a7524 host=robb-pro base=6f12f40f57cc7feff7662d6b8058a76d9886d0eb run=loom-run/v1:timer:robb-pro/fleet-resync:95b3cf92-9cd9-4c36-8bbd-bdcace7c3874 installs=0.19.935 d347079cd0bad2db2c11ee4f0b760f04b2601d21 -->
    Loom-Trace-Id: 459637e4e8503593bdf58360865a7524
    Loom-Build: unknown d2a55ce217b3ad1793611a2c54946676bb55b512 clean
    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
2026-10-08 signoff: bind T1 items 1, 9, 10 to audited inventories; bump klt pin to 3a75c3ae
    Loom-Story: 2AMLogic/sg13g2-opamp#84
    Loom-Trace-Id: c1666af80b68c1bf6ff8d662774b4752
    Loom-Build: 0.19.898 3d55b9a1669c132d130d98f10a292c1325322c30 clean
2026-10-08 signoff: record 7 of 11 T1 items met at klt 3a75c3ae
    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
2026-10-09 signoff: offline per-spec-row characterization report generator (T1 item 8)
    Stdlib-only generator over an explicit, hash-pinned record selection
    (signoff/characterization/selection.json): per row units, load, ratified
    bound + decision record, worst/best with binding point, source record +
    sha256, expected/observed/valid grid coverage and verdict. Unratified
    measured quantities, the superseded CMRR floor and pending Area are kept
    separate; systematic and Monte Carlo offset stay distinct, with the MC
    fixed-supply limit carried as a caveat.
    Missing records, pin mismatches, duplicate point IDs, non-finite values,
    off-grid/mislabelled points, mixed ngspice, a different simulated netlist,
    a non-l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
2026-10-09 signoff: mint characterization report 20261009-005750-622fb9c and cite it for T1 item 8
    generic envelope signoff/evidence/characterization.json (t1_item 8) binds
    the minted JSON record by repo path + sha256; block-manifest.json and
    pinned-inputs.json pin the same hash. Overall PASS: 12/12 ratified bounds,
    full 45-point (15+1 MC) coverage, no input errors. Docs record the stated
    comparison precision and that four rows clear only at ratified precision.
    Part of #90
    Loom-Story: 2AMLogic/sg13g2-opamp#90
    Loom-Trace-Id: 8a312c1ba0a1c8911743246f1b81aca6
    Loom-Build: 0.19.868 ee904e1c151bc9cf15b0eb55dfe9d57ad6136cff clean
2026-10-09 signoff: regrade -- T1 item 8 met (8/11)
    Fresh verdict of record from klt signoff --manifest at the pinned
    revision 3a75c3a: item 8 cites the characterization report envelope,
    input re-hashed and matched. Items 5, 6, 7 remain unmet (no_evidence).
    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
2026-10-09 signoff: grade characterization rows against the literal ratified bound
    Judge review on #94: rounding each point to the bound's written decimals
    before comparing relaxed every ratified bound (PM 59.5 deg passed >= 60,
    DC gain 37.75 dB passed >= 37.8), and no ratification record defines such
    a convention.
    - evaluate_row compares the RAW value against the literal bound; the
    value rounded to the bound's decimals is kept as display only.
    - DC gain, integrated noise, systematic offset and swing span now grade
    FAIL (raw 37.7812 dB, 108.949 uVrms, 21.927 mV, 0.570958 V); they are
    disclosed under overall.fail_only_beyond_written_decimals and the spec
    question is routed to the keys in #101 (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
2026-10-09 signoff: mint characterization report 20261009-010537-3b553cb (overall FAIL) and cite it for T1 item 8
    Literal comparison against the ratified bounds: 8/12 ratified bounds PASS;
    DC gain, integrated noise, systematic offset and swing span FAIL by
    0.0188 dB, 0.049 uVrms, 0.027 mV and 0.042 mV (spec question #101). The
    item 8 generic envelope now carries status fail; manifest and
    pinned-inputs pins move to the new record. The superseded record
    20261009-005750-622fb9c (rounding rule, schema /1) stays unedited as
    append-only history and is no longer cited.
    Loom-Trace-Id: 8a312c1ba0a1c8911743246f1b81aca6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
2026-10-09 signoff: regrade -- T1 item 8 unmet (check_failed), 7/11 met
    New verdict of record at klt 3a75c3ae: item 8 cites the FAIL
    characterization report 20261009-010537-3b553cb (envelope status fail)
    and grades unmet/check_failed. README and signoff/README no longer claim
    item 8 met; they state the literal-comparison rule, the four failing rows
    and the spec question in #101, and mark the earlier 8/11 record
    (20261009-005834-69b7b63) as superseded append-only history.
    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
2026-10-09 integration: derive integrator GDS availability and graded maturity from newest signoff record
    Add signoff/sync_integrator.py (--check/--update), run --check in the signoff CI job, refresh spec/integrator.json (GDS path, 7/11, newest record), and replace obsolete no-layout wording in target-spec.md. Area row stays UNRATIFIED with numeric area unset.
    Loom-Story: 2AMLogic/sg13g2-opamp#91
    Loom-Trace-Id: e0fb0c911a18c16e6f64bbb9a36c9e51
    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
2026-10-09 feat(signoff): continuously validate the item 1/9/10 inventory entries offline
    Add signoff/check_inventories.py (stdlib-only, offline, PDK-free): it reads
    design-sources.txt, testbenches.txt and hygiene.txt through a documented
    parseable subset of their existing format and checks that the paths they
    name exist, bench runners are executable and pass bash -n, referenced
    templates and cited records (+ .md companions) exist, the named Markdown
    headings and Cold-start sections are present, the regenerate command is
    consistent with the listed sources, the PDK pin agrees with sim/pdk.json,
    and (in a git checkout) everything is tracked with runners committed 100755.
    Negative controls in signoff/tes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
2026-10-09 chore: resync installed Loom surfaces
    <!-- loom:provenance v1 build=unknown 05dba463c5b293d38f0ca071725983862498b3f3 clean prompts=none sweep=none story=none trace=14298316053024bcf5120bff695771ab host=robb-pro base=c544fb3a4a8ef7a46320e032001877b0d937eb02 run=loom-run/v1:timer:robb-pro/fleet-resync:2f384483-6d77-4ba2-9888-aa1e4b5be36c installs=0.19.954 95a65ddf91931f7ca49cdf73aa15fbb8772954af -->
    Loom-Trace-Id: 14298316053024bcf5120bff695771ab
    Loom-Build: unknown 05dba463c5b293d38f0ca071725983862498b3f3 clean
    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
2026-10-09 docs(signoff): record why T1 item 6 stays unmet; stage offset-MC sample-set (#105)
    Reproducible, limit-free reshape of the offset draws CSV for klt yield; no
    invented limits or target_yield, no report. Follow-ups #107, #108;
    upstream friction klayout-tools#2931.
    Loom-Story: 2AMLogic/sg13g2-opamp#105
    Loom-Trace-Id: 93c8fea50711f8c80cd47997142a17ce
    Loom-Build: 0.19.950 72047016af9d66c08f900bb94c642a66dfd75fc5 clean
2026-10-09 sim: guard MC runners against local grid execution under KLT_SIM_BACKEND=batch (#110)
    Add sim/grid-guard.sh (sourced before preflight, so it fires before any
    ngspice launch); both MC runners refuse with exit 2 unless
    --allow-local-grid. Offset harness default PARALLEL 8 -> 2. READMEs note
    the guard; sim/tools/test-grid-guard.sh is the negative control.
    Loom-Story: 2AMLogic/sg13g2-opamp#110
    Loom-Trace-Id: 6b284beb66d552fff573db7dabc0e4eb
    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
2026-10-09 test(signoff): offline negative controls for check_signoff and sync_integrator (#111)
    Loom-Story: 2AMLogic/sg13g2-opamp#111
    Loom-Trace-Id: 42d49da9c44812e4726c40188721abf0
    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
2026-10-09 post-layout: klt pex --measure-command harness for T1 item 7 (#86)
    Adds sim/post-layout (open-loop AC measure command, bound checker, offline
    tests) and layout/opamp_core/run_pex.sh. The 45-corner grid was not run: the
    authoring host cannot (ngspice-42 vs v0.4 OSDI, and batch-backend rule).
    Item 7 stays unmet; no manifest/record change.
    Loom-Story: 2AMLogic/sg13g2-opamp#86
    Loom-Trace-Id: bd775c1d074fc9d7825f4e449da91450
    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
2026-10-09 chore: resync installed Loom surfaces
    <!-- loom:provenance v1 build=unknown 7f06b288b150f2fe0a4b24c331a9b3ec093d709d clean prompts=none sweep=none story=none trace=a90c217ff3a3bd9e3a30282b8cadc24d host=robb-pro base=c4c30316ba753b46092546c0b0dcadac59b773bd run=loom-run/v1:timer:robb-pro/fleet-resync:6e5ec9f3-d6ef-4953-80f7-c93035e2d359 installs=0.19.967 cc9c6cf61d1aebc3153cd1588ca304445a6b9ced -->
    Loom-Trace-Id: a90c217ff3a3bd9e3a30282b8cadc24d
    Loom-Build: unknown 7f06b288b150f2fe0a4b24c331a9b3ec093d709d clean
    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
2026-10-09 spec: draft DR-0006 resolving the ICMR row (not ratified) + offline evidence checker (#114)
    Loom-Story: 2AMLogic/sg13g2-opamp#114
    Loom-Trace-Id: 3f8b4e023d26a10814c41cc3eff96d6c
    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
2026-10-09 sim: express the slew-rate bench as a klt sim request (T1 item 5, #95)
    Request, circuit body, validation-gated run.sh, harness comparison with
    negative-control tests, README section, and signoff coverage-table update.
    Real 45-corner envelope blocked (fleet runner klt 0.5.0, 2am#2193; host
    ngspice-42 preflight); nothing run locally.
    Loom-Story: 2AMLogic/sg13g2-opamp#95
    Loom-Trace-Id: 1bc39b661b1e5483dacf61271e724561
    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
2026-10-09 ci: run sim/ offline tests and evidence checkers in signoff.yml (#119)
    Loom-Story: 2AMLogic/sg13g2-opamp#119
    Loom-Trace-Id: 715828ad57038183c7111ae94684c3ac
    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
2026-10-09 ci: enforce append-only evidence against the previous Git tree (#121)
    Loom-Story: 2AMLogic/sg13g2-opamp#121
    Loom-Trace-Id: f44b829291b72099a1feaa16a5f462c1
    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
2026-10-09 test: disable background git gc/maintenance in append-only gate tests (#121)
    A detached `git gc --auto` spawned by the Repo helper's commits could write
    into .git while TemporaryDirectory.cleanup ran, failing CI with ENOTEMPTY.
    Set gc.auto=0, maintenance.auto=false, gc.autoDetach=false in each temp
    repo, and use TemporaryDirectory(ignore_cleanup_errors=True) (Python 3.12
    in signoff.yml) as a backstop.
    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
2026-10-09 docs: record item-7 pex status and one-point probe (#86)
    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
2026-10-09 post-layout: express the item-7 measure command as klt sim requests (batch), not a local ngspice loop (#86)
    Part of #86. The 45-point grid is now an AC + OP klt sim request pair per
    leg; a batch submit failure is a hard failure. The run itself is blocked by
    batch_runner_version_mismatch (runner klt 0.5.0 vs client 0.7.0), so no
    pex_report.json and item 7 stays unmet.
    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
2026-10-09 spec: draft reproducible GDS bounding-box area definition for TBD-12 (#115)
    Proposed, unratified DR-0007 plus offline klayout.db extractor, tests,
    deterministic measurement and CI step. Binding Area row, integrator
    area_mm2 and verdicts unchanged.
    Loom-Story: 2AMLogic/sg13g2-opamp#115
    Loom-Trace-Id: ad9a74ec81ee5134b366fcbe4d20e586
    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
2026-10-09 chore: resync installed Loom surfaces
    <!-- loom:provenance v1 build=unknown 30c7a7ee2f74a6a2b5bb0f19fd9f049ec8ae8b5c clean prompts=none sweep=none story=none trace=7bc5ba399ff199d049d83d711920a157 host=robb-pro base=dcf72bf30c0b8d79179efa8b28986192852bc9f1 run=loom-run/v1:timer:robb-pro/fleet-resync:8e237160-c4d0-4ce3-85ac-c96aff5cf221 installs=0.19.982 2bc4cba624b9053535663441e6f0daf08a7acf2e -->
    Loom-Trace-Id: 7bc5ba399ff199d049d83d711920a157
    Loom-Build: unknown 30c7a7ee2f74a6a2b5bb0f19fd9f049ec8ae8b5c clean
    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
2026-10-09 sim: input-noise bench as a klt sim request (Part of #96, first increment)
    Request, circuit body, runner, comparator with negative-control tests and
    README/coverage-table updates. No real envelope yet; tolerances provisional;
    DUT corner prototype pending (OSDI preflight needs ngspice-46).
    Loom-Story: 2AMLogic/sg13g2-opamp#96
    Loom-Trace-Id: 698f8afebd2da473e24fdc4882a88263
    Loom-Build: 0.19.972 113c7f31d7d16f75d30c470023e0b65b29b1fe94 clean
2026-10-10 chore: resync installed Loom surfaces
    <!-- loom:provenance v1 build=unknown a7d2b01d8eb7d09e597a4638e5cb3cdd8bab9156 clean prompts=none sweep=none story=none trace=35c1337ee84607e87ba2038523d63198 host=robb-pro base=043e83e97c62ec26877a17c1ba8e7bc350c1bb3a run=loom-run/v1:timer:robb-pro/fleet-resync:6bf32a81-6c4a-48c5-a51e-1ad65c6bedfd installs=0.19.1001 1c1131220b2f5950fe54b7cd02ebd3f1aae488dd -->
    Loom-Trace-Id: 35c1337ee84607e87ba2038523d63198
    Loom-Build: unknown a7d2b01d8eb7d09e597a4638e5cb3cdd8bab9156 clean
    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
2026-10-10 sim: one-corner DUT prototype of the input-noise klt sim request
    Part of #96
    Runs one corner (mos_tt, 27 C, VDD 1.20 V) of noise.request.json locally
    on a host that passes sim/preflight.sh (ngspice-46, OSDI loadable). The
    reduced request and the unmodified envelope are committed under
    sim/input-noise/klt/. noise2.inoise_total and the noise1 spot densities
    match the harness row mos_tt_27C_1.20V to the CSV's printed precision
    (max |rel diff| 1.2e-6). This is an encoding check, not envelope
    evidence: the envelope is kept out of klt/records/ and the provisional
    comparison tolerance is unchanged. Band, bound and manifest are unchanged.
    Loo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
2026-10-10 signoff: bind ERC supply-spec bytes to item-11 evidence
    Loom-Story: 2AMLogic/sg13g2-opamp#134
    Loom-Trace-Id: eedef35c4e0cd7ba44520500b2cdd1eb
    Loom-Build: 0.19.996 0d2be7e9ae05753e2c9232a83b7399d45de5396e clean
2026-10-10 signoff: enforce LVS reference freshness from schematic netlist to recorded match
    Refs #136
    Loom-Story: 2AMLogic/sg13g2-opamp#136
    Loom-Trace-Id: b8142730cfb2d5f48b3fbebb9a3c0bb7
    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
2026-10-10 sim: PSRR supply-gain klt sim request, runner and comparator (Part of #99)
    Loom-Story: 2AMLogic/sg13g2-opamp#99
    Loom-Trace-Id: 1a48a8019fade249f6bf9c2a7becadb9
    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
2026-10-10 ratification: install ee-key and market-key reviewer trees (no opamp comp table)
    Generated from 2AMLogic/product 368768a (market-key, --no-comps --no-comps-for opamp)
    and 2AMLogic/2am 5514cf2 (ee-key). Part of product#151. Ratifies nothing.
    Loom-Story: 2AMLogic/sg13g2-opamp#106
    Loom-Trace-Id: 92b8e61f51f2d452a7c002b627a9ec30
    Loom-Build: 0.19.1009 8889f7bd1eccfb4bc8239e7f5669b65f9815c30e clean
2026-10-10 chore: resync installed Loom surfaces
    <!-- loom:provenance v1 build=unknown c156f673e072832aaacb4cd1ec65b742e7f45867 clean prompts=none sweep=none story=none trace=9de99c124c651049199abe9a75070dc7 host=robb-pro base=32d1d1ae8eab29f10fd237fa59e00763dd1f432a run=loom-run/v1:timer:robb-pro/fleet-resync:f790885c-7154-4b3d-acd9-71fd537cd20b installs=0.19.1010 d1d5fcecb79550fe39658555a4419f98cec060fb -->
    Loom-Trace-Id: 9de99c124c651049199abe9a75070dc7
    Loom-Build: unknown c156f673e072832aaacb4cd1ec65b742e7f45867 clean
    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
2026-10-10 chore: resync installed Loom surfaces
    <!-- loom:provenance v1 build=unknown 52f79668bb5f93c1828b7f1ea4f7013b917b847b clean prompts=none sweep=none story=none trace=7057f3175071f1f6e34b354fab40a0ce host=robb-studio base=85f85b6f1c688d0cf9c7ac6f36325584c6bc1af5 run=loom-run/v1:timer:robb-studio/fleet-resync:d8918779-1625-4202-b151-71f64465e8cd installs=0.19.1010 d1d5fcecb79550fe39658555a4419f98cec060fb -->
    Loom-Trace-Id: 7057f3175071f1f6e34b354fab40a0ce
    Loom-Build: unknown 52f79668bb5f93c1828b7f1ea4f7013b917b847b clean
    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
2026-10-10 yield-inputs: validate offset draw identities, gate sample-set reproduction in CI (Closes #141)
    Loom-Story: 2AMLogic/sg13g2-opamp#141
    Loom-Trace-Id: d2c9bad4f8404c1a149a4c0a67a9f32c
    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
2026-10-10 sim: per-draw CMRR draws CSV for the committed mismatch record (Closes #107)
    No-simulation post-processor make_draws_csv.sh turns the committed
    *_mc_samples.txt into records/<id>-draws.csv (13,500 rows) with an
    in-script round-trip against the summary CSV; Phase 5 of
    run_cmrr_mismatch_mc.sh uses the same script for future runs. Offline
    negative controls in sim/tools/test_make_draws_csv.py. DR-0004 caveat kept.
    Loom-Story: 2AMLogic/sg13g2-opamp#107
    Loom-Trace-Id: 7023abff3d1a79f0361304799d969029
    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
    [20260921-172304-65f5fb4-draws.csv]
2026-10-10 sim: share the compare.py CLI scaffold in klt_envelope (Closes #146)
    Move tol, load_envelope, the OUT OF TOLERANCE / VERDICT DISAGREES summary
    tail and run_cli (validate, --json-out, --provenance, exit 2 on InputError,
    inputs sha256 stanza, exit 0 iff agree) out of the three per-bench
    compare.py into sim/tools/klt_envelope.py. Byte-neutral.
    Loom-Story: 2AMLogic/sg13g2-opamp#146
    Loom-Trace-Id: 1110c91f7e0996e8536fe11f4d161868
    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
2026-10-10 sim: PSRR supply-gain 45-corner fleet envelope, shard bridge, measured comparison (Part of #99)
    The one-request psrr.request.json cannot run on the klt 0.5.0 fleet runner, so
    shard.py splits the same 45-point grid into five per-process requests (cap
    corner as a body .lib card, OSDI via a body pre_osdi block, DUT inlined) and
    merges the reports with a validation-gated merge that edits no corner.
    run.sh gains shard mode (default), resume and bounded capacity re-submission,
    never local. Tests cover missing/duplicate/unexpected shard, request-hash
    mismatch, wrong-process/missing/duplicate/wrong-VDD points, dirty coverage and
    stale aggregates, and re-derive the committed envelope from its raw sha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
2026-10-10 sim: psrr.request.json comment states how the committed envelope was minted (Part of #99)
    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
2026-10-10 sim: output-swing one-point klt sim prototype, offline comparator and negative controls (Part of #100)
    Loom-Story: 2AMLogic/sg13g2-opamp#100
    Loom-Trace-Id: 4c5df3a8b5725eaaf6cf0ac6b8b73d80
    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
2026-10-10 sim: share the klt run.sh wrapper steps in sim/tools/klt_run_common.sh (Closes #151)
    Loom-Story: 2AMLogic/sg13g2-opamp#151
    Loom-Trace-Id: b3ce530b1c76e45f03989416abefeef4
    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
2026-10-10 signoff: honor the committed klt pin in local re-grading (Closes #157)
    Loom-Story: 2AMLogic/sg13g2-opamp#157
    Loom-Trace-Id: 56f5a677b37e6431dd758a9bc8fab815
    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
2026-10-10 signoff: publish verdict records atomically only after successful grading (Closes #158)
    Loom-Story: 2AMLogic/sg13g2-opamp#158
    Loom-Trace-Id: 7a5dc9fe5ce694ae8ee6c644a61e3faf
    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
2026-10-10 ci: protect nested klt record trees with the append-only evidence gate (Closes #161)
    Loom-Story: 2AMLogic/sg13g2-opamp#161
    Loom-Trace-Id: 5b40b73ba1a1069c41aaff51a15ab444
    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
2026-10-10 signoff: read-only contract check of integrator ports and ratified bounds against sources (Closes #162)
    Loom-Story: 2AMLogic/sg13g2-opamp#162
    Loom-Trace-Id: a68607ff2c4df12a7af29a48d7e40983
    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
2026-10-10 chore: resync installed Loom surfaces
    <!-- loom:provenance v1 build=unknown 525fe43b7b1b2a0271084bba444c934a1541a8d8 clean prompts=none sweep=none story=none trace=0d4424bd058cf912b74934ec0e7bf37e host=robb-pro base=cfe7ff3bff42b078b9276bb9ff725cde3f7dd8fd run=loom-run/v1:timer:robb-pro/fleet-resync:4812047c-8b9b-4da2-a5dc-13e6f6420a04 installs=0.19.1019 0dca83f94fad8edfd754c67832a60a03e165e25d -->
    Loom-Trace-Id: 0d4424bd058cf912b74934ec0e7bf37e
    Loom-Build: unknown 525fe43b7b1b2a0271084bba444c934a1541a8d8 clean
    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
2026-10-10 characterization: validate complete ratified bound (op, whole numeric token, unit) against cited clause (Closes #155)
    Loom-Story: 2AMLogic/sg13g2-opamp#155
    Loom-Trace-Id: 7cb0d0da9ae3f58e9d964b458165a3d2
    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
2026-10-10 input-offset: reject non-finite and malformed MC sweep data as explicit FAIL reasons (Closes #166)
    Loom-Story: 2AMLogic/sg13g2-opamp#166
    Loom-Trace-Id: 538c4362a40bf1226ee536c19a7afd15
    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
2026-10-10 cmrr-mismatch: bind resumed campaigns to their original inputs (Closes #163)
    A fresh run of run_cmrr_mismatch_mc.sh now snapshots the DUT and publishes
    an immutable corners/<id>/campaign.manifest before the first simulation.
    The manifest covers:
    - DUT source and snapshot bytes, and the template bytes
    - joined AC/CMRR record paths and bytes
    - grid, CL, seeds, sampling knobs and validation tolerances
    - the ngspice version and a digest of the PDK model libraries
    Paths are stored repo-relative and PDK files by content only, so the
    manifest survives relocation.
    A resume re-renders the manifest and refuses (exit 3) on any difference
    before any sample, the snapshot or the pilot is touched. The re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
2026-10-10 chore: resync installed Loom surfaces
    <!-- loom:provenance v1 build=unknown 525fe43b7b1b2a0271084bba444c934a1541a8d8 clean prompts=none sweep=none story=none trace=d4059def94f46d8d158946acddd4d602 host=robb-studio base=a86a001215a846a7c01622a0daa38becaae5d0bc run=loom-run/v1:timer:robb-studio/fleet-resync:4a4d1995-968e-44c5-b5fe-804b4d477795 installs=0.19.1019 febfc4335d0554865fadbecba718245cd88c6678 -->
    Loom-Trace-Id: d4059def94f46d8d158946acddd4d602
    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
2026-10-10 docs: update work log and current backlog plan
2026-10-10 klt wrapper: reserve record destinations atomically and publish no-clobber (Closes #171)
    Loom-Story: 2AMLogic/sg13g2-opamp#171
    Loom-Trace-Id: be8c4498b954df8fa5f6a1e7433beac1
    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
2026-10-10 cmrr-mismatch: strict shared sample parser rejecting non-finite, malformed and duplicate raw samples (Closes #174)
    Loom-Story: 2AMLogic/sg13g2-opamp#174
    Loom-Trace-Id: 00315418c9c54161bf95777c0b394c4b
    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
2026-10-10 klt benches: one shared load_harness_csv_rows replacing four harness CSV loaders (Closes #181)
    Guards key parsing, rejects duplicates, checks point_id, requires finite
    floats and ends with check_grid; short/malformed rows now raise InputError
    (exit 2) in slew-rate and input-noise too. Tests added in all four benches.
    Loom-Story: 2AMLogic/sg13g2-opamp#181
    Loom-Trace-Id: b3b1516b3a656d4a6364f669c2221fb2
    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
2026-10-10 sim: bind OSDI build reuse to source and compiler provenance (Closes #182)
    Loom-Story: 2AMLogic/sg13g2-opamp#182
    Loom-Trace-Id: 3cb2429d1cf3e45823a42ee88706bb82
    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
2026-10-10 input-cmr: one raw-curve reader and shared fine hi-bound crossing in cmr_analysis.py (Closes #183)
    Move the five embedded Python bound locators out of run_cmr_sweep.sh into
    a bench-local cmr_analysis.py with one sample reader (read_samples) and
    one fine upper-bound crossing (fine_hi_crossing) used by both the fine-hi
    bound and its fixed-point verification, so the two cannot drift. Coarse
    predicates, scan directions, neighbour samples, sentinels, formatting,
    the fixed-point loop and tolerance are unchanged.
    Validated offline: old vs new output byte-identical on 1080 invocations
    over all 45 committed raw curves (recorded and perturbed thresholds, nan
    and no-crossing inputs); fine-hi/fine-lo r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
2026-10-10 input-cmr: document the discover invocation for test_cmr_analysis.py
    Loom-Story: 2AMLogic/sg13g2-opamp#183
    Loom-Trace-Id: 0e7615af46881c03ca0596c541b16988
    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
2026-10-10 chore: resync installed Loom surfaces
    <!-- loom:provenance v1 build=unknown 5d5f41d89eef35adf478b92b96af06c6d86d27a6 clean prompts=none sweep=none story=none trace=05d2a40831b35ba1c48afada00c29519 host=robb-pro base=8c4e826f4d1b34c6d12029d994878d06db050822 run=loom-run/v1:timer:robb-pro/fleet-resync:c58bb82e-a213-439d-b829-04234e141de9 installs=0.19.1029 eeede923872426614b8def90ca3cf6fd0a4ba07e -->
    Loom-Trace-Id: 05d2a40831b35ba1c48afada00c29519
    Loom-Build: unknown 5d5f41d89eef35adf478b92b96af06c6d86d27a6 clean
    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
2026-10-10 chore: resync installed Loom surfaces
    <!-- loom:provenance v1 build=unknown aa536103d6239818bb974a51d2f7f268eff38bad clean prompts=none sweep=none story=none trace=126a1328a3664e2119a0978086db9bea host=robb-studio base=e549a039216517bb72208b42bb296581e41a588e run=loom-run/v1:timer:robb-studio/fleet-resync:fbc4e361-e290-4d81-ae3a-8b5fde796815 installs=0.19.1032 13ca937a7d6ba8768c296b0c126f2ce48f5f7ca4 -->
    Loom-Trace-Id: 126a1328a3664e2119a0978086db9bea
    Loom-Build: unknown aa536103d6239818bb974a51d2f7f268eff38bad clean
    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
2026-10-11 docs: refresh Guide work plan from current backlog
2026-10-11 chore: resync installed Loom surfaces
    <!-- loom:provenance v1 build=unknown cf08873555e2eb95da295dcbee98b0dc34473381 clean prompts=none sweep=none story=none trace=67fbc483c3ca3e442d7928804c11ff06 host=robb-pro base=0f545262eaec6db00b57fba7f7399d146bd812dc run=loom-run/v1:timer:robb-pro/fleet-resync:e3f97888-2b26-404a-bd47-86fd28a4eced installs=0.19.1042 94310fa533337976dcb44acc594149f694016897 -->
    Loom-Trace-Id: 67fbc483c3ca3e442d7928804c11ff06
    Loom-Build: unknown cf08873555e2eb95da295dcbee98b0dc34473381 clean
    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
2026-10-11 chore: resync installed Loom surfaces
    <!-- loom:provenance v1 build=unknown e91831edf7b55b29d3a2d88e266916fab9ce2563 clean prompts=none sweep=none story=none trace=f72dd67520a2c3802aa0495b80ac65a5 host=robb-studio base=19f2ec71cddc4648c81b1b6d5e32dc25bf22162b run=loom-run/v1:timer:robb-studio/fleet-resync:91d2434e-eae5-45de-9305-d78c43fc7c7a installs=0.19.1043 1f414afc0388fba3ddd4b792d653b22230c33389 -->
    Loom-Trace-Id: f72dd67520a2c3802aa0495b80ac65a5
    Loom-Build: unknown e91831edf7b55b29d3a2d88e266916fab9ce2563 clean
    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
2026-10-11 ci(signoff): discover signoff tests per directory, incl. test_regenerate.py
    Loom-Story: 2AMLogic/sg13g2-opamp#180
    Loom-Trace-Id: b84e26067bd9cb942d99a3792df534ac
    Loom-Build: 0.19.1039 e83d19dc0a9b217339ea2f14040c50ad6f46700d clean
2026-10-11 characterization: bind PDK identity to finalized simulation records (#191)
    Add the env-identity sidecar contract (sim/tools/env_identity.py), capture it
    from the open-loop-ac harness and the shared klt wrapper, let the selection pin
    it, and show verified / legacy-unverified / error PDK provenance per record in
    the characterization report. Mint a new report (historical records untouched).
    Loom-Story: 2AMLogic/sg13g2-opamp#191
    Loom-Trace-Id: 6bd93edd7b90a7cd334669dfd006895e
    Loom-Build: 0.19.1050 abf3f7109328fd66ec77827f5fd849f5279fee82 clean
2026-10-11 chore: resync installed Loom surfaces
    <!-- loom:provenance v1 build=unknown 5ec729b9f7dd55a2082752611e4c4964f49661fb clean prompts=none sweep=none story=none trace=efc2abc8b72538df6d1a6ea9d329603d host=robb-pro base=e084bfdd53e0b2865b8791e92d683301652dd01b run=loom-run/v1:timer:robb-pro/fleet-resync:0d396c06-f26e-423e-97ac-6d3ac04a8e51 installs=0.19.1056 4e44d8f5faa6c6c58d2a3436ce3a983613cf375a -->
    Loom-Trace-Id: efc2abc8b72538df6d1a6ea9d329603d
    Loom-Build: unknown 5ec729b9f7dd55a2082752611e4c4964f49661fb clean
    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
2026-10-11 ci: verify schematic-to-netlist regeneration (#190)
    Loom-Story: 2AMLogic/sg13g2-opamp#190
    Loom-Trace-Id: 311c888c403b64443e185ed85d1b7a1f
    Loom-Build: 0.19.1055 4737928b703aa8a4c87d04eefbf7299fb933eab4 clean
2026-10-11 ci: fail-closed sim test directory enumeration (#195)
    Loom-Story: 2AMLogic/sg13g2-opamp#195
    Loom-Trace-Id: b2e23a801d10097ac5b410ab1a73a1ff
    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
2026-10-11 chore: resync installed Loom surfaces
    <!-- loom:provenance v1 build=unknown 745f69d0daad6c23e76cc006720fa4fbeaa3d887 clean prompts=none sweep=none story=none trace=3baabc4a039fd85029fff227a6ae690a host=robb-studio base=2323b8889f4501df7570f1280e5d0139658fbe98 run=loom-run/v1:timer:robb-studio/fleet-resync:3b3207d7-055d-49b5-a387-db375213668d installs=0.19.1061 baa2f3f2f182a6f7d9d123e188ddea5eaf5cab6a -->
    Loom-Trace-Id: 3baabc4a039fd85029fff227a6ae690a
    Loom-Build: unknown 745f69d0daad6c23e76cc006720fa4fbeaa3d887 clean
    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
2026-10-11 sim: pin output-swing integrity bounds in the envelope gate (Closes #154)
    Loom-Story: 2AMLogic/sg13g2-opamp#154
    Loom-Trace-Id: 68b216f30c5bff0d52e84fbf94be9377
    Loom-Build: 0.19.1065 33bb950d65b9038d5cf119a252820edca1192edf clean
2026-10-11 characterization: validate reported load against ratified spec and selected source (Closes #194)
    Structured load_condition per row; displayed CL derived after checking the
    ratified spec CL and the pinned record's stated CL (unit-normalized). DC rows
    make no load claim; legacy records without CL are disclosed UNVERIFIED.
    Re-minted report 20261011-153319-029e05b and re-pinned item 8.
    Loom-Story: 2AMLogic/sg13g2-opamp#194
    Loom-Trace-Id: 2c5dcdaa8178cf989856efca66170950
    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
2026-10-11 ci: gate byte-for-byte layout regeneration on the pinned PDK and klt
    Add a layout-regen job to signoff.yml that provisions the sim/pdk.json
    PDK release (via a new shared setup-sg13g2-pdk composite action, also
    adopted by netlist-regen) and runs layout/opamp_core/generate.py --check
    on every push and PR. The job installs the toolchain the committed bytes
    were produced with, in the same two-environment split layout/README.md
    records: klt at layout/klt-pin.txt (new; the v0.6.0 tag commit
    c622e8ad, reproducing the recorded plain 0.6.0) in its own venv with a
    PATH shim, and klayout==0.30.10 under the job interpreter for
    builder.py. Provisioning, generation and comparison failures all fail
    the job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
2026-10-11 characterization: audit offset MC statistics against the pinned draws (Closes #199)
    A selection record may pin the raw draws CSV behind its MC summary
    (draws_csv + draws_csv_sha256, always together). Naming draws opts the
    record into the offset_mc_statistics definition check: mean, sample sigma
    (N-1), 3-sigma, min/max over the passing draws and the worst-case total
    |vos_systematic_det_v| + 3 sigma are recomputed in draw order exactly as
    sim/input-offset/run_offset_mc.sh computes them, and each summary cell must
    be that recomputed value at the bench's printf %.9g serialization -- a
    fabricated finite statistic is an ERROR naming the point and field, never a
    publishable MEASURED row. Population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
2026-10-11 signoff: refresh integrator view after the offset-MC remint
    The reminted verdict of record (20261011-181555-264afab) was not
    propagated to the integrator view; CI's T1 register check caught the
    stale source_record/signoff_record pointers. Regenerated via
    signoff/sync_integrator.py --update; no other field changed.
    Loom-Story: 2AMLogic/sg13g2-opamp#199
    Loom-Trace-Id: f3048f355017346a25c5cb43ffdcda89
    Loom-Build: 0.19.1071 dcab8265613676d08b763cddc911b93c7ab7d9d4 clean
2026-10-11 chore: resync installed Loom surfaces
    <!-- loom:provenance v1 build=unknown b37a005ac1889262fb9e5338f7cff4e9ed4987da clean prompts=none sweep=none story=none trace=25c158d7e9591610b251780caaff1c5f host=robb-pro base=bfe60784279ae69799cd3d550b98b1f867922869 run=loom-run/v1:timer:robb-pro/fleet-resync:7f020bca-6920-47f7-a5e4-bbd5c82d9bb8 installs=0.19.1072 29b48db1ead9c4501304e0114a5c33310e1d589f -->
    Loom-Trace-Id: 25c158d7e9591610b251780caaff1c5f
    Loom-Build: unknown b37a005ac1889262fb9e5338f7cff4e9ed4987da clean
    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
2026-10-11 record-paths: exclude concurrent writers of one record with a per-record flock (Closes #204)
    Loom-Story: 2AMLogic/sg13g2-opamp#204
    Loom-Trace-Id: 070254c4cb1214c8d47136d481be4815
    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
2026-10-11 characterization: audit CMRR statistics against pinned raw sample populations
    Pin the 45 raw sample files of the selected CMRR mismatch campaign, factor the
    bench statistics into mc_samples.point_stats (shared by the runner and the
    audit), and recompute counts, linear-domain Acm mean/sigma and the DR-0004
    bound offline with the Av0 join checked against the pinned open-loop record.
    Loom-Story: 2AMLogic/sg13g2-opamp#208
    Loom-Trace-Id: 61394e6258dccaa1761c96b983996da4
    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
2026-10-11 characterization: mint report with CMRR sample audit; refresh item 8 pins and signoff record
    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
2026-10-11 spec: resync integrator view with newest signoff record
    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
2026-10-11 chore: resync installed Loom surfaces
    <!-- loom:provenance v1 build=unknown 81a6b4499cb57b3620785bc1625c300da34f0735 clean prompts=none sweep=none story=none trace=d08bbd290651d7bcbda8b216c0dfbcdf host=robb-studio base=32c6ed8b25806c78e1c7a01a722471a4d86d3cf4 run=loom-run/v1:timer:robb-studio/fleet-resync:71e05e3d-931c-46b4-b6d2-5f3f992c1e19 installs=0.19.1074 3f77416f918ffc23fb54dccf18d864073f99b142 -->
    Loom-Trace-Id: d08bbd290651d7bcbda8b216c0dfbcdf
    Loom-Build: unknown 81a6b4499cb57b3620785bc1625c300da34f0735 clean
    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
2026-10-11 docs: refresh completion log and current work plan
2026-10-11 characterization: audit input-noise summary against pinned raw logs and spectra (#213)
    Extract the runner's noise post-processing into sim/input-noise/noise_post.py
    (shared by run_noise_sweep.sh and the audit), pin per-point logs and spectra
    in selection.json, add definition check noise_raw_audit with independent
    integrated-log and spectrum-derived checks, and cover both with tests.
    Loom-Story: 2AMLogic/sg13g2-opamp#213
    Loom-Trace-Id: 1d9f97e7f6576f14754d618d07f2286c
    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
2026-10-11 characterization: mint report with input-noise raw audit; refresh item 8 pins
    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
2026-10-11 signoff: record re-grade and resync integrator view for the noise-audit report
    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
2026-10-11 sim: bind native input-noise records to observed model identity
    Wire sim/input-noise/run_noise_sweep.sh into the shared #209 identity
    lifecycle: capture the run-time PDK/model identity (issue #191 schema)
    before the units check -- the first solver -- and finalize it after the
    last DUT solve, before any record file is published. On persistent drift
    the run exits 4 leaving only corners/<id>/ and records/<id>.csv.raw for
    inspection; a failed begin capture exits 3 before anything simulates.
    The record's Markdown names its sidecar.
    The offline drift-lifecycle suite gains a NativeNoiseRunner fixture (fake
    model install, stub ngspice that can drift the install at the units check
    or at a DUT solve,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
2026-10-11 sim: validate live OSDI binaries against the build manifest at capture (#218)
    Loom-Story: 2AMLogic/sg13g2-opamp#218
    Loom-Trace-Id: 13d1738f653c0b4ee485476ba1483a32
    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
2026-10-11 sim: re-observe ngspice version at record finalization (#212)
    Loom-Story: 2AMLogic/sg13g2-opamp#212
    Loom-Trace-Id: eab65cdf537e07441b3947e9caa9e8ec
    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
2026-10-11 sim: admission check for cross-record AC joins before the first solver (#224)
    cmrr-psrr, input-offset and output-swing now capture their own run-time
    identity and, before any solver, validate the selected open-loop-ac source
    (default or AC_RECORD_CSV): verified identity sidecar equal to the live
    environment, byte-identical DUT snapshot, same load/common-mode, unique
    successful finite rows per grid point. Legacy sources are refused with a
    rerun diagnostic. Accepted source hashes and basis are published as
    records/<id>.ac-join.json. Offline negative controls included.
    Loom-Story: 2AMLogic/sg13g2-opamp#224
    Loom-Trace-Id: 3715dd31995fb92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
2026-10-11 sim: freeze admitted AC source bytes for all consumer lookups (#226)
    Loom-Story: 2AMLogic/sg13g2-opamp#226
    Loom-Trace-Id: 1111686138a6f1c0ebbe6e2edf66bd70
    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
2026-10-11 slew: shared slew_post module; pin transient waveforms and audit slew summary offline (#227)
    Loom-Story: 2AMLogic/sg13g2-opamp#227
    Loom-Trace-Id: 2f8be80573600c0217a641fd7c0c1c46
    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
2026-10-11 characterization: mint report with slew raw-waveform audit; refresh item 8 pins
    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
2026-10-12 swing: shared swing_post module; pin DC curves and audit swing summary offline (#230)
    Extract run_swing_sweep.sh's embedded coarse/fine estimator verbatim into
    sim/output-swing/swing_post.py (stdlib-only), add a strict wrdata parser
    (exact column count, finite samples, increasing scales, agreeing duplicate
    scale columns) and a rendered-netlist reader (supply, Vcm = VDD/2, corner
    section, sweep window, vectors, wrdata target, pass label). The runner now
    calls the module's CLI; the estimator itself is bit-for-bit unchanged
    (verified against the committed 45-point record before rewiring).
    Pin each selected output-swing point's coarse/fine curves and rendered
    netlists (sha256, 180 artifacts) in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
2026-10-12 characterization: mint report with output-swing raw-curve audit; refresh item 8 pins
    Mint the append-only characterization record with the swing_raw audit
    (45/45 points verified from the pinned coarse/fine curves and rendered
    netlists; verdicts unchanged -- the ratified span bound still FAILs
    literally at mos_ss/125C/1.08V) and refresh the downstream pins through
    the existing regeneration flow: block-manifest evidence[8] and
    pinned-inputs inputs[8] to the new report, the characterization evidence
    envelope, the item-verdict-of-record signoff report, and
    spec/integrator.json's derived source-record pointers.
    Loom-Story: 2AMLogic/sg13g2-opamp#230
    Loom-Trace-Id: 9d410a4950498e026ec67d67366603b4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
2026-10-12 chore: resync installed Loom surfaces
    <!-- loom:provenance v1 build=unknown ddfb67ccf9a5115d62dd86924613a468b9328f44 clean prompts=none sweep=none story=none trace=772605234b9d8cafd6a4049200f7425c host=robb-pro base=b315f08c244e70a0db9131165225f7a7d6f20ae9 run=loom-run/v1:timer:robb-pro/fleet-resync:1ef28ffc-0277-424f-9224-7ee6eca46377 installs=0.19.1084 5b1a67d3793386937de5ed625c09ea18fe9b59ed -->
    Loom-Trace-Id: 772605234b9d8cafd6a4049200f7425c
    Loom-Build: unknown ddfb67ccf9a5115d62dd86924613a468b9328f44 clean
    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
2026-10-12 chore: resync installed Loom surfaces
    <!-- loom:provenance v1 build=unknown be358990895362019614bd207bcbe36bc9eeff2c clean prompts=none sweep=none story=none trace=f1dc643b95859c8f26e892ddb5e2c5d7 host=robb-studio base=3f4588a817dceb92d8c777706ece5df948b600a9 run=loom-run/v1:timer:robb-studio/fleet-resync:da486ca2-3e94-4a85-abd3-88707942489a installs=0.19.1087 51ac271f990b317a52ebf27cc21f34561e1179fb -->
    Loom-Trace-Id: f1dc643b95859c8f26e892ddb5e2c5d7
    Loom-Build: unknown be358990895362019614bd207bcbe36bc9eeff2c clean
    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
2026-10-12 chore: resync installed Loom surfaces
    <!-- loom:provenance v1 build=unknown a579728c137cc11d08a48b178e0ff9aa21683e72 clean prompts=none sweep=none story=none trace=10832f2750dbcd63f6c6f301a6f4da9b host=loom-worker-2 base=937988540c86e970f2fa66ac51f7c67597585fa3 run=loom-run/v1:timer:loom-worker-2/fleet-resync:180f6d5054f0479ab3990b86ab4522a5 installs=0.19.1087 51ac271f990b317a52ebf27cc21f34561e1179fb -->
    Loom-Trace-Id: 10832f2750dbcd63f6c6f301a6f4da9b
    Loom-Build: unknown a579728c137cc11d08a48b178e0ff9aa21683e72 clean
    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
2026-10-12 chore: resync installed Loom surfaces
    <!-- loom:provenance v1 build=unknown 02ecafe7734bf5faa945ce88940589f00eca78e9 clean prompts=none sweep=none story=none trace=5f71c537126994dc4c45179122427514 host=robb-pro base=a75d8b23cb89640b181fdef840b6195b117ab1a5 run=loom-run/v1:timer:robb-pro/fleet-resync:6293e6da-8a67-45aa-b277-c9ef85ddb810 installs=0.19.1102 c27d15b77f4cde3ec9ccad2d751107eee9c55a04 -->
    Loom-Trace-Id: 5f71c537126994dc4c45179122427514
    Loom-Build: unknown 02ecafe7734bf5faa945ce88940589f00eca78e9 clean
    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
2026-10-12 chore: resync installed Loom surfaces
    <!-- loom:provenance v1 build=unknown 5918da96dcd60c9a677a195737c86ea38972d215 clean prompts=none sweep=none story=none trace=49bb7a8942d6a23bf41754ca27ff2368 host=loom-worker-2 base=079fe02051e36c94348fdaa9d1a3d950b103c2c5 run=loom-run/v1:timer:loom-worker-2/fleet-resync:2e973f04abd1447d8ee4b696c2e7d2b4 installs=0.19.1108 72427939d156341080a7006ae6fbb5ec96b2368e -->
    Loom-Trace-Id: 49bb7a8942d6a23bf41754ca27ff2368
    Loom-Build: unknown 5918da96dcd60c9a677a195737c86ea38972d215 clean
    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
2026-10-12 chore: resync installed Loom surfaces
    <!-- loom:provenance v1 build=unknown 9885e6bbba36f53328e04be83140734c6eda9f58 clean prompts=none sweep=none story=none trace=72f34c4066d6ca844a10c33035a775bd host=loom-worker-1 base=23afcab5d1bcc3001a8a9712e68e7d9c62176f2a run=loom-run/v1:timer:loom-worker-1/fleet-resync:8f5732bc51fd43379e17e0de51e86bae installs=0.19.1108 bf9dc5cd16598e7aa216803f5ee2fe07db81f318 -->
    Loom-Trace-Id: 72f34c4066d6ca844a10c33035a775bd
    Loom-Build: unknown 9885e6bbba36f53328e04be83140734c6eda9f58 clean
    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
2026-10-12 chore: resync installed Loom surfaces
    <!-- loom:provenance v1 build=unknown 01467247f32c59822968bf02d3214d9a3d613452 clean prompts=none sweep=none story=none trace=0e97e9733eef09a33959cf96e6271f40 host=robb-studio base=29fe4afb1c9f74c7e5405e4062e9d2d099eec819 run=loom-run/v1:timer:robb-studio/fleet-resync:53a4d390-3842-4216-9018-5dced9d0ea17 installs=0.19.1110 d7cfa8f43e6648732f7c50633bac9f555cb8f8dc -->
    Loom-Trace-Id: 0e97e9733eef09a33959cf96e6271f40
    Loom-Build: unknown 01467247f32c59822968bf02d3214d9a3d613452 clean
    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
2026-10-12 chore: resync installed Loom surfaces
    <!-- loom:provenance v1 build=unknown acadc2b4b0e852f2d889ac9dec616e1548705802 clean prompts=none sweep=none story=none trace=a69edb348af7f0e67b3bc77bc33b1bfc host=loom-worker-2 base=309eb089218897aee88d133f150d00de3114c4ff run=loom-run/v1:timer:loom-worker-2/fleet-resync:0923627ffda84cf69ec2486475772b10 installs=0.19.1126 7736d1276b6d01778fba3461114c858ef1bf5e2d -->
    Loom-Trace-Id: a69edb348af7f0e67b3bc77bc33b1bfc
    Loom-Build: unknown acadc2b4b0e852f2d889ac9dec616e1548705802 clean
    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
2026-10-12 chore: resync installed Loom surfaces
    <!-- loom:provenance v1 build=unknown 58679866e8cb04e9621fcec1a36fb51be175337c clean prompts=none sweep=none story=none trace=5b7e631589176005b35b0fca5ac99721 host=loom-worker-1 base=28e00f492938982692bfb2a570f77ab97c96bc8d run=loom-run/v1:timer:loom-worker-1/fleet-resync:380444d552c84b8fab57346319c63f44 installs=0.19.1127 8f87a12a5f523455804f76d4084cde60dafce8f6 -->
    Loom-Trace-Id: 5b7e631589176005b35b0fca5ac99721
    Loom-Build: unknown 58679866e8cb04e9621fcec1a36fb51be175337c clean
    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
2026-10-12 chore: resync installed Loom surfaces
    <!-- loom:provenance v1 build=unknown 8d832cc8035d4ba07872510416468da0790332cd clean prompts=none sweep=none story=none trace=09a53bf60e96fc30a753caffd1de8c92 host=robb-studio base=2d92ef53a67632e85418275c903b784b90801975 run=loom-run/v1:timer:robb-studio/fleet-resync:baf4c30c-65d9-4d4e-a740-f6a80cbb975c installs=0.19.1134 6bde81b9a2c0b5d36d10ba4cedb6a3bb0a564100 -->
    Loom-Trace-Id: 09a53bf60e96fc30a753caffd1de8c92
    Loom-Build: unknown 8d832cc8035d4ba07872510416468da0790332cd clean
    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
2026-10-12 chore: resync installed Loom surfaces
    <!-- loom:provenance v1 build=unknown aa1ed0d7d5499d2705977d971673d919dbbbaf4e clean prompts=none sweep=none story=none trace=2522608826ef5d5e4a88a9667055aeb7 host=loom-worker-2 base=c1e5654d18f97df271fb9c0641b78aa6ff130105 run=loom-run/v1:timer:loom-worker-2/fleet-resync:8f26b719c712455381744111c50e90b4 installs=0.19.1142 b91ae5d1b5204f499a1abb875a6cf5bffc1d90b1 -->
    Loom-Trace-Id: 2522608826ef5d5e4a88a9667055aeb7
    Loom-Build: unknown aa1ed0d7d5499d2705977d971673d919dbbbaf4e clean
    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
2026-10-12 chore: resync installed Loom surfaces
    <!-- loom:provenance v1 build=unknown a70d97503da52b2d8e12a12bd0cf829303808e95 clean prompts=none sweep=none story=none trace=e0715eac024f885e71456a622107e8bc host=loom-worker-3 base=0d082ffc3b5ac94549c0a2c3772a285f4535fce3 run=loom-run/v1:timer:loom-worker-3/fleet-resync:39a9339322d146b1984885e3f76b3e03 installs=0.19.1143 9c055d242927aa737afbaec54efae8b74cda7135 -->
    Loom-Trace-Id: e0715eac024f885e71456a622107e8bc
    Loom-Build: unknown a70d97503da52b2d8e12a12bd0cf829303808e95 clean
    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
2026-10-12 chore: resync installed Loom surfaces
    <!-- loom:provenance v1 build=unknown a70d97503da52b2d8e12a12bd0cf829303808e95 clean prompts=none sweep=none story=none trace=3639e0e14743a8d68463f43def8aae3d host=loom-worker-1 base=f489e277c11f992bd8ea0bfcc01d6676f37087b3 run=loom-run/v1:timer:loom-worker-1/fleet-resync:57344b73510246a28c2f4cc11f57105f installs=0.19.1143 b5a15aa842eb7dd2f2bb09d2ec8af9ed40a1601b -->
    Loom-Trace-Id: 3639e0e14743a8d68463f43def8aae3d
    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
2026-10-12 chore: resync installed Loom surfaces
    <!-- loom:provenance v1 build=unknown 8b64614d017d6ce7491c3a2ac9da51e5e2901c97 clean prompts=none sweep=none story=none trace=66044c049ba635bcd6a4797c3a77e84b host=robb-pro base=4d609cd41ed93c829b821883143cf74630bb3a83 run=loom-run/v1:timer:robb-pro/fleet-resync:68f56594-05d0-4cc0-9c07-36263359d698 installs=0.19.1144 9e4381cbbd2386393e44c7a979583252948a3998 -->
    Loom-Trace-Id: 66044c049ba635bcd6a4797c3a77e84b
    Loom-Build: unknown 8b64614d017d6ce7491c3a2ac9da51e5e2901c97 clean
    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
2026-10-13 chore: resync installed Loom surfaces
    <!-- loom:provenance v1 build=unknown e66f00108a9519331aa981da8a01c6569ca623a9 clean prompts=none sweep=none story=none trace=d3e476cf8c03d5ed37f8e146b3632190 host=robb-studio base=24e7ab289cc7b864b7e179827dd40eab3d885c77 run=loom-run/v1:timer:robb-studio/fleet-resync:1d7ace45-2daf-4c92-a752-67b11e982245 installs=0.19.1148 1448fdfa79ac2dcab7fad6b95b72697b450f2a4a -->
    Loom-Trace-Id: d3e476cf8c03d5ed37f8e146b3632190
    Loom-Build: unknown e66f00108a9519331aa981da8a01c6569ca623a9 clean
    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
2026-10-13 chore: resync installed Loom surfaces
    <!-- loom:provenance v1 build=unknown 98d08ab78cc223361354ee9947d996b1cb914b30 clean prompts=none sweep=none story=none trace=8b73addcdeaa8fbd65998649f42a8c50 host=loom-worker-2 base=eb50e97d607133595e746d3dfb040a7faf1a60ea run=loom-run/v1:timer:loom-worker-2/fleet-resync:3bfb13d52fca425f9cfced4541954cb6 installs=0.19.1148 1448fdfa79ac2dcab7fad6b95b72697b450f2a4a -->
    Loom-Trace-Id: 8b73addcdeaa8fbd65998649f42a8c50
    Loom-Build: unknown 98d08ab78cc223361354ee9947d996b1cb914b30 clean
    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
2026-10-13 chore: resync installed Loom surfaces
    <!-- loom:provenance v1 build=unknown f25b0347ec5fdc3de42d8fc49260dd336321752e clean prompts=none sweep=none story=none trace=e742e63d4b8a5ff51b1e01b5ea53b052 host=loom-worker-1 base=50841d3d86399b06aed3b555b6caf5e8c8be976c run=loom-run/v1:timer:loom-worker-1/fleet-resync:fe27a3d6e8c34531b6b3c6a0dfab58c9 installs=0.19.1148 e675394377a73ec957d90a26c1a208dd62436c74 -->
    Loom-Trace-Id: e742e63d4b8a5ff51b1e01b5ea53b052
    Loom-Build: unknown f25b0347ec5fdc3de42d8fc49260dd336321752e clean
    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
2026-10-13 chore: resync installed Loom surfaces
    <!-- loom:provenance v1 build=unknown d0bfbbc7ac309581d7abe02c4a269c7704010ee0 clean prompts=none sweep=none story=none trace=0ad6d167235000f3b5648cbd63d761ce host=robb-pro base=daa2bf70db77b558c23b5ffed3dfdbae3c622c99 run=loom-run/v1:timer:robb-pro/fleet-resync:4f7cbe22-40b6-49ff-8811-003ae8577c28 installs=0.19.1151 021b947d121929157cd83df0576e7f2aa12500d7 -->
    Loom-Trace-Id: 0ad6d167235000f3b5648cbd63d761ce
    Loom-Build: unknown d0bfbbc7ac309581d7abe02c4a269c7704010ee0 clean
    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
2026-10-13 chore: resync installed Loom surfaces
    <!-- loom:provenance v1 build=unknown 7916c4043a1b57e97a53bc5c111e74c5038a1091 clean prompts=none sweep=none story=none trace=20b27ffb08c4130dc9836ee8d9d97b97 host=loom-worker-2 base=5a14a43e074e79e9f7d10709818f2f5f7e18c688 run=loom-run/v1:timer:loom-worker-2/fleet-resync:d34532ec625a4162ae8b58dde1a6738f installs=0.19.1151 f7d1deaab02a9c483fce1ced33fadb1af6d86f59 -->
    Loom-Trace-Id: 20b27ffb08c4130dc9836ee8d9d97b97
    Loom-Build: unknown 7916c4043a1b57e97a53bc5c111e74c5038a1091 clean
    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
2026-10-13 chore: resync installed Loom surfaces
    <!-- loom:provenance v1 build=unknown ac0bbcf6eda99918e88a0b8893d9762b106a2e45 clean prompts=none sweep=none story=none trace=8597ab8a51d68f9f8ee864fa71904bff host=robb-studio base=801b428f4b8a9ffaf97652be3e596f251df72da4 run=loom-run/v1:timer:robb-studio/fleet-resync:2ea9dd71-a6b2-4d0c-86aa-859a0728c9b3 installs=0.19.1151 f7d1deaab02a9c483fce1ced33fadb1af6d86f59 -->
    Loom-Trace-Id: 8597ab8a51d68f9f8ee864fa71904bff
    Loom-Build: unknown ac0bbcf6eda99918e88a0b8893d9762b106a2e45 clean
    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
2026-10-13 chore: resync installed Loom surfaces
    <!-- loom:provenance v1 build=unknown 7916c4043a1b57e97a53bc5c111e74c5038a1091 clean prompts=none sweep=none story=none trace=773e9e41a5730d2f79f2381ad2cde068 host=robb-pro base=4f320b9421d3c6c37342f79bac96dac1aa893ef4 run=loom-run/v1:timer:robb-pro/fleet-resync:b7ca0d34-434e-4536-85b9-57adfa603a8d installs=0.19.1151 1ec34f9bb79942506958a3c18a31368f4e065508 -->
    Loom-Trace-Id: 773e9e41a5730d2f79f2381ad2cde068
    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
2026-10-13 chore: resync installed Loom surfaces
    <!-- loom:provenance v1 build=unknown f57244868aa20ef22c18aa8025972184aaea43e4 clean prompts=none sweep=none story=none trace=8e03b78fe6cb43a017c4a4823362ffa7 host=loom-worker-2 base=d0f87ffb19506947248bcd1199ed1cc475437c5a run=loom-run/v1:timer:loom-worker-2/fleet-resync:eb553d2fc2a54589aa37879f12b18ed5 installs=0.19.1151 a9d9bfc13e966655d6d847cb6876af523bc4a4c4 -->
    Loom-Trace-Id: 8e03b78fe6cb43a017c4a4823362ffa7
    Loom-Build: unknown f57244868aa20ef22c18aa8025972184aaea43e4 clean
    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
2026-10-13 chore: resync installed Loom surfaces
    <!-- loom:provenance v1 build=unknown 9cd23bf22bf48ed3837f643ea76ec2e5f01ae46a clean prompts=none sweep=none story=none trace=ab3a71ce89f6ba9ad4c2753c3377bcf1 host=loom-worker-1 base=a5fb496e637f27dcaead081d65ed5d59499d4618 run=loom-run/v1:timer:loom-worker-1/fleet-resync:79a3b089c6f54c91bd32db3274e8133c installs=0.19.1151 a9d9bfc13e966655d6d847cb6876af523bc4a4c4 -->
    Loom-Trace-Id: ab3a71ce89f6ba9ad4c2753c3377bcf1
    Loom-Build: unknown 9cd23bf22bf48ed3837f643ea76ec2e5f01ae46a clean
    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
2026-10-13 sim: open-loop AC bench as klt sim AC + OP requests with a harness comparison
    Add sim/open-loop-ac/klt/: a klt sim circuit body equal to the harness
    template, an AC request (Av0, GBW, phase at the 0 dB crossing) and an OP
    request (total Iq plus the per-point DC sanity checks) over the ratified
    45-point grid with the ratified DR-2 bounds as limits, a runner that gates
    each envelope before writing it append-only to klt/records/, and an offline
    comparison (with negative-control tests) against the committed harness
    record, joined on (process, temperature, VDD) with stated tolerances and a
    per-corner correction for ngspice's linear-frequency GBW interpolation.
    Document the two paths and the per-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
2026-10-13 sim: make the PM limit fail safe against vp() phase wrap
    vp(out) is wrapped to (-pi, pi] while the harness's PM uses continuous
    phase, so `phase_at_ugf_rad >= -2pi/3` alone passed a wrapped unstable
    corner (PM -10 deg reads +170 deg). Add `max: 0` to the limit: the phase
    at the UGF is negative for this non-inverting bench, so a positive reading
    can only be a wrap. The tool verdict now equals PM >= 60 deg for PM in
    (-180, 180] deg. README and request comment drop the "exactly" claim and
    state the valid range and the residual straddle case near PM ~ 0 deg,
    which the harness comparison catches.
    Tests: pin the request's ratified limits (two-sided phase), sweep the
    wrapped verdict across PM, and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
2026-10-13 chore: resync installed Loom surfaces
    <!-- loom:provenance v1 build=unknown 6fe43c87955e02019c2bc8dfad4fbd160b89170c clean prompts=none sweep=none story=none trace=49a4590bf54e81899c26d965f682504c host=robb-studio base=b3fefae127fff50792bae90e88c0d006dcae76e1 run=loom-run/v1:timer:robb-studio/fleet-resync:459197b3-0050-4335-893e-e47b638eb819 installs=0.19.1151 4bba3857a22eb3081c693ff4c5953e9ffb74072b -->
    Loom-Trace-Id: 49a4590bf54e81899c26d965f682504c
    Loom-Build: unknown 6fe43c87955e02019c2bc8dfad4fbd160b89170c clean
    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
2026-10-13 chore: resync installed Loom surfaces
    <!-- loom:provenance v1 build=unknown 27a266d5a27885323290840d2a837d73fcf4bcc6 clean prompts=none sweep=none story=none trace=e77cdd5477ef6bfc65fba6cc233788e0 host=loom-worker-2 base=e023c3c45b13aecc48e1131a395144e22c1a98a0 run=loom-run/v1:timer:loom-worker-2/fleet-resync:7fac7d82f298441a91761382ac989183 installs=0.19.1152 a7c20e591a04d4acaeeca29fadd7fa4be7ca3122 -->
    Loom-Trace-Id: e77cdd5477ef6bfc65fba6cc233788e0
    Loom-Build: unknown 27a266d5a27885323290840d2a837d73fcf4bcc6 clean
    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
2026-10-13 chore: resync installed Loom surfaces
    <!-- loom:provenance v1 build=unknown f2b62a2cf576d7d37092147b2281da809f8b5cf5 clean prompts=none sweep=none story=none trace=8adfa75521c72dded43e2932febb6329 host=loom-worker-3 base=d5906d0fe32c0d1dfea13e72e203b8dcdfdc6550 run=loom-run/v1:timer:loom-worker-3/fleet-resync:8a8198f8f80e4703bc7365a5e10595e0 installs=0.19.1152 6136698172e16b355f948076c177fc4e4a85cd1e -->
    Loom-Trace-Id: 8adfa75521c72dded43e2932febb6329
    Loom-Build: unknown f2b62a2cf576d7d37092147b2281da809f8b5cf5 clean
    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
2026-10-14 chore: resync installed Loom surfaces
    <!-- loom:provenance v1 build=unknown 84d11f248d368cae5e04a2255f6897a406c50089 clean prompts=none sweep=none story=none trace=8e50b4ccc3dc58f709a732f69d58fd44 host=robb-studio base=d0dc8bcd106ae4f36081b7f0fca4da2acf5a9d58 run=loom-run/v1:timer:robb-studio/fleet-resync:05c9f3b1-eee2-412f-8996-5fbf02793d9e installs=0.19.1153 d8429a4fabdc955107af1cbc22c548e23eecf9b1 -->
    Loom-Trace-Id: 8e50b4ccc3dc58f709a732f69d58fd44
    Loom-Build: unknown 84d11f248d368cae5e04a2255f6897a406c50089 clean
    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
2026-10-15 sim: real 45-corner input-noise klt envelope and measured harness comparison (#96)
    Fleet job klt-sim-97d94b85943b, klt 0.7.0 client+runner. 44/45 pass; mos_fs/125C/1.08V
    misses the 108.9 uVrms bound (108.949), matching the harness. Tolerance re-justified
    from measurement (2e-5 rel; max delta 4.7e-6). Manifest unchanged.
    Loom-Build: 0.19.1161 3187e328c5e0c0ef3342a3c303d4948852cfa665 clean
    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
2026-10-15 feat(signoff): run 45-corner post-layout pex, cite T1 item 7 (#86)
    Ran layout/opamp_core/run_pex.sh on the batch fleet: 180 delta rows, all pass
    against spec Sec 2 bounds. Fix klt sim outdir_locked in the measure script.
    Add item 7 to manifest/pins, mint signoff record, discharge README note.
    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
2026-10-15 signoff: do not cite T1 item 7; pex legs are not comparable (#86)
    The 45-corner pex report compares the lumped ng=1 simulation-form
    schematic against the drawn unit/finger devices (plus dummy columns).
    Active device widths match the schematic exactly; the excess extracted
    width is dummies. Per-device geometry differs, though, so the large
    gain/GBW/Iq deltas cannot be attributed to parasitics.
    - Revert item 7 in block-manifest.json and pinned-inputs.json.
    - Drop the unmerged signoff record 20261015-062511-80878d7 (it graded
    item 7 met); the newest record stays 20261012-003544-e721143, so
    spec/integrator.json is already in step.
    - Keep pex_report.json and opamp_core_pex.spice as uncited e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
2026-10-15 ci: re-run append-only gate on a clean push base (#86)
    The push-event append-only gate on 4951d1e compared against the branch's
    previous tip (882121b) and flagged the deliberate removal of the
    never-merged signoff record 20261015-062511-80878d7. The pull_request
    run of the same commit, which compares against main, passed. This empty
    commit gives the push-event gate a base that already lacks the record.
    Nothing on main is removed.
    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
2026-10-15 sim: commit the real 45-corner slew-rate klt sim envelope (T1 item 5, closes #95)
    The batch fleet runner now pins klt 0.7.0 (2AMLogic/2am#2193), so the
    request submitted with a matching 0.7.0 client (job klt-sim-9649fa050398):
    45 unique points, status pass, nothing skipped, and the comparison against
    the harness record agrees at every point. Binding corner mos_ss/-40C/1.08V:
    rising 7.5378, falling 7.5144 V/us vs >= 7.51 (falling margin 0.0044).
    The first fleet attempt (job klt-sim-135fd62274ef) timed out all 45 corners
    at 300 s although one corner takes ~2.4 s locally: ngspice OpenMP thread
    oversubscription on the fleet instance (2AMLogic/klayout-tools#2970). The
    bench body now sets num_thr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
2026-10-15 sim: input-offset (systematic) klt sim request, comparator and real 45-corner envelope (T1 item 5, closes #97)
    Open-loop null-sweep method (the harness record's vos_null_v). Fleet job
    klt-sim-38b6e4833c62 (runner and client klt 0.7.0): 45 unique points; one
    recorded bound miss, mos_fs/125C/1.08V = +21.927 mV vs <= 21.9 mV (same
    point and value as the harness; follow-up #239). Comparison with the harness
    record agrees at all 45 points (largest Vos delta 0.58 nV).
    Submitted with klt sim directly: this host's run.sh preflight cannot pass
    (ngspice-42, no OSDI build), so no .env.json sidecar. No grid run locally.
    Manifest unchanged. signoff/README.md coverage table updated.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
2026-10-15 sim: add the issue-#237 device-representation probe (lumped vs drawn vs extracted)
    Loom-Story: 2AMLogic/sg13g2-opamp#237
    Loom-Trace-Id: be7adfb1e42f43343ce409a164a73d9f
    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
2026-10-15 sim: fingering probe -- build step needs the klayout module (no -I)
    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
2026-10-15 sim: fingering probe record 20261015-081352-9a66a66 + inn AC-ground diagnostic set
    Base probe (5 corners, batch fleet): lumped -> drawn fingering carries the
    whole Iq delta (-24.9..-26.7 %) and +7.6..+7.9 % Av0; expansion and
    extracted diffusion geometry move nothing (<0.3 %). The residual
    extracted_nopar -> extracted step (GBW +17.8..+21.8 %, Av0 -2.9..+9.8 %,
    Iq -0.01 %) is far too large for the fF/ohm-scale parasitics; the innac set
    tests whether it is coupling into the bench's AC-floating inn node.
    Loom-Build: 0.19.1161 3187e328c5e0c0ef3342a3c303d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
2026-10-15 sim: fingering probe innac record 20261015-083637-cefcca1; DR 0008 (option 1: schematic carries drawn fingering)
    Probe with inn AC-grounded: the parasitics step collapses to Av0 0.00 %,
    GBW -0.4 %, PM -0.8 %; the base record's +18..22 % GBW residual is the
    open-loop bench's AC-floating inn (filed #241). DR 0008 chooses option 1
    and stages the netlist change with the pre-layout re-runs (the
    characterization gate rejects records on a different netlist). The
    discarded partial innac run (20261015-082802-48d070c) was never committed.
    Part of #237.
    Loom-Bu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
2026-10-15 sim: AC-ground inn with 1 F in the open-loop AC and PSRR benches; add klt record runner
    Lbreak alone left inn AC-floating. Add Cinn_acgnd inn vss 1 to the template and
    klt body forms of both benches, and a batch-fleet runner for the open-loop AC record.
    Loom-Story: 2AMLogic/sg13g2-opamp#241
    Loom-Trace-Id: 0810ff897ed88d26877a5d1362c94971
    Loom-Build: 0.19.1162 f1ee755eeca1954f35bf83d19f4b84ad51feb9f5 clean
2026-10-15 sim: record the inn-AC-grounded open-loop AC run (45 corners, batch) and point the PSRR join at it
    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
2026-10-15 sim: PSRR record on the inn-AC-grounded bench, README notes marking floating-inn evidence superseded
    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
2026-10-15 test: pin the superseded-record shard regeneration check to its committed body
    The live tb_psrr.body.spice gained Cinn_acgnd (issue #241), so every
    regenerated body_sha256 moved while the append-only record stayed put. Compare
    requests and keys exactly, and assert the live body differs from the record's
    committed body only by the Cinn_acgnd lines.
    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
2026-10-16 sim: commit the first 45-corner klt sim envelopes for the open-loop AC bench
    Run sim/open-loop-ac/klt/run.sh on the batch fleet and commit the AC and
    OP envelopes plus their comparison. Put the klt bench on the grounded-inn
    form (Cinn_acgnd) so it matches the current baseline, compare against
    records/20261015-103057-895d555.csv, let compare.py take a baseline with
    only the four ratified rows and no raw sweeps, and skip the local
    ngspice/OSDI preflight when the backend is batch. Record per-row coverage
    in signoff/README.md; the manifest is unchanged.
    Closes #85 (item 5 itself stays uncited in the manifest).
2026-10-16 sim: join PSRR Av0 from the open-loop klt sim envelope
    compare.py takes --openloop-envelope as the same-point Av0 source (gated
    like any envelope, fail closed) and, beside --openloop-csv, reports the
    per-point envelope-joined vs CSV-joined PSRR. New compare record over the
    committed grounded-inn envelopes: max |delta| 4.95e-5 dB, 45 of 45 within
    0.02 dB. run.sh defaults to the envelope; READMEs updated.
    Part of #99
2026-10-17 refactor: share raw-artifact pin validation and read loop across characterization families
2026-10-17 docs: plan four-row design margin and record literal-limit direction (DR-0009)
    Adds design/margin-plan.md (binding corners, coupling table, prospective
    validation plan, #239 offset stub) and DR-0009 (operator ruling, PR #27
    provenance search left unresolved, DC-gain FAIL traced to a superseded
    record). No limit, grade, spec, signoff or sim file is edited.
    Part of #101
2026-10-17 docs(signoff): state item 5's cited envelopes and declared gaps; pin test for item 5 list form
2026-10-18 refactor: hold PVT temperature/supply axes and CL once in sim/preflight.sh
    Nine sweep runners hand-copied TEMPS, VDDS and CL_F; define them once next to
    SG13G2_MOS_CORNERS and have each runner copy from the shared arrays, keeping
    local names so loops and template rendering are unchanged.
    Closes #281
2026-10-20 characterization: select the corrected open-loop AC record behind a raw klt-envelope audit
    Move the four open-loop rows (DC gain, GBW, phase margin, Iq) from the
    inn-floating record to the corrected inn-AC-grounded record, which carries
    no op_pass / gm_status columns. Validation is not weakened: a new definition
    check, open_loop_klt_audit, recomputes the four graded cells from the
    sha256-pinned AC/OP envelopes, checks both envelopes for a clean 45-corner
    pass with one engine, model deck and DUT snapshot, checks the pinned bench
    body (one stated CL, inn AC-grounded, 10 uA ibias reference), and recomputes
    the output-centering and rail checks from the raw OP values. The legacy
    internal-node che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
2026-10-22 ci: share one fail-closed offline test runner and wire it into pnpm test
    Replace the two copied discovery loops (signoff.yml, signoff/README.md)
    with sim/tools/run-offline-tests.sh, drop the hand-listed sim/tools steps
    that ran twice, and point package.json test/check:ci/check:all at real
    checks instead of exit-0 stubs.
    Closes #294
2026-10-23 feat: store new run output in the artifact store, keep manifests in git
    Adds a fail-closed writer around klt artifact put, an offline manifest
    checker (schema, artifact: URIs, no storage location, bytes not also in
    git), CI/pnpm wiring, docs, and one real demonstration manifest.
2026-10-27 chore: pin signoff grading to klt 0.8.0 and assert the version in CI
    signoff/klt-pin.txt moves to the v0.8.0 tag commit (a git build there
    reports `klt 0.8.0`). The signoff CI install step now fails unless
    `klt --version` prints `klt 0.8.0`. layout/klt-pin.txt is held at v0.6.0
    with the reason recorded (0.8.0 changes the curated deck; split to #312).
    ENVELOPE_KLT_VERSION stays 0.6.0 as a provenance stamp, now commented.
    Part of #311
2026-10-28 docs: point cmrr-psrr shard-mode client at klayout-tools 0.8.0
    The fleet runner now runs klt 0.8.0 and gates on major.minor, so the
    proven-route client instruction drops the stale 0.6.0 pin and the
    '0.7.0 client is refused' claim. The 0.7.0 provenance line for the
    committed direct run is annotated as since moved.
2026-10-28 docs: make cmrr-psrr shard-bridge klt 0.5.0 pin statement historical
    Closes #317
2026-11-01 sim: 45-point output-swing klt envelope on the batch fleet, with harness comparison
    Adds swing.request.json and a 'run.sh grid' mode (batch only, --attach support),
    commits the unmodified fleet envelope (job klt-sim-567c2d463d1a), its harness
    comparison and identity sidecar, and updates the output-swing and signoff
    READMEs. The span miss (0.570960 V at mos_ss/125C/1.08V) stays a recorded FAIL.
    Part of #100
2026-11-11 fix(sim): verify recorded ngspice against a major-version floor, not an exact pin
    Adds osdi_toolchain.ngspice_min_major to sim/pdk.json; env_identity verify()
    accepts any observed ngspice-NN with NN >= floor, falling back to the exact
    comparison when the pin has no floor.
2026-11-14 signoff: mint the re-graded record and retire the item 5 swing gap text
    `bash signoff/regenerate.sh` at the pinned klt revision
    (`c572046`, klt 0.8.0.dev2612) over the re-cited manifest, appended as
    `signoff/reports/20261114-043348-88c7f6d.signoff.json`. No earlier record is
    edited.
    Item 5 stays `unmet` / `check_failed` and the register still marks 7 of 11 T1
    items met: the span miss at `mos_ss`/125 C/1.08 V is recorded, not relaxed,
    and `cmrr_mismatch` is still a declared gap. Across all eleven items no
    verdict moved. What changed inside item 5 is the evidence it rests on --
    seven cited envelopes instead of six, `declared_gaps` down from four rows to
    `cmrr_mismatch` alone, `uncovered_rows`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
